BohnChen/PickOrangeDummy/docs/architecture_diagrams.md

# PickOrangeDummy · 架构图册

> 配套文档：[`architecture_v2.md`](architecture_v2.md)
> 生成：2026-10-30　｜　图源为 Mermaid，GitHub 直接渲染；`.mmd` 源文件在 [`diagrams/`](diagrams/)
>
> 阅读顺序建议：图 1（全景）→ 图 2（进程）→ 图 3（通信）→ 图 4（TF）→
> 图 5/6（任务）→ 图 7（停车）→ 图 8（安全）→ 图 9（语音）→ 图 10（几何）→ 图 11（里程碑）

---

## 图 1 · 系统分层全景

一句话：**指令向下、状态向上；只允许上层依赖下层。**

```mermaid
graph TB
    L4["L4　交互 / 监督<br/>voice_cmd · safety_supervisor · 人工确认"]
    L3["L3　任务编排<br/>mission：10 Hz tick · 转移表 · 状态守卫"]
    L2["L2　能力层（全部 Action）<br/>arm_move · cutter · chassis_creep · speak"]
    L1["L1　抽象层（设备与硬件抽象）<br/>ros2_control · chassis_node · astra_guard · target_detector"]
    L0["L0　实时层（MCU 固件，永不进 ROS）<br/>STM32H5 三路 PWM + 300 ms 租约 · STM32F405 六轴 + 硬限位"]

    L4 ==>|"指令请求"| L3
    L3 ==>|"下发 Action"| L2
    L2 ==>|"驱动"| L1
    L1 ==>|"串口 / RPC"| L0

    classDef l4 fill:#e8f0fe,stroke:#4a6fa5,stroke-width:2px
    classDef l3 fill:#e6f4ea,stroke:#4a8f5f,stroke-width:2px
    classDef l2 fill:#fef7e0,stroke:#b08a3e,stroke-width:2px
    classDef l1 fill:#f3e8fd,stroke:#7a5aa8,stroke-width:2px
    classDef l0 fill:#fce8e6,stroke:#a5524a,stroke-width:2px
    class L4 l4
    class L3 l3
    class L2 l2
    class L1 l1
    class L0 l0
```

**要点**

- 实线是**指令向下**：每一层只调用下一层的接口，不知道下下层存在。
- **状态向上走但不构成依赖**：`targets` / `hazards` / `robot_state` 从 L1 流到 L3，
  `safety_supervisor` 对 L3 有全局否决权（图 3、图 8）。
- L3 只是"决定下一步做什么"，它**不认识串口、相机、MoveIt**。
- 每次跨层都是 Action（有 goal / feedback / result / cancel / 超时），不是"发一条 topic 然后猜"。

> 各层内部构件、进程、话题、TF 关系分别见图 2、图 3、图 4。

---

## 图 2 · 运行时进程与 CPU 拓扑

一句话：**会动的各占一个进程；控制钉 A78C，视觉语音钉 A55。**

```mermaid
graph LR
    subgraph A78["CPU 0–3 · Cortex-A78C · 控制与通信"]
        RC["ros2_control_node<br/>20–50 Hz"]
        CH["chassis_node<br/>20 Hz 心跳线程"]
        SS["safety_supervisor<br/>50 Hz"]
        MI["mission<br/>10 Hz"]
    end

    subgraph A55["CPU 4–7 · Cortex-A55 · 重负载"]
        TD["target_detector<br/>15–30 Hz"]
        AG["astra_guard<br/>30 Hz"]
        VO["voice_io<br/>常开 KWS"]
    end

    subgraph MCU["MCU 侧"]
        H5["STM32H5<br/>三路 PWM + 300 ms 租约"]
        REF["STM32F405<br/>关节伺服"]
    end

    RTR["arduino-router<br/>独占 /dev/ttySTM0"]

    CH -- "msgpack-RPC" --> RTR
    RTR -- "串行" --> H5
    RC -- "USB-CDC 115200" --> REF
    MI -- "Action" --> RC
    MI -- "Action" --> CH
    TD -- "targets" --> MI
    AG -- "hazards" --> MI
    VO -- "指令" --> MI
    SS -. "取消 + 制动" .-> CH
```

**要点**

- `chassis_node` 的心跳线程**独立于 ROS 回调**，executor 卡住也能继续喂狗或主动刹车。
- `arduino-router` 是系统服务，不是我们写的节点；它独占底盘串口（见 §6.5）。
- 任一进程崩溃，其下游看门狗在 500 ms 内接管。

---

## 图 3 · 通信拓扑（话题 / 动作 / 服务）

一句话：**每个执行器只有一个写者。**

```mermaid
graph LR
    subgraph 感知
        AG["astra_guard"]
        TD["target_detector"]
    end

    subgraph 决策
        MI["mission"]
        SS["safety_supervisor"]
        VO["voice_io"]
    end

    subgraph 执行
        CH["chassis_node"]
        RC["ros2_control_node"]
        CT["cutter（硬件插件内）"]
    end

    AG -- "/perception/hazards" --> MI
    TD -- "/perception/targets" --> MI

    MI -- "/cmd_vel" --> CH
    MI -- "Action /arm/move_to_pose" --> RC
    MI -- "Action /cutter/cut" --> CT
    MI -- "Action /voice/speak" --> VO
    VO -- "Service /mission/approve_cut" --> MI
    VO -- "Service /safety/estop" --> SS

    SS -- "取消全部 goal + brake" --> CH
    SS -- "取消全部 goal + !STOP" --> RC
    MI -- "/robot_state" --> VO
    MI -- "/robot_state" --> SS
```

**要点**

- `chassis_node` 是 `/cmd_vel` 的**唯一**订阅者与底盘串口的**唯一**写者。
- `ros2_control` 是六轴的唯一写者；`/cutter/cut` 在硬件插件内部实现，**不再另开串口**。

---

## 图 4 · TF 树

一句话：**`base_link` 保持=机械臂基座（现有 MoveIt 配置零改动）。**

```mermaid
graph TD
    ODOM["odom<br/>占位：单位静态变换"]
    BF["base_footprint<br/>后轴中心地面投影"]
    CL["chassis_link<br/>车体"]
    BL["base_link<br/>机械臂基座法兰 · J1 轴线"]
    A1["astra_link<br/>立杆顶 · 离地约 310 mm"]
    A1D["astra_depth_optical_frame"]
    D1["d435i_link<br/>Astra 下方约 15 mm"]
    D1C["camera_color_<br/>optical_frame<br/>yaw ≈ +100°"]
    T["tool0 / tcp<br/>末端执行器"]

    ODOM --> BF
    BF --> CL
    BF --> BL
    BF --> A1
    BF --> D1
    A1 --> A1D
    D1 --> D1C
    BL --> T
```

**要点**

- `odom → base_footprint` 现在是假的（无编码器），但**预留了位置**：将来加编码器或 VIO，下游一行不改。
- 所有静态参数放 `pickorange_bringup/config/transforms.yaml`，**不写死在 launch 里**。
- 旧的手眼外参（`cam_x=-0.1959 …`）**整体作废**，必须重标。

---

## 图 5 · 采摘任务状态机

一句话：**10 Hz tick 驱动，状态 × 事件 → 下一状态，跳步由守卫拒绝。**

```mermaid
stateDiagram-v2
    direction LR
    [*] --> BOOT
    BOOT --> IDLE : 臂在 REST ∧ 已 enable
    IDLE --> CRUISE : mission/start
    CRUISE --> SLOW : 目标接近窗口
    CRUISE --> FAULT : hazards 建议 STOP
    SLOW --> STOP : 已停稳 500 ms
    STOP --> PICK : 臂在 REST
    PICK --> PICK : 队列非空
    PICK --> RESUME : 队列空
    RESUME --> CRUISE : 臂确认在 REST
    PICK --> FAULT : 超时 / 不可达 / 失败超限
    FAULT --> IDLE : safety/reset + enable
    ESTOP --> IDLE : reset + enable

    note right of ESTOP
        任意状态均可进入
        /safety/estop 或语音「停止」
    end note
```

**PICK 内部子状态（线性，同样显式）**

```mermaid
stateDiagram-v2
    [*] --> PRE_APPROACH
    PRE_APPROACH --> INSERT : 到达 Pre-Grasp
    INSERT --> HOLD : 套筒到位
    HOLD --> CUT : approve_cut / 语音「剪切」
    HOLD --> RETREAT : 30 s 超时
    CUT --> RETREAT : 刀片已张开且确认
    CUT --> CUT : 未切断 ∧ 重试 < 2
    RETREAT --> [*]
```

**要点**

- `HOLD` 是唯一等人工的稳定态，且**必须可超时**（30 s 无确认自动退刀）。
- `RETREAT` 的前提是 `final_angle == home`（刀片已张开），否则会扯断枝条。

---

## 图 6 · 一次连续采摘的时序

一句话：**一次停车采完队列里的所有目标，中途可被语音打断。**

```mermaid
sequenceDiagram
    autonumber
    participant O as 操作员 / 语音
    participant MI as mission
    participant CH as chassis_node
    participant AR as arm (MoveIt)
    participant CT as cutter
    participant VO as voice_io

    MI->>CH: /cmd_vel 巡航
    Note over MI: target_detector 报目标<br/>x ≈ +0.33 m（相对臂底座）
    MI->>CH: brake（发现即停）
    loop creep 逼近
        MI->>CH: Action /chassis/creep +30 mm
        CH-->>MI: traveled_m
        Note over MI: 重测 x（相对臂底座）
    end

    loop 队列中的每个目标
        MI->>AR: Action /arm/move_to_pose (Pre-Grasp)
        AR-->>MI: success
        MI->>AR: Action /arm/move_to_pose (INSERT)
        AR-->>MI: success
        MI->>VO: speak「套住完成，等待剪切指令」
        O->>MI: Service /mission/approve_cut
        MI->>CT: Action /cutter/cut(span=-60, dwell=0.5)
        CT-->>MI: feedback current_angle
        CT-->>MI: result success, final_angle=home
        MI->>AR: Action /arm/move_to_pose (RETREAT)
        AR-->>MI: success
    end

    MI->>AR: 回 REST
    MI->>CH: 解除刹车，继续巡航
```

**要点**

- 停车分两段：**发现即停**（宁可停早）+ **creep 闭环逼近**（每步 3 cm，每步重测）。
- 剪切是原子操作：合刀 → 保压 → **张刀** → 确认到位。
- 队列非空时**不回 REST**，直接从退刀位去下一个 Pre-Grasp。

---

## 图 7 · 停车逼近控制流

一句话：**停早了可以蠕进，开过了要倒车——所以策略偏向早停。**

```mermaid
graph LR
    A["DETECT<br/>D435i 首次捕获目标"] --> B["STOP<br/>0 油门 + 中位"]
    B --> C{"x 在窗口内？<br/>[-0.08, +0.08]"}
    C -- "是" --> D["稳定 500 ms<br/>→ PICK"]
    C -- "否" --> E["CREEP +30 mm<br/>油门 ≥ 最小有效值"]
    E --> F["等 300 ms · 重测"]
    F --> C
    C -- "跳变 > 100 mm" --> B
    C -- "超过 8 次仍不可达" --> G["跳过该目标<br/>黑名单 30 s"]
```

**要点**

- 每步 3 cm，**误差不会累积超过一步**，天然免疫"没有里程计"。
- 每步都用视觉重新测量 ⇒ `throttle→v` 标定不准也无所谓。
- **油门有最小值**：实测 15% 车不动、30% 才起步。所以 creep 只能"走一小段再停"，
  不能用极低油门"慢慢挪"——那会变成发着指令不走，最后超时。
- "跳过"是一等公民：卡在一个摘不到的果子上是这类系统最常见的死锁。

---

## 图 8 · 安全与心跳链

一句话：**四重冗余，任何一层崩了车都会停。**

```mermaid
graph TD
    subgraph 软件
        VO["voice_io"]
        MI["mission"]
        CT["cutter"]
        SS["safety_supervisor"]
    end
    subgraph 硬件
        CH["chassis_node"]
        H5["STM32H5<br/>租约 300 ms → 硬停"]
        LATCH["固件锁存 estop<br/>必须 arm() 才解除"]
        REF["STM32F405<br/>!STOP 保持力矩"]
        MOT["底盘电机 / 六轴电机"]
    end

    VO -- "心跳" --> SS
    MI -- "心跳" --> SS
    CT -- "心跳" --> SS
    SS -- "心跳 + 否决" --> CH
    CH -- "20 Hz drive（续租约）" --> H5
    H5 -- "3 路 PWM" --> MOT
    SS -. "estop()" .-> LATCH
    LATCH -. "拒绝一切运动指令" .-> H5
    REF -- "限位 / 失能" --> MOT
    SS -. "取消 goal" .-> REF

    SW["物理急停 / SW1<br/>（唯一对硬件故障有效）"] -. "断底盘动力" .-> MOT
    SW2["⚠ 断整车电 = 臂失力下坠"] -.-> MOT
```

**要点**

- `/safety/estop` 的语义是 **"底盘锁存停车 + 机械臂 `!STOP` 保持力矩"**，**绝不失能、绝不切电**。
- **锁存在固件里**：即使控制程序崩溃前正在 20 Hz 猛发 `drive()`，每条指令也会返回 `false`。
- **软件链只覆盖软件故障。** 档位信号浮空/越界可能让车继续前进，这只能靠物理急停。
- 物理断电仍须先把机械臂收回 REST。

---

## 图 9 · 语音指令通路

一句话：**语音只能触发"能力层已有 + 安全层放行"的动作，且移动必须是有限步进。**

```mermaid
graph LR
    MIC["USB 声卡<br/>麦克风"] --> KWS["sherpa-onnx KWS<br/>常开 · <100 ms"]
    KWS --> GATE{"指令闸门<br/>当前状态允许？"}
    GATE -- "拒绝" --> FB1["语音反馈<br/>「当前不可执行」"]
    GATE -- "剪切" --> AP["/mission/approve_cut"]
    GATE -- "进刀 / 退刀" --> ARM["/arm 笛卡尔 ±25 mm"]
    GATE -- "前进 / 后退" --> CREEP["/chassis/creep ±0.2 m<br/>有限步进 + 超时"]
    GATE -- "停止" --> ES["/safety/estop"]
    GATE -- "暂停 / 继续" --> MS["/mission/pause / resume"]

    TTS["预生成 WAV<br/>15 句固定反馈"] --> SPK["USB 声卡<br/>扬声器"]
    SPK -. "半双工：播放时停 ASR" .-> KWS
```

**要点**

- **绝不允许**"开始前进直到我说停"这种开放指令。
- 回环自激用**半双工**解决：播放期间停 ASR（丢帧而非缓存）。
- 固定反馈语全部预生成 WAV，零延迟零 CPU；TTS 模型只服务临时文本。

---

## 图 10 · 相机安装几何（俯视）

一句话：**相机在臂前方、又朝后侧方，两个偏置恰好抵消——目标最像"侧方"时正好落在臂的可达区。**

> 这张是几何图，用 ASCII 表达比 Mermaid 清楚。数值为当前推算，待 S0 实测确认。

```text
                       车头 ↑ +X
                                
        ┌───────────────────────────────────────────────┐
        │        [Astra]  ▲ 正前方（避障，只测距离）       │
        │           │                                   │
        │           │ 70 mm（立杆中心 → 臂底座中心）        │
        │           ↓                                   │
        │      ┌─────────┐                              │
        │      │ 机械臂   │  ← base_link（J1 轴心）       │
        │      │ 基座     │                              │
        │      └─────────┘                              │
        │           ·                                   │
        │           · 可采窗口                           │
        │           · x ∈ [-0.10, +0.10] m              │
        │           · y ∈ [ 0.25,  0.42] m              │
        │           ·                                   │
        │      ╲                                        │
        │       ╲ 87° 视场                              │
        │        ╲                                      │
        │         ╲        [D435i]  光轴 ≈ 100°（左偏后） │
        │          ╲         ╱                          │
        └───────────╲──────╱───────────────────────────┘
                     ╲    ╱
                      目标

  换算（已核算，详见 architecture_v2.md §3.5）：
      相机相对臂底座：(+0.070, −0.040) m
      光轴方向：(cos100°, sin100°) = (−0.174, +0.985)

      x = 0.070 − 0.174·d
      y = −0.040 + 0.985·d

      d = 0.40 m → (x, y) = (0.000, +0.354)  ✅ 窗口中心
      d = 0.60 m → (x, y) = (−0.034, +0.552)  ❌ 超臂展

  结论：目标在相对臂底座 x ≈ +0.33 m 时才首次进入视场
        （车头前方约 13 cm），到窗口只剩 33 cm 行程
        ⇒ 巡航阶段是「侧扫」不是「前视」⇒ 不能远距离预判
```

**要点**

- 这也是为什么停车必须"发现即停"，而不是"提前减速"。
- 可采窗口 = **D435i 视锥 ∩ 机械臂可达包络**，是 S1 最需要实测标定的几何量。

---

## 图 11 · 落地里程碑

一句话：**每一步都能单独验收，且都有一组明确的阻塞问题。**

```mermaid
gantt
    title PickOrangeDummy 落地计划（S0–S4）
    dateFormat  YYYY-MM-DD
    axisFormat  %m/%d

    section S0 地基
    接口包 + TF 树        :s0a, 2026-11-01, 5d
    chassis_node 接入     :s0b, after s0a, 4d
    顶层 launch + 绑核    :s0c, after s0b, 3d

    section S1 感知
    Astra 驱动 + 避障     :s1a, after s0c, 5d
    ONNX 导出 + 接入      :s1b, after s0c, 4d
    可采性 + 停车窗口标定 :s1c, after s1b, 4d

    section S2 采摘
    cutter Action 打通    :s2a, after s1c, 4d
    单目标闭环            :s2b, after s2a, 5d

    section S3 编排
    状态机 + 队列         :s3a, after s2b, 5d
    语音 KWS + TTS        :s3b, after s3a, 4d
    楼道连续采摘验收      :s3c, after s3b, 3d

    section S4 演进（可选）
    行为树 / NPU / 力感知 :s4a, after s3c, 20d
```

**验收标准**

| 阶段 | 一句话验收 |
|---|---|
| S0 | 一条命令起来，RViz 看到车+臂+两相机，`/cmd_vel` 能让车走 |
| S1 | 画面出现橘子 → RViz 出 3D 球 + 可采标记；Astra 报出正确前方距离 |
| S2 | 手动触发完成 套→等确认→切→张刀→退刀，全程无超时强杀 |
| S3 | 楼道挂 3 个橘子，一键启动连续采 3 个，语音可暂停/停止 |

> 日期是**按无阻塞问题的乐观估计**；实际以 §22 的 22 项待确认问题的答复速度为准。

---

## 图 12–13 · 现状版（2026-11-10，手写 SVG）

> 这两张**不是 Mermaid 生成的**，是手写 SVG（可直接用编辑器 / Inkscape 改字），
> 因为要同时表达"供电 + 硬件 + 软件现状"，Mermaid 排不出来。

### 图 12 · 整机架构总览

一句话：**三列（感知输入 / 计算与软件栈 / 电源与电气），五层只向下依赖，红框标出当前断点。**

- 预览：[PNG](diagrams/12-system-overview.png)　｜　源：[SVG](diagrams/12-system-overview.svg)
- 配套：`ARCHITECTURE_REVIEW_2026-11-10.md` §1

### 图 13 · 供电失效链与整改

一句话：**上面是现状，中间是四条失效链，下面是整改方案。**

- 预览：[PNG](diagrams/13-power-failure.png)　｜　源：[SVG](diagrams/13-power-failure.svg)
- 配套：`POWER_v2_SPEC.md`

---

## 图源与重新生成

每个图的 Mermaid 源在 [`diagrams/*.mmd`](diagrams/)，同名 `.svg` / `.png` 是渲染产物。
（例外：图 12/13 是手写 SVG，没有 `.mmd`，直接改 `.svg` 再导出 PNG 即可。）
本文档里的代码块与 `.mmd` 内容一致——**改图改 `.mmd`，再重新渲染**。

渲染用 gstack 的离线 mermaid 渲染器（不需要联网）：

```bash
cd ~/01_MyProject/PickOrangeDummy
STAGED=/tmp/gstack-render/$(basename ~/.config/opencode/skills/gstack/lib/diagram-render/dist/diagram-render.html)

# 单张
f=docs/diagrams/04-tf.mmd; n=$(basename $f .mmd)
SRC=$(base64 < $f | tr -d '\n')
GSTACK_CHROMIUM_NO_SANDBOX=1 bun run ~/.config/opencode/skills/gstack/bin/gstack-render.ts \
  "/tmp/gstack-render/gstack-diagram-render-$(shasum -a 256 ~/.config/opencode/skills/gstack/lib/diagram-render/dist/diagram-render.html | cut -c1-16).html" \
  --wait-selector '#done' \
  --eval "window.__renderMermaid('d', decodeURIComponent(escape(atob('$SRC')))).then(s => (window.__svg = s))" \
  --out docs/diagrams/$n.svg \
  --eval "window.__rasterize(window.__svg, 1950)" --out docs/diagrams/$n.png
```

**Mermaid 排版注意**（踩过的坑）：

- 子图之间**有连线时**，`direction LR` 会被忽略，节点会竖着堆成一列。跨子图的图要用
  张量级（subgraph 到 subgraph）的边，或者干脆不分层用单列。
- 如果不想装渲染器，GitHub 会直接渲染本文档里的 ` ```mermaid ` 代码块，效果一致。
