BohnChen/PickOrangeDummy/docs/POWER_v2_SPEC.md

# 供电 v2 规格（草案，2026-11-10）

> 状态：**草案，待你确认选型后执行**。本文不修改任何现有接线与代码，只定义"换成什么样"。
> 目标：让**任何一条失效链单独发生都烧不了板**，而不是去追查唯一凶手。
> 相关：[架构复盘](ARCHITECTURE_REVIEW_2026-11-10.md) · [图 2 失效链](diagrams/13-power-failure.svg) · [v1.2 接线图](power_wiring.svg)

---

## 0. 结论先行

1. **计算板不再吃 21 V**。改成 **Buck 21→12 V / 5 A** 独立供电。官方推荐 12 V/5 A，
   12 V 距 24 V 上限有 12 V 余量，且实测 12 V 下最重负载峰值只有 33 W。
2. **机械臂保持 21 V 直供**，但拆成**独立支路**（自己的保险 + 自己的船型开关）。
   REF 规格 12–24 V、自带 SMBJ28CA 与反接保护，不需要再加 Buck。
3. **连接器全部换锁扣（XT30/XT60），5521 只做"一次性插好"**。
   从今天起，**通电拔插 DC = 违规操作**，写进 SOP 和事故文档。

> 重要更正：上一版复盘里我写"板端无 TVS / 无软启动"，**这句是错的**。
> 查了 Arduino 官方电源规格后确认：VENTUNO Q 的两个 DC 输入都有 **SMBJ24CA 双向 TVS**、
> 反接/反流功率开关、输入电流监测（INA232）和 buck 软启动。板子不是"裸奔"。
> 真正的缺口是**热插拔路径**和**21 V 只剩 3 V 的 TVS 余量**，见 §1。

---

## 1. 板子到底怕什么（官方规格）

来源：[VENTUNO Q Power Specifications](https://docs.arduino.cc/tutorials/ventuno-q/power-specifications/)、
[User Manual ABX00181](https://www.farnell.com/datasheets/4794610.pdf)、
[Setting up the VENTUNO Q](https://docs.arduino.cc/tutorials/ventuno-q/first-setup/)。

| 输入源 | 电压 | 最大电流 | 备注 |
|---|---|---|---|
| USB-C PD | 9–20 V | 3 A | 必须 PD 协商 >5 V，普通 5 V USB 不供电 |
| DC 5521（barrel jack） | 7–24 V | **5 A** | 你现在用的是这条 |
| 螺丝端子 | 7–24 V | **10 A** | 更稳的输入路径，优先考虑 |

**板载已经有的保护**（这是修正后的认知）：

```
5521 / 螺丝端子 → 肖特基合并 → SMBJ24CA 双向 TVS → 电源 OR 开关
（KTS1900 + SQS414，带反接与反流保护）→ INA232 电流监测 → MPQ4371 buck（带软启动）
```

所以：**过压、反接、反流、启动浪涌，板子自己都管**。那为什么还会烧？

| 官方没管、也没法管的 | 后果 |
|---|---|
| **带载插拔 DC 源** | 官方原文：*"Avoid connecting or disconnecting DC sources while the board is under heavy load. Rapid source switching during the power-OR transition can cause brief undervoltage events that may reset the SoM."* —— 轻则复位，重则瞬态击穿 |
| **回流走信号地** | DC 插头拔出的瞬间，如果底盘 PWM 地 / USB 地还连着，电流会从信号引脚回流。**这条路径在输入 TVS 的保护范围之外** |
| **21 V 贴着 TVS 站压** | SMBJ24CA 站压 24 V，21 V 工作只剩 3 V 余量；插拔振铃峰值更容易越过钳位点 |
| **5521 只有 5 A** | 两负载同轨时，浪涌全部从同一个插头过 |

**结论**：板子的保护是"输入级的最后一道防线"，不是"热插拔保护"。
v2 要做的不是给它加 TVS（它已经有了），而是**把热插拔这个动作从系统里删掉**。

---

## 2. 功率预算（按官方实测 + 你的历史值）

| 负载 | 电压 | 平均 | 峰值 | 依据 |
|---|---|---|---|---|
| VENTUNO Q 整板 | 12 V | 14 W | **33 W** | 官方 12 V 实测（Smart Mirror 场景，含 USB 相机 + 音频 + HDMI） |
| D435i + Astra + 声卡 | 板载 5 V/USB | 4 W | 8 W | 两路相机 + 音频，含在板子的 17 W USB 预算内 |
| 机械臂 REF | 21 V | ~25 W | ~72 W | 历史 12 V/6 A 电源长期验证，按同功率折算 |
| **合计** | — | **~45 W** | **~110 W** | 21 V 母线峰值约 **5.3 A** |

- 电池：15 Ah × 21 V ≈ 315 Wh，按 80% 可用 ≈ **250 Wh**；45 W 平均 → **约 5 h**。
- 总保险 10 A 足够（峰值 5.3 A，留 1.9 倍）。
- 12 V 支路选 **5 A 模块**（33 W → 2.75 A，1.8 倍余量）。

---

## 3. v2 电源树

```
牧田 5S 15 Ah（21.0 V 满 / 15.0 V 截止 / BMS ≈13 V 硬切）
 └ XT60 锁扣（★ 系统里唯一的拔插点）
   └ F1 10 A 总保险
     └ SW1 20 A 总开关（只切正极）
       └ D+ 星形母线（16 AWG）
          │
          ├─ F2 5 A ── SW2 10 A ──→ 机械臂 REF VIN（21 V 直供）
          │                          REF 自带 SMBJ28CA + 反接保护
          │                          独立开关：可以只断臂，不必整车断电
          │
          ├─ F3 3 A ── Buck 21→12 V / 5 A ──→ VENTUNO Q
          │              ├ 470 µF/25 V + 100 nF（靠近输入）
          │              ├ TVS SMBJ15A（12 V 侧，最后一道）
          │              └ 螺丝端子（10 A）或一次性插好的 5521
          │
          └─ 100 kΩ / 10 kΩ 分压 ──→ STM32H5 ADC（15.5 V 预警）

D− 星形：臂负极、Buck 负极各走一根，**只在电池负极一点汇合**，不串联、不借用信号地
```

三条规矩：

1. **臂和板子不同轨**：臂的电流只在 F2/SW2 这一支上跑，不再从板的插头过。
2. **板子只吃稳压后的 12 V**：Buck 输入 15–21 V 时输出稳定 12 V；电池跌到 13 V 时
   Buck 退出稳压（输出跟随输入），此时板子看到 12–13 V，仍在 7–24 V 内，但 SoM 可能不稳 →
   所以 **15.5 V 预警是硬要求，不是可选项**。
3. **所有拔插都在 XT60/XT30 上做，且必须断电**。

---

## 4. BOM（约 ¥110–140）

| # | 物料 | 规格 | 数量 | 参考价 | 备注 |
|---|---|---|---|---|---|
| 1 | 同步降压模块 | 输入 9–36 V，输出 12 V/5 A，带 OCP/OVP/软启动 | 1 | ¥25–40 | 别用 LM2596（3 A） |
| 2 | 插片保险座 + 插片 | 中号，10 A / 5 A / 3 A | 1 套 | ¥10 | 三个值各 2 片 |
| 3 | 船型开关 | 20 A（总）、10 A（臂） | 2 | ¥10 | 只切正极 |
| 4 | XT30 公母 | 锁扣，持续 15 A | 4 对 | ¥20 | 板端、Buck 端各一对 |
| 5 | 电解电容 | 470 µF/25 V + 100 nF | 2 组 | ¥5 | 靠近板输入 |
| 6 | TVS | SMBJ15A（12 V 侧）、SMBJ24A（21 V 侧备用） | 各 2 | ¥6 | 板载已有 SMBJ24CA |
| 7 | 分压电阻 | 100 kΩ / 10 kΩ 1% + 0.1 µF | 1 组 | ¥2 | 接 H5 ADC |
| 8 | 硅胶线 | 16 AWG 红/黑 | 2 m | ¥10 | 主电流路径 |
| 9 | 冷压端子 + 热缩管 | — | 1 套 | ¥10 | 螺丝端子用 |
| 10 | 直流电压表头（可选） | 0–100 V 双显 | 1 | ¥15 | 替代/补充 AL1 |

> 机械臂支路**不需要** Buck；REF 自带 SMBJ28CA 与反接保护，21 V 在其 12–24 V 规格内。

---

## 5. 布线要点

- **线径**：21 V 主干 16 AWG（峰值 5.3 A，压降 <0.2 V）；12 V 支路 18 AWG 足够。
- **星形接地**：电池负极 → 一个端子排 → 臂、Buck 各一根。**不要**把臂的负极接到 Buck 的负极再回电池。
- **远离**：12 V 信号线与电机线分开走，交叉时成 90°。
- **固定**：5521 若保留，插好后用扎带 + 热熔胶做应力释放，标注"禁止拔插"。
- **散热**：Buck 满载会烫，别封在盒子里；留 10 mm 以上空间。

---

## 6. SOP（贴到车上）

### 上电

1. 检查所有 XT30/XT60 已锁紧，5521/螺丝端子无松动。
2. 合 **SW1** → 板子启动（风扇转、绿灯亮，约 60–90 s）。
3. `ssh` 能登录、`ros2 topic list` 正常。
4. 合 **SW2**（臂）→ 发 `!START` → `!HOME` → 使能。
5. 确认刀片全开、J6 零点已测，再开始动作。

### 断电

1. `./scripts/safe_park_and_exit.sh`（回 REST、确认到位）。
2. `!DISABLE`（失能）。
3. 断 **SW2**（臂）。
4. `sudo shutdown -h now`，等风扇停。
5. 断 **SW1**。

### 三条禁令

- ❌ **禁止通电拔插任何 DC 接口**（这是这次烧板的直接动作）。
- ❌ **禁止在 PICK 伸出姿态下断电**（臂会自由落体）。
- ❌ **禁止用 5521 当日常拔插点**（改在 XT60/XT30 上做，且必须断电）。

---

## 7. 验收测试（换新板之前必须全部通过）

| # | 测什么 | 怎么测 | 通过标准 |
|---|---|---|---|
| 1 | 12 V 空载精度 | 万用表 | 12.0 ± 0.2 V |
| 2 | 12 V 带载 | 假负载（灯泡/电阻）3 A，10 min | 电压跌落 <0.3 V，模块温升 <40 K |
| 3 | 纹波 | 示波器，20 MHz 带宽限制，10× 探头 | <100 mVpp |
| 4 | 臂启停扰动 | 示波器同时看 12 V 轨与 21 V 母线 | 12 V 波动 <0.3 V；21 V 尖峰 <35 V |
| 5 | 上电浪涌 | 电流探头或看保险 | 不烧保险；无打火 |
| 6 | 断电重上电 | 断 SW1 → 等 10 s → 上电，重复 10 次 | 每次正常启动，无异常复位 |
| 7 | 接地 | 万用表测臂负极—板负极—电池负极 | 三点之间 <0.1 Ω |

> 第 4 项是关键：**换新板之前先测旧板烧掉时的那个尖峰到底多大**，才知道 12 V 方案够不够。

---

## 8. 软件侧配套（不用改架构，加两行）

- **板子自身功耗可读**：官方给出 INA232 的 `hwmon` 路径，
  `in1_input`（mV）、`power1_input`（µW）。建议启动时找一次，作为 `/diagnostics` 的电源项。
- **电池电压**：分压进 STM32H5 ADC，15.5 V 触发"主动停车 + 语音告警"，
  抢在 BMS 13 V 硬切断之前。这条在 `architecture_v2.md` §3.8 早就写了，一直没落地。
- **不要**把 12 V 当成"电池电压"：Buck 输出恒 12 V，软件看到的板输入电压反映不了电量。

---

## 9. 与 v1.2 的差异

| 项 | v1.2（现状） | v2 |
|---|---|---|
| 计算板供电 | 21 V 直供 5521 | Buck 21→12 V/5 A，螺丝端子或永久 5521 |
| 机械臂供电 | 与板同轨 | 独立 F2 + SW2，21 V 直供 |
| 总保险 | F1 10 A | 保留 |
| 分支保险 | 无 | F2 5 A、F3 3 A |
| 连接器 | 两个 5521 | XT60/XT30 锁扣；5521 只做一次性插好 |
| 电压监测 | AL1 蜂鸣 | 分压进 H5 ADC + 软件告警 |
| 热插拔 | 允许（就是这次烧板的原因） | **明令禁止**，写进 SOP |

---

## 10. 待你确认

1. 板子上**螺丝端子**是否已焊接/可用？可用就优先用它，比 5521 稳得多。
2. 是否接受**机械臂保持 21 V**（而不是也降到 12 V）？好处是省一个 10 A Buck、保留提剪切速度的余量。
3. Buck 模块你想买成品模块还是画板？（成品模块 5 分钟能上，画板要 2 周）
4. 手头有没有示波器/电流探头？没有的话第 4 项验收要借或换方案。
