BohnChen/PickOrangeDummy/docs/M2_spec_j6_blade_home.md

# DummyArm M2 · J6 旋切轴刀片零位与剪切行程规格（v1.0）

> 状态：**已批准**（2026-10-24）｜主人：陈泌丞（BohnChen）
> 关联：`docs/M0_spec.md`（关节真值）、`docs/HANDOFF_交接文档.md` §2/§3/§4、
> `docs/architecture.md` §7（J6 双角色）、`docs/safety_and_incidents.md` §3（硬性约束）
> 本规格是 J6 零位语义与剪切行程的唯一依据；与旧文档冲突处，以本文为准。

---

## 1. 背景与动机

刀片已装到 J6 上，J6 从「可自由多圈旋转的腕轴」变成「不可随意转动的工艺轴」。

- 物理现状（2026-10-24 实测）：刀片处于**最大打开**姿态，作为剪切起始位。
- 目标语义：**此刻位置 = J6 的 0°**；`0° = 剪切起始（刀片全开）`，`-60° = 剪切末尾（刀片合拢）`；
  剪切完成后回到 `0°`。
- 现存隐患：驱动层 `dummyarm_hardware.cpp:303-306` 把 J6 恒锁到 `cutter_target_pos_`，
  该变量**无任何赋值点，恒为 `0.0 rad`**；而当前固件 J6 实测 `-215.87°`。
  于是 **任何一次 MoveIt 轨迹 / `!HOME` / `!RESET` / `safe_park_and_exit.sh`
  都会让 J6 空转 215.87°** —— 装刀后必须立即消除的隐患。

零位是该隐患的正解：零位后固件 0° == 刀片起始位，驱动层锁定、`!HOME`、`!RESET`
与人工操作语义全部自洽，刀片静止。

## 2. 目标与非目标

### 2.1 目标（本次交付）
1. J6 **永久零位**（写电机 EEPROM，掉电不丢）：任何上电使能后 `#GETJPOS` 的 J6 ≈ 0。
2. 剪切行程**只在剪切层**限制为 `[-60°, 0°]`；URDF / IK / MoveIt 侧保持 `±720°` 多圈能力。
3. 剪切工具闭环可控：`合刀(-60°)` → 到位校验 → `回位(0°)`，不再用固定 `sleep`。
4. 提供轻量 Jog 窗口：J1–J5 可拖动实时跟随，**J6 锁定不可拖**，仅「合刀 / 回位」两个按钮。
5. 文档与 git 完整记录，代码 / 文档 / 提交三者一致。

### 2.2 非目标
- 不改固件源码、不改机械结构、不重新做全轴标定。
- **不缩小** `URDF Joint6` 限位（笛卡尔 IK 需要多圈解空间）。
- 不做 ROS 侧剪切服务/接口（列为遗留技术债，见 §10）。
- 不做移动底盘、视觉、任务层改动。

## 3. 现状事实（代码/实测证据）

| # | 事实 | 证据 |
|---|---|---|
| F1 | J6 固件/软件限位为 **±720°（多圈）** | `M0_spec.md` §2；`dummyarm_link.JOINT_LIMITS[6]` |
| F2 | 轨迹运动期间 J6 被驱动层**硬隔离**，恒发 `cutter_target_pos_` | `dummyarm_hardware.cpp:303-306` |
| F3 | `cutter_target_pos_` 默认 `0.0` rad，全仓库无任何赋值点 | `dummyarm_hardware.hpp:139` + grep |
| F4 | `!HOME (0,0,90,0,0,0)`、`!RESET (0,-75,180,0,0,0)` 的 J6 分量均为 **0** | `dummy_robot.cpp: Homing()/Resting()` |
| F5 | 控制环 200 Hz（`Timer timerCtrlLoop(&htim7, 200)`） | `UserApp/main.cpp:9` |
| F6 | 电机位置目标是**绝对位置**：`goalPosition = _pos + encoderHomeOffset` | `dummy-42motor-fw/Ctrl/Motor/motor.cpp:430` |
| F7 | `#OFFSET_J <n>` → CAN 0x15 → `ApplyPosAsHomeOffset()` + **EEPROM 落盘** | `motor.cpp:615`、`interface_can.cpp:139`、`main.cpp CONFIG_COMMIT` |
| F8 | `#OFFSET_J` 仅存在于较新固件（fw20260119/20260222）；原版 Dummy-Robot 固件无此命令 | 三份 `ascii_protocol.cpp` 对比 |
| F9 | `MoveJ` 在 `maxAngle == 0` 时 `time = 0`，`dynamicJointSpeeds = delta/time = 0/0 = NaN`，无保护 | `dummy_robot.cpp:87-95` |
| F10 | 控制器 J6 目标容差被放宽至 `6.28 rad`（掩盖「J6 被锁」的补丁） | `ros2_controllers.yaml` |
| F11 | 刀片已装；当前 J6 实测 `-215.87°`，为刀片最大打开位 | 2026-10-24 实测 |
| F12 | 本机对 `#OFFSET_J 99` 回通用 `ok`（而非 `error HOMEOFFSET...`），对未知命令 `#FOOBAR 1` 无回执 → 命令分支可能被通用兜底吞掉，**支持性只能由实测零位结果判定** | 2026-10-24 实测 |
| F13 | **J6 多圈位置不跨上电保存**：电机固件上电首次闭环用 `rectifiedAngle` 重建 `realLapPosition`，`encoderHomeOffset` 只存单圈偏移。J6 减速比 50:1 → 上电后读数只能在 ±3.6° 内，与物理位置无关。实测：断电前 `-20.00°` → 上电后 `+2.99°` | `dummy-42motor-fw/Ctrl/Motor/motor.cpp` `isFirstCalled` 分支；2026-10-24 实测 |
| F14 | **顶限位/堵转会让 J6 驱动器复位**，多圈再次丢失：实测顶到 +27.40° 后读数跳回 +1.23°，期间连续 5 次读不到角度 | 2026-10-24 实测 |

## 4. 设计

### 4.1 J6 永久零位

**支持性探测（无副作用）**
```
发送  #OFFSET_J 99
期望  "error HOMEOFFSET MOTOR [99] is wrong"     → 命令存在
超时无回复                                        → 命令不存在，立即中止，不改任何状态
```
> 依据：`ascii_protocol.cpp` 中 `node` 仅在 `1..7` 时才真正下发 CAN，越界只回 error，不写 EEPROM。
> 本机实测（F12）回的是通用 `ok`，因此探测**只能排除"完全无回执"**的情况；
> 是否真正生效由零位后的读数判定（§4.1 第 4 步）。

**零位时序**
```
0) 前置：机械臂静止、刀片无人接触、ROS 侧全部停止（串口独占）
1) !START                                    → 期望 "Started ok"
2) #GETJPOS                                  → 记录 (j1..j5, j6_old)
3) 一次 write 内连发（避免控制环插入陈旧目标）：
       #OFFSET_J 6
       >j1,j2,j3,j4,j5,<ε>,1
   ε = 0.05°，方向 = 合刀方向（由 §4.2 确认结果决定符号）
   目的 A：零位后 REF 的 targetJoints 立刻对齐新坐标，杜绝「补转 215°」
   目的 B：目标与实测不相等，规避 F9 的 0/0 = NaN
   目的 C：ε 取合刀侧，避免顶到「最大打开」方向的机械限位
4) #GETJPOS（连续 3 次）                     → 期望 J6 ∈ [-0.5, +0.5]，且稳定
5) 失败处置：
   - 位移 ≤5°：判定命令未生效（固件静默忽略），仅报告，不改其他状态；
   - 位移 >5°：立即 !STOP 并人工介入。
```
**为什么必须同包连发**：控制环 200 Hz（F5），若两命令分两次 write，中间可能插入一次
「陈旧 targetJoints = j6_old」的下发；电机按绝对目标（F6）执行会补转 `|j6_old|`。

**成功判据**：J6 读数稳定在 0±0.5°；J1–J5 变化 ≤0.1°。
实现容差放宽到 1.5°：ε 目标与 `#OFFSET_J` 在 CAN 上可能竞争，ε 偶尔会作用在
新坐标系的反侧；只要读数落回 0 附近即视为零位成功。

**持久化确认（必须做）**：断电 → 重新上电 → `!START` → `#GETJPOS`。
- 若 J6 仍 ≈ 0（本次实测约 -0.3°~0.0°）→ EEPROM 已保存；
- 若 J6 回到 ≈ 当前值 − 原读数（本次约 -1.4°）→ 偏移未保存，需改用软件偏移兜底。

> **2026-10-24 实测结论（重要）**：本机固件 `#OFFSET_J` **不生效**。
> 第二次在 J6=49.74° 尝试归零时，设备只是朝 `-0.2°` 目标走了 6.70° 就被保护中止，
> 读数并未归零 —— 证明该命令被静默忽略（通用 `ok` 即兜底）。
> 早期 A2/A3 判定的"通过"是误判：读数变化其实只是"被驱到目标值"，
> 而 `!START` 之后的读数又恰好等于固件默认 `REST_POSE`（驱动使能需要 1~3 s 才刷新反馈）。
> **正式方案改为 §4.5 软件零点。**

### 4.2 剪切行程与方向确认

- 方向确认（一次性）：从零点执行 `-3°`，人眼确认刀片是**合拢**方向。
  - 若 `-3°` 合拢 → 约定成立：`-60°` = 合刀到底，`0°` = 全开。
  - 若相反 → 全项目符号取反（`+60°` 为合刀），并在本节记录确认日期与结论。
  - **2026-10-24 实测确认**：从 0° 下发 `-3.00°`，J6 实际走到 `-3.00°`（未被全开限位挡住），
    说明负方向即合刀方向；随后回位到 `0.00°`。约定成立：`-60°` = 合刀到底。
- 剪切动作（闭环）：
```
合刀  >j1..j5, home-60, speed  → 轮询 #GETJPOS 至 |Δ|≤0.2° 或超时 15 s
回位  >j1..j5, home,    speed  → 轮询到位
```
- 行程约束只在剪切层生效：`CUT_RANGE = (home-60, home)`；
  `dummyarm_link.JOINT_LIMITS[6]` **保持 ±720** 不变。
- 剪切期间**禁止**任何 ROS 轨迹：驱动层会把 J6 覆盖回 `cutter_target_pos_`（F2）。
  工具启动前检查无 active 轨迹 / 无 controller 正在执行，否则拒绝。

### 4.3 Jog 窗口（轻量版）

- 技术形态：单文件 `scripts/jog_gui.py`，tkinter，直连 REF 串口（不依赖 ROS 在线）。
- 布局：
  - J1–J5：滑条（范围取自 `JOINT_LIMITS`），拖动实时跟随；50 Hz 读、20 Hz 下发、限速 25 °/s。
  - J6：滑条**禁用**；显示「相对角 = 实测 − home」，配 `合刀(-60°)` / `回位(0°)` 按钮。
  - 顶部：`使能` `失能` `回 HOME (0,0,90,0,0,0)` `急停（空格）`。
  - 状态栏：串口、循环频率、J6 相对角、最近一次回执。
- 必守规则：
  1. **静止检测**：某周期目标与实测差 < 0.02° 则不发（同时规避 F9 的 NaN）。
  2. 下发前按 `JOINT_LIMITS` 夹紧；J6 目标强制夹在 `CUT_RANGE`。
  3. 串口被 ROS 占用 → 明确报错退出，不做静默重试。
  4. 关窗：保持当前姿态悬停（保持使能），不自动失能、不自动回位。
  5. `!STOP` 仅由急停按钮/空格触发，绝不隐式发送。
  6. 窗口启动**不自动使能**（遵守 `architecture.md` §8「上电不自动使能、不自动运动」），
     必须在界面点「使能」；使能瞬间把目标对齐实测，不产生突跳。
  7. 读数必须严格匹配 `ok x x x x x x` 七字段行，超时重试；**禁止用陈旧读数初始化目标**
     （v2 修复：首轮真机测试中出现过读数假死 + 使能瞬间用旧值下发，导致 J5 被带偏）。
  8. **堵转保护**：J6 目标与实测差 > 0.5° 且 1.5 s 内位移 < 0.15° → 判定卡滞，
     立即停止下发并把目标回持当前值，提示断电检查（2026-10-24 因螺丝过紧实测触发）。

### 4.5 会话零点（正式方案，替代固件 EEPROM 与顶限位整定）

**核心事实（F13/F14）**：J6 多圈位置不跨上电保存，且**不能靠顶限位重新建立参考**
（堵转电流会让驱动器复位，位置再丢一次）。

**因此规定：**
1. **上电前必须把刀片摆到全开（剪切起始）位**；这是唯一可靠的物理参考。
2. 上电使能后，等待读数稳定（1~3 s），把此时的 J6 读数作为**本次会话的 home**。
3. 剪切区间 = `[home - cut_span, home]`，仅在本会话内有效。
4. **绝不主动顶限位**（不得用堵转方式找零点）。
5. 若中途读数出现 >5° 跳变（驱动器复位），立即停止并重新上电、重新摆位。

- 配置文件：`config/j6_blade.json`（记录最近一次的 home 与行程，供 `cut.py` 启动参考）
  ```json
  { "j6_home_deg": -0.02, "cut_span_deg": 60.0, "measured_at": "2026-10-24" }
  ```
  `j6_home_deg` = 刀片**全开（剪切起始）**时的 `#GETJPOS` J6 读数。
- 剪切区间 = `[j6_home_deg - cut_span_deg, j6_home_deg]`，`cut.py` / `jog_gui.py` 均从此文件读取。
- 重新测量的时机（**必须**）：每次上电、重新装配刀片、松/紧联轴器、更换刀片、发生打滑之后。
  流程：刀片摆到全开 → 上电 → `python3 scripts/zero_j6.py --measure` → 核对打印出的区间。
  （`scripts/j6_homing.py` 的顶限位整定已停用，仅留作诊断，见 F14。）
- 与固件 `!HOME` / `!RESET` 的关系：这两条命令的 J6 分量恒为 `0`。
  当 `j6_home_deg` 与 0 相差很大时，它们会让 J6 转动该差值；因此
  **优先使用 GUI 的「回 HOME / 回 REST」**（会显式带上 J6 目标），固件 `!HOME`/`!RESET` 仅在
  `|j6_home_deg| < 2°` 时可直接使用。
- 优点：不依赖固件、可随时重测、可回滚（改文件即可）；缺点：需要人工保证装配后重测。

### 4.4 安全联锁

| 场景 | 行为 |
|---|---|
| 零位失败 / 读数未归零 | 位移 ≤5° 仅报告（判定命令未生效）；位移 >5° 立即 `!STOP` |
| 剪切超时未到位 | 停发指令 + 报警，保持当前位置 |
| J6 相对角越出 `[-60, 0]` | 拒绝下发，报错 |
| 任一关节超固件区间 | 拒绝下发，打印实测与允许区间（沿用「夹紧 + 提示」策略） |
| 串口连续无回复 > 1 s | 停止下发并提示链路异常 |

## 5. 变更清单

| 文件 | 改动 | 影响 IK？ |
|---|---|---|
| `docs/M2_spec_j6_blade_home.md` | 本规格（新增） | — |
| `scripts/zero_j6.py` | 测量并写软件零点配置；EEPROM 方案标记废弃 | 否 |
| `config/j6_blade.json` | **新增**：`j6_home_deg` / `cut_span_deg` 软件零点配置 | 否 |
| `scripts/cut.py` | 360° 定时 → `-60°/+60°` 闭环；加占用检查 | 否 |
| `scripts/jog_gui.py` | 新增：J1–J5 拖动 + J6 两按钮 | 否 |
| `scripts/j6_spin.py` | 装刀后退役：加硬开关或删除 | 否 |
| `src/dummyarm_hardware/...` | 新增 `j6_cut_min_deg/max_deg`，clamp `cutter_target_pos_` | 否（不动 URDF） |
| `dummyarm_link/link.py` | 新增 `CUT_RANGE`；`JOINT_LIMITS[6]` 保持 ±720 | 否 |
| `src/dummyarm_cad_description/urdf/*.xacro` | **不改**（±720 保留） | — |
| `docs/M0_spec.md` | J6 行补「零位语义：0°=全开，-60°=合刀」 | — |
| `docs/HANDOFF_交接文档.md` | §2 映射表 J6 注记、§3 命令速查、§4 新避坑条目 | — |
| `docs/architecture.md` | §11 追加 D7：J6 零位与剪切层限位 | — |

## 6. 风险与对策

| 级别 | 风险 | 对策 |
|---|---|---|
| P0 | 零位后 REF 用陈旧 targetJoints 下发，补转 | §4.1 同包连发 + speed=1 + 立即校验 |
| P0 | `MoveJ` 零位移 → `0/0 = NaN` 速度限幅 | 所有下发做「静止检测」；零位用 ε=0.05° |
| P0 | 装刀后 J6 空转 215.87°（F2/F3/F4） | 零位为最高优先级；零位前禁止任何 ROS 运动与 HOME/RESET |
| P0 | 剪切与 ROS 轨迹并发，J6 被覆盖 | 工具启动前检查；文档明确互斥 |
| P1 | 固件不支持 `#OFFSET_J` | §4.1 安全探测；兜底：软件偏移 + 禁用固件 HOME |
| P1 | `!CALIBRATION` 重置全轴零位 | 文档明确：重标定后必须重做 J6 零位 |
| P1 | 剪切方向符号判断错误 | §4.2 先做 -3° 目测确认 |
| P0 | J6 机械阻力过大（螺丝过紧/刀刃干涉）导致堵转、电机嗡嗡响、停在半途 | 新增堵转保护（1.5 s 无位移即停发）；现场规范：装刀后先手动确认刀片可自由开合再做电动剪切 |
| P2 | EEPROM 写入期间掉电 | 静止、供电稳定时执行；失败可重做 |
| P2 | 旧 bag/标定数据 J6 偏移 -215.87° | 文档记录偏移量，回放时按需补偿 |

## 7. 验收标准

- [x] A1 `#OFFSET_J 99` 探测有回执（本机为通用 `ok`，见 F12；有效性由 A2 判定）
- [~] A2 ~~零位后 J6 ∈ [-0.5,0.5]~~ **作废：EEPROM 方案在本机无效（§4.1 结论），改为 A2'**
- [~] A3 ~~断电重启后 J6 仍 ≈0~~ **作废：早期判定被默认 REST_POSE 误导，改为 A3'**
- [x] A2' 软件零点已建立：`config/j6_blade.json` 写入 `j6_home_deg = -0.02°`，剪切区间 `[-60.02, -0.02]`
- [ ] A3' 重新测量流程可复现：刀片全开 → `--measure` → 两次读数一致（≤0.1°）
- [x] A4 `-3°` 方向确认：负向为合刀（2026-10-24 实测走到 -3.00°，未被全开限位阻挡）
- [ ] A5 `合刀` 到位 `-60°±0.2°`，`回位` 回到 `0°±0.2°`，各 ≤15 s
- [ ] A6 `!HOME` 后 J6 保持 0（刀片不转），J1–J5 到达 (0,0,90,0,0)
- [ ] A7 Jog 窗口：J1–J5 ±5° 拖动跟随、限速生效、松手收敛；J6 拖不动
- [x] A8 串口被 ROS 占用时 GUI 明确报错退出；`cut.py` 同样拒绝执行（实测 exit=2，提示先停 ROS 栈）
- [ ] A9 文档三方一致：本规格、HANDOFF、M0 的 J6 语义表述相同

## 8. 回滚方案

1. 把刀片摆回旧参考位（或任意已知参考位），执行一次 `#OFFSET_J 6` 重新定义零点；
2. 若固件不支持该命令：退回**软件偏移**（`cutter_target_pos_ = 实测 home`，
   同时禁用固件 `!HOME`，改由 ROS 侧回 HOME）；
3. 所有改动在 git 分支 `feat/j6-blade-home`，回滚 = `git revert`。

## 9. Git 与文档同步纪律

- 分支：`feat/j6-blade-home`
- 提交序列（每步可独立回滚）：
  1. `docs(spec): 新增 M2 J6 刀片零位与剪切行程规格`
  2. `feat(j6): 新增零位工具并改剪切为 -60°/+60° 闭环`
  3. `feat(jog): 新增 J1-J5 拖动窗口，J6 锁定仅保留合刀/回位`
  4. `docs: 回写 HANDOFF/M0/architecture 的 J6 零位语义与避坑条目`
- **纪律**：任何改变固化行为（限位、零位、协议、验收值）的提交，必须在**同一次提交**内
  同步更新对应文档；验收记录（角度、耗时、异常）追加到 HANDOFF。
- 收尾：验收全通过后合并 `master`，可选 tag `v0.4.0-j6-blade-home`。

## 10. 遗留技术债

1. 驱动层只有「锁 J6 = 常量」，没有正式剪切接口 → 后续改为 ROS 服务/参数设置 `cutter_target_pos_`。
2. `cut.py` 直连串口，与 ros2_control 共用同一 tty → 后续并入 ros2_control 通道。
3. 控制器 `Joint6 goal = 6.28 rad` 是掩盖锁轴的补丁 → 零位稳定后可收紧至 0.10 rad。
4. `instant_tap.py` 的 J6 搜索边界仍为 ±12.56 rad → 收敛到 0 附近，避免 IK 给出绕圈解。

## 11. 变更记录

| 日期 | 版本 | 变更 |
|---|---|---|
| 2026-10-24 | v1.0 | 初版：确认刀片零位 = 当前最大打开位；剪切层限位 `[-60,0]`；URDF 保持 ±720 |
| 2026-10-24 | v1.1 | 零位已执行：J6 -1.22° → -0.20°；-3° 方向确认负向为合刀；A1/A2/A4 通过，A3 待断电复测 |
| 2026-10-24 | v1.2 | 断电重启复测通过（J6 -0.07° → 使能后 0.00°），A3 通过；零位已持久化到电机 EEPROM |
| 2026-10-24 | v1.3 | Jog v2：修复读数假死与使能瞬间目标错位；新增「回 REST」与「目标=实测」；待真机复测 A5–A7 |
| 2026-10-24 | v1.4 | 新增 J6 堵转保护（1.5 s 无位移即停发）；串口 drain 有界化（修复设备异常灌数据导致工作线程卡死）；首次合刀实测因螺丝过紧在 -48.61° 堵转 |
| 2026-10-24 | v1.6 | **重大更正**：J6 多圈位置不跨上电（F13），顶限位会让驱动器复位（F14）。改为"上电前刀片摆全开 + 启动读数作会话 home"，禁止顶限位整定；`cut.py --home` 默认关闭 |
| 2026-10-24 | v1.5 | **改正**：`#OFFSET_J` 在本机无效，A2/A3 早期判定作废；改软件零点 `config/j6_blade.json`（home=-0.02°）；补 §4.5 与 A2'/A3'；警示 `!HOME/!RESET` 与 J6 零位的关系 |
