BohnChen/PickOrangeDummy/docs/M0_spec.md

# DummyArm M0 · 规格冻结文档（成稿 v1.0, 2026-09-09）

> 目标：把本会话所有「实测/图纸/固件」真值收敛成正式规格，作为 URDF/ros2_control/
> 文档/面试展示的统一依据。凡与旧资料冲突处，以本文为准。

## 1. 机械臂本体

- 构型：Dummy-Robot V2 国产化复刻（auk/晓文链，CNC 铝件「视频款/改版」结构件）
- 自由度：6（全旋转）
- 主控：STM32F405 REF 板（USB-CDC `/dev/ttyACM1` @115200，ASCII 协议）
- 末端：空谐波减速器壳（无夹爪）；J6 将驱动自研「套果-旋切」末端执行器
- 用户实测：J1 底座开孔高 92.6mm（= 图纸 55 基座 + 37.5 J1件）

## 2. 关节真值表（物理限位 = 系统执行限位）

| 关节 | 减速比 | 模型轴(本链) | 限位(° 绝对/模型) | 备注 |
|---|---|---|---|---|
| J1 | 30 | +Z | ±170 | 无硬停, 线束约束 |
| J2 | 30 | −Y | −73 … +90 | 下限=标定安全 |
| J3 | 30 | −Y | +35 … +180 | **<35 = 历史崩坏区(红线)** |
| J4 | 24 | +X | ±180 | |
| J5 | 30 | −Y | **±95** | **105° 碰结构(实测), 120 不可用** |
| J6 | 50 | +X | ±720 | 多圈(旋切动力) |

> 注（2026-09-10）：表中限位为**物理/固件角**（真机安全底线）。真值链/模型角为
> `q_model = SIGNS·(q_fw + TH_HOME)`（TH=[0,−90,0,0,0,0]），对应模型限位：
> J2 [0°,163°]、J3 [−180°,−35°]，其余相同；模型 REST = (0,163,−180,0,0,0)。

## 3. 图纸真值（几何，mm）

- L_BASE=92.5(实测92.6)、D_BASE=35、L_ARM=146(J2–J3 轴距)、D_EW=52(J3–J4 轴距)、
  L_FA=117(肘→腕沿 J4 轴)、J5B 大孔 Φ31.05、J6 轴 Φ8.95/减速器 Φ26.10
- 来源：改版工程图逐张标注 + STEP 轴孔互证 + auk DH/固件 DOFKinematic 交叉核对
- **2026-09-10 修正**：此前真值链把 D_ELBOW(52)/L_FA(115) 角色放反——Joint3 多出 0.05 面内偏距
  （致 J2–J3=154.3 而非 146）、Joint4 为 (-0.052,0,0.115)（致 J3–J4 轴距 115 而非 52）。
  已按 DH 修正为 `Joint3=(0.146,0,0)`、`Joint4=(0.117,0,0.052)`（见 generate_true_urdf.py）
- 与固件 DH(0.109/…)差异：固件 L_BASE 用原版值(近似), 物理=92.5 → 模型/固件世界差 ~16mm 属预期

## 4. 坐标/角度约定

- 世界：桌面=z0, X=臂前, Z=上, Y=侧（右手）
- 模型链(FW→模型)：`q_model = SIGNS·(q_fw + TH_HOME)`, SIGNS=[+,-,-,+,+,+], TH=[0,-90,0,0,0,0]
  （2026-09-10 修正：真值链几何按 DH 修正后 J3 零位约定平移 90°，TH[2]: 90→0；
  物理 REST (0,-73,180) ↔ 模型 (0,163,-180)，物理 J2[-73,90]/J3[35,180] ↔ 模型 [0,163]/[-180,-35]）
- p_fw ≈ p_model + (60.85, 0, 171.14) mm（两世界关系, 诊断用）
- 命名：关节 Joint1..6, 链 link_1..6/tool0, 机器人 dummyarm

## 5. 控制链（已实测）

- 桥接(管理): dummyarm_bridge/dummyarm_system — 服务 start/disable/stop/home/reset
- ros2_control: dummyarm_hardware (C++ SystemInterface) — /joint_states 实测
  [0, 163, −180, 0, 0, 0] 与预期一致（2026-09-10 约定修正后）
- 启动不使能、!STOP 急停、非测试停 REST(物理 0,-73,180 / 模型 0,163,-180)/失能

## 6. 固件版本族谱

- 真机=auk0217 系（reademe.txt: 发货前 ref 刷 auk0217）; 厂商新 fw(2026-02-22)=J1-5 改50/J6 30+夹爪, 与本机无关
- DH 图 0.1265/0.134 系=其他结构件版本, 不适用本机

## 7. 待办（不阻塞）

- 视觉装配：**已完成**（2026-09-10）。补丁版导出器直接产出可用包 → 项目内 `dummyarm_cad_description`
  （直接采用 Fusion 导出：坐标/限位/滑块+RViz 全验证；关节值=CAD 约定、设计姿态=0）。
  导出/修复流程与坑见 `docs/fusion_export_workflow.md`。
  CAD↔模型映射（并入时用，已验证）：`q_model = [+1,-1,-1,+1,+1,+1]·q_cad + (0,164.95°,-179.95°,0,0,0)`。
  剩余：并入 `dummyarm_description`（改名 Joint1..6/link_1..6/tool0 + 换 ros2_control）
- J1/J2 上极限、J6 多圈的实际物理核定（低速扫角专项）
- tool0/tcp 定义待末端执行器 CAD
