BohnChen/PickOrangeDummy/docs/PROJECT_REVIEW_2026-11-01.md

# PickOrangeDummy · 项目进展核对（2026-11-01 夜）

> 本文只做**盘点与核对**，不做修改。所有数字都是仓库里的代码/实测值。
> 用途：作为接下来"互问互答"的底稿。

---

## 0. 一句话现状

| 子系统 | 状态 |
|---|---|
| 底盘（Ventuno Q + 3 路 PWM） | ✅ 固件 v3 已烧录，ROS 节点真机只读验证通过 |
| 双相机 | ✅ Astra（前向避障）+ D435i（左侧 100° 采摘）都出图 |
| 手眼标定 | ✅ ArUco + PnP + 6 点 SVD，留出验证 7.6mm |
| 机械臂单点定位 | ✅ IK → 实机 0.0mm（相机端到端 1~1.5cm） |
| 末端执行器几何 | ✅ STL 实测（罩口 125mm / 外廓 172mm / 出料口 −Y） |
| 安全限位 | ✅ 扫掠碰撞 + J6 三道闸 |
| **采摘编排（L3）** | ❌ 未开始 |
| **能力层 ROS Action** | ❌ 只有 .action 定义，没有 server |
| **语音** | ❌ 未开始 |
| **柑橘检测（YOLO）** | ❌ 权重不在板上，当前脚本用 HSV |

**结论：硬件与"单次动作"已经能跑；"整机闭环"还差上层。**

---

## 1. 硬件基线（全部实测过）

| 设备 | 连接 | 关键事实 |
|---|---|---|
| 底盘 MCU | `/dev/ttyACM0` (Arduino) | 3 路 PWM（D3/D5/D6），300ms 租约，锁存急停 |
| REF 机械臂 | `/dev/ttyACM1` USB CDC | 断电后必须 `!START`；运动中不响应查询 |
| Astra Pro Plus | 板载 USB2 | 深度/彩色正常，**近距 <0.6m 无返回** |
| D435i | **直插板子 USB3（5Gbps）** | 彩色+对齐深度 ~15Hz，IMU 经 IIO 可读 |
| 语音 USB 声卡 | 扩展坞（当前拔掉） | 只支持 44.1kHz |
| HC-SR04 + 9G 舵机 | D10/D11/D9，3.3V | 静止 1.5s 断脉冲，不再抖动 |

> 扩展坞带不动全部外设（RealSense 一开流整树重枚举）→ **RealSense 必须直插板子**。

**底盘关键实测**：`stop()` = 1500 中位 = 滑行（`brake()` 已删除）；斜率 1%/帧；
15% 油门不动、30% 才起步；D6 是**窗口**不是阈值（`GEAR_FWD=1000`/`GEAR_REV=1500`）；
转向 `steer = -K·angular_z`（底盘 steer>0=右，ROS z>0=左）。**无轮速编码器** ⇒ 不做 Nav2。

---

## 2. 软件分层现状

架构文档定义的 5 层（`docs/architecture_v2.md` §5）：

| 层 | 内容 | 已实现 | 验证 |
|---|---|---|---|
| **L0** MCU | 底盘固件 / 机械臂固件 | `firmware/chassis_v3_sonar`（474 行，已烧录） | ✅ 真机 |
| **L1** 抽象 | 设备唯一写者 | `pickorange_chassis`（rpc.py + chassis_node.py，337 行） | ✅ 只读模式真机 |
| | | `dummyarm_hardware`（ros2_control 插件） | ⚠️ 读超时已修（12ms + clearRx），**未复测** |
| **L2** 能力 | 单动作 | **只有脚本**：`arm_kin/arm_pick/arm_safety/calib_eye_to_hand` | ✅ 脚本级 |
| | | ROS Action server（MoveToPose/CutStem/Creep） | ❌ 无 |
| **L3** 编排 | 状态机 + tick | ❌ 无 | — |
| **L4** 交互 | 语音/监督 | `web_dual_cam.py` 预览 | 部分 |

### 2.1 已定义的接口（`pickorange_interfaces`，编译通过）

```
msg/  Target, TargetArray, ChassisState, HazardReport, RobotState
action/ MoveToPose, CutStem, Creep
srv/  CheckReachable
```

接口定了，但**没有任何 Action Server 实现它们**。

### 2.2 包清单

```
src/pickorange_interfaces   ✅ 编译通过
src/pickorange_bringup      ✅ TF 树（transforms.yaml + tf.launch.py），整车验证
src/pickorange_chassis      ✅ 底盘唯一写者，真机只读验证
src/dummyarm_hardware       ⚠️ ros2_control 插件，串口 wedge 已修但未复测
src/dummyarm_bridge         △ 早期桥接（历史遗留）
src/dummyarm_perception     △ 早期检测/FSM（历史遗留，未接入）
src/dummyarm_*description   △ MoveIt 相关（当前不用）
```

---

## 3. 机械臂：事实与纠正

### 3.1 关节分工（本次纠正，重要）

| 关节 | 作用 | 备注 |
|---|---|---|
| J1 | 基座偏航 | 固件 ±170° |
| J2 | 肩 | 固件 −73°~+90° |
| J3 | 肘 | **红线 <35°，历史上断过臂** |
| **J4** | **外壳滚转 → 出料口朝向** | 固件 ±180° |
| **J5** | **俯仰 → 罩口朝向** | 固件 ±95° |
| **J6** | **内层转子 → 刀片开合** | **唯一的切果轴** |

坐标系：

```
shell（外壳，带出料口） = 走到 Rz(J5) 为止
tool0（转子，带刀片）   = 再经过 T_J5_J6 · Rz(J6)
```

⇒ **出料口朝向必须用 shell 系算**。现有代码用的是 `tool0`，只因为 J6≈0
（−0.57°）两系重合才碰巧正确。**待办：新增 `fk_shell()`。**

### 3.2 运动学与精度

| 项 | 值 | 来源 |
|---|---|---|
| 位置+瞄准 IK | `solve_pose_ik`（约束工具 Z 轴） | `arm_kin.py` |
| 完整 6DOF IK | `solve_full_ik`（含滚转） | `arm_kin.py` |
| IK → 实机到位 | **0.0 mm** | 实测 |
| 相机标定留出验证 | **7.6 mm** | `calib_eye_to_hand.py` |
| 端到端综合 | **1~1.5 cm** | 实测 |

### 3.3 末端执行器几何（STL 实测，`02_opResource/models/`）

| 件 | X | Y | Z |
|---|---|---|---|
| 法兰 | ±17.5 | ±30.5 | −8 → 0 |
| 外壳 | ±86.0 | −128 → 88 | −36 → 117 |
| 内层转子 | ±72.1 | ±73.0 | −10.4 → 123 |
| 上刀片 | −9.3 → 103.5 | ±102 | 123 → 128 |
| 下刀片 | −112.5 → 9.3 | ±107 | 118 → 123 |

- **tool0 → 罩口平面 = 125mm**；→ 刀片外沿 = 136mm
- 罩口内径 ≈ Ø120；最大外廓 ≈ 172mm
- **出料口法向 = −Y_shell**（外壳 Y 多出 −128 那一片是出料槽侧壁）

### 3.4 安全（两次事故换来的）

**事故 A（2026-11-01）**：位置 IK 把 J2 收缩 + J5 从 −74° 翻到 +0.18°，
153mm 末端扫向车架，人工断电止损。

**事故 B（2026-11-01，同日）**：用 J6 做 180° 滚转，刀片被转到底
= 意外剪切，最后顶到机械限位。

**对策**（全部已实现并提交）：

| 机制 | 位置 | 作用 |
|---|---|---|
| 末端解析体积 + 车体包围盒 | `arm_safety.py` | 车体盒 `base_link` x[−0.19,0.61] y[−0.11,0.19] z[−0.202,−0.062] |
| 24 步 slerp 扫掠检查 | `check_sweep` | "侵入不得比起点更深"（允许逃开） |
| 保持姿态的位姿 IK | `arm_goto_xyz` | 不再用纯位置 IK |
| **J6 三道闸** | 规划层 / 校验层 / 串口层 | 串口层超过 0.3° 直接抛异常，指令发不出去 |
| 剪切唯一豁免 | `do_cut()` | `|ΔJ6| ≤ 90°`，`try/finally` 立即上锁 |

---

## 4. 已验证的端到端结果

| 时间 | 内容 | 结果 |
|---|---|---|
| 昨日 | 检测 → base_link → IK → 实机 | 误差 **3.4mm**，末端悬在物体上方 5cm |
| 昨日 | 首次套果（3 步进刀） | 罩口距果心 **2mm**、轴向 **0.0°**（但按 153mm 假设，你目测还差 10cm） |
| 今晚 | 按 STL 125mm 重算并实走 | 罩口与果心**重合 7.6mm**；再进 2cm 后**吞入 18.8mm** |
| 今晚 | J6 归位 | −0.57°（全开），其余五轴未动 |

> 125mm 这个数现在有**物理印证**：罩口落到果心高度时，两者距离正好 7.6mm
> （≈ 相机标定误差），说明 STL 推算的 125mm 是对的，不是目测的 55mm。

---

## 5. 当前"预备位"为什么看起来不如之前

三个姿态摆在一起（都是实算，不是估计）：

| | 固件角 | J3 余量 | J5 余量 | 出料口 | 罩口距果心 |
|---|---|---|---|---|---|
| **新：dry-run 计划** | `[-7.6, −1.9, **168.8**, −7.8, **−75.1**, −0.6]` | **11.2°** | **20.2°** | 3°（正下） | 75mm |
| **旧：之前套住那次** | `[−3.8, 21.8, 113.5, −179.9, 25.8, −0.6]` | 66.5° | 120.8° | **162°（朝天）** | 21mm |
| **当前：安全区待命** | `[−2.3, −10.9, 135.4, 5.4, −15.0, −0.6]` | 44.6° | 80.0° | 18° | 63mm |

**这就是"看起来不如之前"的原因，而且有明确的物理原因：**

1. 新方案要求**水平进刀**（轴线 (0,−1,0)），罩口要到达果实高度 `z=0.046`
   —— 这只比臂底座高 4.6cm。为了让一个**水平向前**的 125mm 长末端
   够到这么低的地方，手臂必须**折得极紧**：J3 顶到 168.8°（离 180° 只剩 11°），
   J5 压到 −75.1°（离 −95° 只剩 20°）。
2. 旧方案之所以"舒展"，恰恰是因为**出料口朝天 162°**——那是错的姿态，
   但姿态本身让 J3=113.5、J5=25.8，余量充足。
3. 也就是说：**"出料口朝下"和"低位水平进刀"这两个要求叠加，把手臂挤到了极限。**

### 5.1 换姿态后的余量（强制出料口朝下，完整 6DOF 求解）

| 方案 | TCP | 轴线俯角 | 固件角 | J3 余量 | J5 余量 | 出料口 | 罩口距果 |
|---|---|---|---|---|---|---|---|
| A 低位水平 | (−0.028,−0.133,0.046) | 0° | `[−7.4,−2.1,**168.8**,−7.6,**−74.8**,−0.6]` | 11.2° | 20.2° | 3° | 75mm |
| A2 低位水平稍外 | (−0.028,−0.160,0.050) | 4° | `[−5.9,6.0,157.0,−6.2,−69.8,−0.6]` | 23.0° | 25.2° | 3° | 48mm |
| **B 抬高一点** | (−0.030,−0.170,0.100) | 30° | `[−6.5,−4.2,131.9,−21.8,−18.4,−0.6]` | **48.1°** | **76.6°** | **26°** | 47mm |
| C 再高 | (−0.030,−0.180,0.120) | 36° | `[−6.1,0.0,115.3,66.2,6.7,−0.6]` | 64.7° | 88.3° | **71° ✗** | 45mm |
| D 更高 | (−0.030,−0.200,0.150) | 47° | `[−5.1,13.6,82.1,8.1,34.7,−0.6]` | **97.9°** | 60.3° | 39° | 44mm |

**B 是明显的甜点**：余量翻倍，出料口仍朝下 26°，只是进刀方向从水平变成**俯角 30°**。

---

## 6. 文档清单与新鲜度

| 文档 | 内容 | 最后更新 | 状态 |
|---|---|---|---|
| `docs/architecture_v2.md` | 整机架构 v2.7（23 章） | 10-31 | 与代码基本一致 |
| `docs/architecture_diagrams.md` | 11 张图 + `.mmd/.svg/.png` | 10-31 | ✅ |
| `docs/safety_and_incidents.md` | 事故史 + 硬性安全约束 | **11-01** | ✅ 已补末端几何 + 两次事故 |
| `docs/HANDOFF_S0_S1.md` | S0 完成 / S1 卡点 | 10-31 | S1 已越过（标定完成），**需更新** |
| `docs/HANDOFF_交接文档.md` | 机械臂真值表/映射/避坑 | 10-24 | 关节映射部分**需按 J4/J5 分工更新** |
| `docs/chassis_control_verified.md` | 底盘实测记录 | 10-31 | ✅ |
| `docs/M2_spec_j6_blade_home.md` | J6 零点规范 | 10-24 | ⚠️ J6 零点仍未重测 |
| `docs/柑橘实例分割模型训练与验证记录.md` | 训练记录 | 10-24 | 权重不在板上 |

**缺失的文档**：没有一份"当前状态 / 待办 / 下次怎么继续"的单一入口
（本文想先顶这个位置）。

---

## 7. 待确认问题（互问互答清单）

### 进刀姿态

**Q1** 进刀方向必须是**严格水平**，还是允许 **20~40° 俯角**？
- 严格水平 → 方案 A，J3 余量只剩 11°
- 允许 30° 俯角 → 方案 B，余量 48°/77°，但罩口是从斜上方套下去

**Q2** "侧下方沿 −Y 进刀"里的"下方"，是指**从斜下方往上**，还是**指向斜下方**？

### 出料口

**Q3** 出料口偏离正下方多少度以内还能接住管子？现在代码用 **50°**。
**Q4** 出料口是**刚性接管**还是**软管**？（决定姿态约束的松紧）

### 果实与剪切

**Q5** 实际柑橘直径大概多少？（现在按半径 22mm 算）
**Q6** `CUT_SPAN_DEG = 60°` 对不对？J6 从 −0.57° 闭合 60° → −60.6° 是否在机械行程内？
**Q7** J6 零点要不要重测？（`scripts/zero_j6.py --measure`，装回刀片后一直没测）

### 路线

**Q8** 继续"脚本直连串口"（现在这样），还是恢复到 `ros2_control + MoveIt`？
- 脚本：灵活、能加任意限位，但每个动作都要手写
- MoveIt：有碰撞检测/规划，但要先把 URDF 和硬件接口调通，且串口 wedge 风险仍在

**Q9** 语音和 L3 编排的优先级，排在"稳定套果"之前还是之后？

---

## 8. 建议的下一步顺序（待讨论，不预先执行）

1. **`fk_shell()`**：出料口朝向改用外壳系算（现在是碰巧对）
2. **定进刀姿态**（Q1/Q2 决定用 A 还是 B）
3. **重测 J6 零点**（Q7），确认剪切行程安全
4. `--stage` 实走一次，你目视确认罩口朝向与姿态
5. 进刀到"罩口包住果实"停住
6. 单独 `--cut`
7. 再做 L3 编排 / 语音

**明确不做**：在没有你确认之前，不动姿态方案、不动 J6、不实走。

---

## 9. 仰角套果的可行域地图（2026-11-01 实测计算）

进刀方式定为**仰角 25°、从斜下方往上套**（果梗在上、果实在下）。

```
行 = 果心高度 z，列 = 果心到臂底座的水平距离 r（正左侧 −Y 方向）
★ 余量充足(>25°)   ✓ 可用(>12°)   · 勉强(<12°)   × 无解

        r=0.20   r=0.24   r=0.28   r=0.31   r=0.34   r=0.37
  z=0.06     ×        ×        ×        ×        ×        ×
  z=0.10     ×        ×        ×        ×        ×        ·
  z=0.14     ·        ·        ·        ·        ✓        ✓
  z=0.18     ✓        ★        ★        ★        ★        ✓
  z=0.22     ★        ★        ★        ★        ★        ✓
  z=0.26     ★        ★        ★        ★        ★        ✓
  z=0.30     ★        ★        ★        ★        ×        ×
```

**结论：果心必须落在 `z ∈ [0.18, 0.26]`、`r ∈ [0.24, 0.34]` 的甜区。**

- `z` 是 base_link 高度；臂底座离地 0.202m ⇒ **果心离地 0.38~0.46m**
- `r` 是果心到臂底座的**水平**距离，方向为正左（−Y）
- 当前果实 `z=0.046, r=0.333` 落在 × 区 —— **仰角套果在数学上无解**，
  所以决定：挪车到有解的位置再采，不硬采

### 为什么低处无解

锥罩长 125mm 且要"朝上瞄"，TCP 就被压到果心下方 125mm×sin(25°)=53mm。
果心 `z=0.046` ⇒ TCP `z=-0.007`，比臂底座还低，末端外廓（半径 86mm）
会切进车架上平面（`z=-0.062`），J5 也被迫顶到 −95° 下限。

### 为什么高处也无解（z>0.28）

臂展 0.34m 是硬限制；果心抬高后，"往下 53mm 的 TCP + 125mm 的锥罩"
需要更大的水平伸展，超出行程。
