BohnChen/PickOrangeDummy/docs/DummyArm_for_VENTUNO/1_规划文档/DummyArm-硬件参数采集表.md

# DummyArm 硬件参数采集表

填写原则：不知道的项目写“待测”，不要凭感觉估计。尺寸单位统一为 mm，角度为度，速度为度/秒；后续进入 ROS 2 配置时再转换为米和弧度。

## A. 机械臂概况

| 项目 | 填写内容 |
|---|---|
| 机械臂型号/来源 | |
| 自由度数量 | |
| 额定负载 | |
| 最大工作半径 | |
| 总重量 | |
| 安装方式 | 桌面固定 / 小车固定 / 其他 |
| CAD/装配图是否存在 | |
| 当前是否能手动或原厂软件运动 | |
| 当前控制板与固件来源 | |

## B. 逐关节参数

每个关节复制填写一份。

| 项目 | Joint 1 | Joint 2 | Joint 3 | Joint 4 | Joint 5 | Joint 6 |
|---|---|---|---|---|---|---|
| 关节类型（旋转/移动） | | | | | | |
| 电机型号 | | | | | | |
| 驱动器型号 | | | | | | |
| 控制模式（位置/速度/电流） | | | | | | |
| 额定电压/电流 | | | | | | |
| 减速器与减速比 | | | | | | |
| 编码器型号 | | | | | | |
| 编码器分辨率 | | | | | | |
| 编码器位置（电机侧/输出侧） | | | | | | |
| 机械最小角 | | | | | | |
| 机械最大角 | | | | | | |
| 建议软件最小角 | | | | | | |
| 建议软件最大角 | | | | | | |
| 最大速度 | | | | | | |
| 回零方式 | | | | | | |
| 限位开关类型与数量 | | | | | | |
| 正方向说明 | | | | | | |
| 故障/堵转检测方式 | | | | | | |

## C. 连杆几何

| 项目 | 填写内容 |
|---|---|
| 基座中心到 Joint 1 轴线 | |
| Joint 1 到 Joint 2 轴线 | |
| Joint 2 到 Joint 3 轴线 | |
| Joint 3 到 Joint 4 轴线 | |
| Joint 4 到 Joint 5 轴线 | |
| Joint 5 到 Joint 6 轴线 | |
| 最后关节到 `tool0` | |
| `tool0` 到夹爪 TCP | |
| 各关节轴方向草图/照片 | |
| STL/STEP 文件位置 | |

至少拍摄正面、侧面、俯视、末端、各关节铭牌和控制板接线照片；照片旁放直尺或已知尺寸参照物。

## D. 夹爪或采摘工具

| 项目 | 填写内容 |
|---|---|
| 工具类型 | 平行夹爪 / 吸盘 / 剪切 / 旋拧 / 其他 |
| 驱动方式 | |
| 最大开口 | |
| 最小开口 | |
| 最大夹持力 | |
| 是否有位置反馈 | |
| 是否有电流/力反馈 | |
| 工具重量 | |
| 工具重心 | |
| 通信或控制方式 | |
| 预期柑橘采摘动作 | |

## E. 主控与通信

| 项目 | 填写内容 |
|---|---|
| QCS8550 操作系统及版本 | |
| CPU 架构与内核版本 | |
| ROS 2 是否已安装 | |
| 可用 USB 2/USB 3 接口 | |
| 可用 UART/CAN/以太网接口 | |
| D435i 是否能稳定输出 RGB-D | |
| QNN/SNPE SDK 版本 | |
| GD32 具体型号 | |
| GD32 与电机驱动器的链路 | |
| QCS8550 与 GD32 的候选链路 | |
| 现有通信协议或代码位置 | |
| 状态反馈实测最高稳定频率 | |

## F. 安全检查

| 项目 | 有/无/待补 | 说明 |
|---|---|---|
| 物理急停 | | |
| 执行器总使能 | | |
| 各轴机械限位 | | |
| 软件关节限位 | | |
| 通信超时自动停机 | | |
| 过流/堵转保护 | | |
| 上电不自动运动 | | |
| 低速调试模式 | | |
| 可可靠固定机械臂底座 | | |
| 可隔离人员的测试区域 | | |

## G. 首轮数据样例

为了评估 14,000 张柑橘图像，提供以下信息即可开始：

| 项目 | 填写内容 |
|---|---|
| 数据目录结构 | |
| 图像格式与典型分辨率 | |
| 标注格式 | COCO / YOLO / LabelMe / 无标注 / 其他 |
| 标注类别 | |
| 是否有实例分割掩码 | |
| 是否有果梗/枝条标注 | |
| 是否来自视频连续帧 | |
| 是否包含深度或相机内参 | |
| 采集场景数量 | |
| 可提供的脱敏样例数量 | |

## H. 下一步交付触发条件

- 完成 A、B、C、D：可以制作真实尺寸 URDF/Xacro 和 MoveIt 2 配置。
- 完成 B、E、F：可以冻结主机—MCU 协议并实现 `ros2_control` 硬件插件。
- 完成 G：可以完成数据审计、划分方案与检测/分割训练基线设计。
- 确认夹爪和目标任务：可以定义抓取姿态、TCP 和第一套 pick-and-place 验收场景。
