BohnChen/PickOrangeDummy/docs/DummyArm_for_VENTUNO/1_规划文档/柑橘采摘机器人技术方案.md

# **柑橘采摘机器人技术方案**

[https://gemini.google.com/app/06f6ff1b969b74f7](https://gemini.google.com/app/06f6ff1b969b74f7)

*User prompt: 我在设计一个矮小的柑橘采摘机器人，采用低矮的履带式或者轮式的小车结构，为了补全密集柑橘林无法进入大型作业机械的工作场景，重新设计了侧边开孔排料，双层锥型结构的旋转带动剪切的末端执行器，上方载有一个6自由度高重复精度的dummy机械臂，视觉系统采用realSense 435i。 我目前已经采集了14000张高质量图片数据集，我打算采用型号为广翼智联FV04的开发板作为整个系统的大脑，用香蕉派或者树莓派作为整个系统的小脑。整个系统协作的主要任务是可以通过深度相机的识别，让机械臂自行完成柑橘的采摘工作，然后通过独特设计的末端执行机构，完成柑橘果实的收纳。请你给我一份详细的技术实现方案，让我可以实现所有的功能。*

Response: 这是一个非常具有挑战性但也极其精彩的系统集成项目。针对你目前的硬件选型（FV04 \+ RealSense D435i \+ Dummy机械臂 \+ 履带底盘）以及“嵌入式初学者”的现状，我将为你提供一份能够落地的**分层技术实现方案**。

根据你的要求，本回答保持客观冷静，直接指出潜在的技术风险。

### **1\. 总体系统架构设计 (System Architecture)**

你的系统采用了经典的**分层控制架构**，这是正确的方向。将高算力负载（视觉）与实时控制负载（运动）分离，有利于系统的稳定。

> * **感知层 (Brain \- FV04):** 负责“看”和“思考”。处理RealSense数据，运行深度学习模型，计算柑橘的三维坐标。  
> * **决策与控制层 (Cerebellum \- 香蕉派/树莓派):** 负责“动”。运行ROS2，处理机械臂逆运动学 (IK)，规划路径，控制底盘和末端执行器。  
> * **执行层 (Actuator):** Dummy机械臂控制器（通常是STM32）、底盘电机驱动、末端剪切电机。

### **2\. 核心模块详细实施方案**

#### **A. 视觉感知系统 (FV04 \+ RealSense)**

**现状分析：** 你拥有广翼智联FV04（基于高通QCS8550，算力极强，约48 TOPS）和14000张图片。 **挑战：** QCS8550通常预装Android或专用Linux Yocto，对于初学者，**环境配置是最大噩梦**。

> * **模型训练 (MacBook M4 Max):**  
  1. **算法选择:** 放弃陈旧的Faster R-CNN。对于柑橘这种密集小目标，推荐使用 **YOLOv8** 或 **YOLOv11** (Seg版本)，因为你需要分割出果实掩码以计算精确中心，或者至少使用YOLOv8-OBB (Oriented Bounding Box) 来确定果实生长角度，引导剪切方向。  
  2. **训练:** 利用M4 Max的GPU加速（PyTorch MPS后端）进行训练。  
  3. **模型转换:** FV04的高通芯片需要使用 **SNPE (Snapdragon Neural Processing Engine)** 或 **QNN SDK** 才能发挥算力。你需要将PyTorch模型导出为ONNX，再转换为DLC或QNN格式。如果这对初学者太难，可以暂时使用**TFLite** (Android支持好)，虽然牺牲一些速度，但部署更简单。  
> * **部署逻辑:**  
  1. 在FV04上运行一个App（或服务），调用RealSense SDK (Android版) 获取RGB-D流。  
  2. RGB图送入YOLO模型，得到2D边框 (u, v)。  
  3. 结合深度图 D 和相机内参，将 (u, v, d) 转换为相机坐标系下的3D坐标 (Xc, Yc, Zc)。  
  4. **关键一步:** 对坐标进行滤波（卡尔曼滤波或简单的滑动平均），因为树叶遮挡会导致坐标跳动。  
  5. 通过 **Socket (TCP/UDP)** 将目标坐标 \[x, y, z, approach\_angle\] 发送给香蕉派。

#### **B. 运动控制系统 (香蕉派/树莓派 \+ Dummy Arm)**

**现状分析：** Dummy机械臂（稚晖君开源方案）是6自由度，结构复杂。 **挑战：** 6自由度机械臂的逆运动学（IK）解算对于初学者非常晦涩。

> * **软件环境:** 推荐在香蕉派/树莓派上安装 **Ubuntu 22.04 Server** \+ **ROS2 Humble**。  
> * **机械臂控制:**  
  1. **MoveIt2:** 这是ROS2中的运动规划框架。你需要为Dummy机械臂配置 URDF 模型（描述手臂长度、关节限制）。  
  2. **IK Solver:** 使用 KDL 或 TRAC-IK 插件。当收到FV04发来的坐标时，MoveIt2会自动计算6个电机需要转动的角度，并规划出一条避开自身的路径。  
  3. **通信驱动:** 编写一个简单的ROS2 Node，通过串口 (USB-to-TTL) 或 CAN总线将规划好的关节角度发送给Dummy机械臂底层的控制器（通常是STM32）。

#### **C. 末端执行器与作业逻辑 (End-Effector)**

**现状分析：** 侧边开孔、双层锥型旋转剪切。 **控制逻辑:**

> 1. **接近:** 机械臂末端到达果实坐标上方 Z \+ offset 处。  
> 2. **包络:** 机械臂沿Z轴下降，双层锥型结构引导果实进入侧边开孔。  
> 3. **剪切:** 触发旋转电机，带动剪切机构（类似旋转铡刀）闭合。  
> 4. **收纳:** 由于是旋转结构，剪切后的果实应顺势落入导料管或利用重力滑入车体收纳箱。

### **3\. 初学者技术路线图与风险提示 (Critical Review)**

目前你的方案在硬件上很“豪华”，但在软件集成上存在**断层**。以下是针对初学者的修正路线：

#### **阶段一：打通通信 (1周)**

> * **不要**一上来就写复杂的视觉算法。  
> * 写一个简单的Python脚本，让FV04通过网线/Wi-Fi发一个字符串 "Hello" 给香蕉派。  
> * 让香蕉派收到指令后，驱动机械臂动一下。  
> * **目的:** 验证跨硬件通信，这是最容易卡壳的地方。

#### **阶段二：手眼标定 (Hand-Eye Calibration) (关键难点)**

> * 相机看到的坐标 (Xc, Yc, Zc) **不是** 机械臂基座的坐标 (Xb, Yb, Zb)。  
> * 你需要做一个“手眼标定”。由于你是Eye-in-Hand (相机在手上) 还是 Eye-to-Hand (相机在车上)？根据你的描述“上方载有...机械臂，视觉系统采用RealSense”，推测相机可能是固定在车体上（Eye-to-Hand）。  
> * **风险:** 如果标定不准，机械臂永远抓不到橘子。初学者可以使用ROS的 easy\_handeye 包，或者手动测量（如果安装精度够高）。

#### **阶段三：有限状态机 (FSM) 开发**

不要把所有逻辑写在一个 while True 循环里。使用 SMACH 或简单的状态变量：

> * IDLE: 等待视觉信号  
> * NAVIGATING: 底盘移动（简单闭环）  
> * DETECTED: 视觉锁定目标  
> * PLANNING: 机械臂规划路径  
> * EXECUTING: 执行采摘  
> * RETRACTING: 收回并复位

### **4\. 针对你目前阶段的建议 (Actionable Advice)**

> 1. **关于FV04 (Brain):** QCS8550的开发门槛极高。如果你发现Android开发环境难以调用底层的硬件接口，或者模型转换过于痛苦，**建议降级**。对于初学者，直接在香蕉派/树莓派5上跑YOLO（使用NCNN加速）或者加一个Hailo/Rockchip NPU计算棒，开发效率会高10倍。**算力过剩但开发不出来，等于零。**  
> 2. **关于Dummy机械臂:** 稚晖君的Dummy臂使用的是步进电机+闭环驱动。如果你是自己通过3D打印制作，**刚性**是一个大问题。加上你的末端执行器（电机+机械结构）可能很重，Dummy臂的末端负载（Payload）通常只有500g左右。**请务必称重你的末端执行器**，如果超过500g，机械臂会失步或抖动，导致无法剪切。  
> 3. **数据集:** 14000张很多，但请确保包含**不同光照**（阴天、晴天）和**遮挡**情况的数据。

### **总结**

你的硬件选型属于“强强联合”，但对于嵌入式初学者，**软件集成难度是S级**。建议先“跑通”一个最简闭环：**用电脑代替FV04，手动输入坐标让机械臂动起来**，然后再逐步替换各个模块。

下一阶段，你可能需要参考稚晖君原本的开源项目来理解Dummy臂的控制协议。

[I made a DUMMY ROBOTIC ARM from scratch！](https://www.youtube.com/watch?v=F29vrvUwqS4)

**视频相关性说明：** 这是你计划使用的“Dummy机械臂”的原作者稚晖君的详细开发视频，其中包含机械结构、闭环控制电路以及运动学算法的核心实现细节，对于你理解和二次开发该机械臂至关重要。

http://googleusercontent.com/youtube\_content/0

---

*User prompt: 你给的方案很诚恳，但是我现在其实需要完成的任务是一份内容翔实的发明专利交底书，你知道的，交底书是一份技术实现方案，我想请你根据我对这个项目的设想，帮我写出一份技术实现构思方面内容翔实的交底书。*

Response: 这份交底书将作为专利代理人撰写正式专利申请文件的基础。考虑到你不仅涉及**机械结构创新**（末端执行器），还涉及**系统集成创新**（双脑架构+视觉控制），建议将本交底书的重点放在“一种结构独特的末端执行器”**以及**“基于双计算单元的机器人控制系统”两个核心点上。

以下是为您撰写的发明专利技术交底书模版及详细内容：

# **发明专利技术交底书**

**发明名称：** 一种面向矮化密植果园的柑橘采摘机器人及其控制方法 **发明人：** \[你的名字\]

## **1\. 技术领域**

本发明属于农业机器人技术领域，具体涉及一种适用于矮化密植环境、具备视觉识别与自动收纳功能的柑橘采摘机器人及相关控制方法。

## **2\. 背景技术（现有技术的痛点）**

*在此部分，我们需要客观描述为什么要发明这个机器，重点打击现有技术的弱点：*

> 1. **作业环境限制：** 现有的柑橘采摘机械大多体积庞大，难以进入行距狭窄、枝叶繁茂的矮化密植柑橘林进行作业。  
> 2. **采摘损伤与效率：** 传统机械臂末端执行器多为简单的夹持-剪切结构，容易在剪切后导致果实跌落损伤，或需要额外的机械动作将果实放入收集箱，效率低下。  
> 3. **识别与控制割裂：** 传统的农业机器人往往单一控制器负载过重，难以同时兼顾高算力的深度学习视觉识别与高实时性的运动控制。

## **3\. 发明内容（核心技术方案）**

### **3.1 系统总体架构**

本发明提出一种矮小构型的采摘机器人，主要由**低矮移动底盘**（履带/轮式）、**6自由度机械臂**、**双层锥型旋转剪切末端执行器**、**双核心控制系统**及**深度视觉系统**组成。

### **3.2 核心创新点一：双层锥型旋转剪切末端执行器（机械核心）**

*这是你最有可能获得授权的结构创新点，描述必须极其详细。*

> * **结构组成：** 包括外层导向罩（静止）、内层旋转刀具（运动）、果柄导入口（侧边开孔）及下部收纳通道。  
> * **双层锥型设计：**  
  * **外层锥体：** 采用平滑的圆锥台结构，侧边开有“V”形或“U”形导料槽。作用是在机械臂前探时，拨开遮挡树叶，引导柑橘果柄滑入导料槽底部。  
  * **内层旋转剪切机构：** 位于外层锥体内部，由电机驱动旋转。当果柄卡入导料槽根部时，内层刀片旋转通过导料槽位置，完成剪切。  
> * **收纳逻辑：** 整个末端执行器内部中空或后部连接软管。利用重力或辅助气流，果实被剪断后，直接落入执行器内部通道，滑向车体收纳箱，无需机械臂进行“回缩-放置”的额外动作。

### **3.3 核心创新点二：基于“大小脑”架构的控制系统（电控核心）**

> * **感知大脑（Brain）：** 采用广翼智联FV04（高通QCS8550平台）。  
  * **功能：** 运行Android/Linux系统，部署YOLO系列深度学习模型（基于已采集的14000张数据集训练）。负责处理RealSense D435i的RGB-D数据流，进行果实识别、分割及三维坐标解算。  
> * **运动小脑（Cerebellum）：** 采用香蕉派/树莓派。  
  * **功能：** 运行ROS2操作系统。接收“大脑”发送的目标坐标，负责机械臂的逆运动学解算（Inverse Kinematics）、轨迹规划（防止碰撞树枝）以及底盘和末端电机的底层驱动控制。

## **4\. 具体实施方式（详细技术实现）**

*这一部分是专利代理人最看重的，需要把“怎么做”写得像说明书一样清楚。*

### **4.1 硬件连接实施例**

> 1. **视觉传感器：** RealSense D435i通过USB 3.0接口连接至FV04开发板，安装于底盘前端或机械臂基座上方（Eye-to-Hand模式），以获取稳定的全局视野。  
> 2. **通讯链路：** FV04与香蕉派之间通过千兆以太网（Ethernet）或高速UART串口进行通讯，采用TCP/IP或自定义协议传输JSON格式的坐标数据 (x, y, z, pitch, roll, yaw)。  
> 3. **执行机构：** 香蕉派通过CAN总线或USB转串口连接6自由度Dummy机械臂的底层控制器（如STM32），并控制末端剪切电机和底盘电机驱动器。

### **4.2 采摘作业流程（方法保护点）**

本发明所述的控制方法，包含以下步骤：

> * **步骤 S1（环境感知）：** 机器人行进至作业位置，RealSense D435i采集图像。  
> * **步骤 S2（视觉解算）：** FV04利用基于CNN的检测模型（如YOLOv8）识别柑橘ROI区域，结合深度图获取果心坐标。通过坐标变换矩阵，将相机坐标系下的点 *Pc* 转换为机械臂基座坐标系下的点 *Pb*。  
> * **步骤 S3（策略规划）：** 香蕉派接收 *Pb*，根据末端执行器的特殊结构，计算最佳**进给角度**。  
  * *技术细节：* 由于末端是侧边开孔，机械臂不应正对果实中心刺入，而应计算果柄生长方向，规划路径使末端执行器的导料槽开口对准果柄。  
> * **步骤 S4（运动执行）：**  
  1. 机械臂运动至目标上方预备点。  
  2. 沿Z轴下降并配合末端姿态调整，完成“包络”动作，使果柄进入导料槽。  
  3. 启动末端旋转电机，切断果柄。  
> * **步骤 S5（收纳与复位）：** 果实沿内部通道滑落，机械臂复位或直接移动至下一个目标点，无需由于抓取而产生的回程动作。

## **5\. 有益效果（必须吹捧自己的设计）**

> 1. **空间适应性强：** 履带式/轮式低矮底盘配合紧凑的机械臂，完美解决了大型机械无法进入密集果园的问题。  
> 2. **采摘效率高：** “剪切即收纳”的一体化末端设计，省去了传统机械臂“夹住-剪断-移动-放下”的繁琐步骤，单次采摘周期大幅缩短。  
> 3. **果实保护性好：** 锥型导向结构避免了机械爪直接接触果肉造成的挤压伤；旋转剪切相比剪刀式剪切更平稳。  
> 4. **算力分配优化：** 将高负载的视觉计算与高实时的运动控制物理分离，保证了FV04发挥最大AI算力的同时，不影响机械臂运动控制的实时性与安全性。

### **给你的撰写建议（基于客观视角的补充）：**

> 1. **关于附图：** 专利交底书**必须**配图。你需要提供：  
   * **图1：** 机器人整体结构示意图（手绘或CAD截图）。  
   * **图2：** 末端执行器的爆炸图或剖视图（这是核心，要标出哪里是刀片，哪里是导料槽）。  
   * **图3：** 系统控制框图（画出FV04、香蕉派、相机、电机之间的数据流向）。  
> 2. **模糊化具体型号：** 在正式提交的专利文中，尽量不要写“FV04”、“RealSense”、“香蕉派”这种具体商业型号，而应描述为“AI边缘计算模块”、“RGB-D深度相机”、“运动控制单元”。这样可以防止竞争对手换个型号就绕过你的专利。但在**交底书**阶段，写清楚型号有助于代理人理解。  
> 3. **强调“侧边开孔”的算法配合：** 你的末端结构决定了你的算法必须不仅仅是找圆心，还必须找“进刀方向”。这一点在**步骤S3**中我特意帮你强调了，这是软硬件结合的创新点，非常加分。

你可以直接将上述内容复制到Word文档中，配合你的CAD截图，就完成了一份质量非常高的技术交底书。

---

*User prompt: 关于我提到的架构，你可以重新看一下这个 dummy 工程，地址为https://github.com/peng-zhihui/Dummy-Robot。项目中已经提供好了通过 linux 的控制方式，只需要给机械臂具体坐标就可以做到抓取目标。是不是就是说，我只需要一个广翼智联 FV04 作为大脑，机械臂自己的 ref 板作为执行部分的解析资源，完成计算后，通过 can 总线通讯让电机驱动板作为具体执行机构，指挥电机完成抓取运动。同时 FV04 作为计算单元，处理视觉系统信息，然后指挥小车完成运动。*

Response: 你的理解非常到位，甚至比之前的“大小脑”方案更具**集成度**和**技术先进性**。

你现在的思路是将原本运行在PC（或树莓派）上的上位机控制算法，直接移植到算力强大的 **FV04（高通QCS8550）** 上，从而省去中间的“小脑”。

**结论是：完全可行。** 这在工业界被称为“算控一体化”架构，也是目前高端机器人的主流趋势。

为了帮助你把这部分内容准确地写进专利交底书，我们需要厘清具体的**数据流向**和**控制逻辑**。

### **1\. 新的系统架构逻辑（单核心架构）**

在这种架构下，FV04 不仅是“眼睛”，也是“运动中枢”。

> * **FV04 (上位机/Host):** 承担所有高层计算。  
  * **视觉任务:** 运行 YOLO，处理 RealSense 数据，计算果实坐标 (*x*,*y*,*z*)。  
  * **运动学解算 (IK):** 运行 Dummy Robot 的 Linux SDK（原项目中的 dummy\_sdk）。它根据目标坐标 (*x*,*y*,*z*)，利用逆运动学算法计算出 6 个电机分别需要转动的角度 (*θ*1,*θ*2,...,*θ*6)。  
  * **底盘控制:** 同时计算小车的移动逻辑。  
> * **REF 板 (下位机/MCU):** 承担实时通讯与指令分发。  
  * 它不再需要“思考”怎么走，它只需要“听话”。它通过 USB/串口 接收 FV04 发来的 6 个关节角度指令，然后通过 **CAN 总线** 极速分发给 6 个步进/伺服驱动器。  
> * **执行器 (电机):** 接收 CAN 信号，完成闭环控制。

### **2\. 技术实现的关键细节（写进交底书的内容）**

在撰写交底书的“具体实施方式”一节中，你可以这样描述这套流程，这显得非常专业：

#### **实施例：基于单SoC的高集成度控制系统**

本系统摒弃了传统的“上位机+运动控制器”的分离式架构，采用高通QCS8550（FV04）作为唯一的主控单元（SoC）。

> 1. **视觉-运动映射（坐标变换）：**  
   * FV04 获取 RealSense 的深度数据，识别柑橘中心坐标 *Pcam*。  
   * 通过手眼标定矩阵 *Tcam*\_*to*\_*base*，将坐标转换为机械臂基座坐标 *Pbase*。  
   * **关键点：** 考虑到你的末端是**侧边开孔**，FV04 还需要计算一个**接近向量 (Approach Vector)**，确保末端姿态是“侧着”切入，而不是“顶”上去。  
> 2. **逆运动学解算（IK Solver）：**  
   * 在 FV04 的 Linux 环境中运行机械臂控制算法（对应 Dummy 的 SDK）。  
   * 输入：目标位姿 *Ptarget*（包含位置和旋转角度）。  
   * 输出：6 个关节的目标弧度值。  
   * *注：这一步是在 FV04 上完成的，而不是在 REF 板上。FV04 算力强，算得快。*  
> 3. **通讯协议与指令下发：**  
   * FV04 通过 **USB转TTL (Serial)** 或 **USB转CAN** 与 REF 主控板连接。  
   * FV04 以 50Hz-100Hz 的频率发送包含 6 个关节角度的数据包。  
   * REF 板解析数据包，将其转换为 CAN 总线协议（如 CAN 2.0B），分别发送给 ID 1-6 的关节电机。  
> 4. **底盘协同：**  
   * 当视觉系统发现目标距离过远（超出机械臂工作空间）时，FV04 暂停发送机械臂指令，转而通过 GPIO 或串口向底盘电机驱动器发送移动指令，直到目标进入可采摘范围。

### **3\. 专利交底书的“修改建议”**

既然方案变了，你的交底书中关于“控制系统”的描述也需要升级。这反而是一个更好的**发明点**。

**原描述：** 双脑架构（FV04 \+ 树莓派）。 **新描述（推荐）：** **一种基于边缘计算SoC的感算控一体化柑橘采摘机器人。**

**在“有益效果”中可以增加：**

“本发明采用高性能 SoC（System on Chip）直接进行视觉识别与运动学解算的**全栈处理**，去除了独立的运动控制微机（如树莓派）。相比传统分布式架构，该设计减少了异构硬件间的通讯延迟（Latency），降低了系统功耗与硬件成本，显著提高了机器人在非结构化果园环境中对动态目标的响应速度。”

### **4\. 潜在风险提示（作为开发者的良心建议）**

虽然这个方案在**原理**和**专利**上很完美，但在**落地**时请注意以下一点：

> * **Dummy SDK 的移植：** 稚晖君的 Dummy Robot 上位机代码通常是在 Ubuntu (x86/64) 上开发的。你的 FV04 是 ARM 架构 (aarch64)，且系统可能是 Android 或深度定制的 Linux。  
  * **工作量：** 你可能需要重新编译 Dummy 的 SDK 库。如果它依赖了一些特定版本的 ROS 或图形库，可能会在 FV04 上遇到依赖报错。  
  * **解决：** 只要你能把 Dummy 的 IK 算法部分（纯数学计算部分）剥离出来，封装成一个简单的 C++ 或 Python 脚本在 FV04 上跑，只输出角度数据给串口，就能避开复杂的环境配置问题。

**总结：** 你的新思路非常清晰且正确。在交底书中，请大胆采用这种“FV04 单核心统筹视觉与运动”的描述，这会让你的专利技术含量看起来更高。

---

*User prompt: 使用 usbc 转 usbc 数据线，直接将 dummy 机械臂连接到 fv04，通过 fv04 的 linux 控制系统，直接发送从视觉系统剥离出的坐标，让机械臂完成抓取，这样应该可以实现的吧？*

Response: 这是一个非常**高效且干净**的硬件连接方案，完全可行。

从技术原理上讲，FV04（Host/主机）通过 USB-C 接口与 Dummy 机械臂的 REF 板（Device/从机）连接，Linux 系统会将 REF 板识别为一个**虚拟串口设备（如 /dev/ttyACM0 或 /dev/ttyUSB0）**。

但是，为了确保你的交底书逻辑严密，以及实际落地时不炸机，有一个**致命的物理细节**必须在方案中剥离开：**“通讯”与“供电”必须分离**。

以下是针对这一方案的详细分析和交底书撰写建议：

### **1\. 核心可行性分析（Yes, but...）**

> * **通讯可行性（Pass）：**  
  * FV04 的 USB-C 口支持 Host 模式。  
  * REF 板（STM32）的 USB 口配置为 CDC 类（虚拟串口）。  
  * 两者通过 USB-C 数据线连接，FV04 可以像操作普通串口一样，以极高的速率（USB 2.0 High Speed 或 Full Speed）向 REF 板发送指令。这比传统的杜邦线连接 UART 更加稳定抗干扰。  
> * **供电可行性（Fail \- 必须注意）：**  
  * **误区：** 你**不能**指望通过这一根 USB-C 线给机械臂供电。  
  * **原因：** FV04 的 USB 口对外输出电流通常只有 500mA \- 1.5A（5V）。而 Dummy 机械臂的 6 个电机在工作时，瞬间电流可能达到 **10A \- 20A**（24V）。  
  * **后果：** 如果只插 USB 线，电机一动，FV04 会立刻因为过流保护而断电重启，或者直接烧毁主板供电芯片。

### **2\. 修正后的硬件拓扑图（写进交底书）**

在交底书中描述这种连接方式时，要强调“数据/控制链路”**与**“动力链路”的独立性。

**系统连接示意：**

> 1. **控制链路（弱电）：** FV04 (USB-C) \<==== **USB 数据线 (仅传输指令)** \====\> REF 主控板 (USB-C)  
> 2. **动力链路（强电）：** 动力电池 (24V) \<==== **XT60 大电流线** \> REF 主控板 (电源输入口) \< CAN 总线 \====\> 6个关节电机

### **3\. 交底书撰写模版（针对 USB 直连方案）**

我为你更新了“具体实施方式”中的相关描述，这段话可以直接用：

**实施例更新：基于 USB 高速总线的直连控制架构**

本实施例采用高通 QCS8550 边缘计算平台（以下简称主控单元）作为系统的唯一上位机。

> 1. **物理连接接口：** 主控单元通过 **USB Type-C 高速数据接口**与机械臂底层的嵌入式实时控制器（REF板）直接相连。相比传统的 UART 引脚跳线连接，USB 差分信号传输具备更强的抗电磁干扰能力，适应果园复杂的电磁环境。  
> 2. **通讯协议实现：**  
   * 主控单元运行基于 Linux 的操作系统，将机械臂控制器识别为通用串行总线设备（Device File）。  
   * 系统内部采用**指令包（Packet）机制**进行通讯。主控单元将视觉解算后的目标位姿 (*x*,*y*,*z*,roll,pitch,yaw) 封装为十六进制指令帧。  
   * 指令帧包含：帧头、功能码（如 0x01 代表位置控制）、数据载荷（各关节弧度值或空间坐标）、CRC 校验位及帧尾。  
> 3. **算力与执行分配：**  
   * **主控单元（FV04）：** 负责“重计算”。运行逆运动学算法库，将空间坐标实时解算为 6 个关节的电机角度流。  
   * **实时控制器（REF板）：** 负责“轻计算、重执行”。作为 USB 从机接收角度流，通过板载 CAN 收发器将指令分发至各关节伺服驱动器，实现高频闭环控制。

### **4\. 实际代码实现逻辑（给你的开发指导）**

既然你已经有 Dummy 的源码，针对 FV04 的 USB 直连，你的代码逻辑应该是这样的：

**在 FV04 上运行的 Python/C++ 程序：**

`# 伪代码示例`  
`import serial`  
`import time`  
`from dummy_kinematics import InverseKinematics # 假设你剥离出了IK算法`

`# 1. 打开 USB 串口 (Linux下通常是 ttyACM0)`  
`ser = serial.Serial('/dev/ttyACM0', 115200, timeout=1)`

`def main_loop():`  
    `while True:`  
        `# A. 视觉部分：获取果实坐标`  
        `target_xyz = vision_system.get_citrus_position()`   
          
        `# B. 算法部分：在 FV04 上解算 6 个电机的角度`  
        `# 注意：这里计算的是怎么让"侧边开口"对准果柄`  
        `joint_angles = InverseKinematics.solve(target_xyz, approach_vector=[...])`  
          
        `# C. 通讯部分：打包并通过 USB 发送`  
        `# Dummy 的协议通常需要特定的包头包尾`  
        `packet = build_dummy_packet(joint_angles)`   
        `ser.write(packet)`  
          
        `# D. 等待反馈 (可选)`  
        `# response = ser.read(...)`

### **总结**

你的“USB-C 直连”**想法非常棒，它大大简化了系统集成难度，在交底书中也是一个体现**“集成化设计”的亮点。

**唯一切记：** 给机械臂单独接一个 24V 的电池包！不要试图从 FV04 取电。只要记住这一点，这个方案就是完美的。

---

*User prompt: 当然，只是，通过对电路的解析和他人的经验，我这里采用的是 12V8A 的电源给 dummy 供电*

Response: 这是一个非常务实且安全的选择。既然你已经通过电路解析确定了 **12V 8A (96W)** 的供电方案，且这是基于他人验证过的经验，那么在**原型机验证阶段**这是完全可行的。

为了确保你的**发明专利交底书**内容严谨，且实际系统运行稳定，我们需要以客观的角度审视这个参数，并将其转化为技术文档中的描述。

### **1\. 客观技术评估（针对 12V 8A 方案）**

根据你之前的要求（保持客观、指出不足），我对这个电源配置做以下评估：

> * **优点（Pros）：**  
  * **兼容性好：** 12V 是非常标准的电压，几乎所有的步进电机驱动芯片（如 A4988, DRV8825, TMC系列）和 FOC 驱动都能稳定工作。  
  * **安全性高：** 相比 24V 或 48V，12V 对初学者更友好，电路板短路烧毁的风险（能量释放）略低。  
> * **潜在不足与风险（Cons）：**  
  * **高速力矩衰减：** 步进电机的特性是电压越高，高速下的力矩保持得越好。如果使用 12V，当机械臂进行**快速**移动（例如为了提高采摘效率）时，电机可能会因为反电动势（Back EMF）导致力矩急剧下降，造成**丢步**。  
  * **功率余量紧张：** 你的末端执行器增加了重量（电机+剪切结构）。6个关节电机 \+ 1个末端电机，如果同时满负载启动，瞬间电流可能会接近或超过 8A。  
> * **改进建议（Action Item）：**  
  * 务必在 REF 板的电源输入端并联一个**大容量电解电容（例如 35V 2200μF 或更高）**。这是一个“蓄水池”，可以在电机瞬间启动需要大电流时提供缓冲，防止电压瞬间拉低导致 FV04 或通讯中断。

### **2\. 专利交底书内容的更新（加入电源管理）**

在交底书中，我们不需要写死“12V 8A”这个具体参数（因为专利要保护范围宽泛），但我们需要强调“逻辑电源与动力电源隔离”这一架构特点。

请将以下内容添加到交底书的“4. 具体实施方式”章节中，替换或新增关于电源部分的描述：

#### **4.3 电源管理子系统实施例**

为了解决移动作业机器人在高负载工况下的电磁干扰与电压波动问题，本系统采用了**双路隔离供电架构**：

> 1. **逻辑计算供电链路：**  
   * 主控单元（FV04）及视觉传感器（RealSense）由独立的稳压电源或机载电池管理系统（BMS）的逻辑输出口供电，确保在电机堵转或大电流启动时，计算单元不会因电压跌落而重启。  
> 2. **动力驱动供电链路：**  
   * 机械臂关节电机及末端执行器电机由独立的**动力电源模块**供电（本实施例采用 12V 直流电源）。  
   * **关键设计特征：** 动力电源直接接入嵌入式实时控制器（REF板）的功率接口。在电路设计上，REF板内部实现了控制信号（3.3V逻辑电平）与功率驱动部分（12V动力电平）的**光耦隔离**或**电气隔离**，并通过大容量电容滤波，防止电机产生的反向感应电动势（Back EMF）通过共地回路干扰主控单元的 USB 通讯信号。

### **3\. 最终的硬件连接拓扑图（文字版）**

为了让你在搭建时更清晰，同时也方便你画专利附图，这是最终确定的连接逻辑：

**连接说明：**

> 1. **数据线（细线）：**  
   * FV04 (USB-C) \<---\> REF板 (USB-C)  
   * *作用：* 仅传输 XYZ 坐标和关节指令，不传电。  
> 2. **动力线（粗线）：**  
   * 12V 8A 电源/电池 \---\> REF板 (XT30/XT60 接口)  
   * *作用：* 为 6 个关节驱动器供电。  
   * *注意：* 中间最好加一个急停开关。  
> 3. **末端执行器线束：**  
   * REF板 (扩展接口) \---\> 末端旋转电机  
   * REF板 (扩展接口) \---\> 末端传感器(如有)  
   * *注意：* 你的末端是旋转剪切，这意味着线缆会随着旋转而缠绕。你需要考虑**导电滑环**（Slip Ring）或者限制旋转角度（软件限位），防止把线拧断。

### **下一步建议**

既然电源方案已定，你现在的首要任务是**验证“12V电压下带负载的能力”**。

> 1. 把机械臂组装好，装上你的末端执行器（可以用同等重量的哑铃片代替先测试）。  
> 2. 用 12V 供电。  
> 3. 让机械臂把手伸到最远端（力臂最长，负载最大）。  
> 4. 观察电机是否会发出异响（丢步）或发热过快。

如果没有问题，这个方案就可以写入交底书并正式实施了。

---
