BohnChen/PickOrangeDummy/docs/DummyArm_for_VENTUNO/2_对话记录/关于我.md

---
tool: knowledge
type: profile
---

# 关于我（用户档案）

> 本文件是用户的个人档案，供本地 AI 在回答问题时了解用户的背景、偏好与目标。
> 回答时应结合本档案与知识库中的其他对话记录。

## 基本信息

- **姓名**：陈泌丞（GitHub: BohnChen）
- **所在地**：杭州（必须留在杭州）
- **身份**：硕士研究生在读（农业工程与信息技术），2027 年毕业，可全职实习或直接工作
- **求职状态**：正在投递机器人软件 / ROS2 C++ 方向岗位，边投简历边做项目

## 教育背景

- **浙江农林大学**（硕士在读，2024.09–2027.06）：农业工程与信息技术，杭州
- **江西农业大学**（本科毕业，2016.09–2020.06）：教育技术学

## 工作经历

- **上海维宏电子科技（2022 年，约半年）**：C++ 软件开发工程师
  - Phoenix CNC 数控平台内核组代码维护（C++ / C# / Lua 混合栈）
  - 为测试组独立设计开发自动化测试框架

## 技能栈

- **主力**：C/C++（C++11/14/17、STL、泛型）、Python
- **ROS2**：话题/服务/Action、Launch、URDF + Gazebo 仿真、RViz2、TF2
- **Linux**：多进程/多线程、IPC、epoll、socket 网络编程、零拷贝（sendfile/splice）
- **数据结构与算法**：顺序表/链表/栈/队列/二叉树/B 树/红黑树/图、排序查找
- **数据库**：MySQL（C API）
- **嵌入式**：树莓派、Jetson Nano、ESP32、GD32、香蕉派 BPI-F3、广翼智联 FV04；FreeRTOS 小测试；UART/I2C/SPI/CAN
- **工具链**：Git、GDB、CMake、Docker 基础、Vim/VS Code、Fusion 360 建模与 3D 打印
- **其他**：PMP 项目管理认证、CET-6、LLM API 接入与工具链

## 主要项目

1. **智元灵犀 X2 考场巡检机器人**（Python/ROS2，核心开发）
   - 语音激活 → 自主巡逻 → 违规检测 → 语音对话闭环
   - Vosk 离线语音（VAD）、接入 DeepSeek/通义千问大模型、台湾腔语音交互
   - ROS2 Service/Topic 调度运动、表情、TTS；Seed Audio → X2 TTS 多级降级链
2. **Linux 高性能网络文件管理系统**（C/Linux，独立开发）
   - C/S + epoll + 线程池；TCP 粘包处理；sendfile/splice 零拷贝；MD5 秒传、断点续传；MySQL 虚拟文件系统
3. **面向低位果实采摘的自主移动机器人（在研，项目负责人）**
   - 六轴机械臂 + ROS2 控制系统（Action、URDF、TF）
   - RGB-D 相机采集柑橘数据集 14,000+ 份；第一发明人授权发明专利 1 项，末端执行器专利申请中

## 开发环境与常用工具

- MacBook Pro M4 Max，36GB 内存，1TB 存储
- 本地 AI 体系：Ollama（qwen3-coder:30b 主模型 + bge-m3 嵌入）+ AnythingLLM（「本地知识库」工作区）+ Obsidian（AINote 知识库文件夹）
- AI 工具：opencode、Claude Code、Codex、Gemini、ChatGPT、AnythingLLM
- 编辑器/终端：nvim（Markdown 实时预览已配置）、zsh、yazi/ranger、fzf、typora
- 硬件外设：RealSense D435i（相机数据集采集）、iPhone 14 Pro Max（Halide 拍摄数据集）、各种开发板（树莓派/ESP32/香蕉派/Jetson Nano/GD32）
- 其他：Homebrew 为主包管理器；写 LaTeX（XeLaTeX）简历

## 当前目标与待办

- **求职**：2027 年毕业，主攻机器人软件工程师 / ROS2 C++，副攻 Linux C/C++ 应用开发
- **面试准备**：C++ 基础、算法题、Linux 原理需要复习到面试状态
- **项目并行**：一边投简历，一边把采摘机器人做成可运行的软件系统（机械臂可动、数据集已采集待处理、控制算法专利待验证）
- **毕业任务**：按时完成毕业设计和大论文

## 与我协作的偏好

- 回答用**中文**，简洁、直接、可执行，避免冗长的铺垫
- 涉及我的项目和知识时，**优先检索知识库**（AINote 对话存档），引用具体来源/结论
- 给建议要**结合我的实际条件**（硬件、时间、目标），不要泛泛而谈
- 代码示例尽量完整可运行，并说明放在哪里、怎么验证
- 我习惯用 Homebrew、zsh、nvim，命令/路径按 macOS 习惯给出
