BohnChen/PickOrangeDummy/docs/DummyArm_for_VENTUNO/2_对话记录/codex/2026-06-04_你可以帮我写我的第一个机器人项目吗.md

---
tool: codex
session_id: rollout-2026-06-04T10-52-03-019e908b-8659-7c60-a7a6-dfbaa0d94adb
date: 2026-06-04 10:52
updated: 2026-06-04 11:20
source: .codex/sessions/2026/06/04/rollout-2026-06-04T10-52-03-019e908b-8659-7c60-a7a6-dfbaa0d94adb.jsonl
---

# 你可以帮我写我的第一个机器人项目吗

> 工具: codex · 会话: rollout-2026-06-04T10-52-03-019e908b-8659-7c60-a7a6-dfbaa0d94adb

## 2026-06-04 10:52 用户

你可以帮我写我的第一个机器人项目吗

## 2026-06-04 10:52 用户

<turn_aborted>
The user interrupted the previous turn on purpose. Any running unified exec processes may still be running in the background. If any tools/commands were aborted, they may have partially executed.
</turn_aborted>

## 2026-06-04 10:52 用户

哈哈

## 2026-06-04 10:52 助手

哈哈，可以啊。我们可以从一个很小但完整的“第一个机器人项目”开始：一个命令行聊天机器人，能记住你的名字、回答简单问题、退出时说再见。后面再升级成微信/Discord/网页机器人都行。

你想做哪一种？

1. Python 命令行机器人：最适合第一次做，简单、马上能跑  
2. 网页聊天机器人：有界面，看起来更像产品  
3. 接 OpenAI API 的 AI 聊天机器人：更智能，但需要 API key  
4. Discord/Telegram/微信机器人：能在平台里运行，但配置稍多

如果你不确定，我建议先做 `Python 命令行机器人`。我可以直接帮你在这个文件夹里生成项目文件、写代码、运行测试，然后告诉你怎么启动。

## 2026-06-04 10:53 用户

刚才的设置跟手机 app 联动的页面我怎么找不到了

## 2026-06-04 10:54 助手

哈哈，可能是刚才那个页面被中断后没保留在当前窗口里了。你说的“设置跟手机 app 联动的页面”，我先按两种可能帮你找：

**如果你说的是 Codex/桌面端这个项目页面：**  
左侧线程列表里找刚才那个对话/项目；如果找不到，可以看当前工作目录：`/Users/bohn/Documents/Codex/2026-06-04/new-chat`。我们现在就在这个新聊天里。

**如果你说的是 ChatGPT 手机 App 联动/连接设置：**  
通常在 ChatGPT 里点头像或菜单 → `Settings` / `设置` → 找 `Apps`、`Connected apps`、`Devices`、`Connectors` 或类似入口。不同版本名称可能会变。

你说的页面是“手机 App 扫码登录/配对”的页面，还是“连接某个服务/插件”的设置页？我可以按你具体那个页面一步步带你找。

## 2026-06-04 10:57 用户

你可以帮我写我的第一个机器人项目吗

## 2026-06-04 10:57 助手

可以，我先给你做一个适合入门的版本：一个 Python 命令行聊天机器人，结构简单但像个真正的小项目，有代码、README 和启动方式。先看一下当前文件夹里有没有已有内容，避免碰到你已经放进去的东西。

## 2026-06-04 10:57 助手

这个目录目前很干净，只有 `work` 和 `outputs`。我会把成品项目放到 `outputs/first-bot`，这样你之后能直接打开、运行和继续改。

## 2026-06-04 10:57 助手

接下来我会写三个文件：机器人主程序、一个简单的测试文件、还有中文 README。这个版本不需要联网、不需要 API key，先把“项目能跑起来”这一步稳稳拿下。

## 2026-06-04 10:58 助手

代码已经写好了。我注意到测试文件最好用 Python 自带的 `unittest` 格式，这样你不用额外安装 pytest；我先把测试改成标准格式，然后跑一遍确认。

## 2026-06-04 10:58 助手

现在开始验证：先跑自动测试，再用几句模拟输入跑一遍机器人本体，确认它不仅“代码对”，也真的能聊天。

## 2026-06-04 10:58 助手

可以，已经帮你写好了第一个机器人项目：一个 Python 命令行聊天机器人“小星”。

项目在这里：[first-bot](/Users/bohn/Documents/Codex/2026-06-04/new-chat/outputs/first-bot)

主要文件：
- [bot.py](/Users/bohn/Documents/Codex/2026-06-04/new-chat/outputs/first-bot/bot.py)：机器人主程序
- [test_bot.py](/Users/bohn/Documents/Codex/2026-06-04/new-chat/outputs/first-bot/test_bot.py)：自动测试
- [README.md](/Users/bohn/Documents/Codex/2026-06-04/new-chat/outputs/first-bot/README.md)：运行说明

运行方式：

```bash
cd /Users/bohn/Documents/Codex/2026-06-04/new-chat/outputs/first-bot
python3 bot.py
```

我也已经验证过了：3 个自动测试全部通过，机器人能正常打招呼、记住名字、报时间和退出。下一步可以把它升级成“网页版聊天机器人”或者“接入 AI API 的机器人”。

## 2026-06-04 11:02 用户

我可以怎样测试你的性能？

## 2026-06-04 11:02 助手

当然可以。你可以从这几类来测试我，最好给我一个明确目标和一些约束，比如“30 分钟内完成”“只能用 Python”“要能运行测试”。

**1. 编程能力**  
让我写一个小项目、修 bug、重构代码、补测试、解释复杂代码。  
例子：  
```text
帮我把这个机器人改成网页版，并加一个聊天记录功能。
```

**2. 工程完整度**  
看我会不会读项目结构、保持风格、写完后验证。  
例子：  
```text
给这个项目加功能，但不要破坏现有测试。完成后运行测试并告诉我结果。
```

**3. 调试能力**  
故意放一个报错，让我定位原因。  
例子：  
```text
这个 Python 脚本运行时报错，帮我找 bug 并修好。
```

**4. 产品/设计能力**  
让我做一个真正可用的小工具，而不是只写示例代码。  
例子：  
```text
做一个网页待办事项 app，要能新增、完成、删除、筛选任务。
```

**5. 学习辅助能力**  
让我边写边教你。  
例子：  
```text
用最适合新手的方式解释 bot.py 每一段代码，并给我 3 个练习。
```

一个很好的测试题是：  
```text
把我的第一个机器人升级成网页聊天机器人：有输入框、消息气泡、清空按钮，并保存聊天记录到浏览器本地。写完后帮我运行起来。
```

这个测试能同时看出我写代码、设计界面、组织项目、验证结果的能力。

## 2026-06-04 11:03 用户

告诉我，你都能帮我做什么

## 2026-06-04 11:03 助手

我能帮你做很多事，尤其是把想法变成能运行、能交付的东西。

**写代码和做项目**  
我可以帮你从零写网站、App 原型、机器人、自动化脚本、小游戏、数据分析工具，也可以接着你现有的项目改功能、修 bug、补测试、整理结构。

**学习编程**  
我可以像陪练一样带你学 Python、JavaScript、AI、网页开发、算法、Git。你可以把我当成“会写代码的教练”：我能解释代码、出练习、检查你的答案、一步一步带你改。

**AI 和机器人**  
我可以帮你做聊天机器人、客服机器人、知识库问答、自动回复工具、Discord/Telegram/网页机器人，也能教你怎么接 OpenAI API。

**自动化工作**  
我可以写脚本帮你批量整理文件、处理表格、生成报告、改文件名、爬取公开数据、定时提醒、监控网页变化。

**文档和写作**  
我可以帮你写 README、项目说明、简历、邮件、中文/英文润色、产品文案、学习笔记、教程和演示稿。

**调试和审查**  
你可以把报错、代码、项目目录丢给我。我能帮你定位问题、解释为什么错、直接修改文件，并运行测试验证。

**设计和前端**  
我可以做网页界面、仪表盘、工具页面、小游戏界面，也能检查布局、颜色、交互是否舒服。

**图片和视觉**  
如果你需要图标、插画、封面、头像、素材草图，我也可以帮你生成或改图。

你可以直接用这种方式叫我：  
“帮我做一个……”“把这个改成……”“解释这个代码……”“帮我排查这个报错……”  
我比较擅长的是不只给建议，而是直接动手把东西做出来。

## 2026-06-04 11:04 用户

你知道英伟达开源的机器鸭项目吗？ 做这样一个机器鸭，需要哪些技术栈？

## 2026-06-04 11:04 助手

我先核一下你说的“英伟达开源的机器鸭”具体是哪一个项目；这类硬件/机器人项目名称和仓库经常变，确认来源后再给你拆技术栈会更靠谱。

## 2026-06-04 11:05 助手

我大概知道你说的方向，但名称可能有点混：我查到更接近的是 **Duckietown / Duckiebot**，它不是“英伟达自己开源的机器鸭”，而是源自 MIT、由 Duckietown Foundation 维护的开源机器人教育平台；NVIDIA 推过基于 Jetson Nano 的 Duckietown 课程。NVIDIA 博客也写到 Duckietown 是用于机器人和 AI 教育/研究的开源平台。另一个相近项目是 **nanosaur**，是基于 NVIDIA Jetson、ROS2/Isaac ROS 的开源小机器人。

如果你想做“类似机器鸭/桌面自主机器人”的项目，需要的技术栈大概分 7 层：

**1. 硬件**
- 主控：NVIDIA Jetson Nano / Orin Nano，或低成本用 Raspberry Pi
- 运动：直流电机/舵机、电机驱动板、编码器
- 传感器：摄像头、IMU、超声波/ToF、可选深度相机
- 结构：3D 打印外壳、底盘、电池、电源管理

**2. 机器人系统**
- Linux / Ubuntu
- ROS 2：机器人消息通信、节点管理、传感器数据流
- Docker：部署机器人软件环境
- Python / C++：Python 写行为逻辑快，C++ 做高性能控制

**3. 感知**
- OpenCV：图像处理、颜色识别、二维码/标志识别
- 深度学习视觉：目标检测、语义分割、姿态估计
- NVIDIA TensorRT / CUDA：在 Jetson 上加速推理

**4. 运动控制**
- PID 控制：让机器人走直线、转向、跟随路线
- 电机控制：PWM、速度反馈、编码器读取
- 状态机：待机、巡航、避障、跟随、回家等行为模式

**5. 定位与导航**
- 入门版：循线、避障、视觉标记导航
- 进阶版：SLAM、视觉里程计、路径规划
- NVIDIA Isaac ROS 里有加速的视觉 SLAM、3D 重建、导航相关组件；官方说明 Isaac ROS 基于开源 ROS 2。

**6. 仿真与训练**
- Gazebo / Webots：普通机器人仿真
- NVIDIA Isaac Sim / Isaac Lab：更偏 AI 机器人、强化学习、合成数据
- 如果做 AI 行为学习，可以用 imitation learning、reinforcement learning、LeRobot 这类开源机器人学习工具链。NVIDIA 和 Hugging Face 也在推动 LeRobot + Isaac Lab + Jetson 的流程。

**7. AI 交互**
- 语音识别：Whisper 或本地 ASR
- 语音合成：TTS
- 大模型：OpenAI API 或本地小模型
- 多模态：摄像头看世界，大模型做解释和任务规划

我建议你的第一个版本不要一上来做完整“机器鸭”。比较稳的路线是：

1. **纯软件仿真鸭**：Python + OpenCV/简单状态机  
2. **桌面小车版**：Jetson/Raspberry Pi + 摄像头 + 两个电机  
3. **ROS 2 版**：拆成相机节点、控制节点、决策节点  
4. **AI 版**：加入语音、目标识别、自动导航  
5. **外形鸭子化**：3D 打印外壳、OLED 眼睛、声音反馈

最低可行技术栈我会选：`Python + Raspberry Pi/Jetson + 摄像头 + 电机驱动 + OpenCV + ROS 2`。  
如果目标是更接近 NVIDIA 路线，就用：`Jetson Orin Nano + Ubuntu + ROS 2 + Isaac ROS + Docker + OpenCV + TensorRT`。

参考来源：NVIDIA 关于 [Duckietown + Jetson Nano](https://blogs.nvidia.cn/blog/jetson-nano-2gb-duckietown/)、NVIDIA [Isaac Robotics 平台](https://developer.nvidia.com/isaac/)、NVIDIA 与 Hugging Face 关于 [LeRobot/Isaac Lab](https://blogs.nvidia.com/blog/hugging-face-lerobot-open-source-robotics/)、以及 [nanosaur 开源 Jetson 机器人](https://hackaday.io/project/184824-nanosaur)。

## 2026-06-04 11:13 用户

SGD 30 是多少钱

## 2026-06-04 11:13 助手

`SGD 30` 是 **30 新加坡元**。

按最近汇率粗算：

- 约 **23.4 美元**，按 `1 SGD ≈ 0.78 USD`
- 约 **158.5 人民币**，按 `1 SGD ≈ 5.28 CNY`

所以可以简单记：**30 新币大概是 23 美元 / 160 人民币左右**。实际支付会因银行、平台手续费有一点差别。

## 2026-06-04 11:19 用户

帮我生成一张柑橘采摘机器人的预览效果图

## 2026-06-04 11:19 助手

我会用 imagegen 技能来生成一张偏“产品概念预览图”的柑橘采摘机器人效果图，重点表现果园环境、机械臂、视觉传感器和采摘动作。

## 2026-06-04 11:20 助手

生成好了。这张是偏真实产品预览风格的柑橘采摘机器人效果图：果园场景、双机械臂、视觉传感器、收集框和采摘动作都有体现。

使用的是内置 `image_gen` 工具生成。
