BohnChen/PickOrangeDummy/docs/DummyArm_for_VENTUNO/2_对话记录/codex/2026-06-11_你可以看到HuxXu_graspnet_deploy_项目下的文件吗.md

---
tool: codex
session_id: rollout-2026-06-11T16-59-57-019eb5e8-dc4b-75c0-bb4c-14ccd60175ec
date: 2026-06-11 17:00
updated: 2026-06-11 17:08
source: .codex/sessions/2026/06/11/rollout-2026-06-11T16-59-57-019eb5e8-dc4b-75c0-bb4c-14ccd60175ec.jsonl
---

# 你可以看到HuxXu_graspnet_deploy 项目下的文件吗？

> 工具: codex · 会话: rollout-2026-06-11T16-59-57-019eb5e8-dc4b-75c0-bb4c-14ccd60175ec

## 2026-06-11 17:00 用户

你可以看到HuxXu_graspnet_deploy 项目下的文件吗？

## 2026-06-11 17:00 助手

我先确认一下当前工作目录和项目顶层文件，顺手看一下是不是你说的这个仓库。

## 2026-06-11 17:00 助手

可以看到。当前工作目录是：

`/Users/bohn/Documents/HuaXu_graspnet_deploy`

里面顶层主要有一个 `graspnet_deploy/` 目录和 `.git/`。我也能看到项目文件，比如：

- `graspnet_deploy/README.md`
- `graspnet_deploy/deploy.sh`
- `graspnet_deploy/run_all.sh`
- `graspnet_deploy/graspnet_ros/scripts/graspnet_detector.py`
- `graspnet_deploy/graspnet_ros/launch/grasp_pipeline.launch`

你刚才写的是 `HuxXu_graspnet_deploy`，实际路径里看起来是 `HuaXu_graspnet_deploy`。

## 2026-06-11 17:01 用户

是的没错。
这是在仿真环境中使用graspnet抓取的代码，但是机械臂总是识别不到位，抓不到地方，请你帮我查看是哪里的问题

## 2026-06-11 17:01 助手

我来顺着“感知输出 → 坐标系转换 → 规划执行”的链路查一遍，重点看相机点云、GraspNet 输出的坐标系、以及执行器拿到的位姿有没有错位。先读关键脚本和 launch 配置。

## 2026-06-11 17:01 助手

已经看到一个可疑点：检测器发布的抓取位姿是在点云消息的 frame 里，但执行器固定按 `depth_link` 去变换，而且对 GraspNet 的旋转轴解释也可能不一致。我继续把剩余执行流程和 TF/URDF 配置对上。

## 2026-06-11 17:01 助手

这里还有第二个明显风险：launch 里给执行器传了 `camera_frame` 等参数，但脚本完全没读取这些参数，仍然硬编码 `world` 和 `depth_link`。如果仿真里的真实相机 frame 不是这个名字，抓取点会直接变到错误位置。继续查相机是怎么挂载/发布的。

## 2026-06-11 17:01 助手

相机配置里还有一个结构性问题：`table.world` 直接放了两个静态 Gazebo 相机模型，frame 名是 `rgb_link` 和 `depth_link`；但这些 frame 不一定会出现在 ROS TF 树里。执行器却依赖 `lookup_transform('world', 'depth_link')`，这会导致要么 TF 查不到，要么用了错误/过期的外参。

## 2026-06-11 17:01 助手

顺手也看到了脚本层面的坑：有些启动脚本只发布了 `world -> rgb_link`，没发布 `world -> depth_link`，而执行器查的是 `depth_link`。我再做一轮语法/静态检查，确认有没有会让流程提前失效的问题。

## 2026-06-11 17:02 助手

静态检查确认两个启动脚本本身有语法错误；这会让 `run_all.sh` / `test_full.sh` 在等待 MoveIt 那一步直接挂掉。Python 脚本能过语法检查。接下来我查 GraspNet 的旋转矩阵约定，判断执行器现在取哪一列作为 approach 是否反了。

## 2026-06-11 17:02 助手

我会做一个小修复集，不只是报告：先把确定会错的 frame/TF 和启动脚本问题补上，再增加一些运行时日志，让你在 RViz/终端能直接看到“GraspNet 的点到底变到世界坐标哪里了”。不过在改之前我还要确认 GraspNet rotation 矩阵的列含义。

## 2026-06-11 17:02 助手

GraspNet 这边确认了：rotation matrix 第 0 列就是 approach 方向，第 1 列是夹爪闭合方向。执行器取列本身没错，但现在“如果朝上就只改 z 分量”的处理是错的，应该整根向量取反并重新归一化，否则手爪会被引到一个不存在的斜向方向。

## 2026-06-11 17:03 助手

我准备改这些确定项：执行器读取 launch 参数而不是硬编码 frame，修正 approach 向量翻转/归一化，按候选抓取点的世界坐标过滤桌面外/桌面上的结果，并让夹爪关闭宽度用 GraspNet 预测宽度；另外补齐 `depth_link` 静态 TF 和脚本语法错误。这样改动会直接对“识别到了但抓偏/抓空/抓桌子”这类症状起作用。

## 2026-06-11 17:04 助手

先动执行器。这个文件是最关键的，因为它把网络输出变成机械臂目标位姿；现在错位和抓空大概率都在这里被放大。

## 2026-06-11 17:04 助手

执行器已经改完第一版：现在会用实际/配置的相机 frame 变换抓取点，跳过桌面外或桌面高度以下的候选，并且不会再把 approach 向量“只翻 z 不翻整体”。我继续补检测器发布 frame 和启动配置。

## 2026-06-11 17:04 助手

检测器现在会把抓取结果的 frame 一起塞进 `Float32MultiArray.layout`，执行器优先读这个 frame；同时 RViz marker 也改成点云 frame，避免“看起来在一个 frame，执行在另一个 frame”。

## 2026-06-11 17:04 助手

`grasp_pipeline.launch` 也补了 `world -> rgb_link/depth_link` 静态 TF，并把原来错误的 `camera_frame=panda_link8` 改成 `depth_link`。现在继续修复你可能会直接运行的顶层脚本。

## 2026-06-11 17:04 助手

顶层 `run_all.sh` 修好了：之前在等待 MoveIt 的 `for` 循环处有反斜杠，`bash -n` 会直接报语法错误；同时补上了 `depth_link` 的 TF。

## 2026-06-11 17:05 助手

`test_full.sh` 也同样修好。还有一个噪声问题：世界文件里已经有桌子，`scene_setup.py` 又尝试 spawn 同名桌子，我会让它检测已存在模型，避免场景初始化时重复报错。

## 2026-06-11 17:05 助手

场景初始化也收拾了一下：现在重复运行不会再因为同名 `table`/`object_i` 卡在旧模型上。接下来跑语法检查和 diff，确认没有手滑。

## 2026-06-11 17:05 助手

语法检查通过了：三个 Python 脚本和三个 shell 脚本现在都能过解析。我再看一遍 diff 和关键行，确认改动集中在预期位置。

## 2026-06-11 17:05 助手

这个仓库里 `graspnet_deploy/` 整体还是未跟踪状态，所以普通 `git diff` 看不到细粒度差异。我直接抽查修改后的关键文件内容。

## 2026-06-11 17:05 助手

抽查看起来正常。还有一点值得提醒：普通 `git diff` 现在为空不是没改，而是因为整个 `graspnet_deploy/` 目录还没被 git 跟踪；我会在最终说明里把改过的文件列清楚。现在再看两个入口脚本的 TF 段。

## 2026-06-11 17:05 助手

语法检查留下了 Python 的 `__pycache__` 产物；这些是我刚才检查时生成的，不属于项目源码。我把它们清掉，保持工作区干净一点。

## 2026-06-11 17:06 助手

`apply_patch` 不能删除二进制 `.pyc`，因为它会先按文本读取。我要用一次受控的删除命令，只删刚才检查生成的 `__pycache__`。

## 2026-06-11 17:06 助手

缓存目录已删。最后我再确认没有 `.pyc` 残留，并检查一下 XML 是否至少是结构完整的。

## 2026-06-11 17:06 助手

没有缓存残留，launch/world XML 能正常解析。工作区状态仍显示 `graspnet_deploy/` 整体未跟踪，这是仓库状态本身，不是这次改动造成的。

## 2026-06-11 17:07 助手

我又重新对了一下相机坐标：检测器按 `x/z, y/z` 投影，说明点云被当成 ROS optical 坐标处理。如果 `depth_link` 的静态 TF 用 Gazebo 模型姿态 `0 1.57 0`，中心点会被变到世界 x 方向，而不是桌面 z 方向，这正是“抓不到位”的典型错位。我要把静态 TF 改成 optical frame 对应的四元数，避免欧拉角顺序也造成歧义。

## 2026-06-11 17:07 助手

我会把三处入口都改成同一组 TF：`depth_link/rgb_link` 表示 optical frame，四元数让 optical `+Z` 指向世界 `-Z`（向下看桌面）。这个比之前的 `0 1.57 0` 更符合检测器的点云投影假设。

## 2026-06-11 17:07 助手

launch 入口已改成 optical frame 四元数。继续同步 shell 脚本，避免你从不同入口启动时得到不同坐标系。

## 2026-06-11 17:07 助手

顶层 `run_all.sh` 已同步。现在同步 `test_full.sh`。

## 2026-06-11 17:07 助手

测试脚本也同步了。项目里还有一个 `graspnet_ros/scripts/run_all.sh`，我把它的注释和 TF 一起改掉，免得两个 run_all 行为不一致。

## 2026-06-11 17:08 助手

四个入口都统一了。现在我跑一次 shell/XML 检查，再用一个小计算验证这个四元数确实把相机中心深度点变到桌面高度附近。

## 2026-06-11 17:08 助手

入口脚本和 launch XML 都通过解析。再做坐标数值验证。

## 2026-06-11 17:08 助手

数值验证是对的：相机中心点深度 `0.42m` 会落到世界坐标 `z=0.38`，正好是桌面高度；深度 `0.34m` 会落到 `z=0.46`，对应桌面上物体顶部附近。这个和仿真场景尺寸吻合。

## 2026-06-11 17:08 助手

看完并修了一轮，主要问题确实在坐标系和执行位姿转换上。

最大的问题是：GraspNet 检测器按 optical 点云坐标在处理数据，但执行端/启动脚本用的相机 TF 不一致，甚至有的入口只发布了 `rgb_link`，没有 `depth_link`。这样抓取点会被变换到错误的世界位置。另一个明显问题是执行器只把 approach 向量的 `z` 分量取反，而不是整根向量取反，会把抓取方向扭歪。

我已经改了这些文件：

- [grasp_executor.py](/Users/bohn/Documents/HuaXu_graspnet_deploy/graspnet_deploy/graspnet_ros/scripts/grasp_executor.py): 读取 `base_frame/camera_frame` 参数，使用检测器发布的 frame；修正 approach 向量；增加 workspace 过滤；用 GraspNet 预测宽度控制夹爪。
- [graspnet_detector.py](/Users/bohn/Documents/HuaXu_graspnet_deploy/graspnet_deploy/graspnet_ros/scripts/graspnet_detector.py): 把点云 frame 写入抓取消息，并让 RViz marker 用同一个 frame。
- [grasp_pipeline.launch](/Users/bohn/Documents/HuaXu_graspnet_deploy/graspnet_deploy/graspnet_ros/launch/grasp_pipeline.launch): 补齐 `world -> rgb_link/depth_link` optical TF，并把错误的 `camera_frame=panda_link8` 改成 `depth_link`。
- [run_all.sh](/Users/bohn/Documents/HuaXu_graspnet_deploy/graspnet_deploy/run_all.sh) 和 [test_full.sh](/Users/bohn/Documents/HuaXu_graspnet_deploy/graspnet_deploy/test_full.sh): 修复 `\$(seq ...)` 语法错误，并补齐 `depth_link` TF。
- [scene_setup.py](/Users/bohn/Documents/HuaXu_graspnet_deploy/graspnet_deploy/graspnet_ros/scripts/scene_setup.py): 避免重复 spawn 同名桌子/物体。

验证过：
- Python 脚本语法检查通过
- Shell 脚本 `bash -n` 通过
- launch/world XML 解析通过
- 相机 TF 数值验证通过：中心深度 `0.42m` 会落到世界 `z=0.38`，正好是桌面高度

我没有在这里启动完整 ROS/Gazebo/GPU 仿真。你下一步可以跑：

```bash
cd /Users/bohn/Documents/HuaXu_graspnet_deploy/graspnet_deploy
./run_all.sh
```

运行时重点看 executor 日志里的：

```text
OBJECT #1 | world(x, y, z)
Hand target: ...
```

正常抓桌面物体时，`world` 大概应该在 `x=0.65~0.75, y=-0.2~0.05, z=0.40~0.47` 附近。若还明显偏，下一步就该调 `tool_offset` 或 Panda 末端 link 的坐标约定。
