BohnChen/PickOrangeDummy/docs/DummyArm_for_VENTUNO/2_对话记录/opencode/2026-07-31_Explore_dummy_robot_SDK_explore_subagent.md

---
tool: opencode
session_id: ses_0478509b0ffeUB4GfYFwoN0p35
model: deepseek-v4-pro
date: 2026-07-31 22:01
updated: 2026-07-31 22:05
---

# Explore dummy robot SDK (@explore subagent)

> 工具: opencode · 模型: deepseek-v4-pro · 会话: ses_0478509b0ffeUB4GfYFwoN0p35

## 2026-07-31 22:01 用户

Very thoroughly explore the dummy robot SDK and resources at these locations:

1. `/Users/bohn/Documents/Codex/2026-07-31/w/work/repositories/dummy/` - Main SDK repo cloned from gitee
2. `/Users/bohn/Documents/Codex/2026-07-29/dummyarm-ros2-grasp` - Previous ROS2 grasp project
3. `/Users/bohn/Documents/DummyRes/1.Dummy_V2_ren/` - Resources (firmware, docs, models)
4. `/Users/bohn/04_Project/02_My_Dummy/` - User's own project dir

I need to understand:
1. **How the mechanical arm communicates** - What protocol? Serial/UART? TCP? What's the command format? How do you send joint positions/angles?
2. **The SDK structure** - What APIs are available? Python? C++? Is there an existing ROS2 wrapper?
3. **Any existing ROS2 work** - What's in the ros2 directory? Are there existing nodes?
4. **Firmware** - What MCU? ESP32? What firmware?
5. **Important docs** - Read the user manual PDF if accessible
6. **What we can reuse vs what needs to be built from scratch**

Please read all key files and return a comprehensive analysis covering:
- Communication protocol details (exact command format)
- Available SDK APIs
- Existing ROS2 packages
- What we need to build for the project
- Key file paths we should reference
