BohnChen/PickOrangeDummy/docs/柑橘数据集处理与清洗记录.md

# 柑橘采摘数据集处理与清洗记录

> **项目名称**：PickOrangeDummy 低位柑橘采摘机器人  
> **数据根目录**：`/Users/bohn/04_Project/05_Orange/MyOrangeDataset/`  
> **创建时间**：2026-09-16  
> **维护说明**：详细记录针对原始拍摄数据集的每一次清洗、格式转换、去重、抽帧与整理操作，包含处理前状况、处理逻辑、执行动作及处理后状态对比。

---

## 目录
- [一、 数据集初始概况](#一-数据集初始概况)
- [二、 数据处理记录列表](#二-数据处理记录列表)
  - [操作 01：清除文件名含小括号的转存重复副本 (2026-09-16)](#操作-01清除文件名含小括号的转存重复副本-2026-09-16)

---

## 一、 数据集初始概况

数据集由两种采集源组成：
1. **RealSense D435i 深度相机数据集 (`citrus_dataset/`)**
   - 包含 15 个正常 session 和 1 个废弃测试 session (`Wrongsession_20251206_080217`)；
   - 每个样本包含：
     - `color/<timestamp>.png`（1280×720 RGB 图像）；
     - `depth_raw/<timestamp>.png`（16-bit 原始深度图，单位 mm，与 color 严格对齐）；
     - `depth_viz/<timestamp>.jpg`（伪彩色可视化图）；
     - `camera_intrinsics_1280x720.json`（对齐后的相机内参）。
2. **iPhone 数据集 (`iphone数据集/`)**
   - 包含 `上午/`、`中午/`、`备用的记录图片/`；
   - 包含高分辨率 HEIC、DNG (RAW)、JPG 及少量工作记录视频 MOV。

---

## 二、 数据处理记录列表

### 操作 01：清除文件名含小括号的转存重复副本 (2026-09-16)

#### 1. 处理前状况
在从存储介质多次复制或转存时，部分文件被系统自动重命名生成了形如 `xxx(1).png`、`xxx(2).png`、`xxx(3).png` 或 `xxx(1).jpg` 的冗余副本文件。
- **排查统计**：
  - 共扫描到 **82 个**符合 `\(\d+\)` 命名特征的文件；
  - 其中 `.png` 文件 **73 个**（分布在 `session_20251206_081423`、`session_20251206_091057`、`session_20251206_155039`、`session_20251206_161135` 的 `color` 和 `depth_raw` 文件夹）；
  - `.jpg` 文件 **9 个**（分布在 `session_20251206_132043` 和 `session_20251206_134957` 的 `depth_viz` 文件夹）；
  - 经比对抽样检验，副本文件与同目录下无括号原文件（如 `1764980161884.png`）的字节大小完全一致，确认均为冗余副本。

#### 2. 处理脚本与安全逻辑
- **执行脚本**：`scripts/remove_duplicate_parentheses.py`
- **安全拦截逻辑**：
  1. 正则匹配：严格匹配以 `(<数字>)` 结尾的文件名模式；
  2. 原文件存在性核验：在执行删除 `filename(N).ext` 前，必须核验同级目录下是否存在 `filename.ext`（原始文件）；
  3. 文件大小比对：比对副本与正本大小，双重确保删除安全；若不存在正本，则立即跳过并告警，坚决避免误伤任何有效数据；
  4. 审计日志：逐个打印被清理文件的完整路径和释放空间。

#### 3. 处理后状况
- **执行时间**：2026-09-16
- **执行结果**：
  - 扫描发现：82 个符合 `\(\d+\)` 特征的副本；
  - 匹配原件：82 个副本均成功匹配到同名原始文件且大小一致；
  - 成功删除：**82 个**；
  - 跳过/异常：**0 个**；
  - 释放磁盘空间：**91.51 MB**；
- **状态验证**：再次全局检索带括号文件，返回值归零（0 个），数据集已彻底清除此类冗余副本。

---

### 操作 02：数据集标准化提取、等步长抽样与索引映射 (2026-09-16)

#### 1. 处理前状况
- **原始数据源保持只读保护**：
  - D435i 数据集包含 15 个有效 session，共计 12,400+ 组连续采样图片，相邻帧间视觉冗余度极高；
  - iPhone 数据集包含上午、中午、下午三个时间段，存在大量成对的 HEIC 与 DNG (Apple ProRAW) 格式，且混杂视频 MOV 与元数据 AAE 文件；其中上午与中午存在部分只有 DNG 而缺失 HEIC 的样本。
- **痛点**：标注工具（如 X-AnyLabeling）无法直接混合处理复杂多级目录、难以原生预览 ProRAW DNG 文件，且直接对万张连续冗余帧标注耗时耗力。

#### 2. 处理脚本与转换逻辑
- **执行脚本**：`scripts/extract_and_preprocess_dataset.py`
- **输出独立目录**：`/Users/bohn/04_Project/05_Orange/MyOrangeDataset/processed_for_annotation/`
- **核心算法与处理逻辑**：
  1. **零破坏只读抽取**：原始目录完全未改动，抽取后的样本统一归集在新建的 `processed_for_annotation/images/` 扁平图片池中；
  2. **D435i 等步长抽样 (Step=5)**：
     - 自动剔除 `Wrongsession_*`；
     - 每 5 帧提取 1 帧，在保留全光照、全姿态多样性的同时，去除 80% 的高频静态冗余帧；
     - 命名规范：`d435i_s<session编号>_<timestamp>.png`；
     - **3D 深度与内参关联**：在 `metadata/sample_manifest.json` 中逐帧记录原始 16-bit `depth_raw` 文件绝对路径及归档内参 JSON，保证后续 2D 实例分割 Mask 能够无缝反投影为真实 3D 空间坐标；
  3. **iPhone 特写多格式保真转换**：
     - 过滤所有 MOV 视频及 AAE 文件；
     - 针对每一组独立画面（stem），优先提取 `HEIC` 转为 JPEG，缺失 HEIC 时自动由 `DNG` 兜底解码转换，确保每个画面只生成单张高保真 `.jpg`，绝无重复；
     - 调用 macOS 原生 Apple Silicon 硬件加速工具 `sips`（质量 90% 高保真转码）；
  4. **纯背景负样本入库（黄金比例）**：
     - 纳入上午、中午、下午的纯树枝树叶图片（共 251 张），命名为 `iphone_<时段>_negative_<stem>.jpg`；
     - 占总数据集的 6.0%，符合 YOLO 官方推荐的 5%~10% 背景负样本比例，用于专门抑制“反光叶片/树枝断面误切”；
  5. **元数据与配置生成**：
     - 生成样本索引清单 `metadata/sample_manifest.json`；
     - 归档 15 个 session 相机内参至 `metadata/d435i_intrinsics/`；
     - 自动写入 YOLOv8/v11 实例分割配置模板 `dataset.yaml`。

#### 3. 处理后状况
- **执行时间**：2026-09-16
- **产出统计**：
  - **总标注候选图片**：**4,164 张**（纯净扁平图片池）
  - **D435i RGB (带深度映射)**：**2,634 张**（来自 15 个 session 覆盖全光照与多视角）
  - **iPhone 果梗/果皮连接特写**：**1,279 张**（高分辨率细节，为旋切刀具进刀法向标注提供关键特征）
  - **iPhone 树枝树叶纯负样本**：**251 张**（占比约 6.0%）
  - **转换失败/丢帧**：**0 张**（100% 成功）
- **磁盘占用与位置**：
  - 输出目录占用空间：**8.4 GB**（宿主磁盘剩余容量仍有 90+ GB，安全宽裕）
  - 图片目录路径：`/Users/bohn/04_Project/05_Orange/MyOrangeDataset/processed_for_annotation/images`
  - 索引文件路径：`/Users/bohn/04_Project/05_Orange/MyOrangeDataset/processed_for_annotation/metadata/sample_manifest.json`
