BohnChen/PickOrangeDummy/docs/DummyArm_for_VENTUNO/0_先读我_项目总纲.md

# Dummy 机械臂项目 · 交接总纲（VENTUNO Q 上运行的 opencode 请先读我）

> 生成时间：2026-09-03
> 生成位置：在 Mac 上整理生成，供拷贝到 VENTUNO Q 板使用
> 用途：让 VENTUNO Q 上新开的 opencode 实例在最短时间内掌握「主人是谁、在做什么项目、要做到什么程度、下一步是什么」。
> 工作约定：回复使用中文，简洁、直接、可执行；需要细节时按第 2 节的索引去读对应文件，涉及主人的知识时引用来源。

---

## 1. 主人是谁

- 姓名：陈泌丞（GitHub：BohnChen）
- 所在地：杭州（必须留在杭州，求职也限杭州）
- 身份：硕士研究生在读（浙江农林大学 · 农业工程与信息技术），2027 年毕业，可全职实习或直接工作
- 求职方向：机器人软件工程师 / ROS2 C++ / Linux C++ 应用开发，当前处于「边投简历边做项目」并行状态
- 已有技术底子：C/C++（含多年真实商业 C++ 工作经历）、Linux 网络/多线程、ROS2（话题/服务/Action/URDF/Gazebo/RViz2）、嵌入式（ESP32/GD32/树莓派/香蕉派 等）、Python、PMP
- 完整个人档案：见 `2_对话记录/关于我.md`（建议让它成为你的长期记忆锚点）

## 2. 这个项目是什么（一句话版）

把一台复刻的 **Dummy 超紧凑六轴机械臂**（基于 peng-zhihui 开源的 Dummy-Robot）建设成**可复用的 ROS2 + RGB-D 视觉抓取 / 操作 / 学习实验平台**；远期服务于主人毕业课题——「面向低位果实采摘的自主移动机器人」（六轴机械臂 + RGB-D 相机 + 移动底盘）。

项目同时有两条并行主线：

1. **技术主线（第一版验收）**：桌面目标「检测 → 求位姿 → 规划 → 抓取 → 放到指定位置」的完整经典闭环（详见 `1_规划文档/DummyArm-ROS2-Grasp-项目蓝图.md`）。
2. **求职展示线**：把该机械臂做成可展示、可测试、可解释的工程「ROS2 机械臂任务执行与安全监控系统」，作为投递机器人/ROS2 岗位的项目证据（详见 `1_规划文档/求职投递与项目并行计划.md`）。

## 3. 核心技术基线（蓝图要点摘要）

- 机械臂：6 关节全为旋转关节（Pieper 判据构型）；电机 + 减速器 + 绝对值编码器；ref-controller（GD32）负责底层控制。
- 分层职责（硬实时下沉到 MCU，不放进 Linux）：
  - MCU（GD32）：电机闭环、编码器、限位、急停、看门狗、故障码
  - `ros2_control`：机械臂以 `SystemInterface` 暴露，统一硬件抽象
  - MoveIt 2：IK、碰撞、规划、轨迹执行
  - 感知：RGB-D 同步、检测/分割、目标 3D 位姿（第一版相机为 eye-to-hand 外部固定支架）
  - 任务层：pick/place 状态机或行为树、超时/重试/恢复
  - 学习层（后期）：模仿学习 / RL，只输出受限的 TCP 增量或技能参数，不得绕过安全层直控电机
- 接口约定：优先复用标准话题/接口；自定义高层接口仅 `PlanGrasp.action`、`PickPlace.action` 两个；统一 REP-103（米、弧度、右手系），TF 树 `world → base_link → … → tool0 → tcp`，`base_link → camera_link`。
- 工作空间结构（规划包名）：`dummyarm_ros2_grasp/src/` 下含 description / hardware / bringup / moveit_config / interfaces / perception / grasp_planner / task / calibration / sim / data / learning / w4d_integration。
- 仿真栈：主线 Gazebo Fortress + `ros_gz`/`gz_ros2_control`；早期用 MoveIt 2 FakeSystem 验证 URDF/规划组；学习后期才上 Isaac Lab / MuJoCo；URDF/Xacro 是单一模型源，不要同时维护多套资产。
- 四层仿真成熟度：运动学（FakeSystem）→ 动力学（Gazebo）→ 感知 → 学习。
- 第一版 ROS 图：单机运行全部真机节点，GD32 为非 ROS 实时从控，开发机经局域网看 RViz/日志。

> 以上是 2026-07-29 规划的基线。请结合现场实物与文件 `1_规划文档/DummyArm-ROS2-Grasp-项目蓝图.md`（407 行，最完整）一起判断取舍。

## 4. 硬件环境（蓝图建议 vs 现场现状，以现场核实为准）

| 角色 | 蓝图原建议 | 说明 |
|---|---|---|
| ROS2 主执行主机 | QCS8550 FV04 | 跑 Humble + MoveIt2 + 任务层 + 视觉推理；CPU 推理兜底，后期考虑 QNN/SNPE |
| 实时关节控制器 | GD32 / ref-controller | 闭环/限位/急停/看门狗；与主机 USB-CDC/UART/CAN 通信 |
| RGB-D 相机 | RealSense D435i | 第一版 eye-to-hand 外支架固定；彩色深度对齐后再反投影 |
| 开发机 | Mac（M4 Max） | 代码/文档/数据检查/标注；Ubuntu 22.04 VM 做 ROS2 构建与轻仿真 |
| 移动底座 | W4D 小车 | 第二阶段接入，移动到位→锁止→抓取串行 |
| **新出现** | **VENTUNO Q 板** | 已装 Linux（可 SSH/tmux）与 opencode；能否承担 ROS2 Humble / 部分节点 / 远程终端，需现场核实系统与架构 |

## 5. 当前已知状态（截至 2026-09-03）

- **已有/在手**：
  - Dummy 机械臂 V2 全套资料（硬件/固件/3D 模型/BOM/使用指南）在 Mac 上，多份拷贝（见 `3_资源地图.md`）
  - 柑橘 RGB-D 数据集已采集 14,000+ 份（D435i + iPhone Halide）
  - 第一发明人授权发明专利 1 项（机械臂控制方法），末端执行器专利申请中
  - ROS2 学习与面试资料体系已建立；GitHub 博客有 ROS2 学习记录
  - 求职投递与项目并行计划已定稿并在执行
- **缺口/待办**：
  - `1_规划文档/DummyArm-硬件参数采集表.md` 基本未填——这是进入 ROS2 配置（URDF/限位/减速比）的前提
  - `dummyarm_ros2_grasp` 工作空间尚未在任一机器上建成（蓝图仍只是规划）
  - graspnet_deploy 相关目录/脚本存在但未验证可运行
  - VENTUNO Q 上是否已有 ROS2 / 相机 / 串口权限 / 机械臂固件对接，未知
- 到 VENTUNO 后第一步建议：先让 opencode 与主人核对现场（系统、架构、已装软件、外设、代码是否已拷过去），再决定从哪里开工。

## 6. 你（在 VENTUNO 上）要做的任务

> ⚠️ 占位说明：本段需要主人在 VENTUNO 上正式开工前，把「这次到底要做什么」补充进来。下面是主人可选的起始 prompt 模板：

- 模板 A（先补参数）：读 `1_规划文档/DummyArm-硬件参数采集表.md`，对照现场机械臂和资料，帮我逐项填写并确认下一步 ROS2 配置要哪些值。
- 模板 B（先搭工程）：基于 `DummyArm-ROS2-Grasp-项目蓝图.md`，在当前环境帮我从 URDF/Xacro + FakeSystem 起步，搭 `dummyarm_ros2_grasp` 工作空间骨架并跑通运动学仿真。
- 模板 C（远程/边端角色）：这台 VENTUNO Q 板打算承担什么角色（终端/日志/边端节点/仿真机）？先帮我把它的环境摸清楚并写一份部署建议。
- 模板 D（交接确认）：把本包文件都看一遍，然后向我提问直到你确认完全理解项目，再输出一份你理解的项目一句话摘要 + 你认为的第一步。

## 7. 资料索引（本包内文件何时读）

| 文件 | 何时读 |
|---|---|
| `0_先读我_项目总纲.md`（本文件） | 第一次对话，必读 |
| `1_规划文档/DummyArm-ROS2-Grasp-项目蓝图.md` | 做技术规划/架构/验收时，核心依据 |
| `1_规划文档/DummyArm-硬件参数采集表.md` | 进入 ROS2 配置前，需现场填写 |
| `1_规划文档/求职投递与项目并行计划.md` | 涉及求职节奏/项目里程碑取舍时 |
| `1_规划文档/项目计划书*柑橘采摘*.txt` | 毕业课题立项级背景 |
| `1_规划文档/柑橘采摘机器人技术方案.md` | 场景与整机方案背景 |
| `1_规划文档/发明专利控制方法_*.md` | 涉及抓取/控制方法、专利表述时 |
| `2_对话记录/*` | 需要回看当时讨论过程/结论来源时 |
| `3_资源地图.md` | 需要代码/资料在 Mac 上的位置与拷贝命令 |
| `4_来源清单.md` | 追溯本包每个文件的原始出处 |

**注意**：本包只含规划文档与对话记录，**不含任何代码**。若要在 VENTUNO 上直接写代码/仿真，请按 `3_资源地图.md` 把相关代码目录另行拷贝过去。
