BohnChen/PickOrangeDummy/docs/DummyArm_for_VENTUNO/3_资源地图.md

# 资源地图：代码与资料在 Mac 上的位置（未随本包拷贝）

> 本包（DummyArm_for_VENTUNO）**只含规划文档与对话记录**，不含代码。
> 需要在 VENTUNO Q 上直接开发/仿真时，请从 Mac 按下面的路径另行拷贝。
> 拷贝建议在 Mac 上执行（`user`/`IP` 按 VENTUNO Q 实际填写）。

---

## A. Dummy 机械臂本体（必拷，体积较大）

| 路径 | 说明 | 建议 |
|---|---|---|
| `/Users/bohn/04_Project/02_My_Dummy/dummy` | 主人的实际工作副本：`firmware/` `hardware/` `ros2/` `simple-cli/` `esp32-iot/` `3d-model/` `harmonic_reducer/` `bom/` 等 | **优先拷贝**（含 ROS2/固件，是开发主力） |
| `/Users/bohn/04_Project/02_My_Dummy/Dummy-Robot`、`Dummy-Robot-main` | Dummy-Robot 官方 V2 仓库克隆（含 .git 与 submodule 配置） | 需要 git 历史/官方结构时拷贝 |
| `/Users/bohn/Dummy-Robot` | 2026-09-02 在 home 新建的 fresh clone | 可选（与上同源） |
| `/Users/bohn/04_Project/02_My_Dummy/任同学版本资料`、`小宅资料` | 任同学/小宅整理的 Dummy V2 资料（Hardware/Firmware/Model 整理版） | 参考 |
| `/Users/bohn/04_Project/02_My_Dummy/importantparamsfiles` | 重要参数文件 | 参考 |
| `/Users/bohn/Documents/DummyRes/1.Dummy_V2_ren` | 另一份 V2 资料：硬件源文件、`6.Docs`、`dummy使用指南v1.3.pdf`、LICENSE | 查文档/PDF 时拷 |

## B. 课题与论文（采摘机器人）

| 路径 | 说明 |
|---|---|
| `/Users/bohn/Documents/Huaxu` | 论文、`论文图表实验公式整理.md`、两份项目计划书 .txt |
| `/Users/bohn/04_Project/07_嵌入式学习/HuaXu/graspnet_deploy` | graspnet 抓取部署/仿真目录（`start_graspnet_sim.sh`、`run_all.sh`、`graspnet_ros` 等） |

## C. ROS2 学习与旧源码

| 路径 | 说明 |
|---|---|
| `/Users/bohn/04_Project/04_ROS` | ROS 学习源码：`catkin_ws`、MoveIt config 包、`仿真控制和算法的源码` 等（多为 ROS1/早期） |
| `/Users/bohn/ros2_ws` | ROS2 工作区雏形（目前基本为空） |
| `/Users/bohn/04_Project/06_MyWeb/BohnChen.github.io/content/posts/StudyRecord/ROS2` | GitHub 博客里的 ROS2 学习/面试笔记（含 Dummy 机械臂项目问答） |

## D. 知识库与历史（在 Mac 本地）

| 路径 | 说明 |
|---|---|
| `/Users/bohn/Documents/ObsidianFolder/AINote` | 本地知识库：`conversations/`（全量对话归档）、`keysPattern/`（各 AI 产出文档）、`resume/` |
| `/Users/bohn/Documents/ObsidianFolder/AINote/conversations/关于我.md` | 主人个人/项目档案（已拷入本包 `2_对话记录/`） |
| `/Users/bohn/.local/share/opencode/opencode.db` | opencode 全量历史会话（64 个，仅存 Mac 本地，本包未含） |

## E. 拷贝示例命令（在 Mac 上执行）

```bash
# 机械臂工作副本（最常用）
scp -r /Users/bohn/04_Project/02_My_Dummy/dummy user@VENTUNO_IP:~/DummyArm/

# 交接文档包
scp -r /Users/bohn/Documents/DummyArm_for_VENTUNO user@VENTUNO_IP:~/

# 若网络好、要更稳，用 rsync
rsync -avz /Users/bohn/04_Project/02_My_Dummy/dummy user@VENTUNO_IP:~/DummyArm/
```

拷贝时请按需取舍；`02_My_Dummy` 整个目录较大（约 180MB+），不必整目录搬。
