BohnChen/PickOrangeDummy/docs/DummyArm_for_VENTUNO/2_对话记录/codex/2026-07-17_我需要将我的项目按照特定要求进行阐述_在阐述前_我会告诉你这是一个什么项目_以及.md

---
tool: codex
session_id: rollout-2026-07-17T15-00-01-019f6ee0-0022-7591-93b7-8e0b922e2e9e
date: 2026-07-17 15:00
updated: 2026-07-17 16:16
source: .codex/sessions/2026/07/17/rollout-2026-07-17T15-00-01-019f6ee0-0022-7591-93b7-8e0b922e2e9e.jsonl
---

# 我需要将我的项目按照特定要求进行阐述，在阐述前，我会告诉你这是一个什么项目，以及

> 工具: codex · 会话: rollout-2026-07-17T15-00-01-019f6ee0-0022-7591-93b7-8e0b922e2e9e

## 2026-07-17 15:00 用户

我需要将我的项目按照特定要求进行阐述，在阐述前，我会告诉你这是一个什么项目，以及已经取得了什么进展，最后我会给你阐述的要求。

那么首先，这是一个自动化低位柑橘采摘机器人。
本项目并不针对所有的采摘场景，而是使用机械臂对果实高度小于 1米的柑橘果实进行采摘，以帮助果农减少弯腰采摘的动作，提高柑橘的整体采摘效率。
本项目的目标是做出一款可以在柑橘果园的采摘场景中自主运动并自主完成低空柑橘采摘的机器人，可以减少人工采摘的弯腰采摘动作，提高柑橘的整体采摘效率，项目的性能目标是该机器人对低空的成熟柑橘可以达到 80%的采摘成功率，满足为采摘工人分忧的目标。在商业化领域，该机器人第一可以作为单体售卖或者租赁给大型柑橘合作社或者大型果园，第二可以采集采摘优质数据售卖或者继续进行采摘机器人的优化和强化学习训练。 
目前，我已经获得了一项与其有关的采摘控制方法发明专利，已经调试好了高精度小巧机械臂dummy-robot，自行设计好的末端执行器已经在着手申请实用新型专利，也已经使用inter d435i相机去台州三门县采集了 14000 余张带有深度信息的RGB-D数据集。

我自己写的一些技术路线供你参考，请你实事求是，不必迎合我：
技术路线阐述 
其执行的总体流程应该是“自主寻路->靠近目标->检测成熟果实->抓取->收集->移动至下一目标”，这些过程包含以下四个部分 
1. 感知与环境建模
通过intel D435i深度相机，结合主流的目标识别算法，比如 Yolo， Faster R-CNN 完成目标识别，通过 MobileNet，ResNet 完成对果实的成熟度检测，并结合深度图进行空间定位，拿到空间坐标，下发给机械臂。 2.	自主导航和移动系统
通过 A*或者 RRT 算法进行动态的路径规划，并能够实时调整路径，以应对果园环境中的人，树，杂草等障碍
3.	采摘决策系统
综合感知系统的信息，判断哪些为可采摘目标，并完成采摘顺序规划，接着依次将采摘指令下发给机械臂采摘系统
4.	机械臂采摘控制系统
拿到决策系统指令的 Dummy 机械臂根据目标的位置和周围的环境状况，自动进行路径的规划和位姿的估计，结合末端执行器进行采摘，将果子放入收集处完成采摘。

关于硬件选型：项目打算采用广翼智联 FV04 （犀牛派 X1）作为大脑，总控机械臂执行单元、视觉识别单元以及小车的移动单元；但是作为技术架构专家，你可以帮我提一下意见，我手头已经有了一块广翼智联 X1，应该可以再申请一块“Arduino VENTUNO Q: 搭载高通跃龙™ IQ-8275处理器”，你可以决定硬件的用处。选择dummy作为执行机械臂，是因为它的成本较低，精度较高且体型小巧，适用于我们“采集低位果实”、穿梭于密集果园的场景需求。

项目描述的要求如下：
*1.项目可行性阐述：介绍参赛项目的项目目标、核心亮点、功能性能，表明项目先进性或与目前已有方案差异性等内容；*
*2.项目完整阐述：介绍机器人设计理念与介绍参赛项目用于什么场景、满足什么需求、形成什么产品、实现什么功能、提供什么服务、面向什么市场，以及商业化想法及所需支持等；*
*3.技术路线阐述：项目将运用哪些关键技术（如具身智能算法、机器人控制、感知融合、端侧AI部署等），说明项目实施进度规划等，进行原理阐述，若有前期预研成果可进行展示；*
*4.硬件选型说明：说明项目所采用的硬件平台（如高通芯片平台、开发板型号等），预用传感器、舵机等硬件型号，以及如何充分发挥硬件性能优势；*

## 2026-07-17 15:00 助手

我会先核实两块开发板的公开规格，再把内容整理成可直接用于申报书的四部分；同时会明确区分“已完成成果”和“计划指标”，避免把预研写成既成能力。为了核对硬件信息，我将使用浏览器检索其官方资料。

## 2026-07-17 15:01 助手

硬件核对发现一个需要纠正的点：公开资料把“广翼智联 FV04”和“犀牛派 X1”列为两款不同设备，并非同一型号。我再核实两者平台后，会在正文中给出不冒进的选型建议。

## 2026-07-17 15:07 助手

下面给出一版可直接用于项目申报书或答辩材料的正式阐述。内容区分了“已完成成果”“规划功能”和“目标指标”，并对原技术路线作了必要修正。

# 项目名称建议

**面向低位柑橘采摘的自主移动机器人**

副标题可采用：**聚焦1米以下成熟果实的人机协同采摘解决方案**

---

# 一、项目可行性阐述

## 1. 项目目标

本项目面向柑橘果园中重复频繁、劳动负担较重的低位采摘环节，研发一款能够在果园中自主移动、自主识别成熟柑橘并完成机械臂采摘和果实收集的移动机器人。

项目不追求覆盖整棵果树，而是将作业范围明确限定为**果实高度低于1米、处于机械臂可达空间且具备合理采摘条件的成熟柑橘**。机器人承担需要果农频繁弯腰完成的低位采摘任务，高位、严重遮挡及复杂枝叶区域仍由人工处理，从而形成“机器人负责低位重复劳动、人工负责复杂目标”的人机协同模式。

项目性能目标为：在真实果园条件下，对机器人判定为可采摘的低位成熟柑橘，实现不低于**80%的采摘成功率**。

建议将“采摘成功”统一定义为：机器人完成目标识别、定位、接近、果实分离，并将果实完整送入收集装置。测试时还应同时记录可采目标覆盖率、果实损伤率、单果采摘时间和连续作业时间，避免仅以成功率评价系统。

## 2. 核心亮点

第一，项目采用“聚焦低位、解决痛点”的产品定位。与试图覆盖整株果树的大型采摘机器人相比，本项目不盲目追求大臂展和全场景适应能力，而是针对果农弯腰频繁、低位作业疲劳度高的问题进行专项设计，有利于降低机械结构复杂度、整机尺寸和产品成本。

第二，项目已形成真实果园数据基础。团队已使用Intel RealSense D435i在浙江台州三门县采集超过14000张带深度信息的RGB-D柑橘图像，可用于成熟度识别、果实检测、遮挡分析和三维定位算法开发。相比仅使用公开二维图像数据，真实果园RGB-D数据更贴近最终应用环境。

第三，项目具备“感知—决策—执行—反馈”的具身智能闭环。机器人不是简单地识别果实或遥控机械臂，而是根据视觉和空间信息自主判断可采摘目标、规划移动与机械臂动作，并根据采摘结果调整后续任务。

第四，项目具有一定知识产权和硬件预研基础。目前已取得一项与采摘控制方法相关的发明专利；高精度、小型化Dummy Robot机械臂已完成调试；自主设计的末端执行器正在申请实用新型专利。上述成果降低了项目从概念验证进入系统集成阶段的风险。

第五，项目可以形成持续迭代的数据闭环。机器人在作业过程中可记录果实图像、深度、遮挡情况、机械臂轨迹和采摘结果，在取得果园授权并完成数据脱敏的前提下，用于模型迭代、失败案例分析以及后续模仿学习或强化学习研究。

## 3. 可行性依据

项目具备较好的可行性基础：

- 应用范围经过主动收缩，只处理1米以下且机械臂可达的目标，减少了机械臂行程、底盘稳定性和全树冠覆盖方面的难度。
- 已完成机械臂调试、末端执行器设计和真实果园数据采集，具备从单模块向整机系统集成的条件。
- YOLO类检测与分割模型、RGB-D定位、ROS 2导航、MoveIt 2机械臂规划等技术已经具备较成熟的工程基础。
- QCS8550和IQ-8275等端侧平台具备视觉模型推理、机器人规划和多传感器接入能力，能够支持机器人离线运行。

项目的主要技术风险包括强光下深度相机性能下降、枝叶遮挡、果实摆动、机械臂碰撞、复杂地面通行和末端采摘损伤。项目将通过深度置信度筛选、多帧融合、近距离二次定位、机械臂视觉伺服、碰撞检测和分阶段果园测试等方式逐步解决。

---

# 二、项目完整阐述

## 1. 设计理念

项目遵循四项设计理念：

- **聚焦低位：**只承担1米以下成熟柑橘采摘，避免过度追求全树覆盖。
- **人机协同：**机器人减少弯腰动作，不以完全取代人工为目标。
- **闭环作业：**每次采摘均包含感知、决策、执行和结果确认。
- **低成本小型化：**采用小型机械臂和窄体移动底盘，适应果树间距有限、枝叶密集的果园环境。

## 2. 应用场景和需求

项目主要应用于具有一定通行条件的柑橘果园，尤其是种植规模较大、低位果实较多、人工采摘成本较高的合作社和规模化果园。

机器人沿果树行间自主移动，在检测到低位成熟果实时停车或低速调整位置，选择可采目标，依次完成定位、采摘和收集。机器人不处理严重遮挡、超出机械臂工作空间或可能造成碰撞的果实，而是将其标记后留给人工处理。

## 3. 产品形态

项目最终形成一套由以下部分组成的低位柑橘采摘机器人：

- 窄体自主移动底盘；
- 小型高精度Dummy Robot机械臂；
- 自主设计的柑橘采摘末端执行器；
- RGB-D果实感知系统；
- 激光雷达、IMU、编码器等导航传感器；
- 端侧AI计算与实时控制平台；
- 果实收集装置；
- 任务管理、数据记录及远程运维软件。

## 4. 主要功能

机器人计划实现以下功能：

1. 果园行间自主导航和动态避障；
2. 低位柑橘检测、成熟度识别和三维定位；
3. 机械臂可达性、遮挡程度和碰撞风险判断；
4. 多目标采摘顺序规划；
5. 机械臂自主运动规划和近距离视觉修正；
6. 末端执行器完成果实分离和收集；
7. 采摘结果确认、失败重试和异常目标跳过；
8. 采摘数量、作业位置、图像和失败原因记录；
9. 急停、人员避让、通信异常保护和安全停车。

## 5. 市场与商业化路径

项目首要客户为大型柑橘合作社、规模化果园、农业社会化服务组织和农业科研示范基地。

商业化可分为三个阶段：

- **样机验证阶段：**与合作果园开展联合测试，按作业季进行示范应用。
- **产品导入阶段：**提供整机销售、季节性租赁和按作业量收费的采摘服务。
- **数据服务阶段：**在获得合法授权的前提下，提供果实成熟度分析、产量估计、作业报告和模型优化服务。

相比单纯售卖原始数据，更建议将数据商业模式表述为“提供经过授权的农业数据分析和模型服务”。原始果园数据涉及所有权、商业隐私和人员影像，直接售卖存在较高合规风险。

## 6. 所需支持

项目后续需要获得以下支持：

- 不同品种、树形和光照条件下的长期果园测试场地；
- 高通端侧AI工具链、模型量化和NPU部署支持；
- 机械臂、底盘与末端执行器的可靠性测试条件；
- 结构防尘、防水、散热和振动设计支持；
- 小批量制造、供应链和成本控制支持；
- 合作社试点、农业专家评价和商业渠道资源。

---

# 三、技术路线阐述

机器人总体作业流程为：

**任务下发 → 果园自主导航 → 低位果实搜索 → 成熟度识别与三维定位 → 可采摘性判断 → 底盘位置调整 → 机械臂规划 → 近距离视觉修正 → 采摘与收集 → 结果确认 → 前往下一目标**

## 1. 感知与环境建模

机器人使用Intel RealSense D435i获取RGB图像、深度图和惯性信息。

算法上不建议简单罗列“YOLO、Faster R-CNN、MobileNet、ResNet”。工程实现中可优先采用一个轻量化检测或实例分割模型，同时输出果实位置、成熟度类别和果实轮廓。实例分割比单纯矩形框更有利于处理果实重叠、枝叶遮挡和采摘点选择。

系统将检测结果与深度图对齐，对果实区域进行深度异常值剔除和多帧滤波，获得果实三维中心或适宜采摘点。通过相机标定、机械臂手眼标定和坐标变换，将相机坐标转换为机械臂基坐标，供后续运动规划使用。

D435i依赖主动红外深度技术，在强烈阳光下可能出现深度空洞或噪声。因此应设置深度置信度判断，并通过靠近后二次观测、多帧融合和RGB几何估计提高可靠性。条件允许时，可增加双目相机或其他室外深度传感器作为后续升级方案。

## 2. 自主导航与移动

底盘导航建议采用ROS 2和Nav2架构。激光雷达、轮式编码器、IMU和视觉信息经过融合后完成定位与地图构建。

全局路径规划可以使用A*或Hybrid A*，局部避障使用DWB、TEB或MPPI等局部规划方法，根据人员、树干、枝叶和临时障碍实时调整速度和行驶方向。

RRT更适合机械臂在高维关节空间中的避障规划，不建议将“A*或RRT动态导航”作为统一表述。移动底盘应采用“全局规划+局部避障”，机械臂则采用MoveIt 2结合OMPL、RRT-Connect等算法完成关节空间规划。

## 3. 采摘决策系统

采摘决策模块综合以下信息判断目标是否可采：

- 成熟度置信度；
- 果实高度和三维位置；
- 机械臂可达性；
- 枝叶遮挡程度；
- 末端执行器操作空间；
- 预计碰撞风险；
- 底盘是否需要进一步调整。

系统根据机械臂移动距离、目标可达性和遮挡风险对多个果实进行评分，优先采摘成功概率较高、运动代价较低的目标。

系统控制逻辑可采用行为树或分层状态机实现。现阶段不必强行使用大模型或强化学习；首先建立可解释、可复现的模块化闭环更加可靠。积累足够的成功与失败数据后，再使用模仿学习或强化学习优化目标排序、底盘停靠位置和机械臂轨迹。

## 4. 机械臂采摘控制

Dummy Robot机械臂接收目标位姿后，首先完成可达性检测和碰撞检查，再规划预抓取位姿和接近路径。

在机械臂接近果实时，系统使用视觉伺服进行二次位置修正，以减小相机深度误差、果实摆动和机械结构误差带来的影响。末端执行器按照既定的夹持、分离或切断方式完成采摘，并将果实送入收集装置。

采摘完成后，系统通过末端传感器、视觉变化或果实收集检测确认是否成功；失败时可进行有限次数的重新定位和重试，超过阈值后自动跳过并记录原因。

## 5. 端侧AI部署

模型训练在工作站或服务器完成，机器人端主要负责推理。训练后的模型经过剪枝、量化和硬件适配，转换为ONNX或高通平台支持的模型格式，在NPU上运行；CPU负责ROS 2节点、任务调度和路径规划，GPU可用于图像预处理和几何计算。

这种分工能够降低推理延迟和网络依赖，使机器人在果园无线网络不稳定时仍可独立工作。

## 6. 实施进度规划

- **前期预研——已完成：**采摘控制方法发明专利、Dummy Robot机械臂调试、末端执行器设计、14000余张RGB-D数据采集。
- **第1—2个月：**数据清洗与标注，建立成熟度识别、实例分割和三维定位基线，完成端侧推理部署。
- **第3—4个月：**完成手眼标定、机械臂规划、视觉伺服、末端执行器和收集装置联调。
- **第5—6个月：**完成移动底盘、定位建图、行间导航、动态避障和安全控制。
- **第7—8个月：**完成行为树、目标排序、底盘与机械臂协同，形成整机闭环样机。
- **第9—10个月：**开展真实果园测试，对强光、遮挡、坡地和果实摆动等问题进行专项优化，验证80%采摘成功率目标。
- **第11—12个月：**完成可靠性、连续作业、维护成本和小批量制造评估，推动合作果园试用。

---

# 四、硬件选型说明

## 1. 端侧计算平台

需要先纠正一个型号问题：**广翼智联FV04和犀牛派X1不是同一设备。**

广翼智联FV04采用高通跃龙QCS8550，公开资料标注48 TOPS综合算力、16GB LPDDR4X和128GB UFS；犀牛派X1由阿加犀开发，同样采用QCS8550，但属于另一款开发板。申报材料中应根据实际持有设备写作“广翼智联FV04”，不要写成“FV04（犀牛派X1）”。

### 当前可落地方案

现阶段使用已有的**广翼智联FV04**作为整机上位控制器，承担：

- RGB-D数据处理；
- 柑橘检测、成熟度识别和三维定位；
- ROS 2任务管理；
- 底盘全局与局部路径规划；
- MoveIt 2机械臂运动规划；
- 数据记录和远程调试。

### 获得VENTUNO Q后的推荐方案

如成功申请Arduino VENTUNO Q，建议将其作为最终样机的核心控制平台：

- IQ-8275侧的CPU、GPU和NPU负责视觉模型推理、感知融合、地图、规划和决策；
- 板载STM32H5负责急停、看门狗、底盘速度闭环、CAN-FD通信、末端执行器时序和实时安全控制；
- FV04转为算法开发、数据处理、对照测试或备用平台，不建议在最终机器人上同时部署两块高算力主控，以免增加功耗、散热、通信延迟和故障点。

根据Arduino官方资料，VENTUNO Q提供最高40 dense TOPS NPU算力、16GB LPDDR5、64GB eMMC、USB相机支持、三路MIPI-CSI、CAN-FD以及ROS 2兼容能力，其“高性能计算单元+实时微控制器”架构较适合本项目的感知与执行闭环。但截至目前官方仍标注为“即将上市”，因此项目进度不能完全依赖其到货，FV04应继续作为可独立完成开发的基线平台。

## 2. 机械臂与末端执行器

采用已经完成调试的Dummy Robot小型机械臂。其成本、体积和精度与低位、窄空间采摘场景较为匹配。

正式申报前需要补充机械臂的准确型号、自由度、臂展、额定负载和重复定位精度，并验证额定负载能够覆盖“末端执行器重量+最大果实重量+动态安全余量”。

末端执行器采用团队自主设计方案，并根据具体结构配置限位、压力、光电、真空或电流反馈，用于判断接触状态和采摘结果。

## 3. 推荐传感器和执行硬件

- 果实感知：Intel RealSense D435i RGB-D相机；
- 导航感知：室外型2D激光雷达；预算充足时可升级为3D激光雷达；
- 运动状态：底盘轮式编码器、独立IMU；
- 安全感知：机械急停按钮、防撞条及近距离避障传感器；
- 移动底盘：窄体差速底盘、带编码器电机、支持CAN或RS-485的电机驱动器；
- 电源系统：动力、机械臂和计算单元分路供电，配置DC-DC转换、保险和电流监测；
- 通信系统：CAN/CAN-FD承担实时控制，USB连接RGB-D相机，以太网用于高速数据和调试。

## 4. 硬件性能发挥方式

视觉模型通过量化后部署到NPU，充分利用高通平台的端侧AI能力；图像预处理和多媒体任务由GPU、ISP协同完成；CPU运行ROS 2、行为树和规划算法；实时微控制器承担电机、急停和安全时序。

通过这种异构计算分工，可以避免将全部任务集中在CPU上，在保证识别速度的同时提高机械控制的确定性和整机安全性。

---

最后有四点建议务必修改：

1. 不要将FV04称为“犀牛派X1”，二者是不同产品。
2. 不要堆砌YOLO、Faster R-CNN、MobileNet、ResNet，应给出明确的算法选择逻辑。
3. 不要把RRT直接写成底盘动态导航算法，RRT更适合机械臂关节空间规划。
4. 80%成功率必须写清测试对象和成功定义，同时报告覆盖率，否则容易被评委质疑指标存在筛选空间。

硬件规格参考：[Arduino VENTUNO Q官方页面](https://www.arduino.cc/product-ventuno-q)、[高通开发硬件清单](https://qualcomm.csdn.net/hardware)。

## 2026-07-17 15:50 用户

犀牛派 X1 和Arduino VENTUNO Q，哪一款更适合这个项目呢？

## 2026-07-17 15:53 助手

结论：**从最终整机架构看，Arduino VENTUNO Q更适合；从当前快速落地和开发风险看，犀牛派X1更稳妥。**

| 对比项 | 犀牛派 X1 | Arduino VENTUNO Q |
|---|---|---|
| AI平台 | QCS8550，约48 TOPS INT8 | IQ-8275，最高40 dense TOPS |
| 实时控制 | 需要额外配置STM32等控制器 | 板载STM32H5，支持确定性实时控制 |
| 机器人接口 | 接口丰富，具体依版本确认 | CAN-FD、PWM、GPIO、USB相机、MIPI-CSI |
| 软件生态 | AidLux，现阶段较成熟 | Ubuntu/Debian、ROS 2、Arduino生态 |
| 供应风险 | 已有成熟产品，可立即开发 | 官方目前仍标注“即将上市” |
| 项目适配 | 更偏高算力端侧AI开发板 | 专门面向“AI感知+机器人动作控制” |

## 为什么VENTUNO Q更匹配

这个机器人不仅需要运行柑橘检测模型，还需要同时处理：

- D435i RGB-D数据和三维定位；
- 底盘导航与动态避障；
- 机械臂轨迹规划；
- 末端执行器时序；
- 急停、看门狗和通信异常保护。

VENTUNO Q的优势不是单纯算力，而是采用“双脑架构”：

- **IQ-8275**运行视觉模型、ROS 2、Nav2、MoveIt 2和采摘决策；
- **STM32H5**运行底盘速度闭环、急停、CAN-FD通信、末端执行器控制和安全状态机。

这正好对应机器人“高层智能计算”和“底层实时控制”的两类任务。X1虽然AI算力更高，但若要形成可靠整机，仍建议额外增加一块STM32控制板。

## 算力不是决定因素

不要简单认为“48 TOPS一定优于40 TOPS”。两种平台的TOPS统计口径、模型精度和工具链可能不同，不能直接横向比较。

对本项目而言，一个轻量化柑橘检测/分割模型加深度定位，40 TOPS已经足够。真正影响机器人表现的是：

- 模型能否顺利量化并部署到NPU；
- D435i驱动和ROS 2兼容性；
- 推理延迟是否稳定；
- 机械臂、底盘和传感器接口是否可靠；
- 实时控制和异常保护是否完善。

因此，VENTUNO Q板载实时微控制器带来的系统完整性，比两者数值上的算力差异更有价值。

## 最实际的选择方案

我的建议是：**当前样机继续使用犀牛派X1，申请到VENTUNO Q后用于最终整机。**

当前阶段采用：

```text
犀牛派X1
├── 柑橘检测与成熟度识别
├── RGB-D三维定位
├── ROS 2 / Nav2
├── MoveIt 2机械臂规划
└── 采摘行为树

外部STM32
├── 底盘速度控制
├── 末端执行器控制
├── 急停与看门狗
└── 传感器实时采集
```

最终版本采用：

```text
VENTUNO Q
├── IQ-8275：感知、导航、规划、决策
└── STM32H5：底盘、末端执行器、安全控制
```

这样既不耽误当前开发，也能在后期减少控制板数量、通信链路和系统故障点。

## 最终推荐

- **若现在必须选择一块并按期完成比赛样机：选择犀牛派X1。**
- **若可以获得稳定供货、完整SDK和技术支持：最终产品选择VENTUNO Q。**
- **不建议在最终机器人上同时安装两块高算力主控。**这会增加功耗、散热、软件同步和故障排查难度。

VENTUNO Q官方资料：[Arduino VENTUNO Q](https://www.arduino.cc/product-ventuno-q)。

## 2026-07-17 16:00 用户

现在请你查看我所有的内容，帮我梳理成一份我直接用在项目计划书上的内容，可以不用分太多段落，比如项目可行性阐述中，只需要有“项目可行性阐述”这个标题，然后项目目标、核心亮点、项目差异性这些内容，都放在“项目可行性阐述”中的单独段落就可以了。其他段落也是一样。
我的内容如下，请你修改完成后，给我一份文字文件：
项目名称：面向低位柑橘采摘的自主移动机器人
所选赛道：智能机器人 

项目详情：
1、项目目标
本项目面向柑橘果园中重复频繁、劳动负担较重的低位采摘环节，研发一款能够在果园中自主移动、自主识别成熟柑橘并完成机械臂采摘和果实收集的移动机器人。
项目不追求覆盖整棵果树，而是将作业范围明确限定为果实高度低于1米、处于机械臂可达空间且具备合理采摘条件的成熟柑橘。机器人承担需要果农频繁弯腰完成的低位采摘任务，高位、严重遮挡及复杂枝叶区域仍由人工处理，从而形成“机器人负责低位重复劳动、人工负责复杂目标”的人机协同模式。
项目性能目标为：在真实果园条件下，对机器人判定为可采摘的低位成熟柑橘，实现不低于80%的采摘成功率。
建议将“采摘成功”统一定义为：机器人完成目标识别、定位、接近、果实分离，并将果实完整送入收集装置。测试时还应同时记录可采目标覆盖率、果实损伤率、单果采摘时间和连续作业时间，避免仅以成功率评价系统。

2、核心亮点
第一，项目采用“聚焦低位果实采摘”的产品定位。与试图覆盖整株果树的大型采摘机器人相比，本项目不盲目追求大臂展和全场景适应能力，而是针对果农弯腰频繁、低位作业疲劳度高的问题进行专项设计，有利于降低机械结构复杂度、整机尺寸和产品成本。这也是本项目与其他项目的差异所在。
第二，项目已形成真实果园数据基础。团队已使用Intel RealSense D435i在浙江台州三门县采集超过14000张带深度信息的RGB-D柑橘图像，可用于成熟度识别、果实检测、遮挡分析和三维定位算法开发。相比仅使用公开二维图像数据，真实果园RGB-D数据更贴近最终应用环境。
第三，项目具备“感知—决策—执行—反馈”的具身智能闭环。机器人不是简单地识别果实或遥控机械臂，而是根据视觉和空间信息自主判断可采摘目标、规划移动与机械臂动作，并根据采摘结果调整后续任务。
第四，项目具有一定知识产权和硬件预研基础。目前已取得一项与采摘控制方法相关的发明专利；高精度、小型化Dummy Robot机械臂已完成调试；自主设计的末端执行器正在申请实用新型专利。上述成果降低了项目从概念验证进入系统集成阶段的风险。
第五，项目可以形成持续迭代的数据闭环。机器人在作业过程中可记录果实图像、深度、遮挡情况、机械臂轨迹和采摘结果，在取得果园授权并完成数据脱敏的前提下，用于模型迭代、失败案例分析以及后续模仿学习或强化学习研究。

二、项目完整阐述
1.设计理念
项目遵循四项设计理念：
聚焦低位：只承担1米以下成熟柑橘采摘，避免过度追求全树覆盖。
人机协同：机器人减少弯腰动作，不以完全取代人工为目标。
闭环作业：每次采摘均包含感知、决策、执行和结果确认。
低成本小型化：采用小型机械臂和窄体移动底盘，适应果树间距有限、枝叶密集的果园环境。
2.应用场景和需求
项目主要应用于具有一定通行条件的柑橘果园，尤其是种植规模较大、低位果实较多、人工采摘成本较高的合作社和规模化果园。
机器人沿果树行间自主移动，在检测到低位成熟果实时停车或低速调整位置，选择可采目标，依次完成定位、采摘和收集。机器人不处理严重遮挡、超出机械臂工作空间或可能造成碰撞的果实，而是将其标记后留给人工处理。
3.产品形态

项目最终形成一套由以下部分组成的低位柑橘采摘机器人：
窄体自主移动底盘；
小型高精度Dummy Robot机械臂；
自主设计的柑橘采摘末端执行器；
RGB-D果实感知系统；
激光雷达、IMU、编码器（超声波）等导航传感器；
端侧AI计算与实时控制平台（赛事方提供的电路板）；
果实收集装置；

4.主要功能
机器人计划实现以下功能：
果园行间自主导航和动态避障；
低位柑橘检测、成熟度识别和三维定位；
机械臂可达性、遮挡程度和碰撞风险判断；
多目标采摘顺序规划；
机械臂自主运动规划和近距离视觉修正；
末端执行器完成果实分离和收集；
采摘结果确认、失败重试和异常目标跳过；
采摘数量、作业位置、图像和失败原因记录；
急停、人员避让、通信异常保护和安全停车。

5.商业化想法
关于农业设备的商业化，我认为目前可以通过实地收集高质量数据来做商业化；是否进行整机售卖或者季节性租赁，要看地区的人力成本高低，在种植区域，人力成本低于机器费用很多。

6.所需支持
后续需要获得如下一些支持：
高通端侧AI工具链、模型量化和NPU部署支持；
小批量制造、供应链和成本控制支持；
识别模型训练资源支持；

技术路线阐述
机器人总体作业流程为：
任务下发 → 果园自主导航 → 低位果实搜索 → 成熟度识别与三维定位 → 可采摘性判断 → 底盘位置调整 → 机械臂规划 → 近距离视觉修正 → 采摘与收集 → 结果确认 → 前往下一目标
1. 感知与环境建模
机器人使用Intel RealSense D435i获取RGB图像、深度图和惯性信息。
采用一个轻量化检测模型，同时输出果实位置、成熟度类别和果实轮廓。实例分割比单纯矩形框更有利于处理果实重叠、枝叶遮挡和采摘点选择。
系统将检测结果与深度图对齐，对果实区域进行深度异常值剔除和多帧滤波，获得果实三维中心或适宜采摘点。通过相机标定、机械臂手眼标定和坐标变换，将相机坐标转换为机械臂基坐标，供后续运动规划使用。
D435i依赖主动红外深度技术，在强烈阳光下可能出现深度空洞或噪声。因此应设置深度置信度判断，并通过靠近后二次观测、多帧融合和RGB几何估计提高可靠性。条件允许时，可增加双目相机或其他室外深度传感器作为后续升级方案。
2. 自主导航与移动
底盘导航建议采用ROS 2和Nav2架构。激光雷达、轮式编码器、IMU和视觉信息经过融合后完成定位与地图构建。
全局路径规划可以使用A或Hybrid A，局部避障使用DWB、TEB或MPPI等局部规划方法，根据人员、树干、枝叶和临时障碍实时调整速度和行驶方向。
移动底盘应采用“全局规划+局部避障”，机械臂则采用MoveIt 2结合OMPL、RRT-Connect等算法完成关节空间规划。
3. 采摘决策系统
采摘决策模块综合以下信息判断目标是否可采：
成熟度置信度；
果实高度和三维位置；
机械臂可达性；
枝叶遮挡程度；
末端执行器操作空间；
预计碰撞风险；
底盘是否需要进一步调整。
系统根据机械臂移动距离、目标可达性和遮挡风险对多个果实进行评分，优先采摘成功概率较高、运动代价较低的目标。
系统控制逻辑可采用行为树或分层状态机实现。现阶段不必强行使用大模型或强化学习；首先建立可解释、可复现的模块化闭环更加可靠。积累足够的成功与失败数据后，再使用模仿学习或强化学习优化目标排序、底盘停靠位置和机械臂轨迹。
4. 机械臂采摘控制
Dummy Robot机械臂接收目标位姿后，首先完成可达性检测和碰撞检查，再规划预抓取位姿和接近路径。
在机械臂接近果实时，系统使用视觉伺服进行二次位置修正，以减小相机深度误差、果实摆动和机械结构误差带来的影响。末端执行器按照既定的夹持、分离或切断方式完成采摘，并将果实送入收集装置。
采摘完成后，系统通过末端传感器、视觉变化或果实收集检测确认是否成功；失败时可进行有限次数的重新定位和重试，超过阈值后自动跳过并记录原因。
5. 端侧AI部署
模型训练在工作站或服务器完成，机器人端主要负责推理。训练后的模型经过剪枝、量化和硬件适配，转换为ONNX或高通平台支持的模型格式，在NPU上运行；CPU负责ROS 2节点、任务调度和路径规划，GPU可用于图像预处理和几何计算。
这种分工能够降低推理延迟和网络依赖，使机器人在果园无线网络不稳定时仍可独立工作。

硬件选型：
机械臂采用dummy机械臂：采用已经完成调试的Dummy Robot小型机械臂。其成本、体积和精度与低位、窄空间采摘场景较为匹配。
末端执行器：末端执行器采用我自主设计的木质果梗果实采摘末端执行器，并根据后续的实验反馈做调整。
深度相机：采用intel d435i深度相机。这款相机应用较为广泛，生态良好。
导航感知部分：也许使用超声波传感器进行运动；视情况而定是否使用激光雷达
计算单元：我选用Arduino VENTUNO Q作为计算单元，因为此项目需要在运行柑橘检测模型的同时，处理D435i RGB-D数据和三维定位、底盘导航与动态避障、机械臂轨迹规划、末端执行器时序、急停、看门狗和通信异常保护。VENTUNO Q的“双脑架构”对本项目来说更具优势。我们可以使用IQ-8275运行视觉模型、ROS 2、Nav2、MoveIt 2和采摘决策；同时用STM32H5运行底盘速度闭环、急停、CAN-FD通信、末端执行器控制和安全状态机。

## 2026-07-17 16:07 助手

我会把现有材料压缩成四个主体章节，统一申报书语气，并修正导航传感器、算法表述和商业化逻辑。完成后会在项目目录生成一份可直接使用的 `.txt` 文件。

## 2026-07-17 16:07 助手

目录中没有额外编写规范，现有文件也与本次计划书无冲突。接下来我会生成正式正文，并把“超声波可单独导航”等不够可靠的表述改为可落地方案。

## 2026-07-17 16:09 助手

正文已经完成并写入文件。我现在只做格式与关键术语复核，确认四个章节、文件编码和算法符号都正确。

## 2026-07-17 16:10 助手

已整理并生成可直接用于项目计划书的 UTF-8 文字文件：

[项目计划书_面向低位柑橘采摘的自主移动机器人.txt](/Users/bohn/Documents/Huaxu/项目计划书_面向低位柑橘采摘的自主移动机器人.txt:1)

正文按四个要求组织，仅保留四个主体标题，并完成了：

- 统一正式申报书语言和技术术语。
- 补充项目差异性、实施进度及风险应对。
- 完善商业化路径与数据合规表述。
- 明确激光雷达主导航、超声波辅助防撞。
- 完善VENTUNO Q双脑分工及备用硬件方案。

## 2026-07-17 16:15 用户

内容还能精简吗

## 2026-07-17 16:15 助手

可以，上一版更接近“完整论证稿”，确实存在部分观点重复。我会保留原文件，同时生成一份篇幅更短、四项要求仍完整覆盖的“项目计划书精简版”。

## 2026-07-17 16:16 助手

可以，已生成精简版，正文由约6272字压缩至3317字，同时保留四项申报要求、实施进度和硬件方案。

[打开项目计划书精简版](/Users/bohn/Documents/Huaxu/项目计划书_精简版_面向低位柑橘采摘的自主移动机器人.txt:1)

原完整版本也已保留，方便后续扩写或制作答辩材料。
