BohnChen/PickOrangeDummy/docs/DummyArm_for_VENTUNO/2_对话记录/codex/2026-07-29_codex_delegation_source_thread_id_0.md

---
tool: codex
session_id: rollout-2026-07-29T17-01-11-019fad1b-3c78-7481-9fc5-2cdd763f93e0
date: 2026-07-29 17:01
updated: 2026-07-29 17:06
source: .codex/sessions/2026/07/29/rollout-2026-07-29T17-01-11-019fad1b-3c78-7481-9fc5-2cdd763f93e0.jsonl
---

# <codex_delegation>   <source_thread_id>0

> 工具: codex · 会话: rollout-2026-07-29T17-01-11-019fad1b-3c78-7481-9fc5-2cdd763f93e0

## 2026-07-29 17:01 用户

<codex_delegation>
  <source_thread_id>019f5169-7ac2-72e3-a205-05558a23e337</source_thread_id>
  <input>我们要继续规划并落地 DummyArm-ROS2-Grasp 项目。背景：用户有 C++ 能力、ROS2 Humble 基础、Ubuntu 22.04 虚拟机、Mac、QCS8550 FV04 开发板、dummy 机械臂、RealSense D435i、W4D 智能小车、GD32/ESP32/BPi-F3、3D 打印机，以及约 14000 张柑橘图像数据。目标：把 dummy 机械臂做成 ROS2 操作、视觉抓取、模仿学习和强化学习训练平台。请从项目架构、硬件分工、开发里程碑、ROS2 包结构、仿真训练路线、真机部署路线开始详聊。</input>
</codex_delegation>

## 2026-07-29 17:01 助手

我先梳理现有仓库和约束，再给出可落地的总体架构、阶段路线与首批实现建议。

## 2026-07-29 17:01 助手

当前目录是空仓库。我会先把“能跑通的最小抓取闭环”定为主线，再逐层加入仿真、数据与学习模块，避免一开始把平台做散。

## 2026-07-29 17:02 助手

架构主线已经收敛：`MCU 硬实时控制 → ros2_control → MoveIt 2 → RGB-D 感知 → 抓取任务层`。接下来我把接口、验收条件和学习路线写成一份可直接执行的项目蓝图。

## 2026-07-29 17:05 助手

蓝图已覆盖仿真、真机、数据和学习的完整依赖顺序。为了下一步能直接生成 URDF 与控制接口，我再补一份机械臂参数采集表，把目前唯一的硬件信息缺口变成可填写清单。

## 2026-07-29 17:06 助手

已完成第一版可执行规划，并整理为两份文档：

- [项目总体蓝图](/Users/bohn/Documents/Codex/2026-07-29/dummyarm-ros2-grasp/outputs/DummyArm-ROS2-Grasp-项目蓝图.md:1)：涵盖总体架构、硬件分工、ROS 2 包结构、接口、仿真训练、真机部署、柑橘数据路线及 M0–M9 里程碑。
- [硬件参数采集表](/Users/bohn/Documents/Codex/2026-07-29/dummyarm-ros2-grasp/outputs/DummyArm-硬件参数采集表.md:1)：用于收集自由度、电机、减速器、编码器、尺寸、夹爪、通信与安全信息。

核心路线确定为：

`GD32 硬实时控制 → ros2_control → MoveIt 2 → D435i RGB-D 感知 → 抓取规划 → 任务状态机`

第一目标是固定底座、eye-to-hand 相机和规则物体的桌面 pick-and-place；稳定后依次加入柑橘分割、模仿学习、残差强化学习及 W4D 移动底盘。

下一步请优先提供机械臂照片、自由度、驱动/编码器型号、夹爪形式和当前控制方式。拿到这些信息后，就可以生成真实 URDF、MoveIt 2 配置及首个可编译的 ROS 2 工作空间。
