BohnChen/PickOrangeDummy/docs/DummyArm_for_VENTUNO/2_对话记录/codex/2026-07-29_mac_M4_MAX_可以跑机器人的仿真吗_比如Mojoco_或者Issac.md

---
tool: codex
session_id: rollout-2026-07-29T14-57-45-019facaa-3b65-7e02-aba3-299c2db1be3b
date: 2026-07-29 14:58
updated: 2026-07-29 15:51
source: .codex/sessions/2026/07/29/rollout-2026-07-29T14-57-45-019facaa-3b65-7e02-aba3-299c2db1be3b.jsonl
---

# mac M4 MAX，可以跑机器人的仿真吗？ 比如Mojoco 或者Issac 

> 工具: codex · 会话: rollout-2026-07-29T14-57-45-019facaa-3b65-7e02-aba3-299c2db1be3b

## 2026-07-29 14:58 用户

mac M4 MAX，可以跑机器人的仿真吗？ 比如Mojoco 或者Issac sim Issac lab 之类的仿真

## 2026-07-29 14:58 助手

我先核对一下 MuJoCo 和 Isaac Sim/Lab 的最新官方兼容性，避免给你过时结论。

## 2026-07-29 15:00 助手

结论已经很明确：M4 Max 很适合 MuJoCo；我再确认一下 Isaac 的远程/云端可行路径。

## 2026-07-29 15:04 助手

可以，但取决于仿真平台：

| 平台 | M4 Max 上运行 | 说明 |
|---|---|---|
| **MuJoCo** | ✅ 原生支持 | 官方提供 macOS Universal 版本，Apple Silicon 性能很好 |
| **PyBullet / Webots** | ✅ 可以 | 适合教学、控制算法和一般机器人仿真 |
| **Isaac Sim** | ❌ 不能原生运行 | 需要 Windows/Linux、x86_64 和 NVIDIA RTX 显卡 |
| **Isaac Lab** | ❌ 不能原生运行 | 依赖 Isaac Sim、CUDA 和 NVIDIA GPU |
| **Gazebo** | ⚠️ 可以折腾 | macOS 支持与插件兼容性不如 Ubuntu |

### M4 Max + MuJoCo

很合适，特别适用于：

- 机械臂、四足机器人、运动控制
- 强化学习环境开发
- Gymnasium、Robosuite 等框架
- 多进程并行 CPU 仿真
- 本地模型推理和算法开发

需要注意：MuJoCo 的物理计算主要依靠 **CPU**，并不会因为 M4 Max GPU 核心很多而获得类似 CUDA 的大规模并行加速。PyTorch 可以使用 `MPS`，但兼容性和训练吞吐通常仍不如 NVIDIA CUDA。MJX/JAX 在 Apple GPU 上也不是最成熟的组合。

### Isaac Sim / Isaac Lab

截至目前，官方要求仍是：

- Ubuntu 22.04/24.04 或 Windows 11
- x86_64
- NVIDIA RTX GPU
- CUDA / RTX 光线追踪能力

所以 Docker、Parallels 或 Rosetta 都不能让 M4 Max 获得所需的 NVIDIA CUDA/RTX 功能。官方最新最低 GPU 配置甚至列到了 RTX 4080。

实际可采用：

```text
Mac M4 Max：写代码、MuJoCo 仿真、数据分析
        ↓ SSH / Git
Linux + NVIDIA RTX：运行 Isaac Sim / Isaac Lab
```

远端可以是自己的 Linux 工作站，或者云端 RTX/A10/A100/L40S 实例。

### 购买建议

如果你已经有 M4 Max：放心用 MuJoCo，不必换电脑；需要 Isaac 时配远程 NVIDIA 机器。

如果你还没买、主要目标是 Isaac Lab 大规模强化学习：优先选择 **Ubuntu + NVIDIA RTX 4090/5090 + 64GB 内存**，会比 Mac 合适得多。

官方资料：[MuJoCo](https://github.com/google-deepmind/mujoco) · [Isaac Sim 系统要求](https://docs.isaacsim.omniverse.nvidia.com/latest/installation/requirements.html) · [Isaac Lab 安装说明](https://isaac-sim.github.io/IsaacLab/main/source/setup/installation/index.html)

## 2026-07-29 15:11 用户

# Files mentioned by the user:

## codex-clipboard-8f3b68be-5738-45d0-8ab4-02895db0e427.png: /var/folders/fk/__45dt7d1dqg2y100bw47b840000gn/T/codex-clipboard-8f3b68be-5738-45d0-8ab4-02895db0e427.png

## My request for Codex:
应该下载哪个版本的哪个包呢？
<image name=[Image #1] path="/var/folders/fk/__45dt7d1dqg2y100bw47b840000gn/T/codex-clipboard-8f3b68be-5738-45d0-8ab4-02895db0e427.png">
</image>

## 2026-07-29 15:11 用户

# Files mentioned by the user:

## codex-clipboard-8f3b68be-5738-45d0-8ab4-02895db0e427.png: /var/folders/fk/__45dt7d1dqg2y100bw47b840000gn/T/codex-clipboard-8f3b68be-5738-45d0-8ab4-02895db0e427.png

## My request for Codex:
应该下载哪个版本的哪个包呢？

## 2026-07-29 15:12 助手

你的 **Mac M4 Max** 应下载：

**`mujoco-3.11.0-macos-universal2.dmg`**

`universal2` 同时包含 Apple Silicon（M1–M4）和 Intel Mac 版本。

不要下载：

- `linux-aarch64`：虽然也是 ARM，但它是 Linux 版本
- `.sha256`：只是校验文件
- `Source code`：除非你准备自行编译

如果主要使用 Python，其实不用下载 DMG，直接安装更方便：

```bash
python3 -m venv mujoco-env
source mujoco-env/bin/activate
python -m pip install --upgrade pip
python -m pip install mujoco
```

验证安装：

```bash
python -c "import mujoco; print(mujoco.__version__)"
```

建议：想直接打开图形界面和示例就下载 `.dmg`；准备写 Python 强化学习或机器人程序，就使用 `pip install mujoco`。

## 2026-07-29 15:44 用户

我下载好了，应该怎么用呢

## 2026-07-29 15:44 助手

我先看看下载文件和镜像里的实际内容，再按你这版给出准确步骤。

## 2026-07-29 15:51 助手

你下载的镜像已经成功打开了，里面主要有两个程序：

- **`MuJoCo.app`**：运行和查看机器人仿真，建议先用它
- **`MuJoCoStudio.app`**：用于更复杂的场景编辑和调试

### 第一次运行

1. 打开 Finder 中的 **MuJoCo** 磁盘。
2. 把 `MuJoCo.app` 和 `MuJoCoStudio.app` 拖进“应用程序”。
3. 双击打开 `MuJoCo.app`。
4. 如果 macOS 拦截，右键应用选择“打开”，再确认一次。
5. 将镜像中 `model` 文件夹里的任意 `.xml` 文件拖入窗口，例如：

```text
model/humanoid/humanoid.xml
```

6. 按空格键开始或暂停仿真；鼠标拖动可旋转视角，滚轮缩放。

建议把镜像里的 `model` 文件夹也复制到“文稿”中，否则推出安装镜像后，这些示例模型就无法访问。

### 如果准备写 Python

DMG 只是图形程序，Python 接口还要单独安装：

```bash
python3 -m venv ~/mujoco-env
source ~/mujoco-env/bin/activate
python -m pip install --upgrade pip
python -m pip install mujoco
```

验证：

```bash
python -c "import mujoco; print(mujoco.__version__)"
```

其中 `mujoco.framework` 是给 C/C++ 等原生开发使用的，普通使用和 Python 开发暂时不用管。
