BohnChen/PickOrangeDummy/docs/DummyArm_for_VENTUNO/2_对话记录/opencode/2026-07-31_Explore_AgiRobot_X2_code_explore_subagent.md

---
tool: opencode
session_id: ses_04798eb7cffeMA4nsD3iMYDGIi
model: deepseek-v4-pro
date: 2026-07-31 21:39
updated: 2026-07-31 21:42
---

# Explore AgiRobot X2 code (@explore subagent)

> 工具: opencode · 模型: deepseek-v4-pro · 会话: ses_04798eb7cffeMA4nsD3iMYDGIi

## 2026-07-31 21:39 用户

Explore the AgiRobot-X2-Development project. Check if the repo exists at /Users/bohn/02_Personal/06_JobMaterial/project/ or any other location. If not found, look for it in common clone locations like ~/Downloads, ~/Documents, ~/Desktop, or ~/02_Personal/. 

Also check if there's a clone at /Users/bohn/BohnChen/AgiRobot-X2-Development.git or similar paths.

The GitHub URL is https://github.com/BohnChen/AgiRobot-X2-Development.git

I need to understand:
1. What files are in this repo?
2. Which are vendor SDK files vs user-written code?
3. What ROS2 nodes/services/topics are used?
4. What's the actual contribution vs SDK wrapper?

Search broadly for this project. Use glob patterns like "**/AgiRobot*" or "**/X2*" at paths like /Users/bohn/ and /Users/bohn/Documents/
