BohnChen/PickOrangeDummy/docs/DummyArm_for_VENTUNO/2_对话记录/opencode/2026-08-25_ROS2_四层架构面试准备.md

---
tool: opencode
session_id: ses_fc89f373fffetlxp7uQkt7saRr
model: deepseek-v4-flash
date: 2026-08-25 13:24
updated: 2026-08-25 13:54
---

# ROS2 四层架构面试准备

> 工具: opencode · 模型: deepseek-v4-flash · 会话: ses_fc89f373fffetlxp7uQkt7saRr

## 2026-08-25 13:24 用户

我要针对 ROS2 做一点面试准备，关于一些面试问题，我想让你帮我做细致的解答。
面试文件在/Users/bohn/02_Personal/06_JobMaterial/ROS2面试题集.md
接下来，我们一个问题一个问题来，
rclcpp / rcl / rmw / DDS 四层分别是什么？我想试着写一下代码，体会一下这些东西是什么

## 2026-08-25 13:24 助手

先看一下你机器上的 ROS2 环境，方便我给你的示例代码能直接编译跑起来。

## 2026-08-25 13:26 助手

这题很适合用“写代码逐层下沉”的方式来体会。我先把示例代码搭好（rclcpp → rcl → rmw → 裸 DDS 各一份），你之后在 Linux 的 ROS2 环境里跑；DDS 那层我看看能否在你这台 Mac 上直接验证。

先创建目录和代码文件。

## 2026-08-25 13:26 助手

现在试试能否在你这台 Mac 上直接跑通裸 DDS 演示（验证 DDS 层确实不依赖 ROS）。

## 2026-08-25 13:26 助手

系统 Python 受 PEP 668 保护，我用虚拟环境装。

## 2026-08-25 13:28 用户

我可以去arduino VENTUNO Q板子进行尝试，所以不用测试本机环境。
讲项目写好后，我来 scp 到板子上

## 2026-08-25 13:29 助手

了解，那我们以 VENTUNO Q 板子为运行目标。当前项目已经写好的部分：

**已完成（6 个文件）**
- `src/01_rclcpp_talker.cpp` — rclcpp 层（你平时写的 API）
- `src/02_rcl_talker.c` — 纯 C 的 rcl API 版 talker（手动初始化/清理）
- `src/03_rmw_probe.cpp` — 从 rclcpp 直接调用 rmw 函数，打印底层中间件是谁
- `dds_demo/01_cyclonedds_pub.py` / `02_cyclonedds_sub.py` — 完全无 ROS 的裸 DDS 收发
- `CMakeLists.txt` / `package.xml` — ament 包，用于 `colcon build`

**还缺的核心部分：`README.md`** — 含四层总览、在板子上的构建/运行步骤、每个 demo 的“感受点”、以及面试回答 Q2 的总结。

在我补齐 README 之前，有两个问题需要确认，好让板子上的步骤一次跑通：

## 2026-08-25 13:54 用户

tmux是不是没有必要在板子上安装？ 毕竟都是 ssh 过去的？

## 2026-08-25 13:54 助手

不是。恰恰相反，**SSH 过去才更需要 tmux**，原因：

1. **SSH 断开 = 前台进程被杀**：如果你在板子上 `ros2 run talker` 跑到一半，ssh 掉线或本地网络抖一下，节点直接挂（HUP 信号）。tmux 里的会话能脱离 SSH 存活。
2. **你要同时开好几个终端**：talker + listener + `topic echo` + `tcpdump` 得并行。用 tmux 一条 ssh 就能分屏搞定，不用开一堆 SSH 窗口。

不过不是硬性必须——短时间演示的话，直接开多个 iTerm/终端标签页各 ssh 一次也行。另外 ROS2 本身支持跨机（你的 Q37），你也可以 **板子上跑节点、本地 Mac 上 `ros2 topic echo`**，两个终端就够，甚至可以不装 tmux。

我的建议：README 里写成“可选，但强烈推荐”，给一条 `sudo apt install tmux` 的安装命令和两条分屏用法（`Ctrl-b %` 竖分、`Ctrl-b "` 横分），其余照常。你倾向哪种？

- A. README 加 tmux 推荐用法（多开几个终端面板，演示更稳）
- B. 不加，就用多个 SSH 窗口
- C. 板子跑节点 + 本机 echo，走跨机方案

你确认这个后，我就把 README 的构建/运行步骤按这个方向写好。另外之前问的板子 ROS2 版本（Humble / Jazzy / 不确定）也一并告诉我，我好定 `source` 路径和 RMW 实现名。
