BohnChen/PickOrangeDummy/docs/DummyArm_for_VENTUNO/2_对话记录/opencode/2026-08-25_ROS2面试题_rclcpp_rcl_rmw_DDS四层介绍.md

---
tool: opencode
session_id: ses_fc857abe5ffeCIhj2PmeIVfI8l
model: deepseek-v4-flash
date: 2026-08-25 14:42
updated: 2026-08-25 16:58
---

# ROS2面试题：rclcpp/rcl/rmw/DDS四层介绍

> 工具: opencode · 模型: deepseek-v4-flash · 会话: ses_fc857abe5ffeCIhj2PmeIVfI8l

## 2026-08-25 14:42 用户

我现在需要对～/ROS2Test文件夹中的面试题目做一些准备，你应该已经看到了那个项目，那是让opencode帮我写的了解Q2. rclcpp / rcl / rmw / DDS 四层分别是什么?

你先帮我介绍一下。

## 2026-08-25 14:42 助手

`~/ROS2Test` 不存在，但我找到了一个很相关的目录 `/Users/bohn/02_Personal/06_JobMaterial/ROS2_layers_demo`，看起来正是这个面试题相关项目。我确认一下。

## 2026-08-25 14:43 助手

找到了，这个项目正是演示四层架构的。让我读一下这些文件。

## 2026-08-25 14:43 助手

这题正好对应你那个 `ROS2_layers_demo` 项目（在 `~/02_Personal/06_JobMaterial/` 下，不是 `~/ROS2Test`）。项目里 4 个文件就是逐层降级的同一件事。下面按面试口吻给你介绍。

## 一句话总览

ROS2 是分层设计的：**rclcpp 是最上层的 C++ 封装，rcl 是 C 接口层，rmw 是中间件抽象层，DDS 是最底层的通信中间件。** 调用链就是 `rclcpp → rcl → rmw → DDS`，每个消息发布都会沿这条链沉到底。

## 第 1 层：rclcpp（C++ 客户端库）— `src/01_rclcpp_talker.cpp`

- 面向对象封装：`Node`、`Publisher`、`Subscriber`、`Timer`、回调、Executor 都在这里。
- 你平时写 ROS2 代码几乎全在这一层。`create_publisher`、`spin`、`RCLCPP_INFO` 都是它提供的。
- 用 RAII 管资源，`init/spin/shutdown` 自动完成，底层细节对用户完全隐藏。
- 另一套对等实现是 **rclpy**（Python），和 rclcpp 平级。

## 第 2 层：rcl（C 客户端库）— `src/02_rcl_talker.c`

- 用**纯 C** 写的同一套功能：`rcl_node_init`、`rcl_publisher_init`、`rcl_publish`、`rcl_shutdown` 等。
- 没有类、没有模板，只有结构体 + 一堆 `rcl_*` 函数，所有资源要手动初始化/清理（看 `02_rcl_talker.c` 里 5 步手动 `fini`）。
- **rclcpp 就是把这层包了一层 C++ 皮**。所以 rcl 一次实现，C++ 和 Python 两种客户端都能共享它。
- 消息类型靠 rosidl 生成的类型支持宏（`ROSIDL_GET_MSG_TYPE_SUPPORT`），这层已经不做序列化，只做类型分发。

## 第 3 层：rmw（ROS MiddleWare 抽象层）— `src/03_rmw_probe.cpp`

- 这是一层**纯接口/抽象**，定义 `rmw_*` 函数签名，不实现任何通信。
- 它的作用是**屏蔽不同 DDS 实现的差异**：同一份 ROS2 代码，通过环境变量 `RMW_IMPLEMENTATION` 切换底层中间件（如 `rmw_cyclonedds_cpp` / `rmw_fastrtps_cpp`），代码一行不改。
- `03_rmw_probe.cpp` 里 `rmw_get_implementation_identifier()` 能直接打印出当前用的是哪家 DDS——这就是它的存在证据。
- 面试加分点：rclcpp 其实不是直接调 rmw，中间还隔着 `rclcpp::__rmw_*` 和 `rcl` 的间接调用，但概念上就是"rcl 通过 rmw 接口去操作 DDS"。

## 第 4 层：DDS（Data Distribution Service）— `dds_demo/01_cyclonedds_pub.py`

- DDS 是**独立完整的工业级通信中间件**，本身就有发现、QoS、组播、可靠性等能力，不依赖 ROS。
- ROS2 只是"坐在" DDS 上面，规定了消息类型定义（rosidl）和工具链。`DomainParticipant`、`DataWriter`/`DataReader`、`Topic` 都是 DDS 概念。
- `01_cyclonedds_pub.py` 用裸 CycloneDDS 就能两个进程互相通信，全程没有 ROS——证明 DDS 可独立工作。
- 面试加分点：ROS2 默认 `RMW_IMPLEMENTATION=rmw_cyclonedds_cpp`（Humble 起默认 Cyclone），节点发现、QoS 都是 DDS 在管。

## 面试一句话版

> "四层从下往上：DDS 是底层通信中间件，负责真正传输数据；rmw 是抽象层，把不同 DDS 统一成同一套接口，所以 ROS2 能换中间件；rcl 是 C 接口层，把 DDS 能力封装成 ROS 语义；rclcpp/rclpy 是最上层的语言绑定，给用户友好的面向对象 API。"

需要我帮你把这题整理成带提问点的正式笔记（放回那个面试文件夹里），还是继续下一题？

## 2026-08-25 14:50 用户

QoS是什么？这层rcl的 c 接口层，将 DDS 能力封装成 ROS 语义怎么理解？ rclcpp是语言绑定怎么理解？ 让cpp或者python可以用这些库吗？

## 2026-08-25 14:51 助手

三个问题都是面试高频追问点，逐个讲透。

## 1. QoS 是什么

**QoS = Quality of Service，一组"传输服务质量"策略**，规定发布者和订阅者之间怎么收、怎么存、怎么保证可靠性。它来自 DDS 原生，ROS2 只是把它透传。

你代码里那个 `10` 就是 QoS：`create_publisher<...>("chatter", 10)` 里第二个参数是 History 深度（队列长度）。

核心策略（面试记住 3-4 个即可）：

| 策略 | 选项 | 含义 |
|---|---|---|
| History | `KEEP_LAST(10)` / `KEEP_ALL` | 只缓存最近 10 条 / 全部缓存 |
| Reliability | `RELIABLE` / `BEST_EFFORT` | 丢包重传（保证送达）/ 尽力而为，丢了不补 |
| Durability | `TRANSIENT_LOCAL` / `VOLATILE` | 晚来的订阅者能否收到"最后一条旧数据" |
| Deadline / Lifespan | 时间值 | 数据超时未收到/过期即作废 |

**面试必答的洞察**：收发两端 QoS **必须兼容**才能建立连接。比如订阅者要 RELIABLE，发布者是 BEST_EFFORT，就连不上（`rmw_publish` 会报错/告警）。所以传感器数据常用 `BEST_EFFORT + KEEP_LAST(1)`（图像、点云，晚一点没关系，用最新帧），控制/任务指令用 `RELIABLE`（必须送达）。

## 2. "rcl 把 DDS 能力封装成 ROS 语义"怎么理解

核心矛盾是：**DDS 不知道什么是"节点、话题、服务、参数"**。DDS 世界里只有 4 样东西：`DomainParticipant`（领域参与者）、`Topic`、`DataWriter`（发布端点）、`DataReader`（订阅端点）。它是通用数据总线。

rcl 这层做的是**翻译 + 补约定**：

- **端点 → 端点**：`DataWriter/DataReader` 被映射成 `rcl_publisher/rcl_subscription`，一个 ROS 话题在 DDS 里其实是一对（写+读）端点。
- **类型检查**：rcl 用 rosidl 生成的 `ROSIDL_GET_MSG_TYPE_SUPPORT` 把 C 结构体绑定上"ROS 消息类型"，pub 和 sub 的类型必须一致才能对接——DDS 本身不管这件事。
- **ROS 专属语义是 rcl 拼出来的**：
  - **Service**：底层就是两对 topic（request topic + reply topic）+ 一套请求/响应消息约定，DDS 没有"服务"概念；
  - **Action**：用 3 组 topic（goal、cancel、result/feedback）拼成；
  - **参数**、**节点图（node graph）**、**命名空间/remap** 同理，全是 ROS 概念，由 rcl 解释 DDS 的发现数据组装出来。

一句话：**DDS 只负责把字节高效送到；"这些字节是什么话题、谁是节点、怎么组服务"是 rcl 加上的 ROS 语义**。

## 3. "rclcpp 是语言绑定"怎么理解？是让 C++/Python 能用这些库吗？

对，但不完全——这是面试的区分点：

- **rclpy 是"纯绑定"**：把 rcl 的 C 函数用 Cython 几乎 1:1 包一层，`rcl_init` → `rclpy.init()`，没有加新东西。
- **rclcpp 是"厚封装"**，不只是翻译 C 调用。它在 rcl 之上额外实现了 C 层没有的东西：
  - **Executor 线程模型**：C 层只有 `rcl_wait` 这种"等事件"原语，没有"循环分发回调"的机制。`spin()` 和 Executor（单线程/多线程）是 **rclcpp 自己写的**；
  - **RAII 生命周期**：构造自动建、析构自动 `fini`（对比 `02_rcl_talker.c` 里 5 步手动清理）；
  - **模板类型系统 + 智能指针**：`rclcpp::Publisher<std_msgs::msg::String>::SharedPtr` 这套是 C 层没有的；
  - **Timer 封装**：`create_wall_timer` 在 rcl 里只是定时器句柄，配回调、挂进 executor 是 C++ 层干的。

所以准确说法是：**rcl 用 C 实现一次，rclcpp/rclpy 让你分别用 C++ 和 Python 调用它；其中 rclpy 是轻量绑定，rclcpp 是在绑定之上又做了一层更厚、更强的面向对象封装**。这也是为什么 rclcpp 单独对应一份代码量很大的仓库。

要不要我把这三段（QoS / rcl 封装语义 / 语言绑定）连同上一题的"四层介绍"整理成一份问答笔记存进你的面试文件夹？

## 2026-08-25 15:08 用户

好的，现在我对于这些问题有了了解了，你帮我把他们存进一个新的文件，将问题作为文件名字，存进/Users/bohn/04_Project/06_MyWeb/BohnChen.github.io/content/posts/StudyRecord/ROS2中，我希望能有一些代码的举例讲解。

关于“- ROS 专属语义是 rcl 拼出来的：
- Service：底层就是两对 topic（request topic + reply topic）+ 一套请求/响应消息约定，DDS 没有"服务"概念；
- Action：用 3 组 topic（goal、cancel、result/feedback）拼成；
- 参数、节点图（node graph）、命名空间/remap 同理，全是 ROS 概念，由 rcl 解释 DDS 的发现数据组装出来。 ”关于这句，我觉得有助于我判断何时用topic何时用service和action,加上 node 的概念，你一起帮我区分一下 ROS2 中的这些基础概念把。这些基础概念可以写在文件前面。

关于你讲的“核心矛盾是：*DDS 不知道什么是"节点、话题、服务、参数"*。DDS 世界里只有 4 样东西：DomainParticipant（领域参与者）、Topic、DataWriter（发布端点）、DataReader（订阅端点）。它是通用数据总线。”你说 DDS 不知道什么是话题，却说 DDS 的世界有的四样东西中有Topic，这有怎么理解？

## 2026-08-25 15:08 助手

我先看一下目标目录的结构和已有文件的写作规范（这看起来是个 Hugo 博客站）。

## 2026-08-25 15:08 助手

我已经了解了博客的规范（Hugo 站，YAML front matter，中文 markdown，`cpp_day08.md` 这种命名）。先回答你那个关键的概念疑问，再给文件计划。

## 先回答：DDS 有 Topic，怎么说它"不知道话题"？

这是**同名异物**——两个层的 "Topic" 意思不同，是个很好的面试区分点。

- **DDS 的 Topic** 是个**底层原语**：只是 `(名字, 类型, QoS)` 的三元组，唯一作用是把 `DataWriter` 和 `DataReader` **匹配到一起**。它就像一根水管，自己不知道水是热水还是咖啡。
- **ROS 的 topic** 是**节点间通信的语义概念**：发布/订阅模式、命名空间、remap、节点图里"这个 publisher 属于哪个 node"。

所以准确说法是：**DDS 不认识"ROS 话题"这个高层概念**。DDS 的 Topic 只是无语义的通道标签——`01_cyclonedds_pub.py` 里 `Topic(dp, "HW_Topic", Hello)` 就只是个名字+类型，没有任何"节点、命名空间、话题/服务区分"的含义；而 ROS 里 `create_publisher("chatter", 10)` 在 DDS 下会建出一个带 namespace 的 DDS Topic，但 **"这是节点 X 的 publisher、承载什么 ROS 消息"这套语义是 rcl 层记下来的**。

一句话：DDS 的 Topic = 水管（名字+类型+QoS），ROS 的 topic = 你对这根水管的语义约定（属于谁、传什么、怎么暴露给 graph）。

## 文件创建计划

**目标路径**：`/Users/bohn/04_Project/06_MyWeb/BohnChen.github.io/content/posts/StudyRecord/ROS2/Q2-rclcpp-rcl-rmw-DDS四层分别是什么.md`

（`/` 不能用在文件名里，所以用 `-` 代替）

**front matter**（对齐现有规范）：
```yaml
title: "Q2. rclcpp / rcl / rmw / DDS 四层分别是什么?"
date: <今天时间>
draft: false
categories: ["ROS2"]
tags: ["ROS2", "面试", "技术学习"]
```

**正文结构**（按你的要求，基础概念在前，含代码举例）：

1. **ROS2 基础概念对比表（前置）**——Node / Topic / Service / Action / Parameter，重点讲清楚**何时用哪个**：
   - Topic：单向、持续、一对多广播、无回应 → 传感器流、状态上报（图像、odom、clock）
   - Service：短请求-应答、一次性、有同步响应 → 查询/触发（call service、取参数、设置）
   - Action：长任务、可取消、有中间反馈 + 最终结果 → 导航、机械臂运动
   - 配一个"选型决策"小口诀/对照表
2. **四层总览 + 调用链**（rclcpp → rcl → rmw → DDS）
3. **每层详述 + 代码**：直接引用你 demo 项目 4 个文件的关键代码片段（rclcpp_talker / rcl_talker / rmw_probe / 裸 DDS py），每段配"这层在干嘛"的注释讲解
4. **QoS 详解**（策略表 + 面试组合拳）
5. **"rcl 把 DDS 封装成 ROS 语义"**（端点映射表 + service 底层是 2 对 topic、action 是 3 组 topic 的结构图）
6. **"rclcpp 是语言绑定"**（rclpy 轻绑定 vs rclcpp 厚封装对比，说明 Executor/RAII/模板是 C++ 层自己实现的）
7. **DDS Topic vs ROS topic 同名异物**（上面的回答写进去）

几个确认点：

## 2026-08-25 15:10 助手

计划已确定：

**文件**：`/Users/bohn/04_Project/06_MyWeb/BohnChen.github.io/content/posts/StudyRecord/ROS2/rclcpp-rcl-rmw-DDS这四层分别是什么.md`

**front matter**：title = "rclcpp / rcl / rmw / DDS 这四层分别是什么"，categories: ["ROS2"]，tags: ["ROS2", "面试", "技术学习"]

**正文**（按顺序，均含讲解）：
1. **ROS2 基础概念前置对比**：Node / Topic / Service / Action / Parameter + 选型决策表（单向流→Topic、短请求应答→Service、长任务可取消→Action）
2. **四层总览与调用链**：rclcpp → rcl → rmw → DDS
3. **逐层详解 + 关键代码片段**：从 demo 项目摘 `01_rclcpp_talker.cpp`、`02_rcl_talker.c`、`03_rmw_probe.cpp`、`dds_demo` 里代表性片段
4. **QoS 详解**：策略表 + 面试常用组合（传感器 BEST_EFFORT / 控制 RELIABLE）
5. **rcl 封装 ROS 语义**：端点映射表 + service（2 组 topic）/ action（3 组 topic）结构图
6. **rclcpp 语言绑定**：rclpy 轻绑定 vs rclcpp 厚封装（Executor/RAII/模板）
7. **DDS Topic vs ROS topic 同名异物**澄清

计划就绪，确认后我就开始写。

## 2026-08-25 15:11 用户

执行

## 2026-08-25 15:11 助手

已创建 `/Users/bohn/04_Project/06_MyWeb/BohnChen.github.io/content/posts/StudyRecord/ROS2/rclcpp-rcl-rmw-DDS这四层分别是什么.md`。

内容结构：
1. **§0 基础概念选型表**：Node / Topic / Service / Action / Parameter + 选型口诀（单向流→Topic、短应答→Service、长任务可取消→Action）
2. **§1 四层总览 + 调用链图**
3. **§2-5 逐层详解 + 关键代码片段**：内嵌了 demo 项目 4 个文件的核心代码
4. **§6 QoS**：策略表 + 面试组合拳 + 代码
5. **§7 rcl 封装 ROS 语义**：端点映射表 + service/action 拼装说明
6. **§8 语言绑定**：rclpy 轻绑定 vs rclcpp 厚封装
7. **§9 DDS Topic vs ROS topic 同名异物**澄清

需要我继续下一个面试题，或运行 `hugo` 预览这篇文章吗？

## 2026-08-25 15:25 用户

Q3. ros2 run、ros2 node list、ros2 topic list、ros2 doctor 分别干什么？launch呢？ launch干了什么事情？

## 2026-08-25 15:26 助手

这题是关于 ROS2 命令行工具和 launch 的，面试常问。逐个讲。

## 四个 CLI 命令

| 命令 | 干什么 | 底层机制 |
|---|---|---|
| `ros2 run <pkg> <exe>` | 运行某个包里编译好的可执行程序（也就是启动一个节点） | 等价于找到包路径然后执行那个二进制，会触发 DDS 发现 |
| `ros2 node list` | 列出当前 ROS 图中**所有已发现的节点** | 靠 DDS 发现协议 + rcl graph API，能感知到其他机器、其他 namespace 的节点 |
| `ros2 topic list` | 列出当前图里所有话题 | 同样靠发现信息，`-t` 可同时显示消息类型 |
| `ros2 doctor` | 系统健康诊断 | 检查环境变量、ROS 版本匹配、循环问题（source 重复）、DDS 配置、网络等，输出 WARN/ERROR |

面试区别点：
- `ros2 run` 是**主动执行**，后三个是**只读查询/诊断**，都依赖 DDS 发现——所以"没 source、不在同一 domain、发现失败"时 `node list` 会空。
- `ros2 doctor` 是 ROS1 没有的（对应 ROS1 的一堆脚本），是个统一的诊断入口。
- `ros2 node list` vs `ros2 topic list`：一个是"人"（节点），一个是"通道"（话题），`node info <name>` 能查出某个节点的 pub/sub/service，体现 graph 概念。

## launch 是什么、干了什么

**launch 是"编排层"**：用文件一次性描述"要启动哪些节点、用什么参数、放哪个 namespace、挂在哪个组、按什么条件启动"，然后交给 launch 系统去执行并**管理这些进程的生命周期**。

`ros2 launch <pkg> <file>` 会做什么：
1. **解析 launch 文件**（XML / Python / YAML 三种格式，Python 能力最强），构建一棵 `LaunchDescription` 描述树；
2. **为每个 Node action 实际拉起进程**（fork + exec，默认每个 node 一个进程）；
3. **管理生命周期**：启动顺序、退出码处理、失败自动重启、整体 shutdown；
4. **传递参数与替换**：`$(var ...)`、`$(find ...)`、`$(env ...)` 这类 substitution，实现"一个 launch 到处复用"；
5. **支持 include**：launch 里能嵌套别的 launch，做分层组合。

**面试核心对比（rosrun vs launch）**：

```
ros2 run    → 一次只跑 1 个可执行，命令行一个个敲
ros2 launch → 一次编排 N 个节点 + 参数 + 命名空间 + 进程管理
```

**面试加分的坑点（ROS1 vs ROS2 差异）**：
- ROS1 的 `roslaunch` 能在**一个进程里跑多个 node**（nodelet 模型）。
- ROS2 的 launch **默认每个 node 一个独立进程**；想复用进程（轻量、共享内存）必须用 **composable node**（等价物是 ROS1 的 nodelet），通过 `ros2 component` 或 launch 的 `ComposableNodeContainer` 做。

一个 launch 示例（Python 格式）：

```python
from launch import LaunchDescription
from launch_ros.actions import Node

def generate_launch_description():
    return LaunchDescription([
        Node(package="turtlesim", executable="turtlesim_node",
             name="sim", namespace="demo"),
        Node(package="turtlesim", executable="turtle_teleop_key",
             output="screen", remappings=[("cmd_vel", "demo/cmd_vel")]),
    ])
```

它做的事用命令行的等价物是：`ros2 run turtlesim turtlesim_node --ros-args -r __ns:=demo -r __name:=sim` 跑一遍，再加 `ros2 run turtlesim turtle_teleop_key`——launch 把这一堆塞进一个文件，还能加条件、重启、日志输出重定向等。

---

要不要我把这一题也存成博客文件（`Q3` 标题，放同一个 ROS2 目录，命名类似 `ros2命令行与launch.md`）？确认后我再进入执行。

## 2026-08-25 16:57 用户

帮我详细介绍一下

## 2026-08-25 16:57 助手

本机没装 ROS2（macOS），所以我按原理给你讲透，足够应付面试。下面详细展开。

# Q3. ros2 run / node list / topic list / doctor / launch 详细解析

## 一、先建立总认知

这五个东西分两类：

- **`ros2 run`** 和 **`ros2 launch`** 是"执行者"——它们真正启动程序。
- **`ros2 node list` / `ros2 topic list` / `ros2 doctor`** 是"观察者/诊断者"——只读不改。

所有查询命令都依赖同一个东西：**DDS 的发现机制**。节点启动后通过 DDS 做 participant discovery，把"我存在、我发/收这些话题"广播到整个 domain。所以：
- 没 source 环境、`ROS_DOMAIN_ID` 不一致、网络隔离、发现被防火墙拦 → `node list` 就是空的，这不是 bug。
- 你可以用 `ros2 run` 在**多台机器**上跑，`node list` 能看到它们——因为发现是跨机器的。

---

## 二、`ros2 run <package> <executable> [--args]`

**作用**：找到某个功能包里编译好的可执行文件并运行它，通常是启动一个节点。

**内部流程**：
1. 查 `ament` 的包索引（`AMENT_PREFIX_PATH`），定位 `<package>` 的安装目录；
2. 在 `lib/<package>/` 下找 `<executable>`；
3. 用子进程执行该二进制，把 `--ros-args` 之后的参数传给 ROS 层解析。

**常用子选项（面试能说出两三个就够）**：
- `--ros-args -r __ns:=/demo` → 把节点放进命名空间（等价于 topic/节点名全部前缀）
- `--ros-args -r __node:=my_name` → 重命名节点
- `--ros-args -p param:=value` → 传入参数（对应 Parameter）
- `--ros-args -r /old/topic:=/new/topic` → remap 话题名

```bash
ros2 run turtlesim turtlesim_node --ros-args -r __ns:=/demo -r __node:=sim
```

**面试点**：一个可执行文件 ≠ 一个节点。可执行文件能 `rclcpp::init` 后手动创建多个 `Node`，所以"run 一个 exe"理论上可以起多个节点（虽然 launch 默认一个进程一个节点）。

---

## 三、`ros2 node list`

**作用**：列出当前 ROS 图（graph）中所有**已发现的**节点。

**底层机制**：订阅 rcl 提供的 **graph 信息**（内部是 `/rosout` 和一个专门的 DDS discovery + `/parameter_events` 等内建 topic）。`node list` 展示的是"我在整个 domain 里感知到的参与者"。

**常用子选项**：
- `ros2 node list -a` → 显示所有（含隐藏内建节点，如 `/parameter_events` 相关）
- `ros2 node info <node>` → 查这个节点到底有哪些 pub/sub、service、action、参数——**这是验证 graph 理解的关键命令**：
  ```bash
  ros2 node info /talker
  # 输出它的 Publishers: /chatter、Subscribers: /parameter_events、Services 等
  ```

**面试点**：`node list` 看到的是"人"（计算单元），`topic list` 看到的是"通道"（数据流）。两者靠 `node info` 关联起来——这正是 §Q2 里说的"节点图（graph）语义由 rcl 组装"的体现。

---

## 四、`ros2 topic list`

**作用**：列出当前图里所有话题名。

**子选项**：
- `-t` → 一并显示话题的消息类型：`/chatter [std_msgs/msg/String]`
- `-v` → 详细：类型 + 发布者节点数 + 订阅者节点数

**常用配套命令（面试可以主动提到，显得用过）**：
- `ros2 topic info <topic>` → 类型、pub/sub 各几个
- `ros2 topic echo <topic>` → 实时打印收到的消息（订阅它）
- `ros2 topic pub <topic> <type> 'data: ...' --once` → 命令行手动发一条（调试利器）
- `ros2 topic hz <topic>` → 统计发布频率（传感器是否正常）
- `ros2 topic bw <topic>` → 统计带宽

```bash
ros2 topic pub /cmd_vel geometry_msgs/msg/Twist \
  "{linear: {x: 0.5}, angular: {z: 0.1}}" --rate 10
```

**面试点**：`topic pub/echo/hz` 本质上就是"我临时起一个 rclcpp 节点去发布/订阅"——再次印证 `create_publisher/subscriber` 那套接口。ROS1 里这些是 `rostopic`，几乎一一对应。

---

## 五、`ros2 doctor`

**作用**：系统健康诊断，输出 WARN / ERROR 提示，检查项包括：

- 环境变量：`ROS_DOMAIN_ID`、`RMW_IMPLEMENTATION`、`AMENT_PREFIX_PATH` 是否正确；
- ROS 版本/中间件一致性（比如混用不同版本的包）；
- **重复 source**（循环 source setup.bash 导致的污染）——ROS1 时代的经典问题；
- DDS 相关：当前 rmw 实现、发现可用性；
- 网络/多机配置问题（部分版本会检查）；
- 还支持 `ros2 doctor --report` 输出完整报告，便于排查和贴给社区。

**面试点**：这是 ROS1 没有的统一入口（ROS1 得靠一堆零散脚本）。提问者常问"系统起来但 topic 不通怎么排查"→ 回答顺序：`ros2 doctor` 先看环境 → `node list` 看发现 → `topic list/info` 看通道 → `topic echo` 看数据。

---

## 六、`ros2 launch` 与 launch 系统（重点）

### 6.1 launch 是什么

**launch = 编排层（orchestration）**：用声明式/程序式文件描述"一次运行会话里要启动什么、怎么启动、什么时候启动"，并管理这些进程。

对比：

| | ros2 run | ros2 launch |
|---|---|---|
| 一次启动 | 1 个可执行 | N 个节点 + 参数 + 命名空间 + 条件 |
| 进程管理 | 无（退就退了） | 生命周期、退出码、自动重启、整体 shutdown |
| 复用 | 无 | include 其他 launch、substitution 参数化 |
| 表述 | 命令行 | XML / Python / YAML 文件 |

### 6.2 launch 干了什么（内部流程）

1. **解析 launch 文件**，构建一棵 `LaunchDescription` 树——树的每个叶子是一个 **Action**（最核心的是 `Node` action）；
2. **执行 Node action**：底层等价于 `ros2 run`，但还会替你处理命名空间、remap、参数、`output="screen"`（stdout 重定向）等；
3. **事件驱动运行**：launch 系统有事件循环（launch 框架基于 `launch` 库的事件机制），监听进程退出、`Ctrl-C`、超时等事件；
4. **生命周期管理**：某节点崩溃 → 按 `on_exit` 规则决定是否重启；全部结束或收到 shutdown → 把子进程全部终止，避免僵尸进程；
5. **参数替换（substitution）**：`$(var ...)`（取值）、`$(find pkg)`（定位包路径）、`$(env VAR)`（环境变量）、`$(python ...)` 等，实现"一份 launch，到处复用"；
6. **分层组合**：launch 里可以 `<include>` 别的 launch 文件，组成大系统的启动脚本。

### 6.3 三种格式对比

| 格式 | 特点 |
|---|---|
| XML | ROS1 风格延续，声明式，写简单启动最快 |
| YAML | 声明式，少用 |
| **Python** | 最灵活，能写循环、条件、嵌套函数；目前事实标准，文档示例最多 |

Python 示例（前面给过）：
```python
from launch import LaunchDescription
from launch_ros.actions import Node

def generate_launch_description():
    return LaunchDescription([
        Node(package="turtlesim", executable="turtlesim_node",
             name="sim", namespace="demo"),
        Node(package="turtlesim", executable="turtle_teleop_key",
             output="screen", remappings=[("cmd_vel", "demo/cmd_vel")]),
    ])
```

注意入口函数名必须是 `generate_launch_description()`。

### 6.4 面试必答的坑：ROS1 vs ROS2 的进程模型

- **ROS1 `roslaunch`**：能在**一个进程里跑多个 node**（通过参数指定机器和进程），且有 nodelet（共享内存、单进程多节点）。
- **ROS2 launch**：**默认每个 node 一个独立进程**——隔离性好、崩一个不影响别的，但进程数多、通信要走 DDS 序列化。
- 想回到"单进程多节点"（低延迟、共享内存）→ 用 **composable node**（ROS1 nodelet 的等价物），配合 `rmw` 的 intra-process 通道，通过 `ComposableNodeContainer` 在 launch 里组装。

这往往是面试官挖的最后一个点：**"ROS2 为什么要默认每节点一进程？答：进程隔离、崩溃隔离、语言混用（C++/Python 节点混跑）；代价是开销大，所以给了 composable node 兜底。"**

---

## 七、一张表收尾（面试速记）

| 命令 | 一句话 | 底层依赖 |
|---|---|---|
| `ros2 run pkg exe` | 启动包里一个可执行（节点） | ament 包索引 + 进程执行 |
| `ros2 node list` | 列已发现的节点（"人"） | DDS 发现 + rcl graph |
| `ros2 topic list` | 列话题（"通道"） | DDS 发现 + rcl graph |
| `ros2 doctor` | 环境/配置健康诊断 | 环境检查 + DDS 探测 |
| `ros2 launch pkg file` | 一次编排 N 节点 + 参数 + 进程管理 | launch 库 + launch_ros |

---

内容已完整。计划：按 Q2 的规范存为博客文件

`/Users/bohn/04_Project/06_MyWeb/BohnChen.github.io/content/posts/StudyRecord/ROS2/ros2命令行与launch是什么.md`

front matter：title="ros2 run / node list / topic list / doctor / launch 分别干什么"，categories ["ROS2"]，tags ["ROS2","面试","技术学习"]，正文即上面结构（含命令表格、代码示例、ROS1/ROS2 进程模型对比）。

确认后我进入执行写入。文件名你也可以改。
