BohnChen/PickOrangeDummy/docs/DummyArm_for_VENTUNO/2_对话记录/opencode/2026-08-26_简历项目技术细节模拟面试.md

---
tool: opencode
session_id: ses_fc3444874ffeaPUZ6rU9oQG1PH
model: deepseek-v4-flash
date: 2026-08-26 14:22
updated: 2026-08-26 14:31
---

# 简历项目技术细节模拟面试

> 工具: opencode · 模型: deepseek-v4-flash · 会话: ses_fc3444874ffeaPUZ6rU9oQG1PH

## 2026-08-26 14:22 用户

针对我的简历/Users/bohn/02_Personal/06_JobMaterial/resume/resume_embed_robot.tex,我们一起来深挖一下，两个项目的技术方案涉及到的技术细节，相当于模拟面试中考官会出的问题。

网盘项目地址在：/Users/bohn/02_Personal/06_JobMaterial/project/net_disk_4.0

灵犀 X2 项目在：https://github.com/BohnChen/AgiRobot-X2-Development.git其中用到的是aimdk的官方二次开发 sdk。

## 2026-08-26 14:23 助手

两个项目的代码我都已经完整读过一遍了（网盘项目全部源码 + X2 的 `exam_invigilator_patrol.py`、`responder.py`、`debug_voice.py`、`x2_voice_chat`、`play_tts.py` 以及关键 `.msg/.srv` 定义）。我先把核心技术点梳理出来，再确认一下你想要的深挖形式。

**我已经掌握的"弹药"（初步提炼）：**

- **网盘项目**：epoll + 线程池架构、`train_t` 定长头解决粘包、双连接设计（命令连接 + 文件传输连接，token 二次登录）、`sendfile()` 服务端 / `splice()` 客户端零拷贝、MD5 引用计数秒传、`lseek` 断点续传、虚拟文件表（parent_id 树）、SHA-512 加盐（`$6$`）、环形队列 30s 超时断开、每操作日志。**同时也发现了不少面试官爱挖的坑**：全局 `username` 变量线程共享、`chdir()` 全局状态、MySQL 每次查询新建连接、SQL 字符串拼接注入风险、`count` 并发更新竞态、内存泄漏（pNew 不 free）、`while(1);` 死循环代码残留、`srand(time(NULL))` 重复调用等。
- **灵犀 X2**：巡检状态机（等待开考语音→行走→检测→转向 90°→对话）、Vosk 离线 ASR + VAD 触发（BEGIN/PROCESSING/END）、开考命令语法、Seed TTS（豆包，台湾腔）→ 系统 PlayTts 多级降级链、音频焦点管理（RequestAudioFocus/AbandonAudioFocus）、LLM（DeepSeek/Qwen）模板双降级、运动输入源注册抢占（priority）、`McLocomotionVelocity` 周期发布、预设动作（RAISE_HAND/POINT_HEAD 等）、SIGINT 优雅退出。

在动手前，我想确认几个关键选择：

## 2026-08-26 14:25 助手

研究完成，两个项目的代码细节我已全部掌握。下面是深挖文档的完整计划。

## 计划：两个项目的面试技术深挖 Q&A 文档

**产出文件**：`/Users/bohn/02_Personal/06_JobMaterial/interview_prep/projects_deep_dive.md`（新建 `interview_prep/` 目录）

**文档结构**（按"项目 → 技术层 → 问题条目"组织）：

### 第一部分：Linux 网络文件管理系统（C）
1. **架构与并发模型** — epoll 主循环 + 预创建线程池 + 任务队列（互斥锁/条件变量）的协作方式；为什么用 epoll 而非 select/poll；线程池线程数参数化
2. **协议设计** — `train_t`（data_len + buf[1000]）定长头帧协议如何解决 TCP 粘包/半包；**双连接模型**（命令连接 + 文件传输连接）的动机；`recvn/sendn` 处理半包
3. **认证与安全** — 注册/登录三步握手流程；`$6$` SHA-512 加盐 `crypt()`；token 二次登录如何防止伪造文件传输连接；SQL 拼接注入风险与改进
4. **文件传输三大特性** — 服务端 `sendfile()` vs 客户端 `splice()`（pipe 中转）零拷贝原理与区别；`lseek` 断点续传（为什么 splice 场景不能 append）；MD5 引用计数秒传（count 字段 + rm 时文件池删除条件）
5. **超时与运维** — 环形队列 30s 超时断开的实现原理；操作日志全量记录
6. **面试官爱挖的坑** — 全局 `username` 跨线程共享、`chdir()` 全局进程状态、MySQL 每次查询建连（无连接池）、`count` 并发竞态、pNew 内存泄漏、`while(1);` 残留、`srand` 重复调用等，每项给出"如何承认 + 如何改进"

### 第二部分：智元灵犀 X2 考场巡检机器人（Python/ROS2）
1. **ROS2 通信架构** — Topic/Service 分工（速度/手部/音频 Topic vs 动作/TTS/焦点 Service）；BEST_EFFORT QoS 选型
2. **语音链路** — Vosk 离线 ASR + VAD 状态机（BEGIN/PROCESSING/END 组装音频缓冲）；开考指令语法识别（`use_command_grammar` + 常见误识别词兜底）；为什么用线程处理 ASR
3. **TTS 多级降级链** — Seed TTS（豆包，台湾腔 voice prompt）→ 系统 `PlayTts` → 跳过；音频焦点请求/释放；PCM 流式发布到 `/aima/hal/audio/playback`
4. **运动控制** — 输入源注册抢占（priority=40）；`McLocomotionVelocity` 周期发布实现移动；SetMcAction（LOCOMOTION_DEFAULT/STAND_DEFAULT）；预设动作（RAISE_HAND/POINT_HEAD）；手势 fallback（HandCommandArray）
5. **巡检状态机** — 等待开考语音 → 逐轮巡逻（前进→检测→转向 90°）→ 违规响应；信号优雅退出（SIGINT/SIGTERM 只置标志）
6. **LLM 对话** — DeepSeek/Qwen 调用 + 历史上下文 + 模板降级（responder.py）；台湾腔 system prompt
7. **坑与追问** — "检测结果"实为人工输入（`read_detected_item`），真实视觉检测的替代方案；`estimated_duration` 等待 vs 真实播放完成回调；service 超时与重试策略

### 第三部分：交叉与自我辩护
- 简历每个 bullet → 底层机制 → 可能考题 对照表
- "请说说这个项目最大的缺陷"类问题的推荐应答口径

**每道题的格式**：`问题 | 考察点 | 参考答案（含 file:line 引用）| 追问链`

开始执行时我会按上述结构直接产出完整文档。确认后我就退出计划模式开始写。

## 2026-08-26 14:26 用户

开始

## 2026-08-26 14:28 助手

代码已全部掌握，开始写深挖文档。

## 2026-08-26 14:31 助手

已生成 `/Users/bohn/02_Personal/06_JobMaterial/interview_prep/projects_deep_dive.md`，37 道题全部带 `问题 | 考察点 | 参考答案(含代码位置) | 追问链`，外加简历对照表和 30 秒自述稿。

**核心亮点（高价值题）**：
- 网盘：双连接模型、train_t 粘包（含"命令通道其实没加帧"的诚实点）、sendfile/splice 零拷贝、秒传引用计数、环形队列时间轮
- 灵犀 X2：VAD 状态机 + Vosk 语法识别、Seed→系统 TTS 降级链、输入源注册抢占、音频焦点
- **面试官最爱攻击的坑已替你备好辩护口径**：全局 `username` 跨线程、`chdir()` 进程级状态、MySQL 无连接池、SQL 注入、内存泄漏、count 竞态、`read_detected_item` 人工输入

建议优先演练标 ⚠️ 的 Q16/Q17/Q18/Q20/Q22/Q26/Q36，这是最高概率被追问的点。需要我针对某几题再展开，或改成一问一答的模拟演练吗？
