BohnChen/PickOrangeDummy/docs/calib/aruco_40mm.pdf

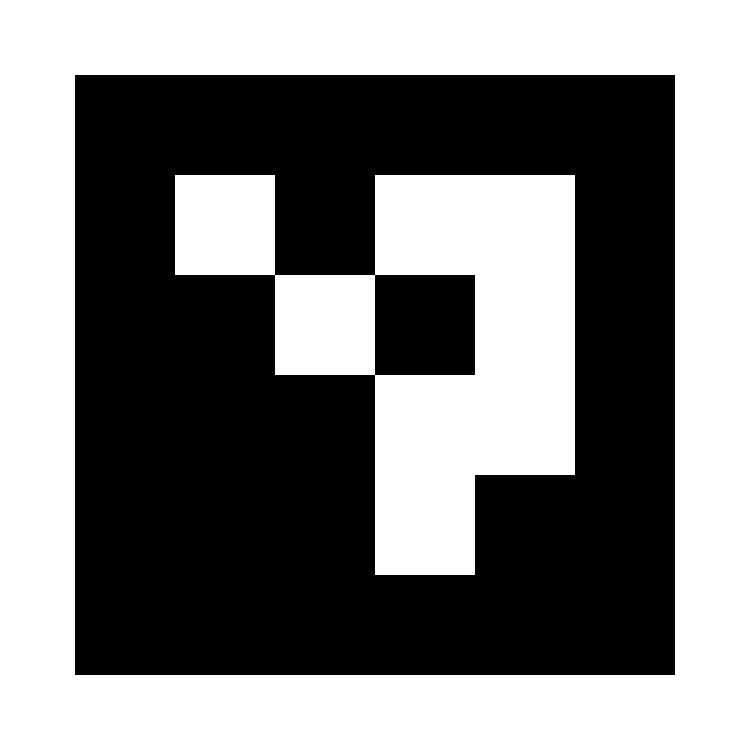
[picture p4: page 1]
