BohnChen/PickOrangeDummy/docs/diagrams/01-layers.png

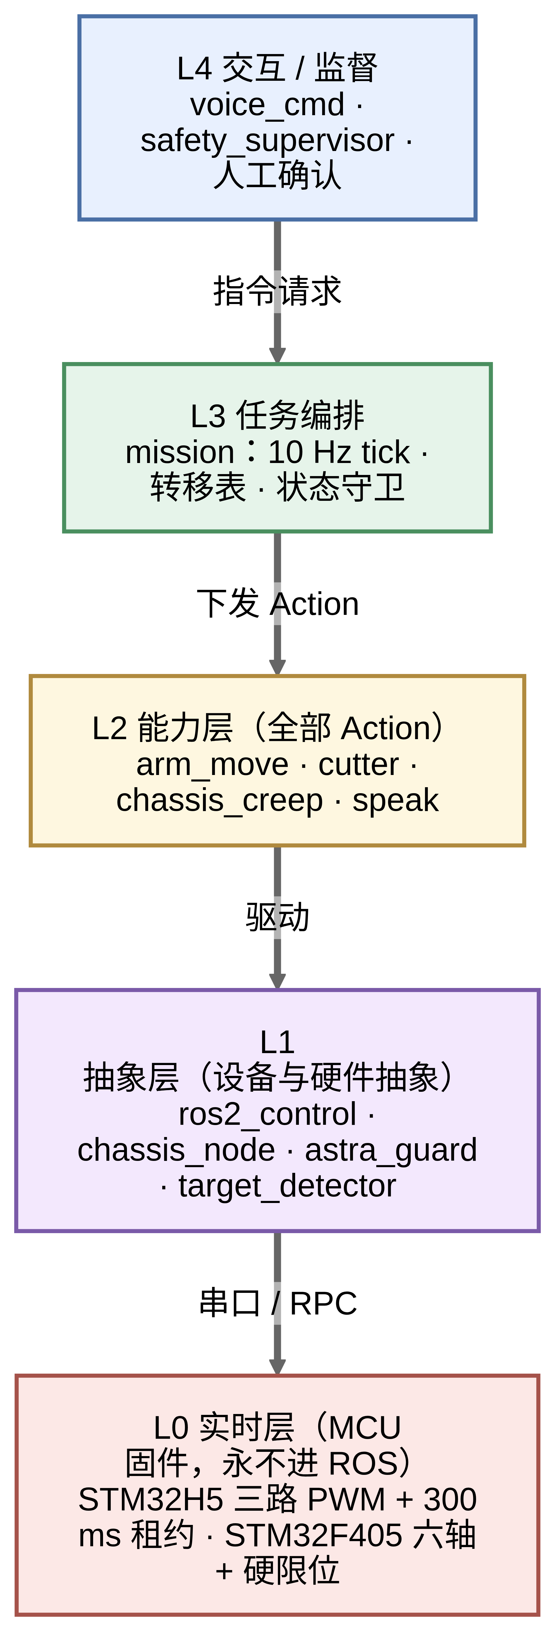
docs/diagrams/01-layers.png
