BohnChen/PickOrangeDummy/docs/diagrams/02-processes.png

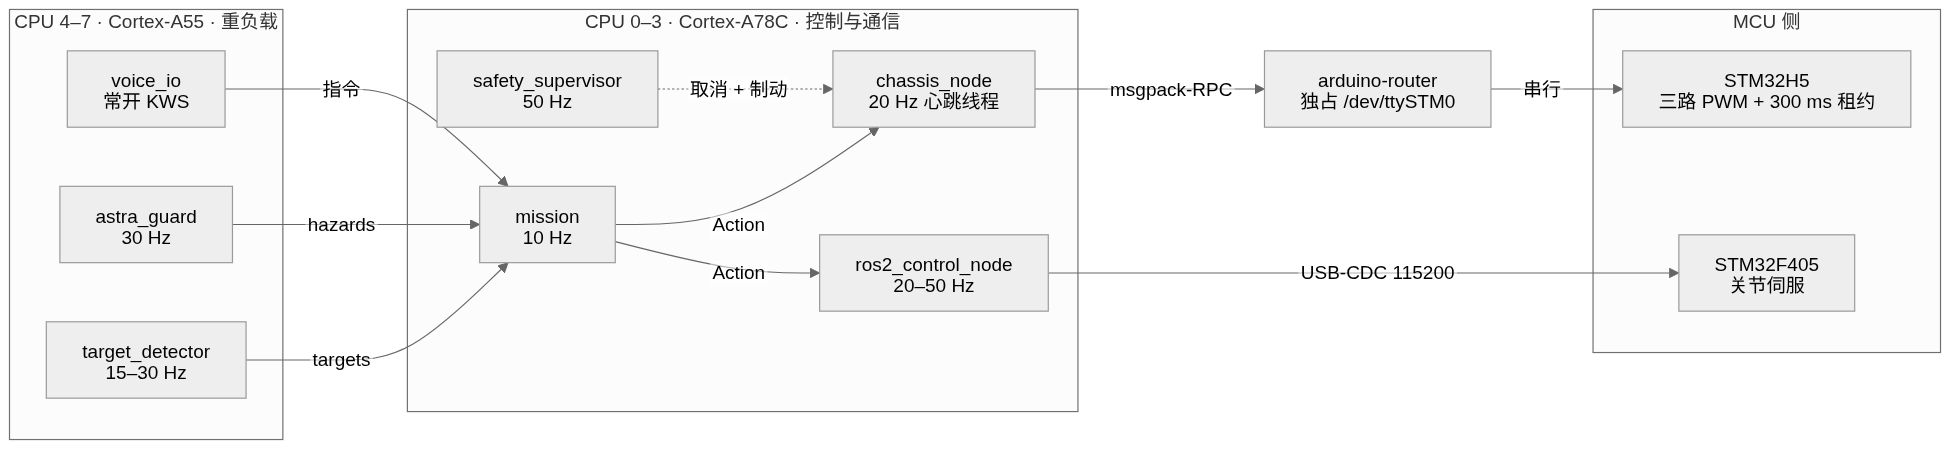
docs/diagrams/02-processes.png
