BohnChen/PickOrangeDummy/docs/diagrams/03-topics.png

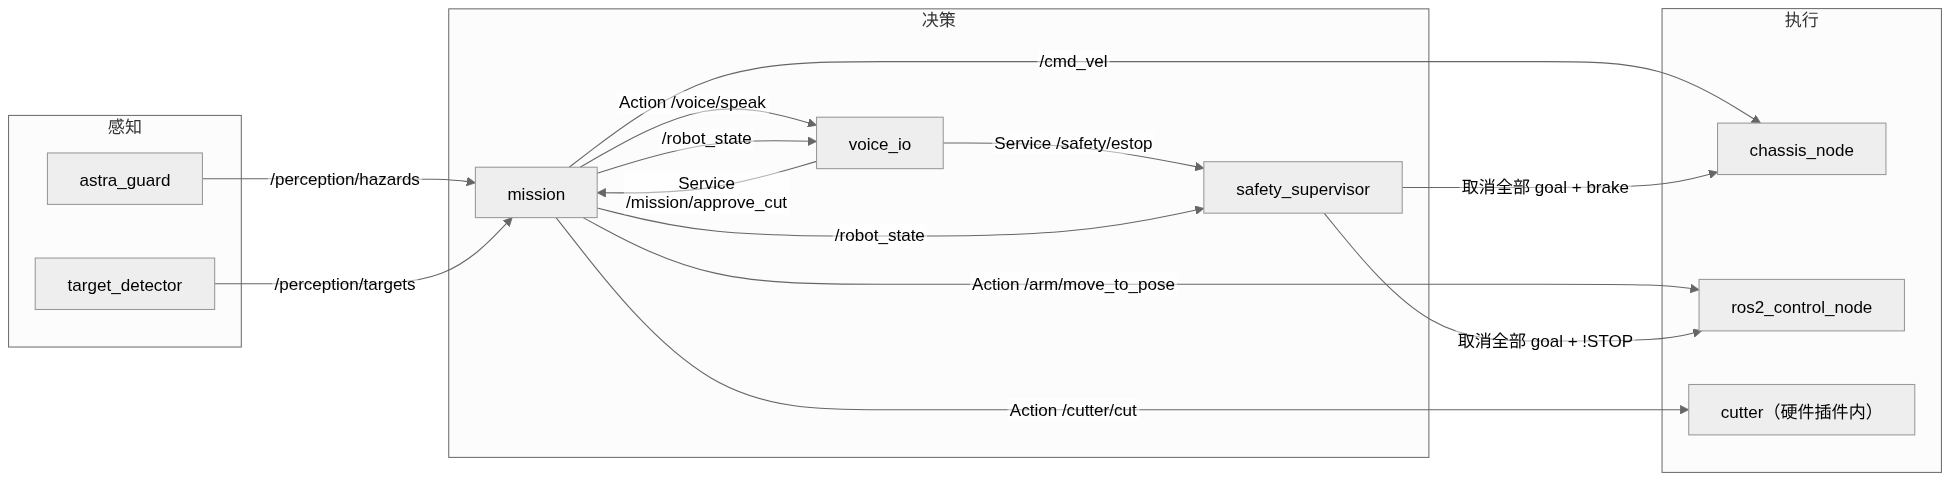
docs/diagrams/03-topics.png
