BohnChen/PickOrangeDummy/docs/diagrams/04-tf.png

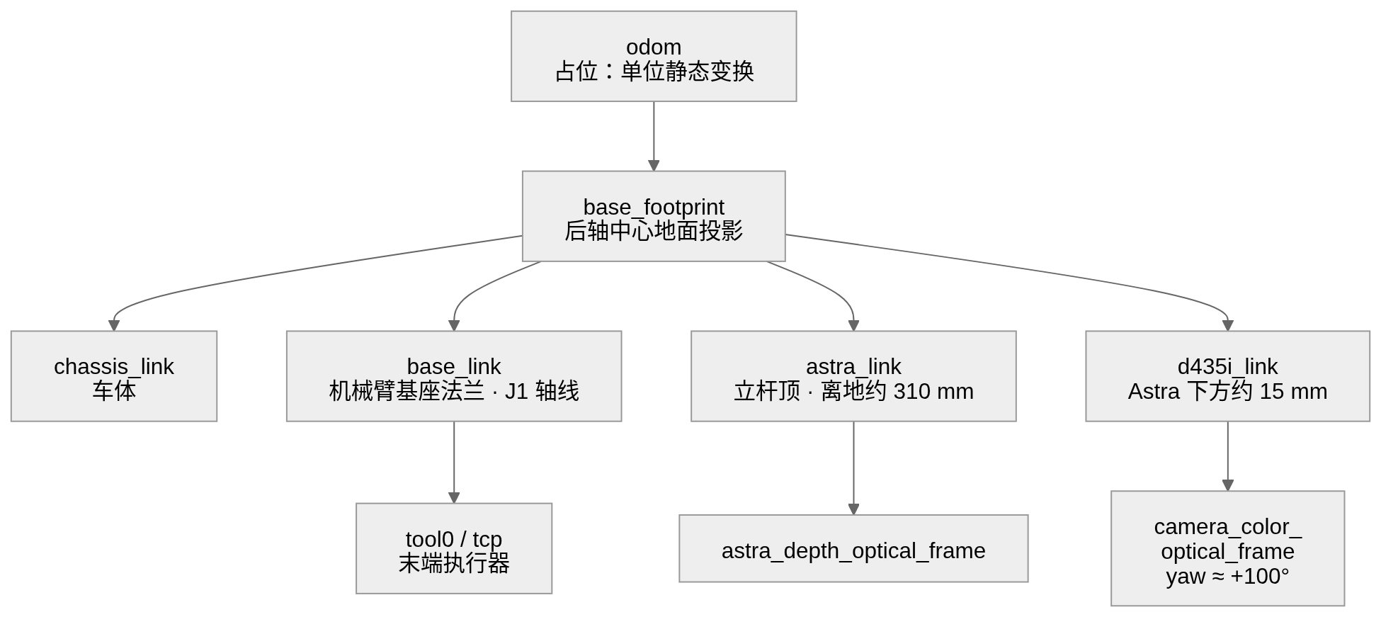
docs/diagrams/04-tf.png
