BohnChen/PickOrangeDummy/docs/diagrams/05-mission-fsm.png

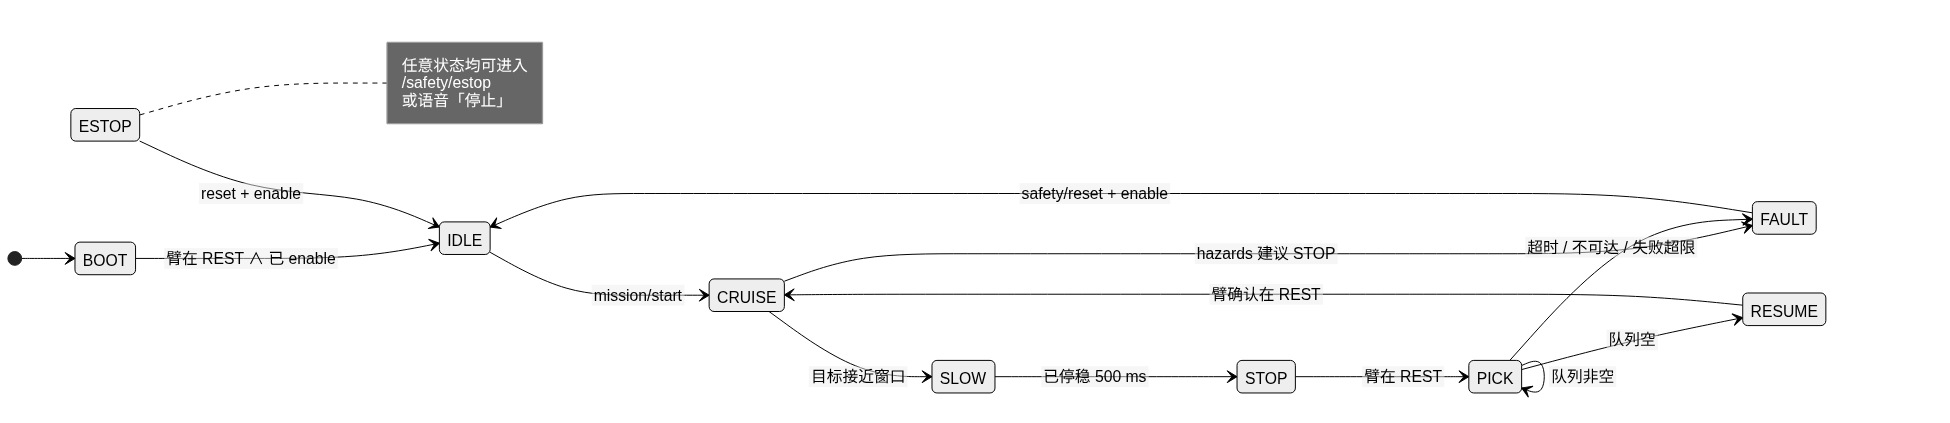
docs/diagrams/05-mission-fsm.png
