BohnChen/PickOrangeDummy/docs/diagrams/05b-pick-subfsm.png

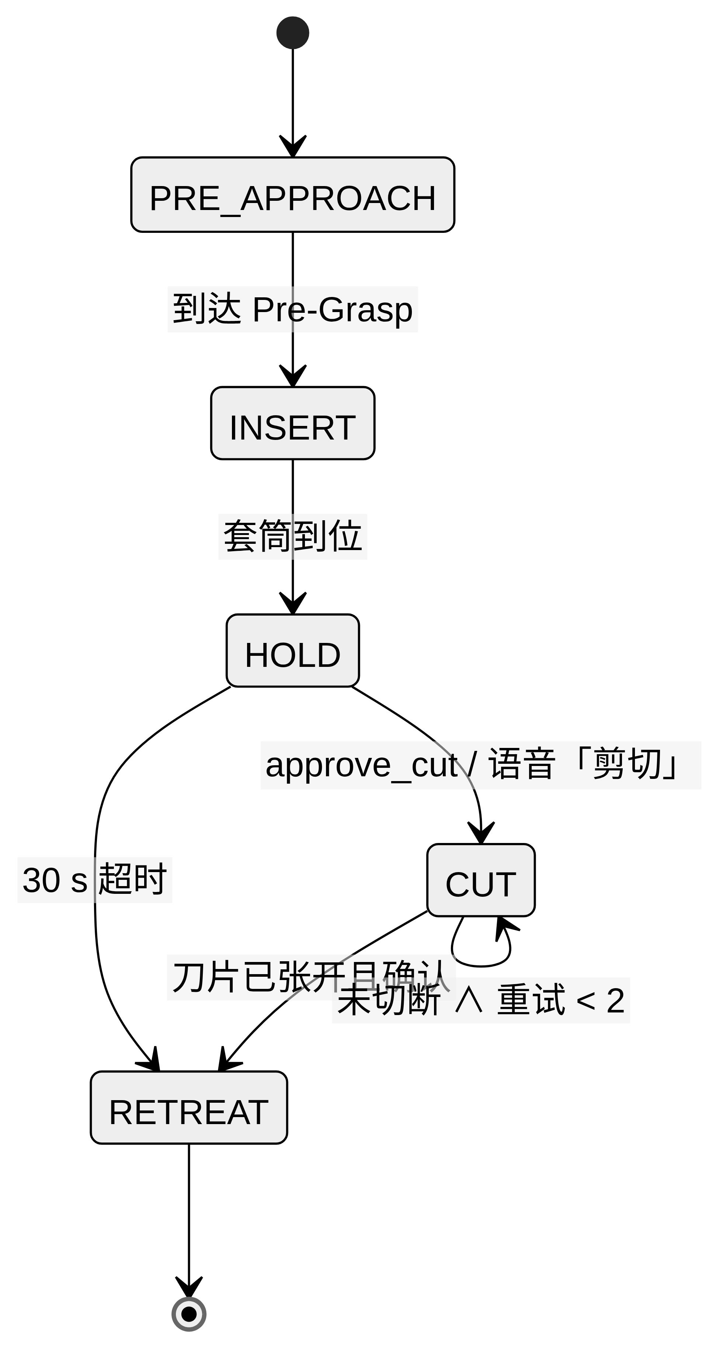
docs/diagrams/05b-pick-subfsm.png
