BohnChen/PickOrangeDummy/docs/diagrams/06-harvest-sequence.png

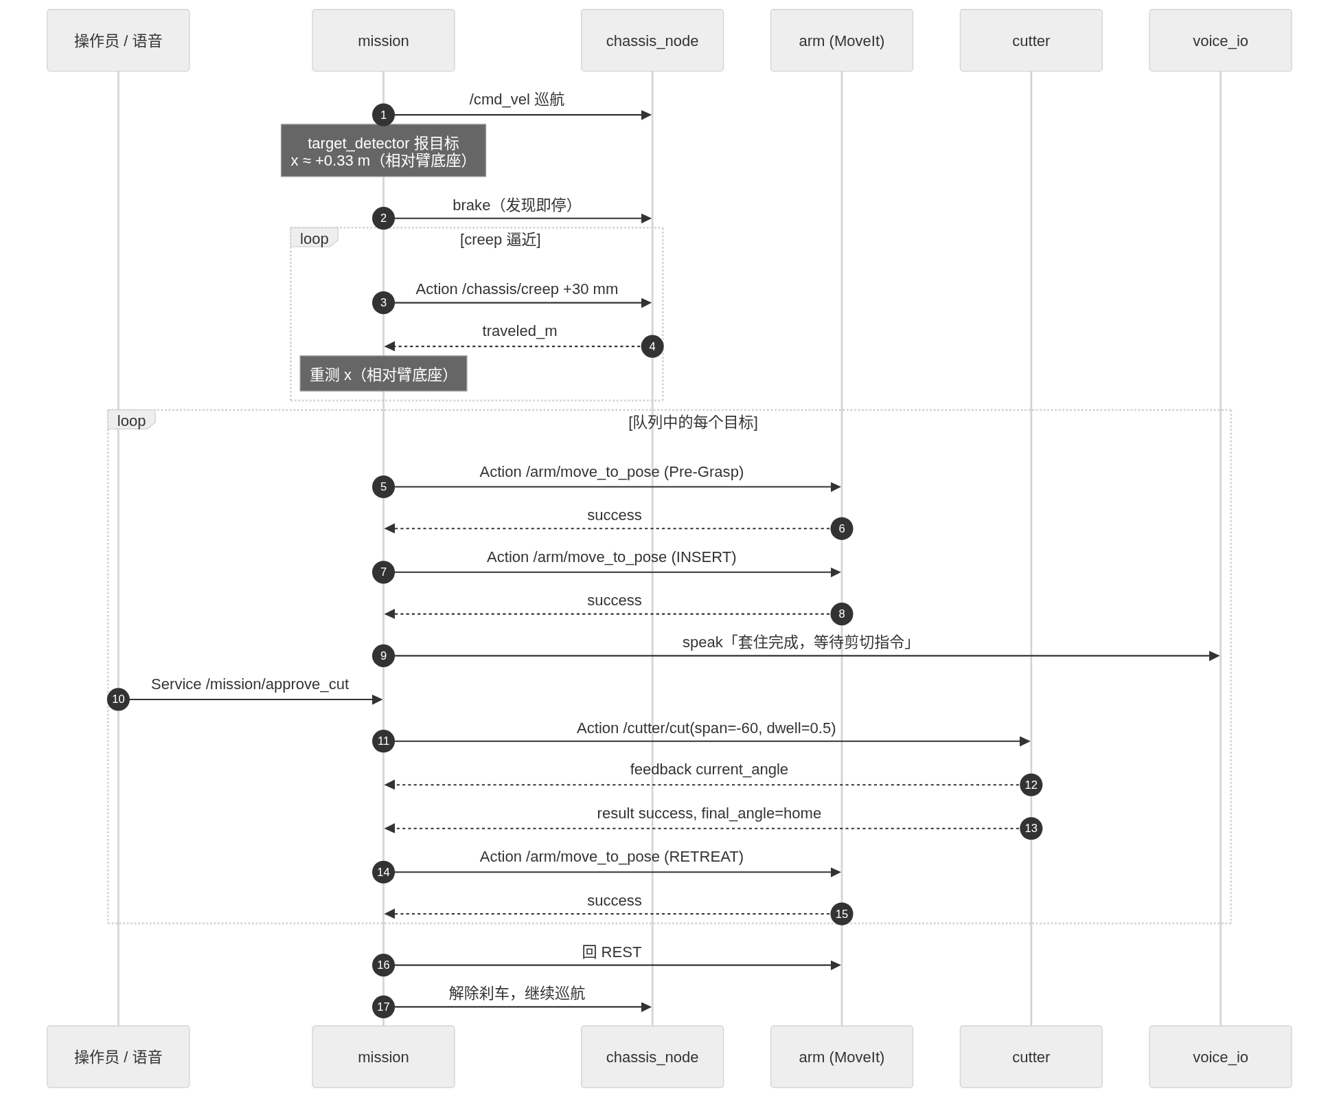
docs/diagrams/06-harvest-sequence.png
