BohnChen/PickOrangeDummy/docs/diagrams/07-parking.png

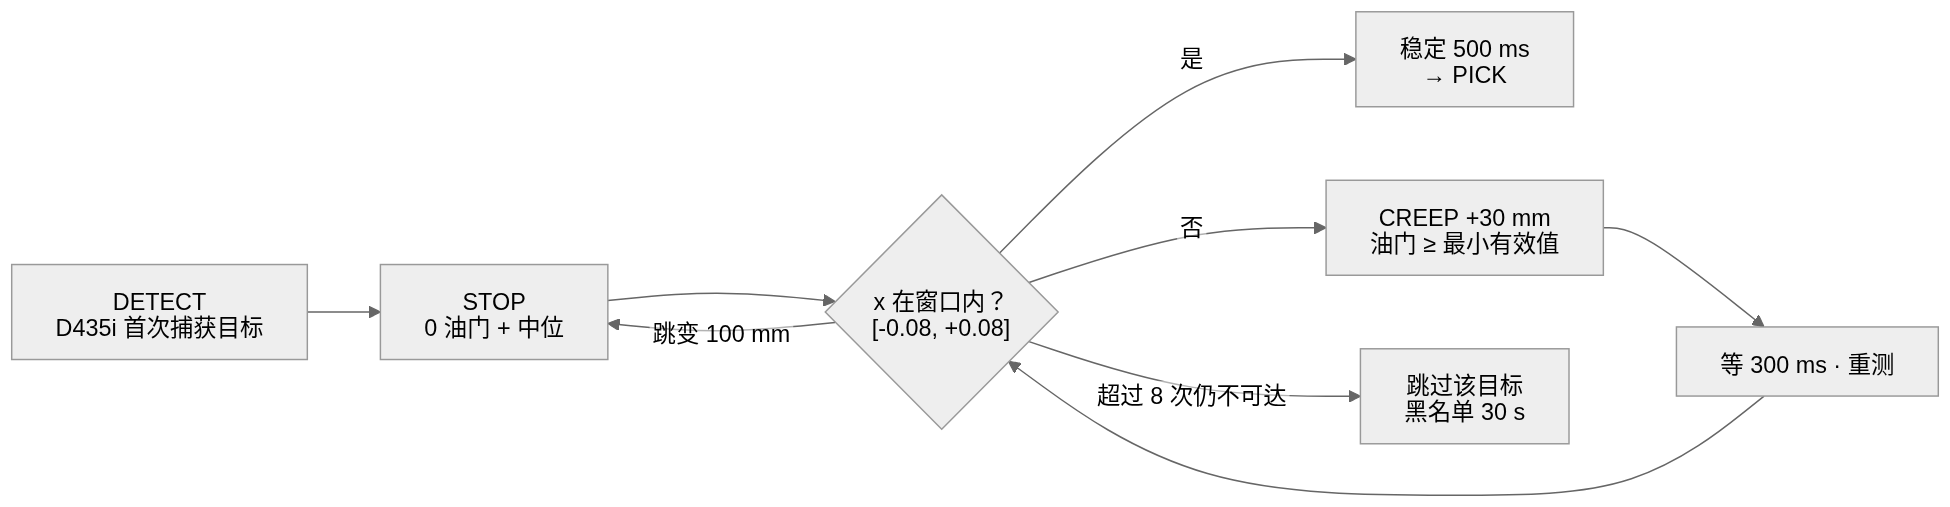
docs/diagrams/07-parking.png
