BohnChen/PickOrangeDummy/docs/diagrams/08-safety.png

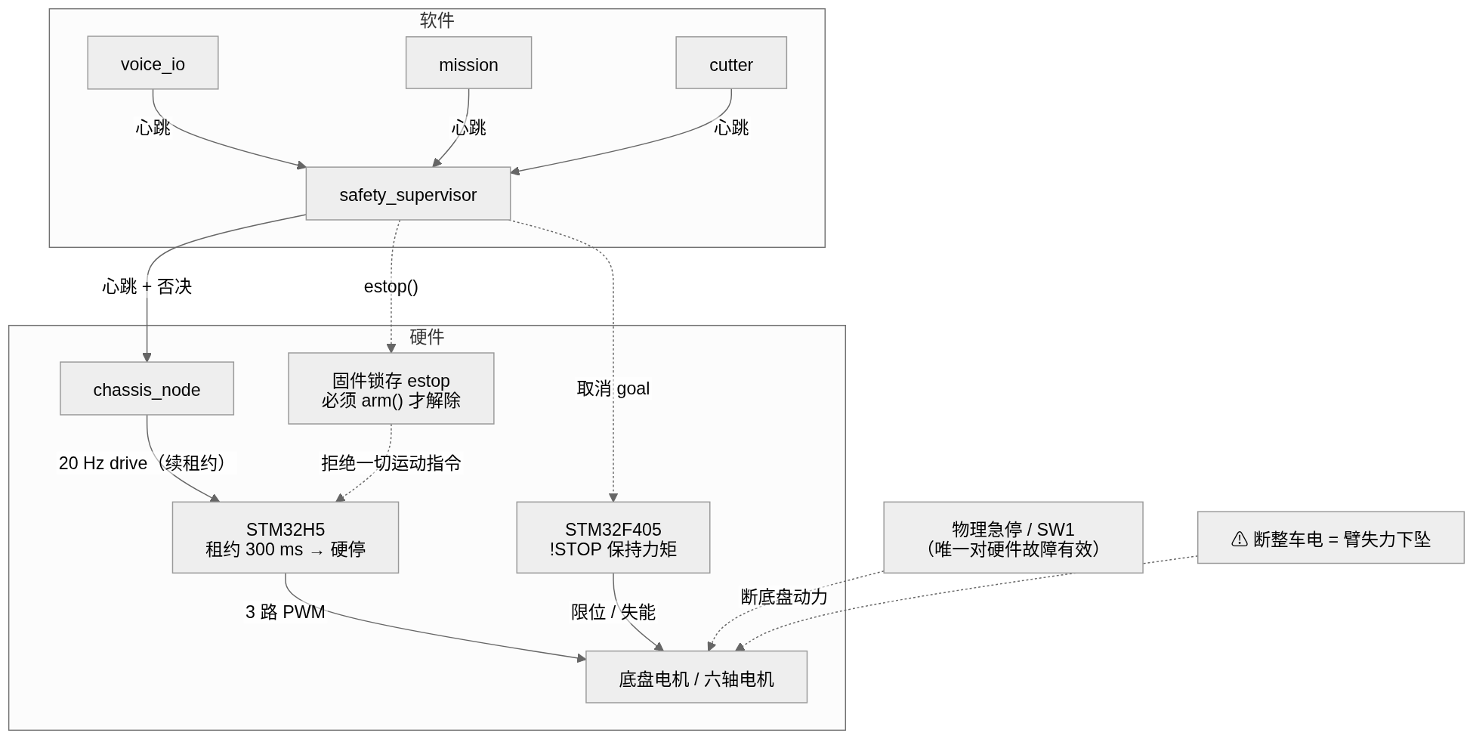
docs/diagrams/08-safety.png
