BohnChen/PickOrangeDummy/docs/diagrams/09-voice.png

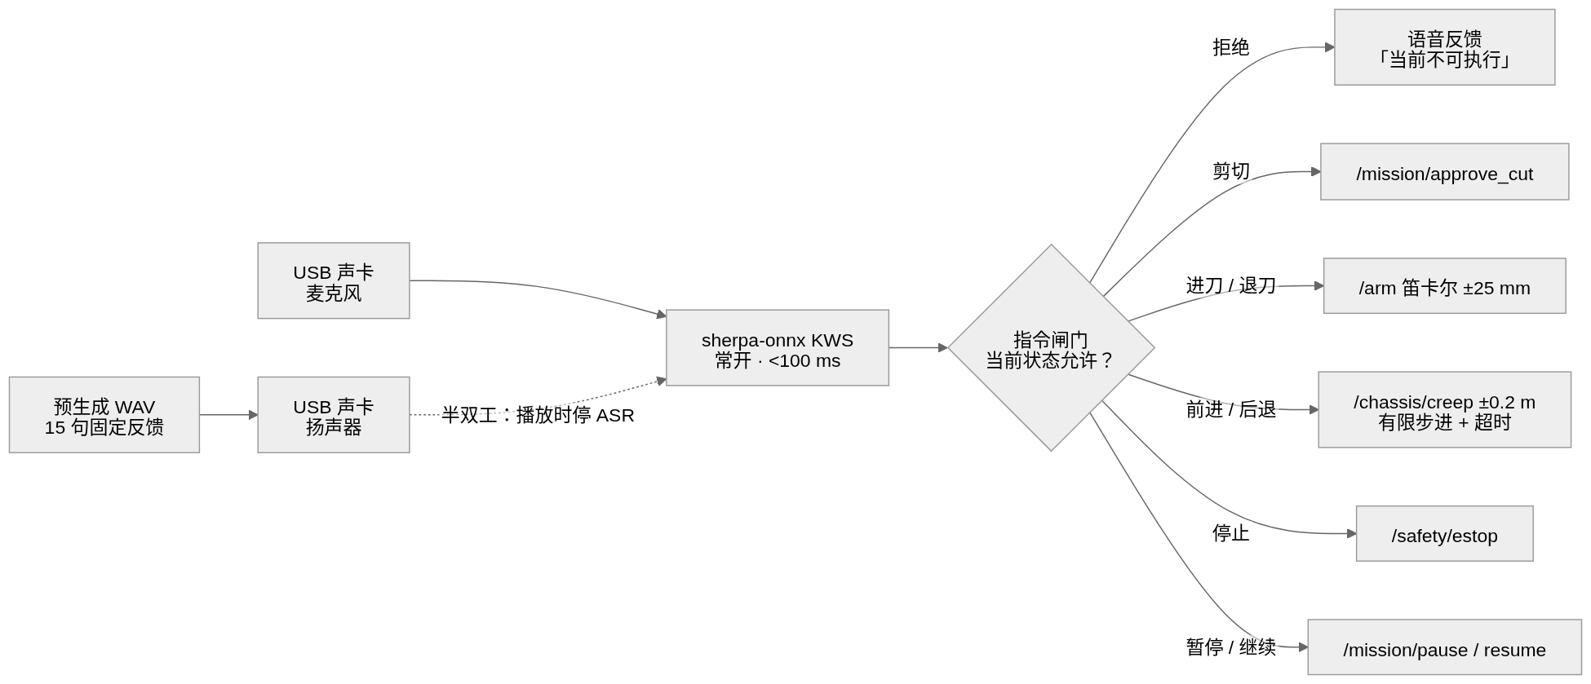
docs/diagrams/09-voice.png
