BohnChen/PickOrangeDummy/docs/diagrams/11-milestones.png

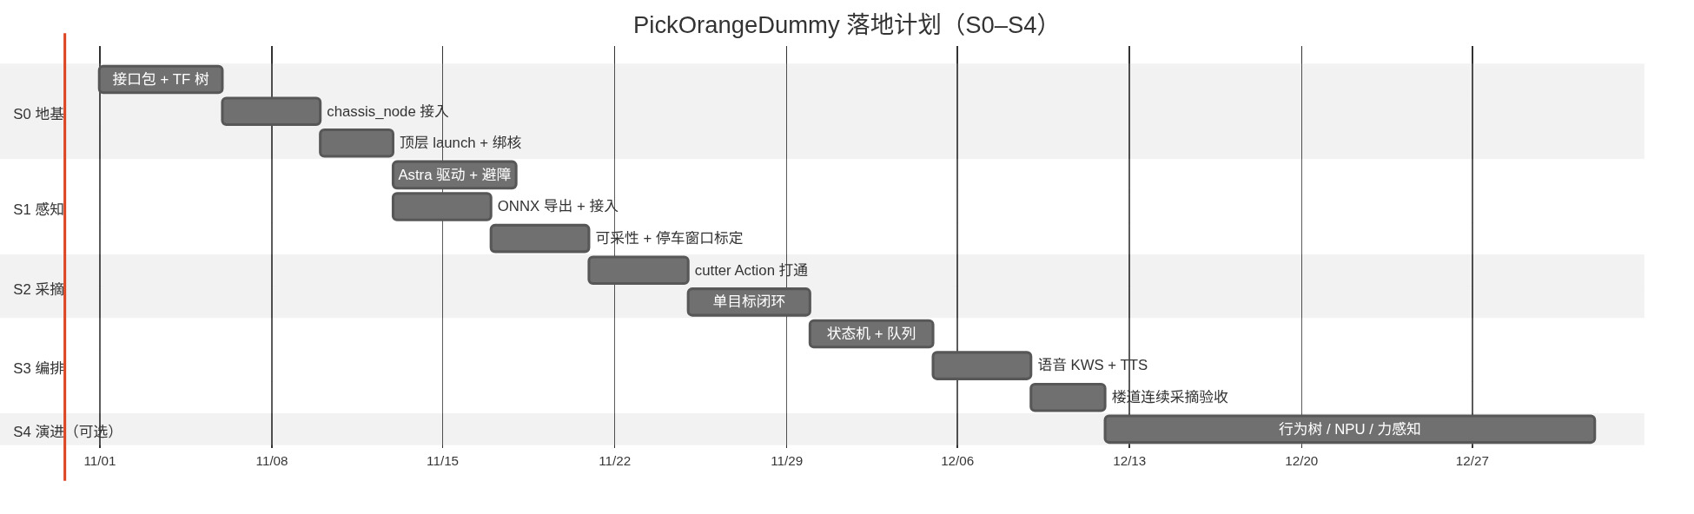
docs/diagrams/11-milestones.png
