BohnChen/PickOrangeDummy/models/profile_out/preview.png

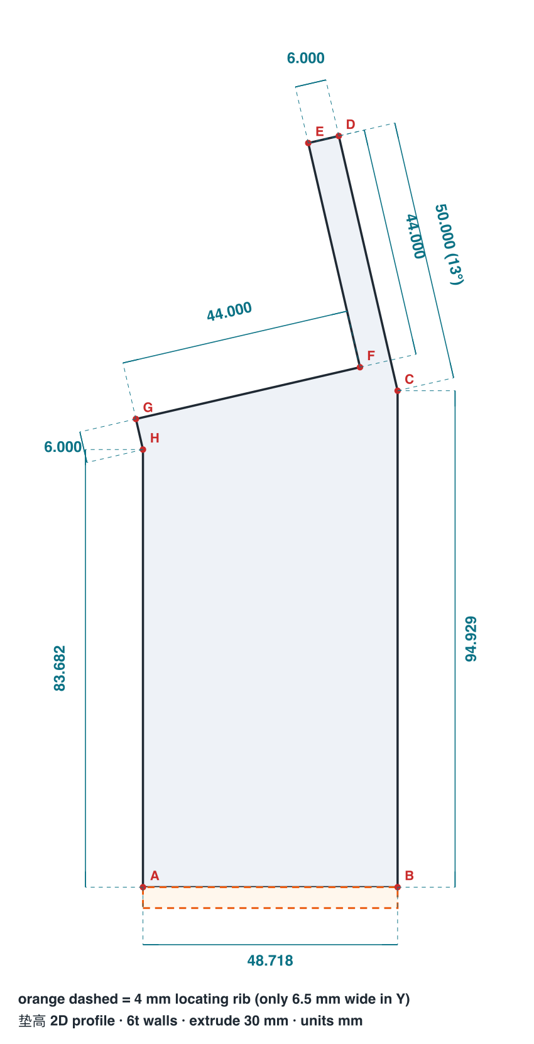
models/profile_out/preview.png
