BohnChen/PickOrangeDummy/presentation_assets/photo_jpg/IMG_5588.jpg

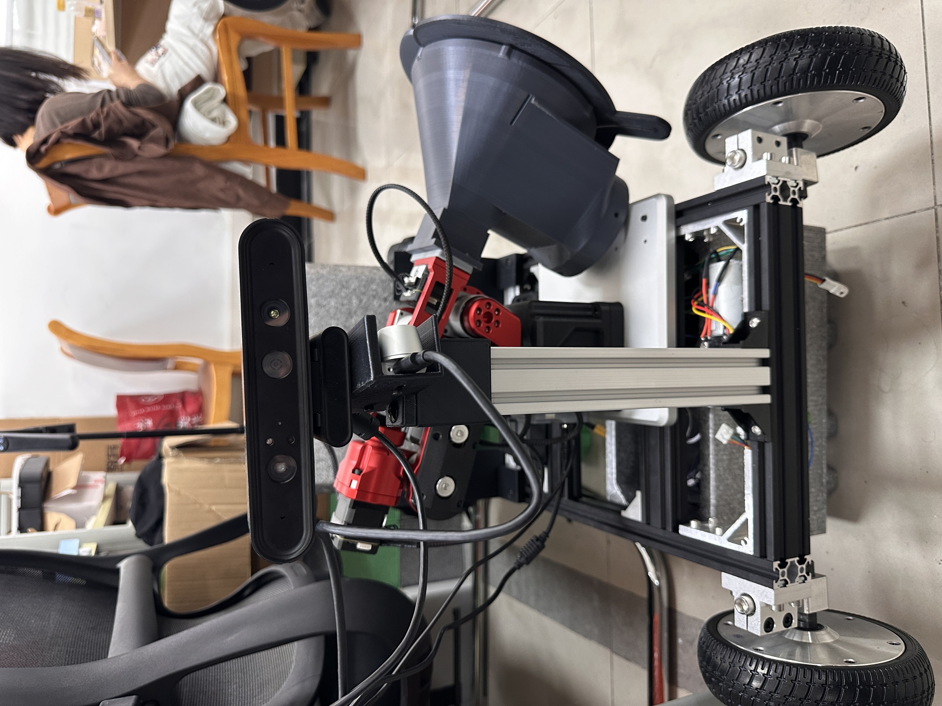
presentation_assets/photo_jpg/IMG_5588.jpg
