BohnChen/PickOrangeDummy/presentation_assets/photo_jpg/IMG_5589.jpg

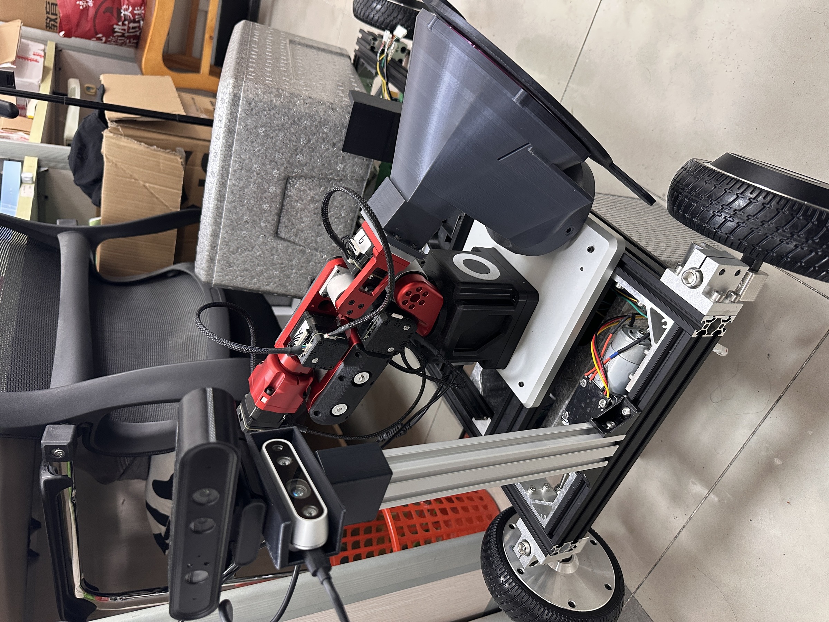
presentation_assets/photo_jpg/IMG_5589.jpg
