BohnChen/PickOrangeDummy/presentation_assets/photo_jpg/IMG_5590.jpg

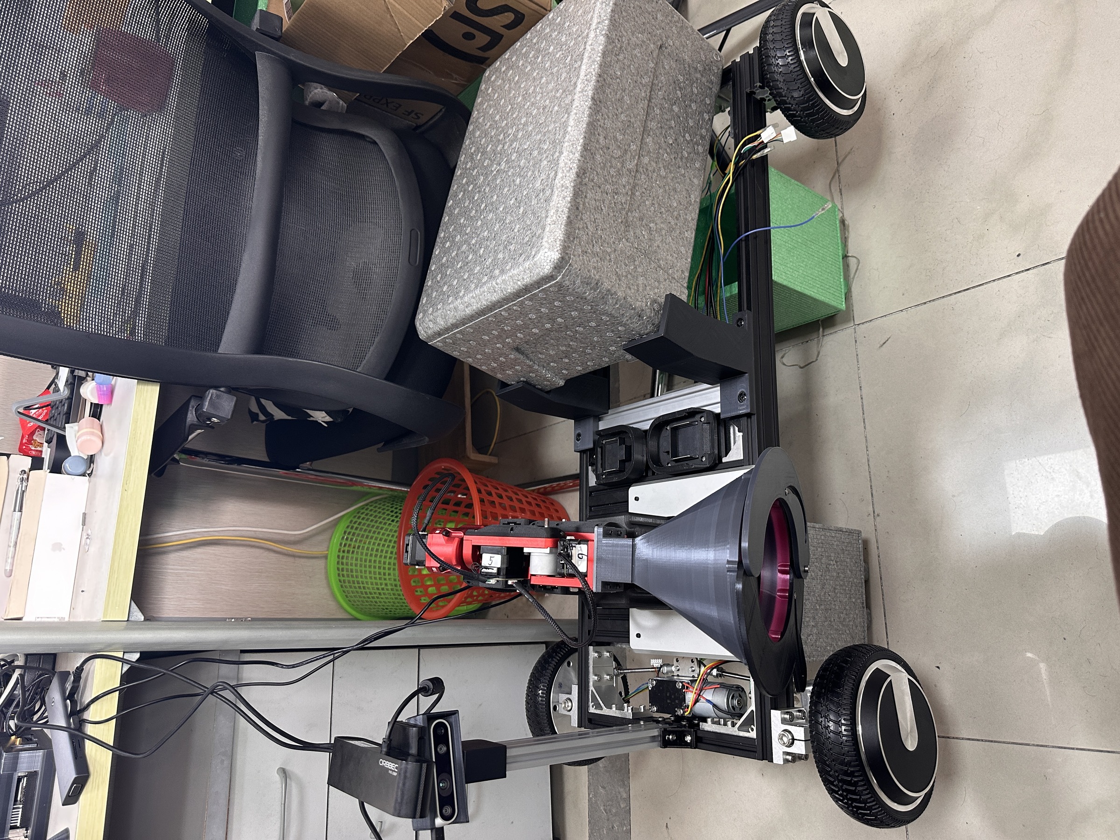
presentation_assets/photo_jpg/IMG_5590.jpg
