BohnChen/PickOrangeDummy/presentation_assets/video_frames/v1_10s.jpg

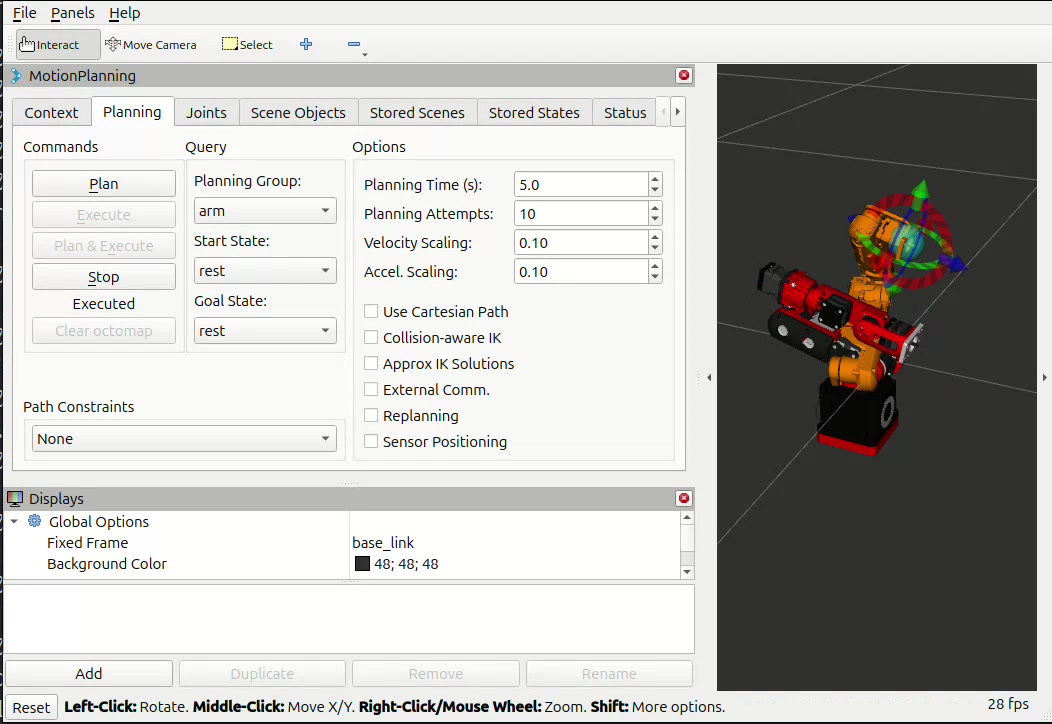
presentation_assets/video_frames/v1_10s.jpg
