BohnChen/PickOrangeDummy/presentation_assets/video_frames/v2_45s.jpg

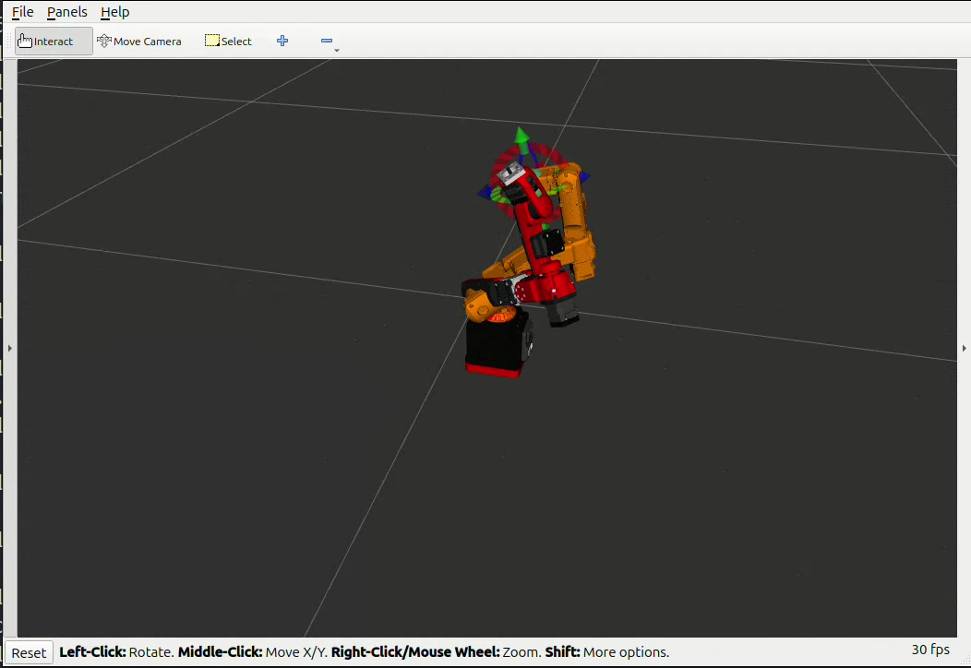
presentation_assets/video_frames/v2_45s.jpg
