BohnChen/PickOrangeDummy/presentation_assets/video_frames/v4_10s.jpg

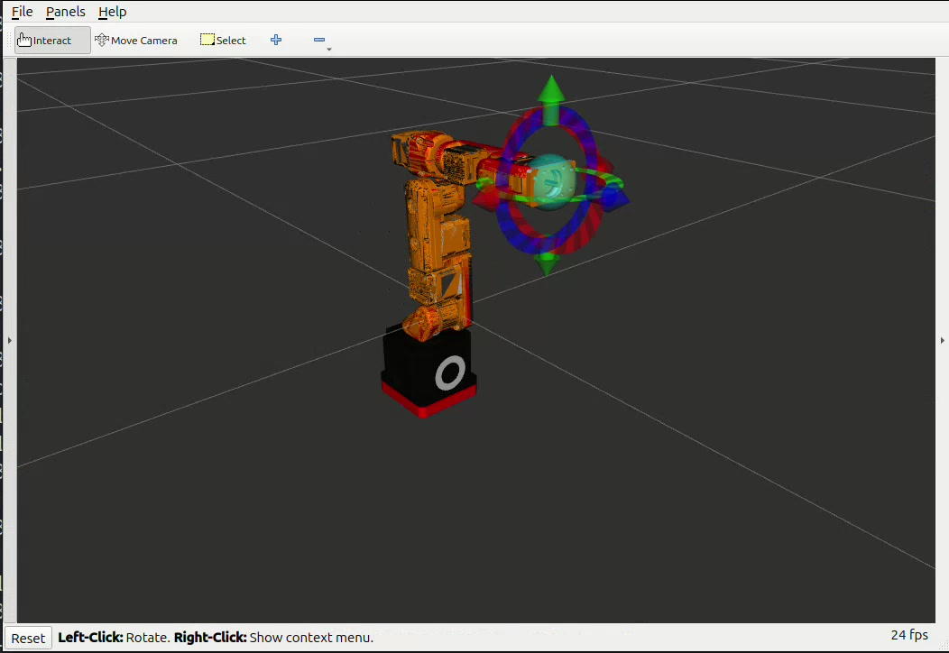
presentation_assets/video_frames/v4_10s.jpg
