BohnChen/PickOrangeDummy/presentation_assets/video_frames/v5_05s.jpg

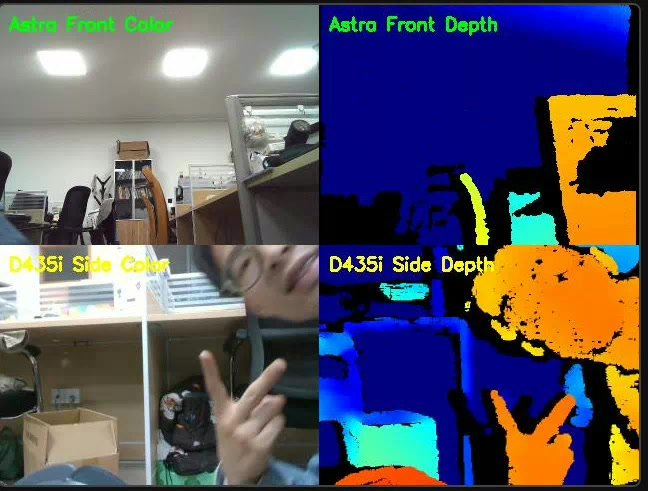
presentation_assets/video_frames/v5_05s.jpg
