BohnChen/PickOrangeDummy/presentation_assets/video_frames/v5_12s.jpg

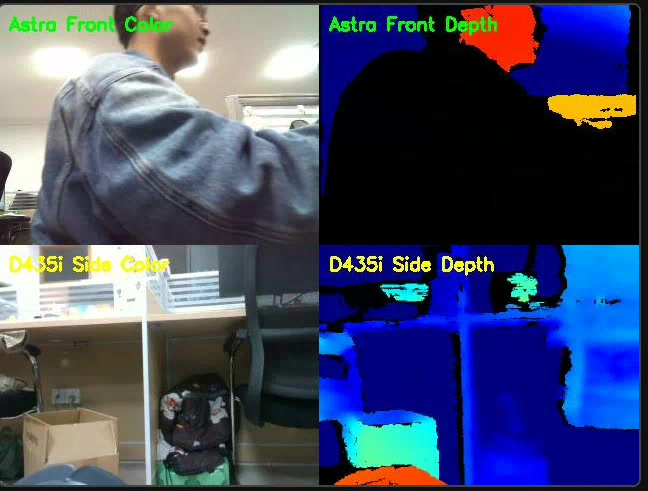
presentation_assets/video_frames/v5_12s.jpg
