BohnChen/PickOrangeDummy/docs/DummyArm_for_VENTUNO/4_来源清单.md

# 来源清单（本包内每个文件的原始出处）

> 用途：追溯每个文件的来源，核对是否拷错/拷漏。原始文件在 Mac 上，未做内容改动，仅拷贝。

## 顶层新增（本包内新生成的说明文档，非拷贝）

| 本包文件 | 说明 |
|---|---|
| `0_先读我_项目总纲.md` | 新生成：给 VENTUNO opencode 的总纲 |
| `3_资源地图.md` | 新生成：代码/资料在 Mac 上的位置与拷贝命令 |
| `4_来源清单.md` | 本文件 |

## 1_规划文档（拷贝自 Mac 上的成品文档）

| 本包文件 | 原始路径 |
|---|---|
| `DummyArm-ROS2-Grasp-项目蓝图.md` | `/Users/bohn/Documents/Codex/2026-07-29/dummyarm-ros2-grasp/outputs/DummyArm-ROS2-Grasp-项目蓝图.md` |
| `DummyArm-硬件参数采集表.md` | `/Users/bohn/Documents/Codex/2026-07-29/dummyarm-ros2-grasp/outputs/DummyArm-硬件参数采集表.md` |
| `求职投递与项目并行计划.md` | `/Users/bohn/Documents/Codex/2026-07-31/w/outputs/求职投递与项目并行计划.md` |
| `项目计划书_精简版_面向低位柑橘采摘的自主移动机器人.txt` | `/Users/bohn/Documents/Huaxu/项目计划书_精简版_面向低位柑橘采摘的自主移动机器人.txt` |
| `项目计划书_面向低位柑橘采摘的自主移动机器人.txt` | `/Users/bohn/Documents/Huaxu/项目计划书_面向低位柑橘采摘的自主移动机器人.txt` |
| `柑橘采摘机器人技术方案.md` | `/Users/bohn/Documents/ObsidianFolder/AINote/keysPattern/gemini/柑橘采摘机器人技术方案.md` |
| `发明专利控制方法_逻辑作用与创新性说明.md` | `/Users/bohn/Documents/Codex/2026-06-19/ppt-ppt-ppt-1000-rgb-2025/outputs/发明专利控制方法_逻辑作用与创新性说明.md` |
| `发明专利控制方法_公式与专业术语详解.md` | `/Users/bohn/Documents/Codex/2026-06-19/ppt-ppt-ppt-1000-rgb-2025/outputs/发明专利控制方法_公式与专业术语详解.md` |

## 2_对话记录/opencode（拷贝自对话归档）

| 本包文件 | 原始路径 |
|---|---|
| `2026-07-31_机器人求职投递与项目并行计划.md` | `/Users/bohn/Documents/ObsidianFolder/AINote/conversations/opencode/2026-07/2026-07-31_机器人求职投递与项目并行计划.md` |
| `2026-07-31_Explore_dummy_robot_SDK_explore_subagent.md` | `…/opencode/2026-07/2026-07-31_Explore_dummy_robot_SDK_explore_subagent.md` |
| `2026-07-31_Explore_AgiRobot_X2_code_explore_subagent.md` | `…/opencode/2026-07/2026-07-31_Explore_AgiRobot_X2_code_explore_subagent.md` |
| `2026-08-25_ROS2面试题_rclcpp_rcl_rmw_DDS四层介绍.md` | `…/opencode/2026-08/2026-08-25_ROS2面试题_rclcpp_rcl_rmw_DDS四层介绍.md` |
| `2026-08-25_ROS2_四层架构面试准备.md` | `…/opencode/2026-08/2026-08-25_ROS2_四层架构面试准备.md` |
| `2026-08-26_简历项目技术细节模拟面试.md` | `…/opencode/2026-08/2026-08-26_简历项目技术细节模拟面试.md` |

> 注：以上原始路径中 `…/conversations/` 均指 `/Users/bohn/Documents/ObsidianFolder/AINote/conversations/`。
> 原始 opencode 全量会话还存于 `/Users/bohn/.local/share/opencode/opencode.db`（本包未含）。

## 2_对话记录/codex（拷贝自对话归档）

| 本包文件 | 原始路径 |
|---|---|
| `2026-06-04_你可以帮我写我的第一个机器人项目吗.md` | `…/codex/2026-06/2026-06-04_你可以帮我写我的第一个机器人项目吗.md` |
| `2026-06-11_你可以看到HuxXu_graspnet_deploy_项目下的文件吗.md` | `…/codex/2026-06/2026-06-11_你可以看到HuxXu_graspnet_deploy_项目下的文件吗.md` |
| `2026-07-17_我需要将我的项目按照特定要求进行阐述…md` | `…/codex/2026-07/2026-07-17_我需要将我的项目按照特定要求进行阐述_在阐述前_我会告诉你这是一个什么项目_以及.md` |
| `2026-07-29_codex_delegation_source_thread_id_0.md` | `…/codex/2026-07/2026-07-29_codex_delegation_source_thread_id_0.md` |
| `2026-07-29_mac_M4_MAX_可以跑机器人的仿真吗…md` | `…/codex/2026-07/2026-07-29_mac_M4_MAX_可以跑机器人的仿真吗_比如Mojoco_或者Issac.md` |

## 2_对话记录/claude-code（拷贝自对话归档）

| 本包文件 | 原始路径 |
|---|---|
| `2026-07-24_优化简历内容.md` | `…/claude-code/2026-07/2026-07-24_优化简历内容.md` |

## 2_对话记录（根目录）

| 本包文件 | 原始路径 |
|---|---|
| `关于我.md` | `/Users/bohn/Documents/ObsidianFolder/AINote/conversations/关于我.md` |

---

### 核对建议

在 VENTUNO 上可用一条命令校验行数与 Mac 原文件一致（示例）：

```bash
wc -l /Users/bohn/Documents/DummyArm_for_VENTUNO/1_规划文档/* /Users/bohn/Documents/DummyArm_for_VENTUNO/2_对话记录/**/*.md
```

拷贝失败/缺文件时，以本清单「原始路径」为准重新拷贝。
