BohnChen/PickOrangeDummy/models/diandao_front_left.stl

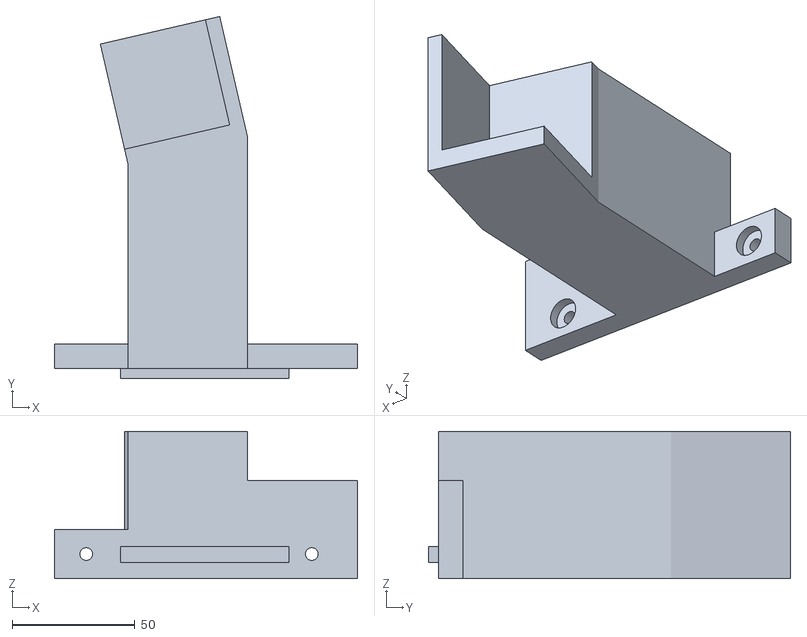
[picture p28: CAD file, 2026-11-01]
models/diandao_front_left.stl
123.7 x 147.6 x 60.0
