BohnChen/PickOrangeDummy/models/profile_out/dian_gao_rib.dxf

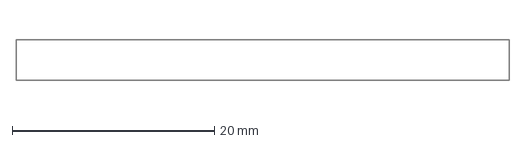
[picture p29: CAD file, 2026-11-01]
models/profile_out/dian_gao_rib.dxf
48.7 x 4.00 mm
