BohnChen/PickOrangeDummy/src/dummyarm_cad_description/meshes/35_20Motor_Assembly/J5_collision.stl

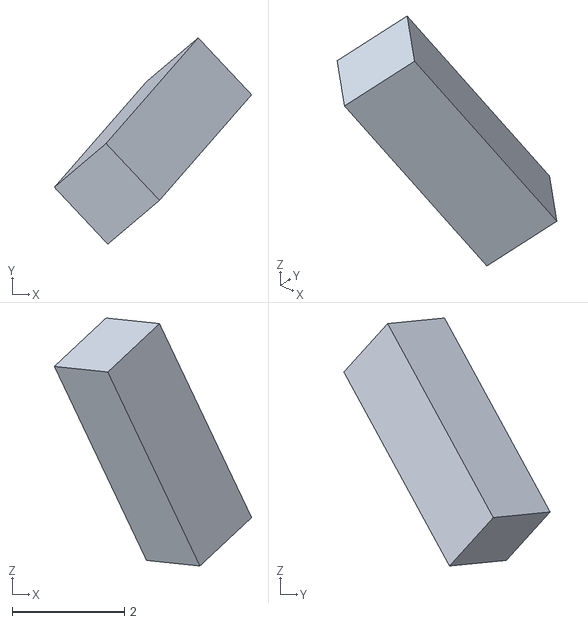
[picture p30: CAD file, 2026-09-09]
src/dummyarm_cad_description/meshes/35_20Motor_Assembly/J5_collision.stl
3.51 x 3.67 x 4.41
