BohnChen/PickOrangeDummy/src/dummyarm_cad_description/meshes/35_20Motor_Assembly_1/J6_collision.stl

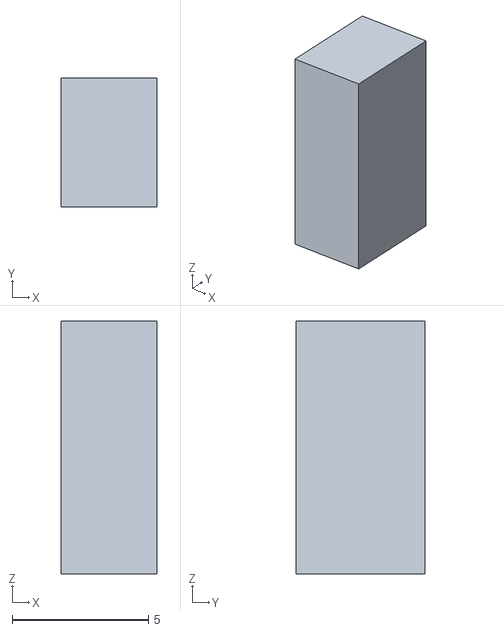
[picture p31: CAD file, 2026-09-09]
src/dummyarm_cad_description/meshes/35_20Motor_Assembly_1/J6_collision.stl
3.52 x 4.76 x 9.30
