BohnChen/PickOrangeDummy/src/dummyarm_cad_description/meshes/base_link/base_link_collision.stl

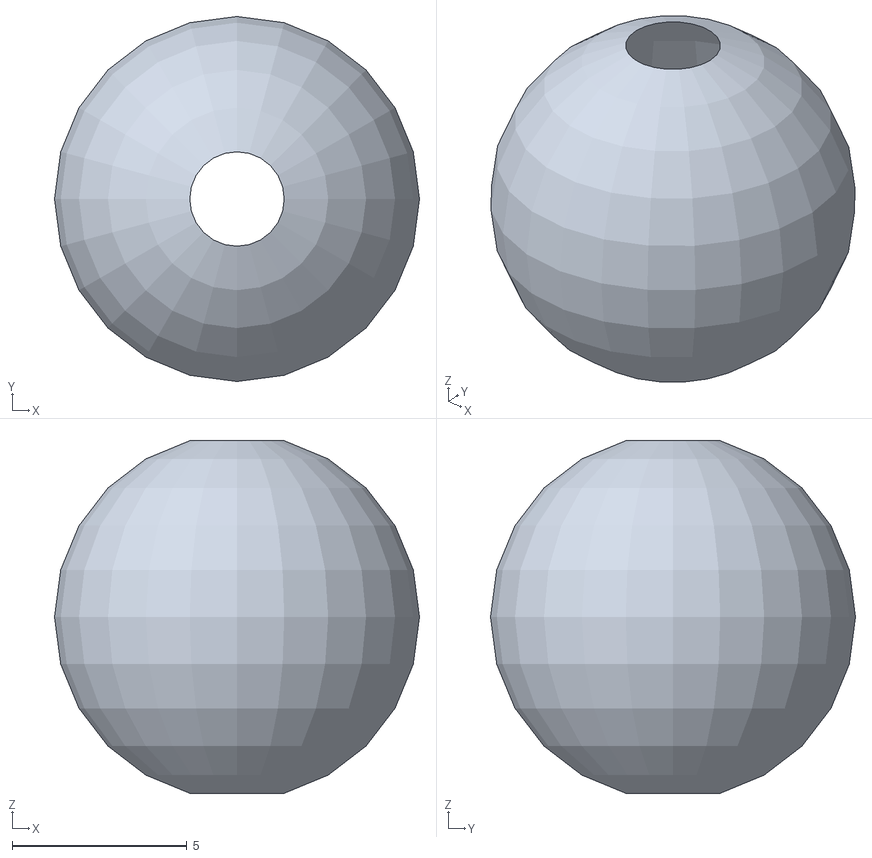
[picture p32: CAD file, 2026-09-09]
src/dummyarm_cad_description/meshes/base_link/base_link_collision.stl
10.5 x 10.5 x 10.5
