BohnChen/PickOrangeDummy/src/dummyarm_cad_description/meshes/J1/J1_collision.stl

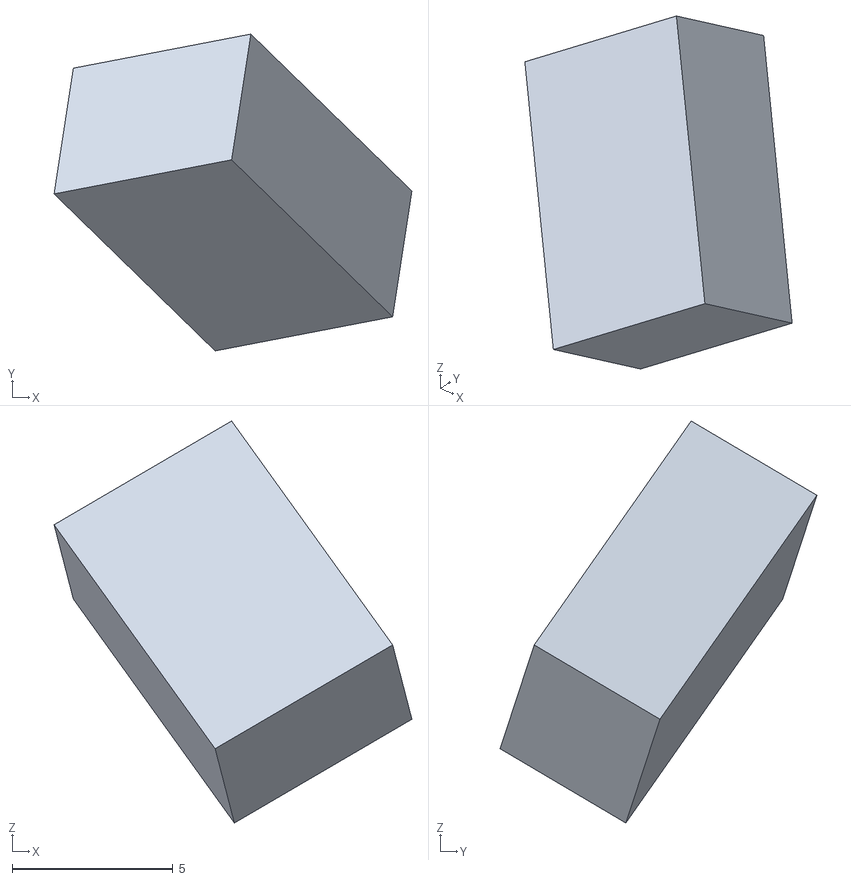
[picture p33: CAD file, 2026-09-10]
src/dummyarm_cad_description/meshes/J1/J1_collision.stl
11.1 x 9.86 x 12.5
