BohnChen/PickOrangeDummy/src/dummyarm_cad_description/meshes/J2J3/J2J3_collision.stl

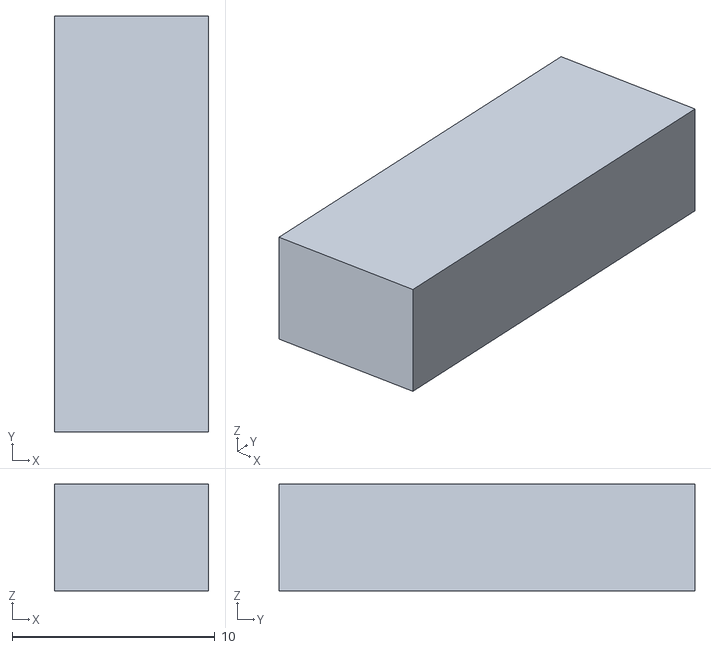
[picture p34: CAD file, 2026-09-09]
src/dummyarm_cad_description/meshes/J2J3/J2J3_collision.stl
7.60 x 20.5 x 5.26
