BohnChen/PickOrangeDummy/src/dummyarm_cad_description/meshes/J4/J4_collision.stl

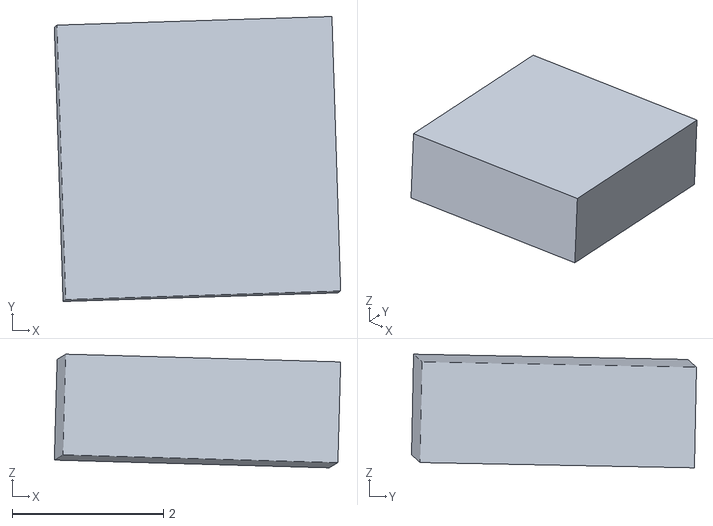
[picture p35: CAD file, 2026-09-09]
src/dummyarm_cad_description/meshes/J4/J4_collision.stl
3.79 x 3.77 x 1.50
