BohnChen/PickOrangeDummy/src/dummyarm_cad_description/meshes/tool0/tool0_collision.stl

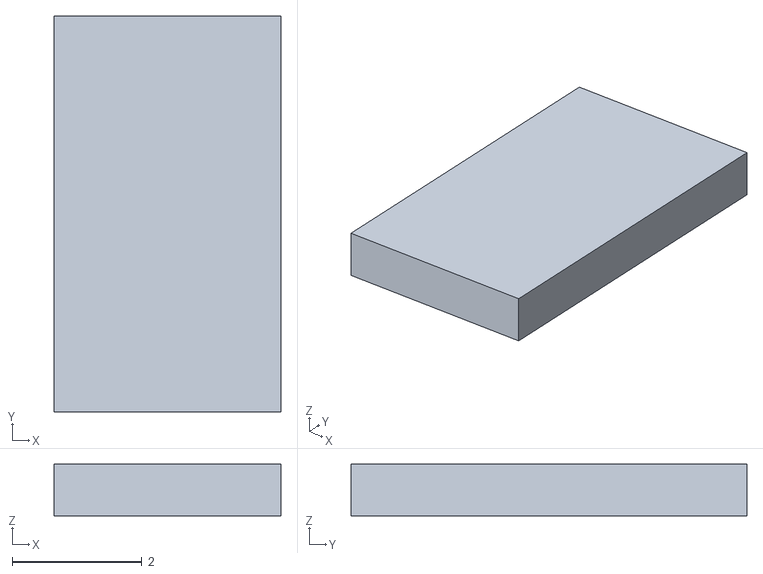
[picture p36: CAD file, 2026-09-10]
src/dummyarm_cad_description/meshes/tool0/tool0_collision.stl
3.50 x 6.10 x 0.8
