BohnChen/PickOrangeDummy/src/dummyarm_description/meshes/arm_J23.stl

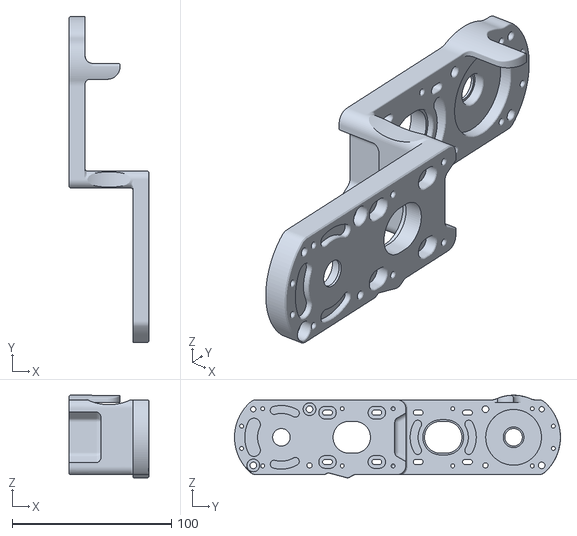
[picture p37: CAD file, 2026-09-08]
src/dummyarm_description/meshes/arm_J23.stl
50.0 x 205.0 x 52.0
