BohnChen/PickOrangeDummy/src/dummyarm_description/meshes/export/link_1_collision.stl

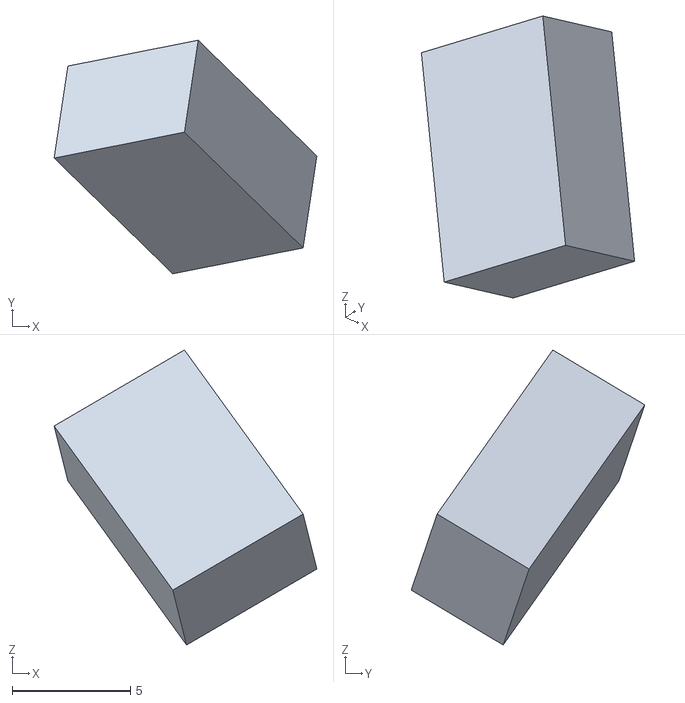
[picture p38: CAD file, 2026-09-09]
src/dummyarm_description/meshes/export/link_1_collision.stl
11.1 x 9.89 x 12.5
