BohnChen/PickOrangeDummy/models/profile_out/dian_gao_profile.dxf

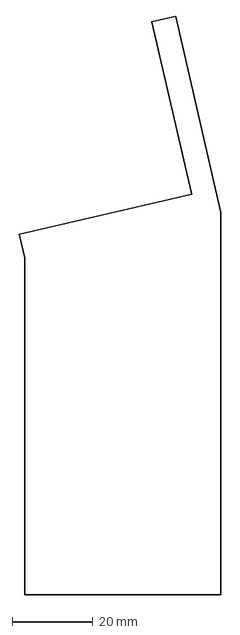
[picture p39: CAD file, 2026-11-01]
models/profile_out/dian_gao_profile.dxf
50.1 x 143.6 mm
