BohnChen/PickOrangeDummy/models/realsenseD435isketch.stl

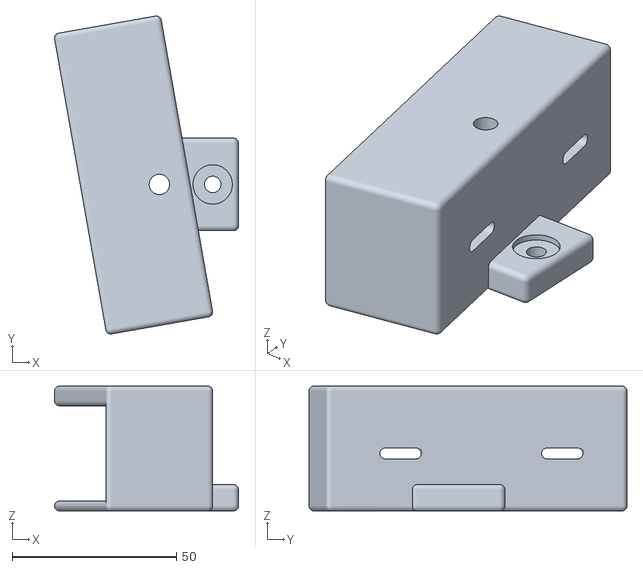
[picture p40: CAD file, 2026-11-01]
models/realsenseD435isketch.stl
56.0 x 96.8 x 38.0
