BohnChen/PickOrangeDummy/models/2040sketch.stl

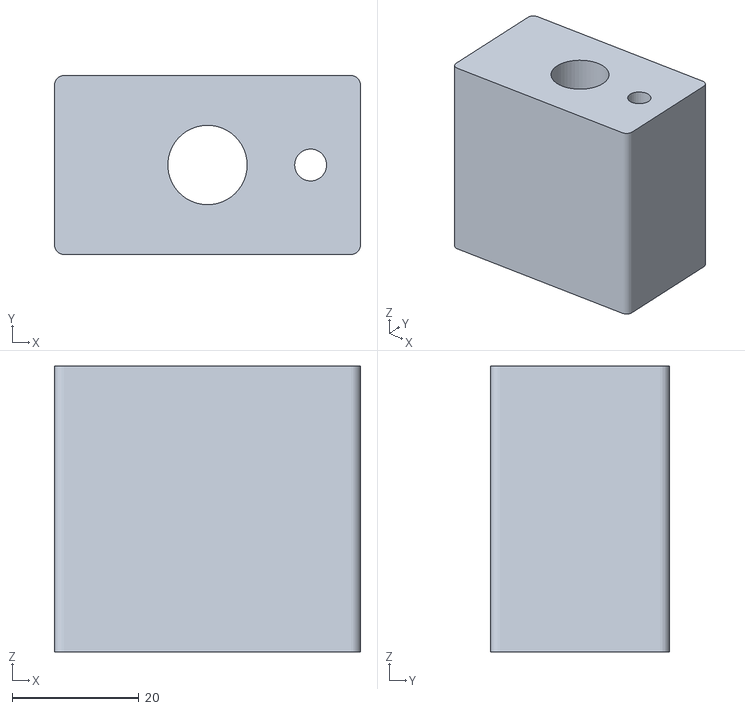
[picture p41: CAD file, 2026-11-01]
models/2040sketch.stl
48.2 x 28.2 x 45.0
