BohnChen/PickOrangeDummy/src/dummyarm_description/meshes/arm_J6.stl

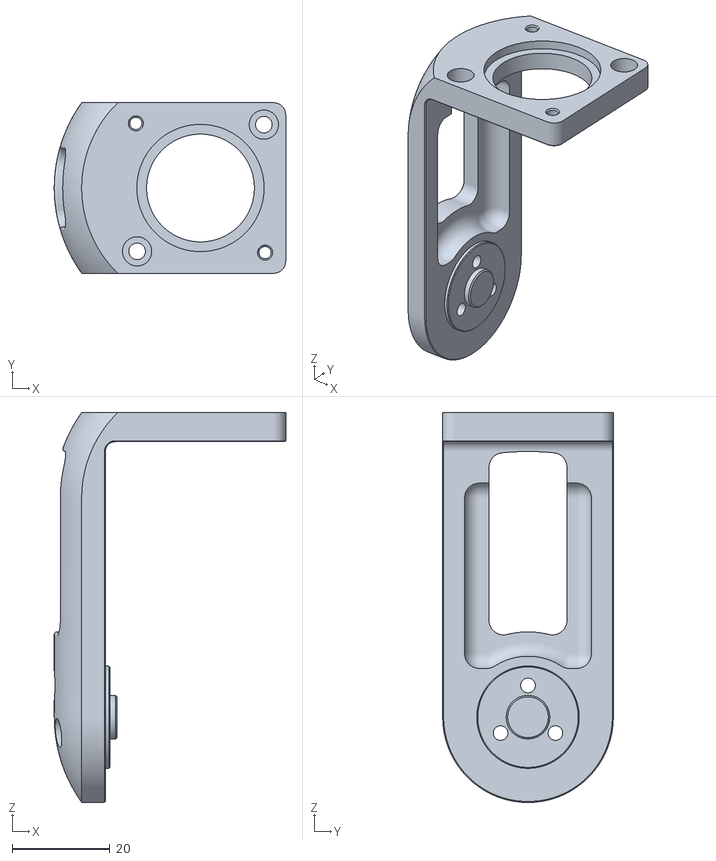
[picture p42: CAD file, 2026-09-08]
src/dummyarm_description/meshes/arm_J6.stl
47.5 x 35.0 x 80.0
