BohnChen/PickOrangeDummy/models/底座_v1.stl

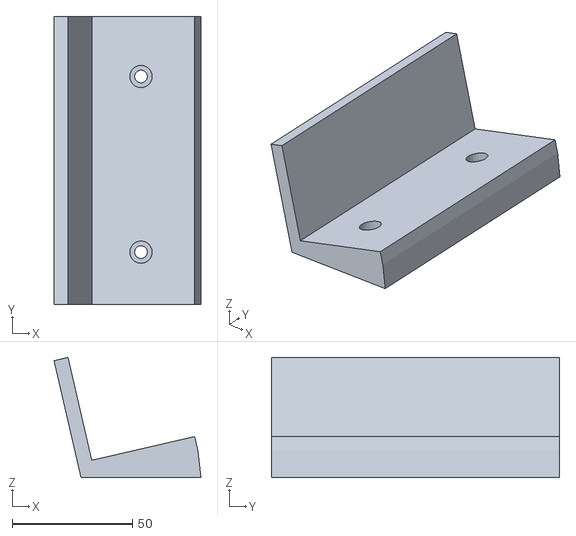
[picture p43: CAD file, 2026-10-27]
models/底座_v1.stl
61.2 x 120.0 x 50.1
