BohnChen/PickOrangeDummy/src/dummyarm_description/meshes/arm_J5B.stl

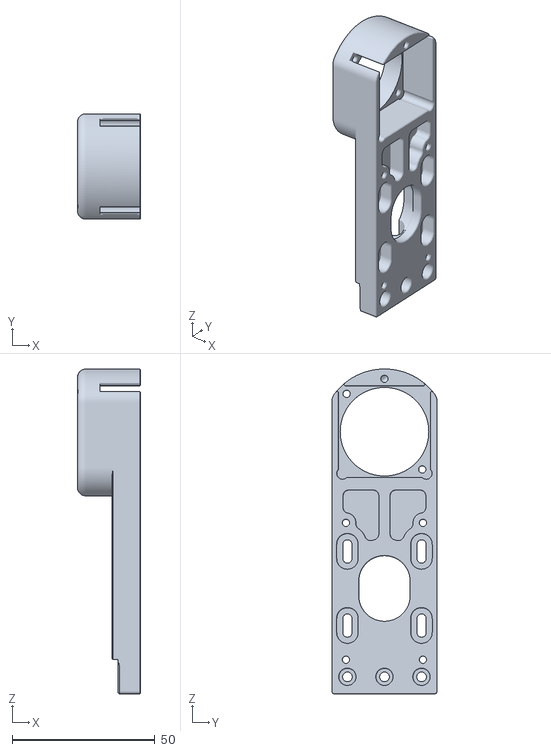
[picture p44: CAD file, 2026-09-08]
src/dummyarm_description/meshes/arm_J5B.stl
22.2 x 37.0 x 114.0
