BohnChen/PickOrangeDummy/models/printable_V1_pickOranges_abaiable_outside.3mf

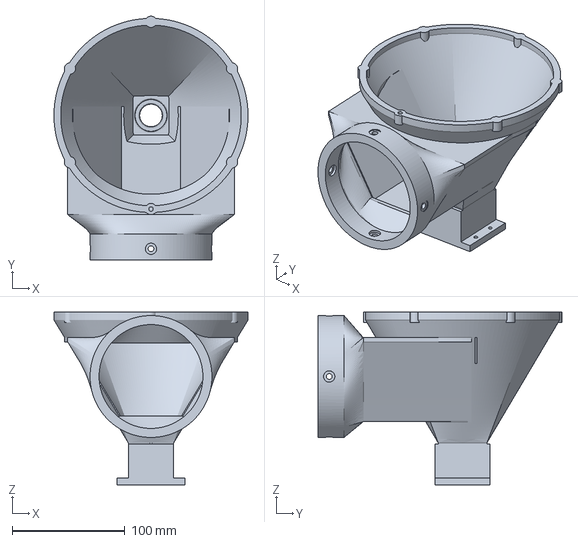
[picture p45: CAD file, 2026-10-26]
models/printable_V1_pickOranges_abaiable_outside.3mf
171.9 x 216.0 x 153.0 mm
