BohnChen/PickOrangeDummy/src/dummyarm_description/meshes/arm_J4.stl

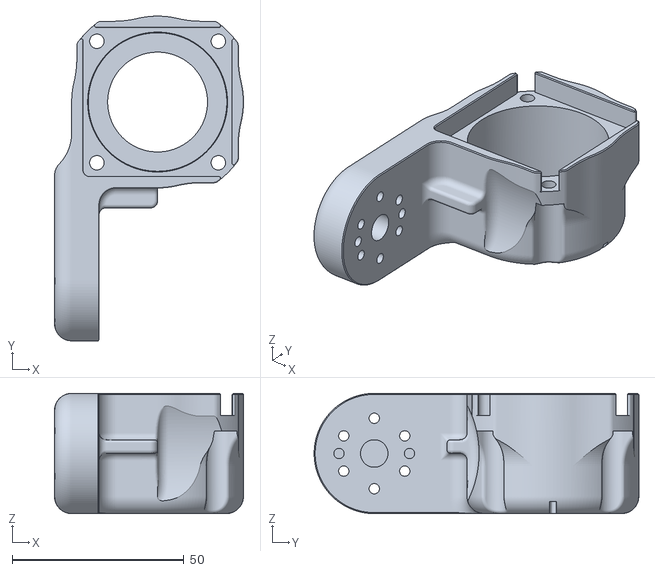
[picture p46: CAD file, 2026-09-08]
src/dummyarm_description/meshes/arm_J4.stl
55.0 x 94.5 x 35.0
