BohnChen/PickOrangeDummy/src/dummyarm_description/meshes/link5_1_1.stl

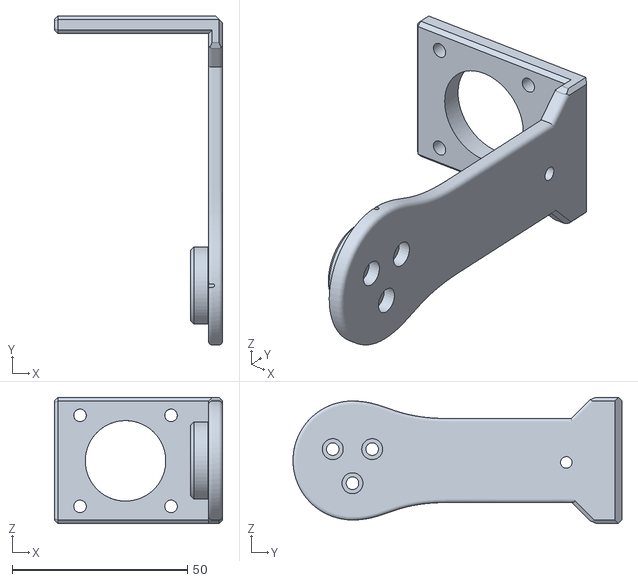
[picture p47: CAD file, 2026-09-08]
src/dummyarm_description/meshes/link5_1_1.stl
48.0 x 94.0 x 36.0
