BohnChen/PickOrangeDummy/src/dummyarm_description/meshes/link2_1_1.stl

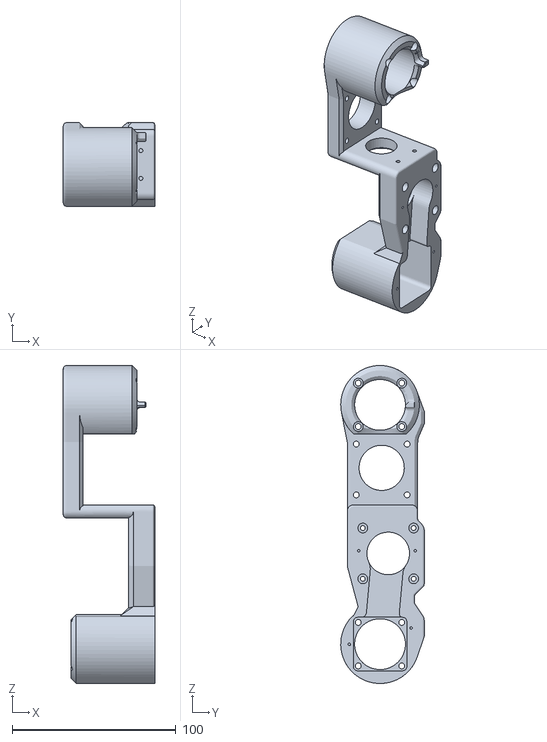
[picture p48: CAD file, 2026-09-08]
src/dummyarm_description/meshes/link2_1_1.stl
55.8 x 51.0 x 194.0
