BohnChen/PickOrangeDummy/src/dummyarm_description/meshes/link3_1_1.stl

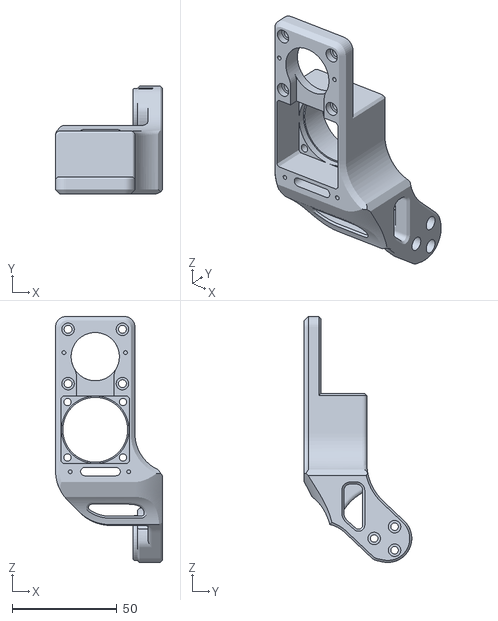
[picture p49: CAD file, 2026-09-08]
src/dummyarm_description/meshes/link3_1_1.stl
51.1 x 51.5 x 117.7
