BohnChen/PickOrangeDummy/models/pickOranges_abaiable_inside.stl

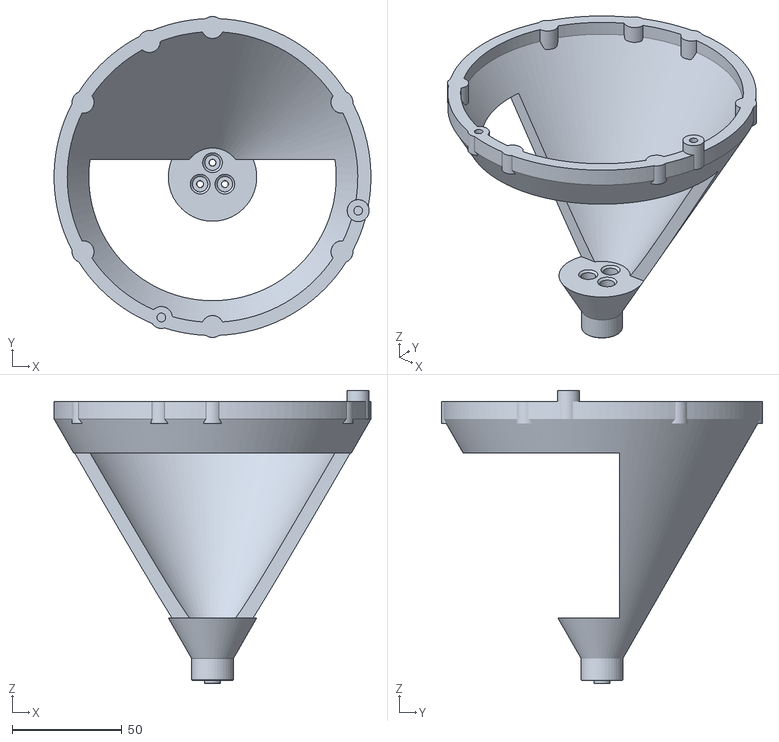
[picture p50: CAD file, 2026-10-22]
models/pickOranges_abaiable_inside.stl
144.1 x 146.0 x 133.4
