BohnChen/PickOrangeDummy/src/dummyarm_description/meshes/link1_1_1.stl

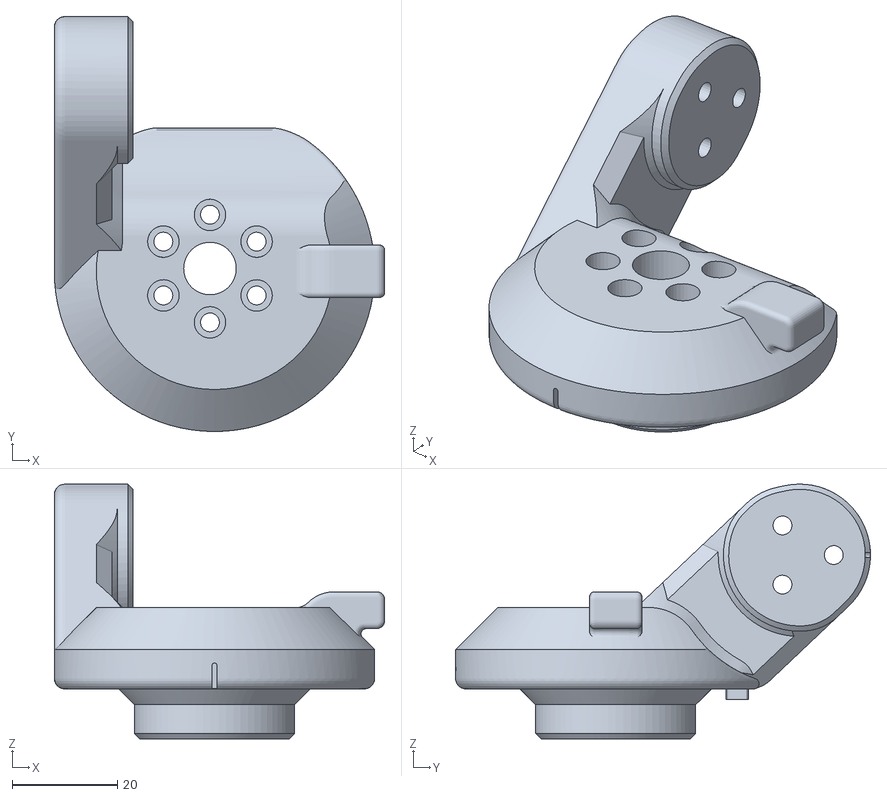
[picture p51: CAD file, 2026-09-08]
src/dummyarm_description/meshes/link1_1_1.stl
62.9 x 79.0 x 48.5
