BohnChen/PickOrangeDummy/models/pickOranges_abaiable_down_knife.stl

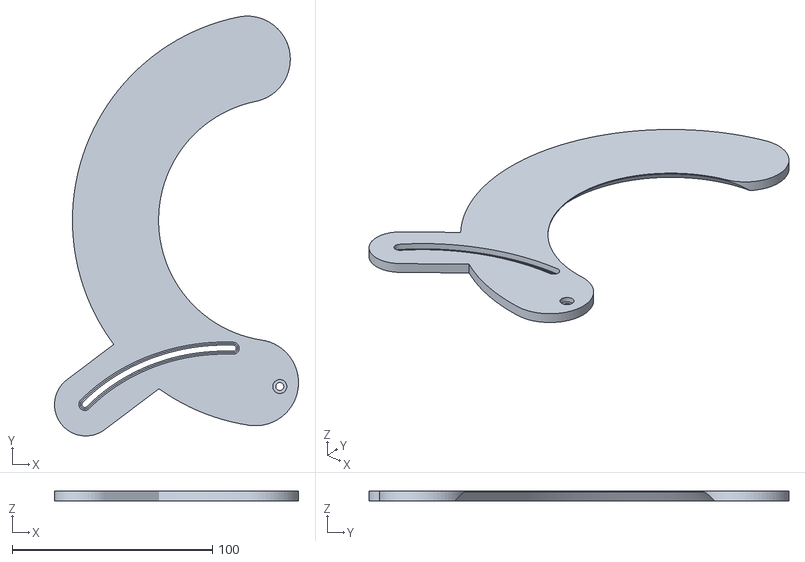
[picture p52: CAD file, 2026-10-22]
models/pickOranges_abaiable_down_knife.stl
121.8 x 209.5 x 5.00
