BohnChen/PickOrangeDummy/src/dummyarm_description/meshes/link4_1_1.stl

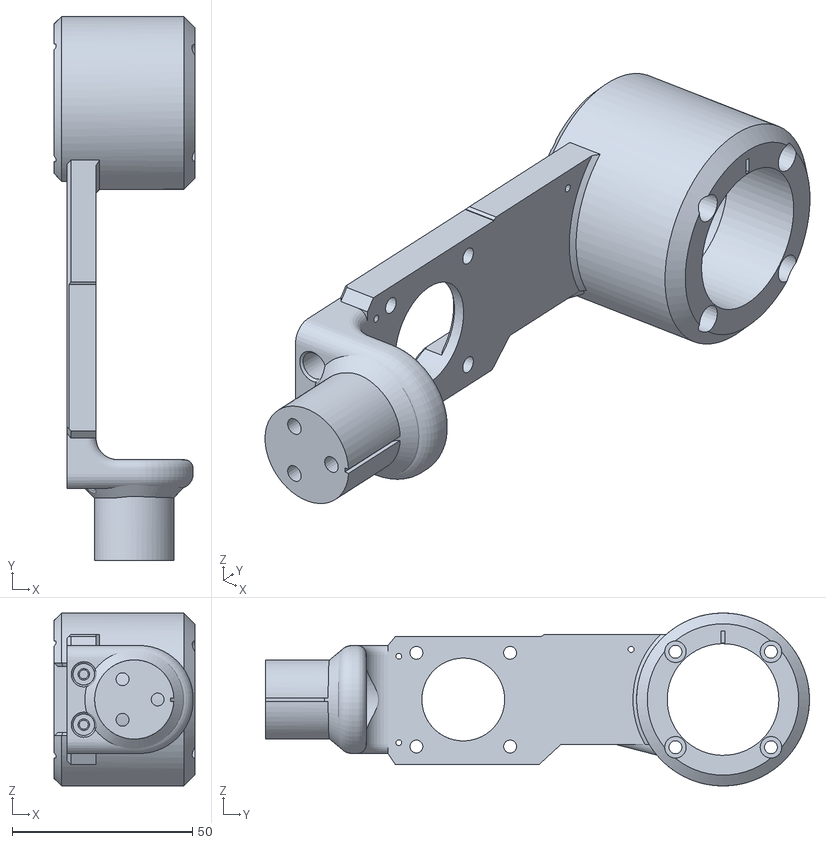
[picture p53: CAD file, 2026-09-08]
src/dummyarm_description/meshes/link4_1_1.stl
39.0 x 151.0 x 48.0
