BohnChen/PickOrangeDummy/src/dummyarm_description/meshes/link6_1_1.stl

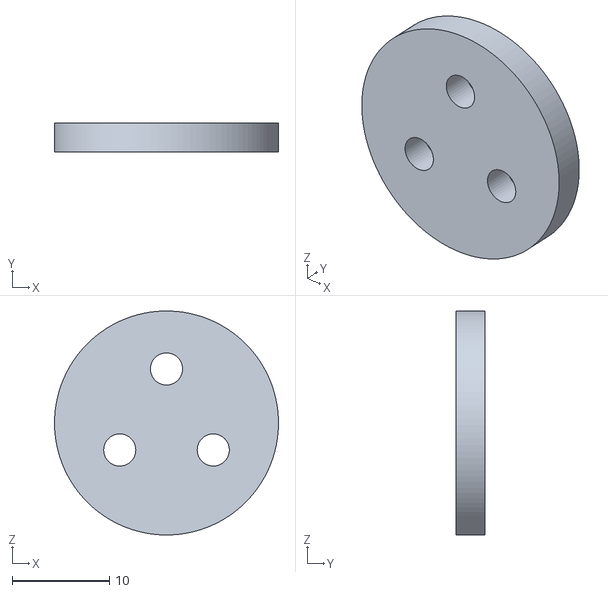
[picture p54: CAD file, 2026-09-08]
src/dummyarm_description/meshes/link6_1_1.stl
23.0 x 3.00 x 23.0
