BohnChen/PickOrangeDummy/src/dummyarm_description/meshes/base_link.stl

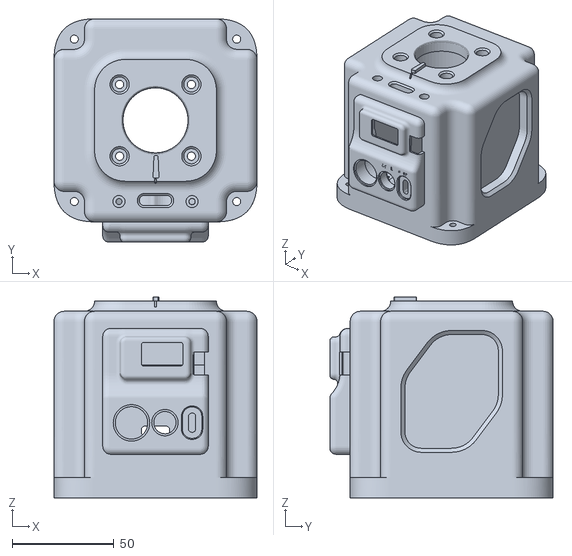
[picture p55: CAD file, 2026-09-08]
src/dummyarm_description/meshes/base_link.stl
100.0 x 110.0 x 99.0
