BohnChen/PickOrangeDummy/models/pickOranges_abaiable_up_knife.stl

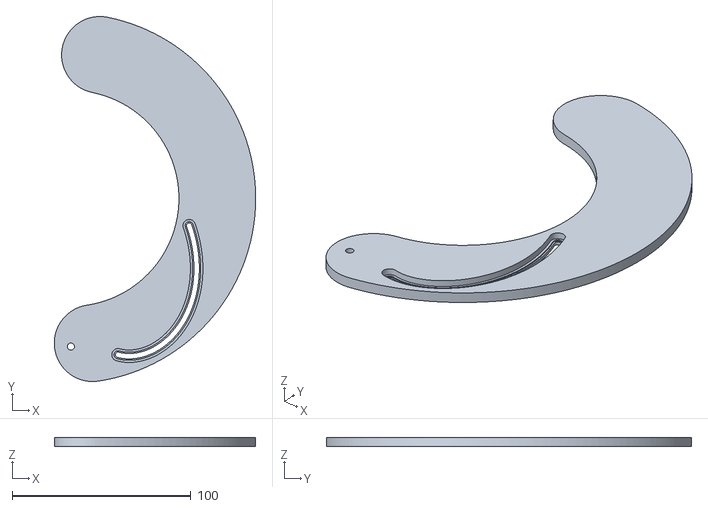
[picture p56: CAD file, 2026-10-21]
models/pickOranges_abaiable_up_knife.stl
112.8 x 204.4 x 5.00
