BohnChen/PickOrangeDummy/(list of files, cad)

Other CAD files:
src/dummyarm_description/meshes/arm_base.stl
src/dummyarm_description/meshes/export/tool0_collision.stl
src/dummyarm_description/meshes/arm_J1.stl
models/diandao_front_right.stl
models/pickOranges_abaiable_outside.gcode.3mf
src/dummyarm_description/meshes/arm_J5A.stl
models/pickOranges_abaiable_outside.stl
models/pickOranges_abaiable.3mf
models/pickOranges_abaiable_inside.gcode.3mf
models/Scheme2_3Step_Slot.dxf
models/Scheme1_3Step_Slot.dxf
models/Scheme1_Slot_Contours.dxf
models/Scheme2_Slot_Contours.dxf
