BohnChen/PickOrangeDummy/docs/power_wiring.pdf

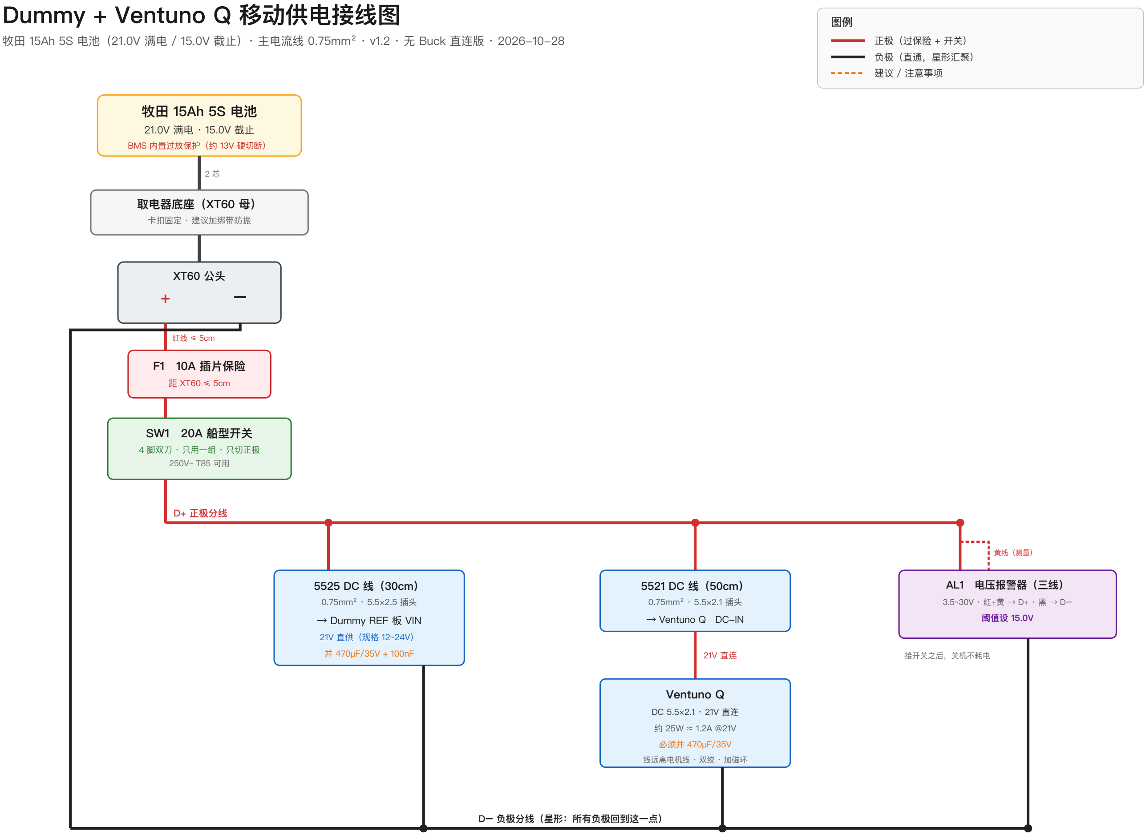
[picture p57: figure]
Dummy + Ventuno Q 移动供电接线图; 正极（过保险 + 开关）; 负极（直通，星形汇聚）; 建议 / 注意事项; BMS 内置过放保护（约 13V 硬切断）; 取电器底座（XT60 母）; 卡扣固定 · 建议加绑带防振; F1 10A 插片保险; SW1 20A 船型开关; 4 脚双刀 · 只用一组 · 只切正极 250V~ T85 可用; D+ 正极分线; D− 负极分线（星形：所有负极回到这一点）; 0.75mm² · 5.5×2.5 插头 → Dummy REF 板 VIN; 0.75mm² · 5.5×2.1 插头; → Ventuno Q DC-IN; Ventuno Q; 必须并 470µF/35V; 线远离电机线 · 双绞 · 加磁环; AL1 电压报警器（三线）; 阈值设 15.0V; 接开关之后，关机不耗电

### 牧田 15Ah 5S 电池（21.0V 满电 / 15.0V 截止）· 主电流线 0.75mm² · v1.2 · 无 Buck 直连版 · 2026-10-28

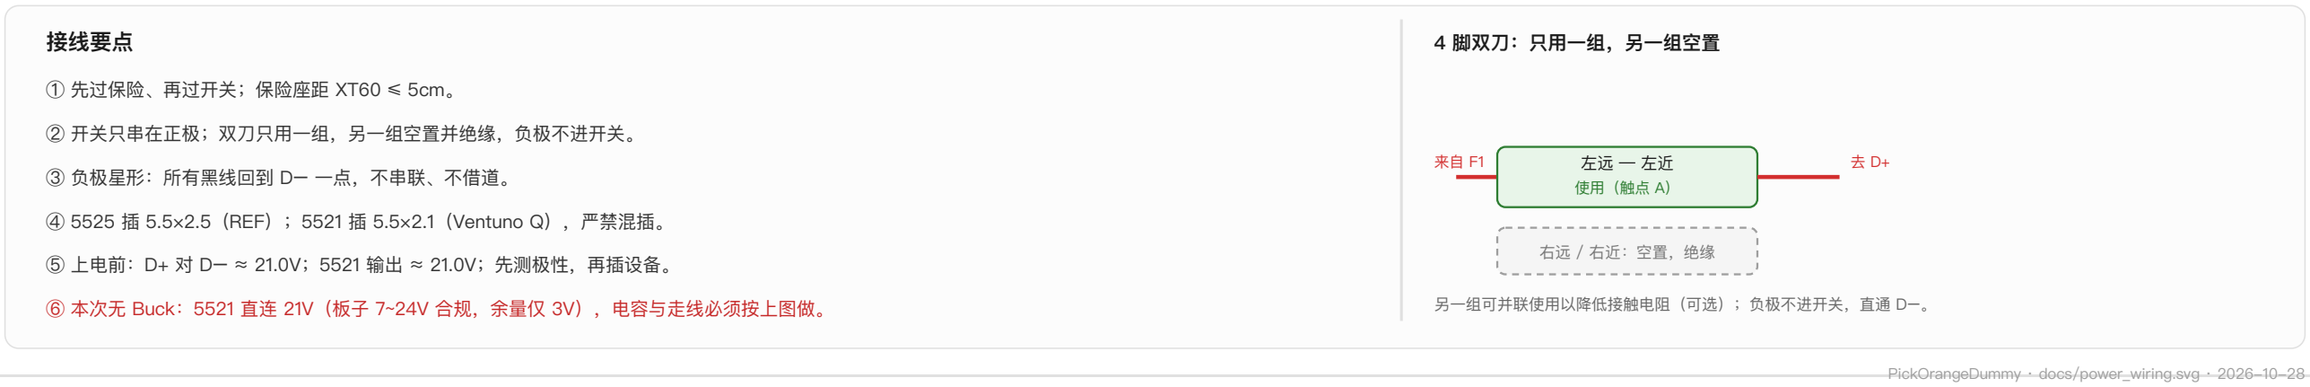
[picture p58: figure]
接线要点; ① 先过保险、再过开关；保险座距 XT60 ≤ 5cm。; ② 开关只串在正极；双刀只用一组，另一组空置并绝缘，负极不进开关。; ③ 负极星形：所有黑线回到 D− 一点，不串联、不借道。; 4 脚双刀：只用一组，另一组空置; 另一组可并联使用以降低接触电阻（可选）；负极不进开关，直通 D−。; PickOrangeDummy · docs/power_wiring.svg · 2026-10-28

④ 5525 插 5.5×2.5（REF）；5521 插 5.5×2.1（Ventuno Q），严禁混插。

⑤ 上电前：D+ 对 D− ≈ 21.0V；5521 输出 ≈ 21.0V；先测极性，再插设备。

⑥ 本次无 Buck：5521 直连 21V（板子 7~24V 合规，余量仅 3V），电容与走线必须按上图做。
