BohnChen/PickOrangeDummy/docs/calib/aruco_print_40mm.png

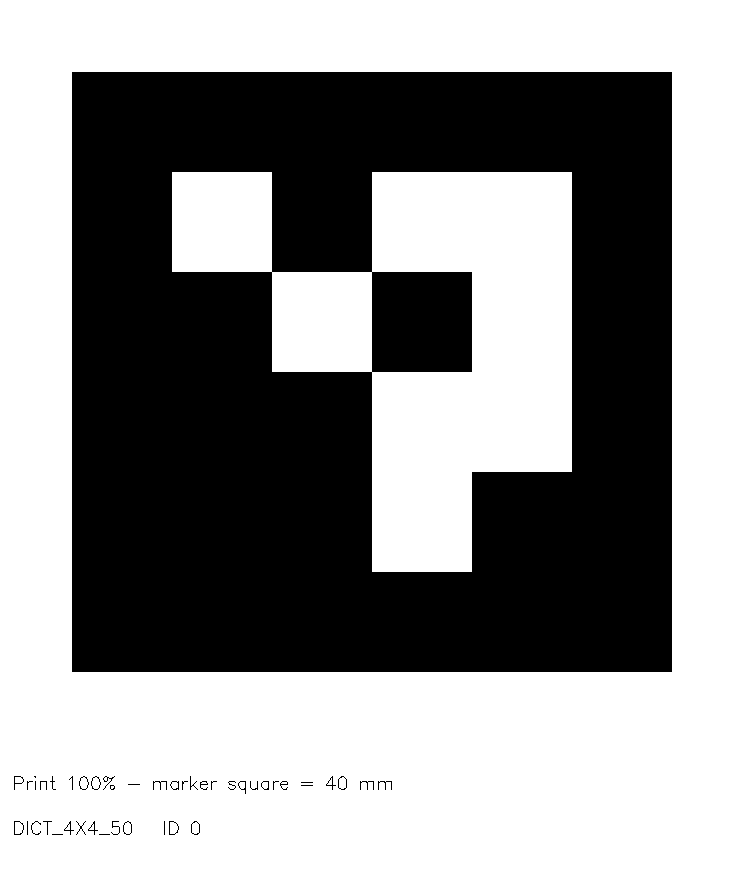
docs/calib/aruco_print_40mm.png
