BohnChen/PickOrangeDummy/docs/power_wiring.png

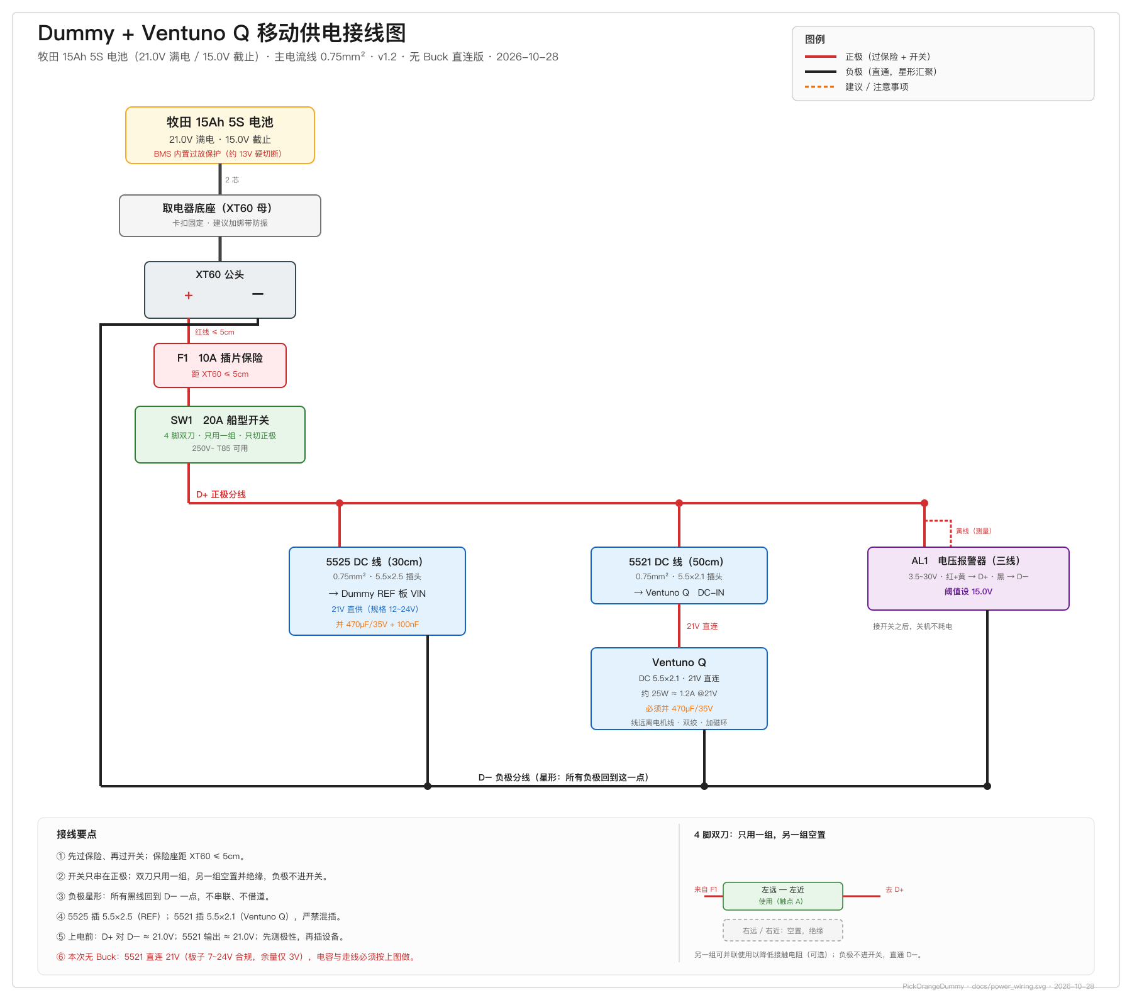
docs/power_wiring.png
