BohnChen/PickOrangeDummy/src/dummyarm_description/urdf/dummyarm.xacro

<?xml version="1.0" ?>
<!-- dummyarm 运动学链(图纸真值版, 2026-09-08 generate_true_urdf.py; 2026-09-10 按 DH 修正 J3/J4) -->
<!-- 说明: L_BASE=92.5(基座55+J1件37.5); D_BASE=35; L_ARM=146(J2-J3 轴距); D_EW=52(J3-J4 轴距); L_FA=117(肘-腕沿轴); 与 auk DH/固件 DOFKinematic 一致; 限位=模型约定(TH=[0,-90,0,0,0,0]); 固件 L_BASE 用原版值(近似)差异属预期 -->
<robot name="dummyarm" xmlns:xacro="http://www.ros.org/wiki/xacro">
<xacro:include filename="$(find dummyarm_description)/urdf/materials.xacro" />
<link name="base_link"><visual><origin xyz="0 0 0" rpy="0 0 0"/><geometry><mesh filename="package://dummyarm_description/meshes/arm_base.stl" scale="0.001 0.001 0.001"/></geometry><material name="silver"/></visual></link>
<link name="link_1">
  <visual>
    <origin xyz="0.045250 -0.035000 0.092500" rpy="3.1416 -0.0 -1.5708"/>
    <geometry><mesh filename="package://dummyarm_description/meshes/arm_J1.stl" scale="0.001 0.001 0.001"/></geometry>
    <material name="silver"/>
  </visual>
  <collision><geometry><mesh filename="package://dummyarm_description/meshes/arm_J1.stl" scale="0.001 0.001 0.001"/></geometry></collision>
</link>
<joint name="Joint1" type="revolute">
  <parent link="base_link"/>
  <child link="link_1"/>
  <origin xyz="0.000000 0.000000 0.000000" rpy="0 0 0"/>
  <axis xyz="0.000000 0.000000 1.000000"/>
  <limit lower="-2.967060" upper="2.967060" effort="150" velocity="3.15"/>
</joint>
<link name="link_2">
  <visual>
    <origin xyz="0.000000 -0.007000 0.000000" rpy="3.1416 -0.0 1.5708"/>
    <geometry><mesh filename="package://dummyarm_description/meshes/arm_J23.stl" scale="0.001 0.001 0.001"/></geometry>
    <material name="silver"/>
  </visual>
  <collision><geometry><mesh filename="package://dummyarm_description/meshes/arm_J23.stl" scale="0.001 0.001 0.001"/></geometry></collision>
</link>
<joint name="Joint2" type="revolute">
  <parent link="link_1"/>
  <child link="link_2"/>
  <origin xyz="0.035000 0.000000 0.092500" rpy="0 0 0"/>
  <axis xyz="0.000000 -1.000000 0.000000"/>
  <limit lower="0.000000" upper="2.844887" effort="150" velocity="3.15"/>
</joint>
<link name="link_3">
  <visual>
    <origin xyz="-0.017000 -0.156250 0.165000" rpy="0.0 -0.0 0.0"/>
    <geometry><mesh filename="package://dummyarm_description/meshes/arm_J4.stl" scale="0.001 0.001 0.001"/></geometry>
    <material name="silver"/>
  </visual>
  <collision><geometry><mesh filename="package://dummyarm_description/meshes/arm_J4.stl" scale="0.001 0.001 0.001"/></geometry></collision>
</link>
<joint name="Joint3" type="revolute">
  <parent link="link_2"/>
  <child link="link_3"/>
  <origin xyz="0.146000 0.000000 0.000000" rpy="0 0 0"/>
  <axis xyz="0.000000 -1.000000 0.000000"/>
  <limit lower="-3.141593" upper="-0.610865" effort="150" velocity="3.15"/>
</joint>
<link name="link_4">
  <visual>
    <origin xyz="-0.162100 -0.151321 0.215530" rpy="-0.7854 -0.0 0.0"/>
    <geometry><mesh filename="package://dummyarm_description/meshes/arm_J5A.stl" scale="0.001 0.001 0.001"/></geometry>
    <material name="silver"/>
  </visual>
  <collision><geometry><mesh filename="package://dummyarm_description/meshes/arm_J5A.stl" scale="0.001 0.001 0.001"/></geometry></collision>
</link>
<joint name="Joint4" type="revolute">
  <parent link="link_3"/>
  <child link="link_4"/>
  <origin xyz="0.117000 0.000000 0.052000" rpy="0 0 0"/>
  <axis xyz="1.000000 0.000000 0.000000"/>
  <limit lower="-3.141593" upper="3.141593" effort="150" velocity="3.15"/>
</joint>
<link name="link_5">
  <visual>
    <origin xyz="-0.149400 -0.198000 -0.018600" rpy="0.0 -0.0 0.0"/>
    <geometry><mesh filename="package://dummyarm_description/meshes/arm_J5B.stl" scale="0.001 0.001 0.001"/></geometry>
    <material name="silver"/>
  </visual>
  <collision><geometry><mesh filename="package://dummyarm_description/meshes/arm_J5B.stl" scale="0.001 0.001 0.001"/></geometry></collision>
</link>
<joint name="Joint5" type="revolute">
  <parent link="link_4"/>
  <child link="link_5"/>
  <origin xyz="0.000000 0.000000 0.000000" rpy="0 0 0"/>
  <axis xyz="0.000000 -1.000000 0.000000"/>
  <limit lower="-1.658063" upper="1.658063" effort="150" velocity="3.15"/>
</joint>
<link name="link_6">
  <visual>
    <origin xyz="-0.204500 -0.198000 0.220000" rpy="3.1416 -0.0 3.1416"/>
    <geometry><mesh filename="package://dummyarm_description/meshes/arm_J6.stl" scale="0.001 0.001 0.001"/></geometry>
    <material name="silver"/>
  </visual>
  <collision><geometry><mesh filename="package://dummyarm_description/meshes/arm_J6.stl" scale="0.001 0.001 0.001"/></geometry></collision>
</link>
<joint name="Joint6" type="revolute">
  <parent link="link_5"/>
  <child link="link_6"/>
  <origin xyz="0.000000 0.000000 0.000000" rpy="0 0 0"/>
  <axis xyz="1.000000 0.000000 0.000000"/>
  <limit lower="-12.566371" upper="12.566371" effort="150" velocity="3.15"/>
</joint>
<link name="tool0"/>
<joint name="tool0_joint" type="fixed">
  <parent link="link_6"/>
  <child link="tool0"/>
  <origin xyz="0.072000 0.000000 0.000000" rpy="0 0 0"/>
</joint>
  <xacro:include filename="$(find dummyarm_description)/urdf/dummyarm.ros2_control.xacro" />
  <xacro:dummyarm_ros2_control name="dummyarm" initial_positions_file="$(find dummyarm_description)/config/initial_positions.yaml"/>
</robot>
