BohnChen/PickOrangeDummy/src/dummyarm_moveit_config/config/joint_limits.yaml

default_velocity_scaling_factor: 1.0
default_acceleration_scaling_factor: 1.0

joint_limits:
  Joint1:
    has_velocity_limits: true
    max_velocity: 0.60
    has_acceleration_limits: true
    max_acceleration: 1.20
    has_jerk_limits: true
    max_jerk: 3.00
    has_position_limits: true
    min_position: -2.967060
    max_position: 2.967060
  Joint2:
    has_velocity_limits: true
    max_velocity: 0.60
    has_acceleration_limits: true
    max_acceleration: 1.20
    has_jerk_limits: true
    max_jerk: 3.00
    has_position_limits: true
    min_position: -0.050000
    max_position: 2.844887
  Joint3:
    has_velocity_limits: true
    max_velocity: 0.60
    has_acceleration_limits: true
    max_acceleration: 1.20
    has_jerk_limits: true
    max_jerk: 3.00
    has_position_limits: true
    min_position: -2.530727
    max_position: 0.050000
  Joint4:
    has_velocity_limits: true
    max_velocity: 0.60
    has_acceleration_limits: true
    max_acceleration: 1.20
    has_jerk_limits: true
    max_jerk: 3.00
    has_position_limits: true
    min_position: -3.141593
    max_position: 3.141593
  Joint5:
    has_velocity_limits: true
    max_velocity: 0.60
    has_acceleration_limits: true
    max_acceleration: 1.20
    has_jerk_limits: true
    max_jerk: 3.00
    has_position_limits: true
    min_position: -1.658063
    max_position: 1.658063
  Joint6:
    has_velocity_limits: true
    max_velocity: 0.80
    has_acceleration_limits: true
    max_acceleration: 1.50
    has_jerk_limits: true
    max_jerk: 4.00
    has_position_limits: true
    min_position: -12.566371
    max_position: 12.566371
