BohnChen/PickOrangeDummy/src/dummyarm_description/config/initial_positions.yaml

initial_positions:
  Joint1: 0.0
  Joint2: 2.844887 # REST: 物理 -73° -> 模型 163° (rad)
  Joint3: -3.141593 # REST: 物理 180° -> 模型 -180° (rad)
  Joint4: 0.0
  Joint5: 0.0
  Joint6: 0.0
