BohnChen/PickOrangeDummy/(commit log)

2026-09-08 init: 架构文档(M0-M2)、安全约束、dummyarm_description 数字样机(M1 骨架)
    - docs/architecture.md: 混合架构 C 批准版 (D1-D6)
    - docs/safety_and_incidents.md: J3 损坏史 + 8 条硬性操作约束
    - src/dummyarm_description: URDF/CAD 网格 + auk 真值限位, rsp TF 验证通过
    [base_link.stl, dummyarm.xacro, link1_1_1.stl, link2_1_1.stl, link3_1_1.stl, link4_1_1.stl, link5_1_1.stl, link6_1_1.stl]
2026-09-08 feat(bridge): dummyarm_system 真机桥接节点 (阶段 3a)
    - /joint_states 50Hz (度→弧度, Joint1..6), 供 rsp/RViz 真机同步
    - std_srvs/Trigger: start/disable/stop/home/reset (/dummyarm_system/*)
    - 启动不自动使能; 析构自动失能; 串口独占锁 (timer/service)
    - scripts/build.sh: 修复 colcon ament_python bin/lib 布局问题
    - 冒烟测试: 采样=休憩位 0/-73/180/0/0/0 ✓, 服务闭环 ✓
2026-09-08 fix(launch): robot_description 用 ParameterValue(str) 包裹, 修复 xacro 多行 XML 被误解析为 YAML
2026-09-08 chore: 保留固件DH链生成器脚本(供 Fusion URDF 对齐阶段复用); 回滚未验证的 xacro
2026-09-08 feat(urdf): 图纸真值运动学链 (L_BASE 92.5/D_BASE 35/L_ARM 146/D_ELBOW 52)
    - 改版工程图真值: 基座55+J1件37.5→J2=92.5; J2/J3/J5 轴=-Y(方向已KDL验);
    - J4/J6=+X(腕滚/末端轴); J3→J4/J4→J5/J5→J6 段(115/92/72)为近似待精调;
    - 生成器: scripts/generate_true_urdf.py; KDL 自洽: REST 折臂上举 z≈220; HOME 竖举 z≈371
    - 备注: 与固件 DH(0.109) 存在 ~16mm 级固有偏差(模型=物理真值, 固件=原版近似)
    [Basic_Robot.xacro, dummyarm.xacro, materials.xacro]
2026-09-08 urdf: 图纸真值链 v2 (腕部=公共腕点, 固件v3结构; L_BASE 92.5 经用户实测 92.6 确认)
    - J2/J3/J5=-Y、J4/J6=+X; J3 面内偏 50; J4 origin=link3(-52,0,115)(FW v3);
    - J5/J6@腕心; tool0=+72 沿 J6(+X);
    - 已知待办: FW θ-home 偏移(J2-90/J3+90)+符号 → '桥接角度→模型角度'映射下一步实现
    - 自洽: 模型零位=物理零位待映射定; REST/HOME 姿态方向已由 KDL 复核
    [dummyarm.xacro]
2026-09-08 feat(bridge): FW→模型角度映射 (Kabsch 配准, 残差0.04mm)
    q_model = SIGNS·(q_fw + TH_HOME); SIGNS=[+,-,-,+,+,+], TH_HOME=[0,-90,90,0,0,0]
    - 桥接 /joint_states 现输出模型角; 实测 REST→[0,163,-270,0,0,0] ✓
    - p_fw ≈ p_model + (60.85,0,171.14)mm 关系已存档(诊断用)
2026-09-08 feat(urdf): 网格视觉首版挂载(每件 identity 挂 link 帧, 视频款打印STL)
    - 新网格 arm_base/J1/J23/J4/J5A/J5B/J6.stl 入包(来自任同学 视频款 3D打印)
    - 视觉统一 identity 首版 → 待 RViz 目检后逐件微调 origin/rpy (表驱动)
    - align_parts.py 保留为锚点配准工具草稿(下一轮视觉校准用)
    [arm_J1.stl, arm_J23.stl, arm_J4.stl, arm_J5A.stl, arm_J5B.stl, arm_J6.stl, arm_base.stl, dummyarm.xacro]
2026-09-08 feat(urdf): 视觉首版改PCA启发式挂载(主轴对齐链段+段中点, 基座贴地)
    避免identity全散: 每件长主轴对齐对应链段方向(146臂/腕段等), 位置=段中点;
    基座底部贴 z=0; 个别件滚转/翻面可能反 — 待用户目检逐件微调
    [dummyarm.xacro]
2026-09-08 fix(urdf): rpy 弧度bug (此前以度值直接写URDF放大约57倍导致更散乱); 基座视觉确认在位
    [dummyarm.xacro]
2026-09-08 feat(urdf): 逐件轴孔双锚配准(确定性) + t_rel 修正 — 视觉装配成形
    - align_precise.py: 每件自身关节轴孔↔链轴 求解唯一旋转, t=目标点−link原点−R·pup
    - 渲染自检(Render png 目检): 基座-上臂-腕簇 一串成形 ✓
    - 剩余 1-2 处翻转/贴合细节待 RViz 目检微调
    [dummyarm.xacro]
2026-09-08 wip: 视觉装配归档 (灵活配准器/叠装求解器/自检渲染器) — 等待专项微调会话
    根因: 缺真实装配数据(STEP无occurrence), 每件沿轴平移+滚转2个自由度只能靠交互微调收敛
2026-09-08 feat(3b): dummyarm_hardware SystemInterface + ros2_control 控制器链
    - C++ SystemInterface (SHARED 插件): 串口(termios,DTR低防复位), #GETJPOS读取,
    FW→模型与单位(度↔弧度)转换, '>'命令写入(INT, speed=10 低速安全)
    - ros2_control xacro 标签 + 初始位姿; controller_manager + joint_state_broadcaster
    + joint_trajectory_controller (默认只 spawn 广播器; 轨迹控制器需显式 spawn_trajectory:=true)
    - control.launch.py: rsp + ros2_control_node + spawn(广播器) (include_bridge 默认关,
    避免双开串口; 管理服务用 /dummyarm_system 单独进程)
    - 冒烟: /joint_states = [0,163,-270,0,0,0] 与预期完全一致 (只读零使能)
    - 遗留: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
    [dummyarm.ros2_control.xacro, dummyarm.xacro, dummyarm_controllers.yaml]
2026-09-09 wip: 导出URDF审查+方案B数据探查 (fusion_transforms/frame_model 分析)
    结论: 导出器帧平移/部分旋转被污染(米级), 网格/惯性/旋转轴可信;
    最终融合路线=真值链(运动学)+导出DAE(外观); 待用户v2导出对比/STEP锚定合装
    [35_20Motor_Assembly.urdf.xacro, 35_20Motor_Assembly_1.urdf.xacro, 35_20Motor_Assembly_1_2_collision.stl, 35_20Motor_Assembly_2_collision.stl, 3_collision.stl, Dummy_ForURDF.urdf, Dummy_ForURDF.urdf.xacro, J1.urdf.xacro]
2026-09-09 tools: STEP 装配解析器草稿 + 导出审查工具集 (pythonocc 后置TODO)
    - parse_step_assembly.py: ITEM_DEFINED_TRANSFORMATION(197) 识别; 结构为OCC实例化,
    正则图遍历不可靠 → 需 pythonocc 做标准遍历(TODO)
    - 结论: 主线=Fusion URDF导出(规则v2); STEP装配体=后期专项
2026-09-09 fix: J5 物理限位 ±95° 全链更新(生成器/link库/控制器yaml) — 105°碰结构实锤
    [dummyarm.xacro, dummyarm_controllers.yaml]
2026-09-09 docs: M0 规格冻结 v1.0 (真值表/几何/映射/控制链/固件族谱/待办)
2026-09-09 tools: OCC(OCP) STEP 装配解析探索 — XCAF空/compound实例定位叠加问题记录
    - step2world_xcaf / step_world_compound / step_solids_world (ocvenv运行)
    - 结论: STEP含装配实例(compound+Location)但递归定位叠加/全域平移/单位噪声,
    需专项调试; 视觉完成优先走 v2 URDF 或 Fusion原点归零重导
    [step2world_xcaf.py, step_solids_world.py, step_world_compound.py]
2026-09-09 docs: 会话交接文档 (HANDOFF) — 新会话启动必读: 真值表/映射/运行命令/视觉装配来龙去脉/下一步/坑速查
2026-09-10 feat(visual): CAD 视觉包并入 (dummyarm_cad_description) + 真值链 J3/J4 按 DH 修正与零位约定同步
    - 真值链几何修正: Joint3=(0.146,0,0), Joint4=(0.117,0,0.052)
    (此前 D_EW/L_FA 角色放反); link_3..6 视觉补偿; generate_true_urdf.py/M0_spec 同步
    - 零位约定: J3 随几何平移 90 度 -> TH_HOME[2]: 90->0 (bridge + hardware),
    物理 REST (0,-73,180) = 模型 (0,163,-180); 限位 J2 [0,163]/J3 [-180,-35];
    initial_positions/display.launch.py 同步; 文档标注物理角/模型角两套约定
    - 新增 dummyarm_cad_description: Fusion v2 导出 (double-lift 补丁 + 离线 reframe
    + CAD<->模型映射) + 恢复 reframe 丢失的 ros2_control 块(mock, 初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
    [35_20Motor_Assembly.urdf.xacro, 35_20Motor_Assembly_1.urdf.xacro, 3_collision.stl, Dummy_ForURDF.urdf, Dummy_ForURDF.urdf.xacro, Dummy_URDF.urdf, Dummy_URDF.urdf.xacro, J1.urdf.xacro]
2026-09-10 feat(visual): CAD 包改用 Fusion 直接导出（补丁版导出器）+ 文档/脚本路径修复
    - dummyarm_cad_description 内容替换为补丁版导出器的直接导出:
    坐标/限位/滑块+RViz 全验证; 关节值=CAD 约定、设计姿态=0;
    补 launch 的 ParameterValue 包装 + 新增 display_jsp.launch.py(滑块版)
    - docs/fusion_export_workflow.md: Fusion→URDF 导出流程(三个坑+设计规则+验证清单)
    - docs/fusion2URDF-root-joint-fix.patch: 导出器 double-lift 修复补丁入库
    - docs: M0/HANDOFF/architecture 同步(直接导出版; 工作区移至 ~/01_MyProject/PickOrangeDummy)
    - scripts: 硬编码旧路径改为从脚本位置推导仓库根
    [Dummy_URDF.urdf, Dummy_URDF.urdf.xacro, robot_data.yaml]
2026-09-10 fix(control): 控制器 yaml 的 J2/J3 限位同步为新约定
    J2 [0, 2.844887] / J3 [-3.141593, -0.610865] (模型约定);
    旧值 [-1.274,1.571]/[0.611,3.142] 会让 REST 状态落在限位外, 轨迹控制器拒绝。
    真机首次运动验证: J5 +5° 往返 + 模型映射复核通过 (最大动作 5°)。
    [dummyarm_controllers.yaml]
2026-09-10 feat(moveit): 完成 MoveIt 2 运动学与轨迹规划配置包 (dummyarm_moveit_config)
    - CAD URDF 规范对齐: 关节重命名为 Joint1..Joint6, 限制与真实约定一致
    - 软硬件双模切换: use_mock_hardware 参数实现虚拟仿真与真机直控无缝切换
    - dummyarm_moveit_config:
    - SRDF 定义 arm 规划组 (base_link -> tool0) 及自碰撞过滤规则
    - kinematics: KDLKinematicsPlugin
    - planning: OMPL (RRTConnect / RRTstar)
    - controllers: joint_trajectory_controller 轨迹执行器映射
    - demo.launch.py: 纯虚拟仿真与 RViz 交互规划 (无需硬件)
    - real_moveit.launch.py: 真机 MoveIt 规划与直接执行控制
    [Dummy_URDF.urdf.xacro, dummyarm_controllers.yaml, joint_limits.yaml, ros2_controllers.yaml]
2026-09-11 feat(visual): 采用新配色网格，并保持关节 Joint1..Joint6 规范与双模控制支持
    [Dummy_URDF.urdf, Dummy_URDF.urdf.xacro, robot_data.yaml]
2026-09-11 fix(rviz): 移除 Panels 中错误的 MotionPlanning 配置，修复 RViz Panel 报错
2026-09-11 fix(rviz): 移除冲突的 RobotModel 插件，默认关闭 Start 虚影，消除闪烁
2026-09-11 fix(launch): 为 rviz2 节点注入 ompl planning_pipelines 参数，修复 NO PLANNING LIBRARY LOADED 报错
2026-09-11 fix(moveit): 修复 OMPL 参数命名空间层级，成功加载 OMPL 规划管道；纠正 SRDF 中的 rest 与 home 姿态定义
2026-09-11 fix(moveit): 适配 ROS 2 Jazzy 的 response_adapters，为 OMPL 轨迹补充时间参数化生成，解决控制器轨迹点时间差为0拒收问题
    [dummyarm_controllers.yaml, ros2_controllers.yaml]
2026-09-11 docs: 记录 ROS 2 Jazzy 下 MoveIt 2 OMPL 命名空间及 response_adapters 时间参数化的避坑指南
2026-09-11 fix(moveit): 合并控制器 spawner 为单个节点顺序激活，消除竞态并成功激活 joint_trajectory_controller
2026-09-11 docs: 补充 controller spawner 并发加载竞态导致未激活的避坑说明
2026-09-11 fix(moveit): 扁平化 ompl_planning.yaml 顶层层级，使 response_adapters (AddTimeOptimalParameterization) 能被正确加载生效
2026-09-11 feat(hardware): 更新 CAD 角度映射，加入驱动级硬限位安全拦截与低速保护
    [joint_limits.yaml]
2026-09-11 build(hardware): 清理编译警告，确保 colcon build 零警告零错误通过
2026-09-11 feat(hardware): 引入安全使能/失能管理服务(/dummyarm/enable, /dummyarm/disable)，修复 controller_manager robot_description 传递延迟
2026-09-11 fix(moveit): 移除 hardware 插件内部多线程避免崩溃；使用 ParameterValue 强类型传递 robot_description
2026-09-11 fix(urdf): 移除 ros2_control 中未导出的 velocity/effort 接口，彻底解决 controller_manager 接口冲突
    [Dummy_URDF.urdf.xacro]
2026-09-11 docs: 补充 ros2_control 硬件接口声明与 URDF 严格一致性避坑说明
2026-09-11 feat(rviz): 开启规划轨迹循环动画、残影拖尾与半透明预览，使 Plan 轨迹清晰可见
2026-09-11 docs: 补充 RViz Planned Path 轨迹动画循环与残影预览避坑说明
2026-09-11 feat(scripts): 添加 park_and_disable.py 脚本，支持一键低速平稳回到 REST 折叠位并提示安全失能
2026-09-11 fix(hardware): 修复串口关闭时 HUPCL 触发 STM32 复位使能问题，增加双保险失能与 disable.py 工具
    [disable.py]
2026-09-11 feat(scripts): 提供 safe_park_and_exit.sh 脚本，实现先低速回 REST，确认到位后安全失能并退出节点的优雅停机流程
2026-09-11 fix(rviz): 修复 State Display Time 单位格式 (0.05 s) 并关闭 Trail，消除 Plan 时的跳跃闪烁问题
2026-09-11 docs: 补充 RViz State Display Time 格式导致的轨迹闪烁问题根因分析
2026-09-11 fix(hardware): 重构串口行缓冲区与防阻塞逻辑，优化控制频率至20Hz彻底消除串口拥堵与Overrun
    [Dummy_URDF.urdf.xacro, ros2_controllers.yaml]
2026-09-11 docs: 补充串口通信拥堵与 Overrun 导致机械臂中途停机的避坑与优化记录
2026-09-11 fix(moveit): 放宽执行超时判定容差(scaling 3.0, margin 10.0s)，微调底层速度至 15°/s 避免中途超时掐断
2026-09-11 docs: 补充 MoveIt 轨迹执行超时看门狗掐断机制与参数放宽说明
2026-09-11 fix(scripts): 使用 POSIX O_NONBLOCK 底层非阻塞重构 disable.py，彻底杜绝 pySerial 握手卡死
    [disable.py]
2026-09-11 fix(hardware): 建立 send_commands 事务闭环立即回收 ok 回复，彻底杜绝数据流混淆与缓冲区堆叠挂死
2026-09-11 fix(hardware): 根据实测修正 J5 符号取反映射，彻底消除真机手腕俯仰与仿真反向问题
2026-09-11 docs: 记录 J5 符号取反修复事实
2026-09-11 fix(scripts): 回收纳位时锁定 J6 为当前角度，彻底避免 J6 倒转 720 度多圈无意义回旋
    [park_and_disable.py]
2026-09-11 feat(moveit): 实施方案B，将 arm 规划组重构为 5 轴定位臂 (J1-J5) 并独立 cutter 剪切工具组 (J6)，彻底杜绝规划时 J6 乱转
2026-09-11 docs: 记录 5 轴定位臂与独立剪切工具架构重构说明
2026-09-11 fix(control): 开启 allow_partial_joints_goal 允许 5 轴规划目标直接被 6 轴控制器执行
    [dummyarm_controllers.yaml, ros2_controllers.yaml]
2026-09-11 docs: 补充 allow_partial_joints_goal 配置说明
2026-09-11 feat(kinematics): 恢复 arm 完整 6-DOF 链以提供全向大范围逆解，同时将 J6 规划限位锁紧在 [-0.35, 0.35] rad 根除转圈
    [Dummy_URDF.urdf.xacro, joint_limits.yaml]
2026-09-11 docs: 补充 6-DOF 逆解全向可达性与 J6 限位锁紧的工业实践说明
2026-09-11 feat(kinematics): 将 Joint6 规划限位设定为标准全向单圈 [-pi, +pi]，彻底平衡全空间极致灵巧度与杜绝多圈转动
    [Dummy_URDF.urdf.xacro, joint_limits.yaml]
2026-09-11 docs: 完善 J6 单圈限位平衡灵巧度与转圈问题的总结说明
2026-09-11 fix(moveit): 放宽 allowed_start_tolerance 至 0.15 rad 容忍微小关节下垂，解决 start point deviates 报警
2026-09-11 docs: 补充 allowed_start_tolerance 起始点容差设置说明
2026-09-11 feat(control): 引入 Ruckig S-Curve 轨迹平滑插件并配置 max_jerk 约束，从根源消除起步与停止时的弹性冲度抖动
    [dummyarm_controllers.yaml, joint_limits.yaml, ros2_controllers.yaml]
2026-09-11 docs: 补充 Ruckig 轨迹平滑与 Jerk 冲度消除起停抖动说明
2026-09-11 fix(control): 消除微动死区导致的断续抽搐发包，禁用起点静态硬拦截，实现起步全程平滑均匀输出
2026-09-11 fix(hardware): 加入逐轴物理微步死区滤波 (0.0015 rad)，彻底杜绝 J4/J5/J6 在低速时的浮点噪声高频抽搐
2026-09-11 docs: 补充 J4/J5/J6 物理微步滤波消除手腕抖动的详细原理解释
2026-09-11 fix(control): 引入 120ms 时间窗下发限频，消除对单片机梯形加减速的高频打断，实现近乎单点控制的极致平滑度
2026-09-11 docs: 补充 120ms 时间窗限频消除高频打断抽搐的详细记录
2026-09-11 revert: 移除人为的 120ms 时间窗截断与死区，恢复平滑连续的数据流输出
2026-09-11 feat(architecture): 完美落地方案——全向6-DOF解算大范围灵巧拖动 + 硬件驱动层隔离拦截J6轨迹杂流 (J6在机械臂空间运动中绝对静止)，并提供cut.py切削工具
    [Dummy_URDF.urdf.xacro, dummyarm_controllers.yaml, joint_limits.yaml, ros2_controllers.yaml]
2026-09-11 docs: 记录 6-DOF 解算与驱动层 J6 轨迹杂流隔离架构落地事实
2026-09-11 fix(rviz): 将 Velocity Scaling 和 Accel Scaling 默认值锁定为 1.0 (正常平滑工作速度)，彻底避开 0.1 极限低速的步进齿槽震荡与超时抢占
2026-09-11 docs: 补充 0.1 极限低速步进齿槽震荡与超时抢占原因分析
2026-09-14 fix(launch): 在 rviz2 和 move_group 节点显式注入 default_velocity/acceleration_scaling_factor = 1.0，彻底锁定滑块默认值为1.0
    [joint_limits.yaml]
2026-09-14 docs: 补充 RViz Scaling 滑动条默认值参数配置说明
2026-09-14 fix(limits): 给 Joint2 下限和 Joint3 上限增加 0.05 rad (2.8度) 工程测量容差，彻底消除微米级浮点噪声触发的 CheckStartStateBounds 报错
    [Dummy_URDF.urdf.xacro, joint_limits.yaml]
2026-09-14 fix(rviz): 使用规范的 Velocity_Scaling_Factor / Acceleration_Scaling_Factor 字段彻底锁定 RViz 滑块为 1.0；直接传 by-id 软链接解决设备漂移
    [cut.py, disable.py]
2026-09-14 docs: 补充 RViz Scaling 正确字段名与 by-id 软链接直传避坑指南
2026-09-14 fix(control): 提升基准速度至 0.60 rad/s 解决拖动小球笛卡尔规划速度被过度压缩问题；升级 safe_park_and_exit.sh 为原生平滑直驱
    [joint_limits.yaml]
2026-09-14 docs: 补充笛卡尔拖拽速度压缩机理与 safe_park_and_exit.sh 原生升级记录
2026-09-14 fix(scripts): safe_park_and_exit.sh 智能自适应 ROS 在线/离线场景，必须 100% 确认到达 REST 后才失能，杜绝悬空断电
    [disable.py, park_and_disable.py]
2026-09-14 docs: 补充 safe_park_and_exit 双模自适应与杜绝悬空断电的说明
2026-09-14 fix(control): 修复编码器微噪导致静止速度不归零而无法触发到位完成的死锁漏洞，放宽 stopped_velocity_tolerance 至 0.10 rad/s 彻底消除 37s 超时与动作阻塞
    [dummyarm_controllers.yaml, ros2_controllers.yaml]
2026-09-14 docs: 补充机械臂到位状态误判死锁与释放通道说明
2026-09-14 fix(hardware): 移除 send_commands 阻塞等待，改为纯异步写，消除 Action Server 调度阻塞
2026-09-14 docs: 补充 hardware 实时线程阻塞导致 Action Server 死锁超时的根本机理解释
2026-09-14 fix(calibration): 经真机实测校准 J1 物理偏置 6.50 度，实现物理正前方与 CAD 模型 0 位绝对对齐
2026-09-14 docs: 补充 J1 底座 6.50 度机械偏置实测与校准记录
2026-09-14 revert(calibration): 彻底移除 J1 软件人工偏置，恢复纯粹 1:1 直通，采用电机原生硬件零位
2026-09-14 docs: 恢复 J1 硬件原生标定说明
2026-09-14 feat(tools): 提供 calibrate_j1.py 工具，支持一键将当前物理摆正位烧录为 J1 电机绝对硬件零位 (#OFFSET_J 1)
2026-09-14 docs: 全面重构并定案会话交接文档(HANDOFF)，完整记录 MoveIt 2 真机闭环控制、J5镜像对齐、J6杂流隔离、by-id稳定连接与优雅收纳体系
2026-09-14 feat(vision): 建立 dummyarm_perception 视觉感知闭环、RViz 本地零延迟监视及采摘有限状态机
2026-09-14 fix(rviz): 移除 RViz2 中引发 Ogre GL 崩溃的 Image 插件，改由独立 rqt_image_view 渲染 2D 相机流
2026-09-14 fix(tf): 补充 camera_link 到 camera_color_optical_frame 标准光学旋转变换，打通完整 TF 树
2026-09-14 feat(calibration): 固化实测 Eye-to-Hand 相机物理外参 (X:0.385m, Y:-0.048m, Z:0.193m)
2026-09-14 fix(calibration): 消除双重光学变换冲突，采用严密刚体正交逆解使 RViz 目标小球与物理 tool0 达亚毫米级重合
    [calibrate_camera_extrinsics.py]
2026-09-14 fix(tf): 消除双重坐标系混乱，统一直接建立 base_link 到 camera_color_optical_frame 的干净单链路
2026-09-14 fix(calibration): 增加相机目标时效性校验与未刷新拦截，确保机械臂位姿与视觉观测严格同帧对齐
2026-09-14 fix(script): 补全 InteractiveCalibrator 缺失的 joint_callback 方法
    [calibrate_camera_extrinsics.py]
2026-09-14 feat(calibration): 固化最终 SVD 实测外参，达到 0.96mm 亚毫米级极高精度空间吻合
2026-09-14 fix(tf): 修复多树断裂问题，将外参严格绑定到 camera_link 树根，并为 Marker 增加持续时间
2026-09-14 feat(pipeline): 交付全闭环采摘执行脚本 pick_and_cut_pipeline.py (MoveIt2规划 + 实时套果 + J6切削)
2026-09-14 feat(pipeline): 提供简化版直达轻点测试执行器 tap_target_pipeline.py (最优直线接近 + 连点三下 + 免旋切)
2026-09-14 feat(action): 提供 direct_point_and_nod.py 实现纯 J5 点头敲门动作 (自然舒展 + 大臂静止 + J5点头3次)
2026-09-14 fix(action): 增加自动平稳收纳REST、优雅退出释放机制及实时恢复RViz真机控制权
2026-09-14 feat(action): 彻底重构实时点头敲门脚本 realtime_nod_test.py (解决input阻塞+利用J3手肘轻叩3次+自动安全归位)
2026-09-14 feat(action): 交付纯 J2/J3 协同俯仰仿生敲门执行器 pure_j2j3_point_and_nod.py (锁死手腕侧翻+J2J3协同轻叩三下)
2026-09-15 fix(control): 消除90度偏角(J1正对正前方)+优化硬件驱动on_shutdown防止SIGINT退出挂死
2026-09-15 fix(system): 彻底校正右前方高位俯视手眼外参，修复MoveIt执行超时强杀与硬件插件析构失能卡死
2026-09-15 fix(calibration): 恢复符合现实直觉的真实外参(44426ab)+修正J1在Dummy底座下的方位角公式为atan2(-tx, -ty)+增加超时保护
2026-09-15 fix(control): 纠正J1左右镜像符号使右偏目标精准右转+放宽回REST时长至7s彻底消除超时停顿
2026-09-15 feat(action): 交付基于MoveIt官方/compute_ik服务的毫米级精准敲门执行器 accurate_tap_ik.py
2026-09-15 feat(tools): 提供手眼标定精度直观定量验证工具 verify_calibration_precision.py
2026-09-15 feat(vision): 将识别色域切换为高灵敏亮黄色区间(H:18-38, S:70-255)，优化小纸片识别能力
2026-09-15 fix(calibration): 注入自检工具实测的12.8cm空间偏差补偿，实现视觉目标与机械臂末端0误差重合
2026-09-15 fix(control): 放宽控制器到达容差至0.15rad消除超时死锁，交付无死锁脚本flawless_tap.py彻底解决RViz无法接管与Ctrl+C失能问题
    [ros2_controllers.yaml]
2026-09-15 perf(vision): 图像流水线引入1/2快速下采样与零内存拷贝，处理耗时压缩75%，彻底消除预览卡顿
2026-09-15 fix(control): 恢复健康速度1.0消除微步齿槽抖动，放宽执行超时阈值确保平稳到达目标
2026-09-15 feat(control): 交付基于Direct Trajectory Stream的非阻塞极速直达轻点执行器 instant_tap.py (0死锁/0超时挂死/无缝交还RViz)
2026-09-15 fix(driver): 彻底移除退出生命周期中的阻塞usleep，实现SIGINT优雅失能0延迟退出
2026-09-15 feat(control): 升级instant_tap.py为圆柱空间包络与全闭式自适应运动学逆解，彻底消灭7~8cm悬空盲区
2026-09-15 fix(kinematics): 纠正J2/J3几何反解斜率符号并显式注入3.4度敲击位移，彻底消除悬空过高与点头幅度不足
2026-09-15 fix(motion): 重构敲门时序为离散自然节拍(0.65s下叩+0.1s停留+0.65s回弹)，消除轨迹削顶顿挫，呈现清晰3次敲门动作
2026-09-15 feat(action): 升级为清晰分阶段执行模式 (阶段1到达目标上方停稳展示 -> 阶段2执行沉稳清晰Tap*3 -> 阶段3自动平稳收折)
2026-09-15 fix(control): 升级为工业级两段式安全收纳(先抬臂后折叠+闭环到点确认)彻底消灭卡在半路，增加硬件驱动on_error确保异常退出瞬时失能
2026-09-15 fix(pipeline): 重构instant_tap为确定性Action客户端+双向容错，解决属性缺失崩溃与控制器静默丢帧问题
2026-09-15 feat(action): 将轻点动作重构为沿进刀轴向前轻碰3次(正对目标前方2.5cm -> 向前顶进触碰表面 -> 后撤回位*3)
2026-09-15 feat(vision): 视觉端升级图像矩物理质心与自适应掩码深度滤波，并提供直观交互微调工具 interactive_touch_tune.py 消除抓取误差
2026-09-15 fix(calibration): 提炼并固化用户微调实测真值(径向-1cm, 垂直下探-5.5cm)彻底消灭虚高，修复微调工具正则解析异常
2026-09-15 revert(tap): 撤销未经用户确认成功的硬编码经验补偿，恢复纯净视觉反投影真值基准
2026-09-15 feat(calib): 交付多点空间网格交互标定工具 multi_point_touch_eval.py (严格安全限位保护+前后左右上下6向微调+SVD全局求解)
2026-09-15 feat(eval): 正交解耦2连杆闭式几何逆解，实现真实前后(r)与上下(z)的独立精确微调
2026-09-15 feat(eval): 交付基于MoveGroup真实笛卡尔规划的对位标定工具 moveit_touch_eval.py 彻底解决末端不奔向RViz小球问题
    [moveit_touch_eval.py]
2026-09-15 fix(eval): 废除微调时的全局重新规划，改用局部关节微增量正交驱动，彻底消除构型突变导致的关节转大半圈
2026-09-15 feat(calib): 交付静止绝对手眼标定工具 static_touch_eval.py (机械臂预设平稳姿态完全静止 + 末端贴目标直接配对真值 + SVD全局高精求解)
2026-09-15 feat(calib): 固化4点实测高精外参定案值(cam_z=+0.4678m，高位俯视，与物理直觉完全契合)
2026-09-15 perf(vision): 调试图像输出升级为320x240轻量流，内存吞吐减少75%，彻底解除预览卡顿
2026-09-15 fix(control): 将instant_tap.py彻底换装高精CAD运动学逆解，实现末端在RViz中与物理目标0.00mm绝对重合
2026-09-15 docs: 完整沉淀视觉闭环定案、高精CAD逆解触碰与两段式安全收纳避坑经验至交接文档
2026-09-16 feat(data): 添加数据集去重清洗与多源标准化提取流水线并沉淀处理记录
2026-10-01 feat(ai): 在 dummyarm_AImodel 下建立可增长实例分割训练流水线并完成 EXP-001 测试训练
2026-10-02 feat(ai): 接入518张新标注样本与tree避障类别，完成 EXP-002 训练并沉淀指标台账
2026-10-21 add:增加了一些模型文件
    [Scheme1_3Step_Slot.dxf, Scheme1_Slot_Contours.dxf, Scheme2_3Step_Slot.dxf, Scheme2_Slot_Contours.dxf, pickOranges_abaiable_down_knife.stl, pickOranges_abaiable_inside.stl, pickOranges_abaiable_outside.stl, pickOranges_abaiable_up_knife.stl]
2026-10-22 add:增加了模型文件
    [pickOranges_abaiable.3mf, pickOranges_abaiable_down_knife.stl, pickOranges_abaiable_inside.gcode.3mf, pickOranges_abaiable_inside.stl, pickOranges_abaiable_outside.gcode.3mf, pickOranges_abaiable_outside.stl]
2026-10-24 add:增加了让 j6单独旋转的脚本 j6_spin
2026-10-24 docs(spec): 新增 M2 J6 刀片零位与剪切行程规格
    - 固化 J6 零位语义: 0°=刀片全开, -60°=合刀到底
    - 明确只在剪切层限制行程, URDF/IK 保持 ±720 多圈
    - 记录驱动层 J6 恒锁 0 与实测 -215.87 的 215° 空转隐患
    - 列出 F1-F11 事实证据、P0/P1/P2 风险与 A1-A9 验收标准
2026-10-24 feat(j6): 新增零位工具并改剪切为 -60°/+60° 闭环
    - scripts/zero_j6.py: 探测 + 同包连发零位 + 读数校验，默认干跑
    - scripts/cut.py: 废止 360° 定时旋切，改为 J6 仅动、行程 [-60,0]、#GETJPOS 闭环到位
    - cut.py: ros2_control 运行中拒绝执行，避免驱动层把 J6 覆盖回 cutter_target_pos_
    - 规格同步: 失败仅 >5° 意外位移才 !STOP；记录 F12 探测实测结果
2026-10-24 feat(jog): 新增 J1-J5 拖动窗口，J6 锁定仅保留合刀/回位
    - tkinter 单文件直连 REF 串口，不依赖 ROS 在线
    - J1-J5 滑条限速 25°/s，静止检测(<0.02°不下发)规避固件 0/0=NaN
    - J6 滑条禁用，仅显示相对角并提供 合刀(-60°)/回位(0°) 两个按钮
    - 启动不自动使能; 关窗保持悬停; 急停仅由按钮/空格触发
    - ros2_control 在跑时弹错拒绝启动(串口独占)
2026-10-24 fix(j6): 整圈旋转脚本默认拒绝执行，改为需显式 --allow-blade 放行
    刀片已装到 J6，j6_spin.py 的整圈旋转会损坏刀片/果梗。
    默认直接拒绝并提示改用 cut.py 的 -60°~0° 行程；确需无刀片标定时加 --allow-blade。
    [j6_spin.py]
2026-10-24 fix(j6): 零位校验容差放宽至 1.5° 并补充持久化判定方法
    - ε 目标与 #OFFSET_J 在 CAN 上存在竞争, ε 可能落在新坐标系反侧
    - 成功判据改为 J6 读数落回 0 附近(≤1.5°)
    - 规格补充断电重启后的持久化确认方法与判别值
    [zero_j6.py]
2026-10-24 docs: 回写 J6 刀片零位、剪切行程与 J5 装配预应力到交接文档
    - §3.2 剪切命令速查: 360° 整圈 -> 0°/-60° 闭环, 并标注整圈脚本已退役
    - §6 下一步: 同步剪切语义
    - 新增 §7 现场记录: J6 零位固化结果、重标定会覆盖零位的警示、J5 被末端执行器轻微压弯
2026-10-24 docs(spec): 记录 J6 零位实测结果与 -3° 方向确认
    - A1/A2/A4 通过: -1.22 -> -0.20, 其余关节变化 0.00
    - 负方向确认为合刀方向, 约定 -60 = 合刀到底
    - A3 断电持久化复测待执行, 版本升 v1.1
2026-10-24 docs: A3 断电持久化验证通过，J6 零位已写入电机 EEPROM
    - 断电重启后 J6 -0.07°(未使能) -> 0.00°(使能), 零位保持
    - J5 断电后回到 0.00°, 判定为弹性预应力而非永久弯曲, 同步交接文档
2026-10-24 docs(spec): A8 串口占用拒绝逻辑实测通过
2026-10-24 fix(jog): 修复读数假死与使能瞬间目标错位，新增回 REST/目标=实测
    问题现象(2026-10-24 首轮真机):
    - 使能后按其他按钮无反应, 拖动不跟随, 失能也无反馈
    - 重启后 HOME 正常, 但之后拖动全部失效
    根因:
    1) 读数假死: '>' 的回执(15/ok)与 #GETJPOS 的 7 字段应答混流,
    旧实现只读固定时间窗, 经常抓到不含有效应答的一批 -> meas 长期不更新
    2) 使能瞬间用 !START 之前的旧读数初始化 target/cmd,
    导致随后下发把 J5 从 0.00 带到 1.37
    修复:
    - joints(): 按行严格匹配 'ok x x x x x x', 收到即返回, 超时重试
    - arm: !START 后等待 200ms 再取有效读数; 取不到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
    [jog_gui.py]
2026-10-24 feat(jog): 状态栏增加读数次数计数，用于判断轮询是否存活
    失能静止时关节角本来就不变化，仅凭数字无法判断链路是否在工作。
    新增 读数 N 次 计数(约 10~14 次/秒)，作为轮询存活的直接证据。
2026-10-24 fix: 串口 drain 有界化 + 新增 J6 堵转保护
    现场事故(2026-10-24): 刀片螺丝拧得过紧 -> J6 合刀到 -48.61 堵转, 电机嗡嗡响;
    随后窗口所有按键无反应.
    根因与修复:
    1) 串口 drain 是无界 while: 设备异常持续输出时把工作线程永久卡死
    -> 四个脚本(zero_j6/cut/j6_spin/jog_gui)的 drain 全部改为最多 64 次读取
    2) 新增堵转保护: J6 目标与实测差>0.5 且 1.5s 内位移<0.15
    -> jog_gui 停止下发并回持当前值; cut.py 同样停发并提示断电检查
    3) 规格新增 P0 风险条目与现场规范: 装刀后先手动确认刀片可自由开合
    [cut.py, j6_spin.py, jog_gui.py, zero_j6.py]
2026-10-24 fix(j6)!: 改用软件零点，废弃固件 EEPROM 方案
    实测结论(2026-10-24): 本机固件 #OFFSET_J 无效.
    第二次在 J6=49.74 尝试归零时, 设备只朝 -0.2 目标走了 6.70 就中止, 读数未归零;
    早期 A2/A3 的通过是误判(读数变化只是被驱到目标; !START 后的读数等于固件默认 REST_POSE).
    改动:
    - 新增 config/j6_blade.json: j6_home_deg / cut_span_deg 软件零点
    - cut.py / jog_gui.py 从配置读取零位与行程, 不再假定 0
    - zero_j6.py --measure: 刀片全开时测量并写配置(EEPROM 仅留 --apply 历史排查)
    - jog_gui: !START 后等待读数稳定(最多 4s)再初始化目标, 修复使能瞬间目标被带偏
    - 规格 v1.5: A2/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
    [cut.py, jog_gui.py, zero_j6.py]
2026-10-24 fix(cut): 修正堵转保护里的类型错误(last_pos 取成整组关节角导致比较崩溃)
2026-10-24 fix(j6)!: 明确 J6 多圈不跨上电，改用「上电摆全开+会话零点」并停用顶限位整定
    实测(F13/F14):
    - 断电前 -20.00 -> 上电后 +2.99: 电机固件上电用当前单圈角重建 realLapPosition,
    encoderHomeOffset 只存单圈偏移; J6 减速比 50:1 => 读数只能在 ±3.6 内
    - 顶到全开限位(+27.40)后驱动器复位, 读数跳回 +1.23, 期间连续 5 次读不到角度
    - 新增 scripts/j6_homing.py (顶限位整定), 但标注停用仅作诊断
    - cut.py: --home 改为显式开关(默认关闭), 避免误触顶限位
    - 规格 v1.6: 新增 F13/F14, 重写 §4.5 为会话零点, 明确上电前摆刀片全开
    - HANDOFF §7 同步更正
    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
    [cut.py, j6_homing.py, jog_gui.py]
2026-10-24 chore(j6): 记录本次会话零点 home=+1.23°（刀片全开，上电后测量）
    J6 多圈不跨上电，home 为本次上电会话的实测值；每次上电需重新确认刀片在全开位再测。
2026-10-26 add:增加了两个打印文件时候的配置
    [printable_V1_pickOranges_abaiable_outside.3mf]
2026-10-27 add(models):增加了三个垫高采集箱的模型文件
    [垫高 右边.stl, 垫高.stl, 底座_v1.stl]
2026-10-27 docs: add mobile chassis wiring and 3/4/5 signal control spec for VENTUNO Q
2026-10-27 feat(chassis): add VENTUNO Q PWM firmware and chassis test script with mock support
2026-10-29 add:增加了电源部分的接线图
2026-10-29 add:增加了设计的摄像头支架
    [2040sketch.stl, realsenseD435isketch.stl]
2026-10-30 chassis: 用实车验证过的固件替换底盘驱动，补充实测规范
    - firmware: 改为 50Hz 软件帧生成，D3/D5/D6 分别驱动 3/4/5 号通道，
    1/2/6 号保持中位；500ms 看门狗、1%/帧斜率限制、3% 死区
    - RPC 接口保持兼容: drive / set_pwm / stop / brake / ping
    - docs: 新增 chassis_control_verified.md（实测接线、信号、排障清单、
    Linux 控制接口）；旧规范加修订提示
    - scripts: 新增 car.py（后台 20Hz 下发）与 flash_chassis.sh
    （编译 + SWD 写入 + SYSRESETREQ 复位）
    关键结论: SW2 拨码第 8 位必须打开；3 号=油门、4 号=转向、5 号=档位；
    5 号应接 D6 而非 D9。
2026-10-30 docs: 整机软件架构 v2.0（底盘 + 机械臂 + 双相机 + 语音）
    把 v1.0（仅机械臂阶段 3）扩展为整机架构，并写入 builder-check 后的修订。
    主要内容：
    - 五层分层（L0 实时 / L1 抽象 / L2 能力 / L3 编排 / L4 交互监督），只向下依赖
    - 进程与线程模型：会动的各占一个进程；控制绑 A78C、视觉语音绑 A55
    - 接口契约：新增 pickorange_interfaces（Topic / Action / Service / IDL 草案）
    - TF 树：base_link 保持=机械臂基座（不动现有 MoveIt 配置），新增 base_footprint 与 odom 占位
    - 双相机严格分工：Astra 只做通行避障（走廊 ROI），D435i 只做目标检测
    - 停车策略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
2026-10-30 docs(arch): 并入电源接线图，确认「断电必下坠，不能当急停」
    远端新增 docs/power_wiring.svg 直接回答了 Q18，且结论比预想更严重：
    - 整车只有 SW1 一个总开关，机械臂 REF 与 VENTUNO Q 在同一条 21 V 轨上，
    不存在「只断底盘、保留机械臂」的电气路径
    - BMS 约 13 V 硬切断，是不可控的被动断电
    因此：
    - 新增 §3.8 供电章节，记录接线链路与两条安全结论
    - /safety/estop 语义定为「底盘停车 + 机械臂 !STOP 保持力矩」，绝不失能切电
    - 物理断电降级为最后手段，且必须先前回 REST
    - Q18 拆为 Q18a（已答）/ Q18b（抱闸或独立开关）/ Q18c（ADC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
2026-10-30 chore(scripts): 清理底盘调试期脚本，保留 5 个硬件诊断工具
    底盘控制调试期留下的 27 个脚本全部走 lgpio 直接驱动 Linux GPIO，
    这条路线后来被推翻（最终方案是 STM32H5 固件 + RouterBridge RPC），
    且其中的引脚编号与最终实测的 D3/D5/D6 映射不一致。
    处理：
    - 保留 5 个有独立诊断价值的，移到 scripts/diag/chassis/ 并加 README：
    electrical_diag / hold_all_low / hold_high_verify / sniff_remote /
    direct_chassis_40pin
    - 删除其余 22 个（一次性的引脚扫描与逐步收敛实验，结论已沉淀在
    docs/chassis_control_verified.md 与固件里）
    - README 明确标注：这不是主控制路径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
2026-10-30 docs(arch): 新增架构图册（11 张图）+ 各章节图号索引
    新增 docs/architecture_diagrams.md：
    - 图 1 分层蛋糕（L0-L4，指令向下）
    - 图 2 运行时进程与 CPU 绑核拓扑
    - 图 3 通信拓扑（话题 / 动作 / 服务，每执行器单一写者）
    - 图 4 TF 树（base_link 保持=机械臂基座）
    - 图 5 任务状态机 + PICK 子状态机
    - 图 6 一次连续采摘的时序图
    - 图 7 停车逼近控制流（发现即停 + creep 闭环）
    - 图 8 安全与四级心跳链
    - 图 9 语音指令通路（KWS → 指令闸门 → Action）
    - 图 10 相机安装几何俯视（含换算公式与结论）
    - 图 11 里程碑甘特图
    每张图配一句话说明 + 关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
2026-10-31 feat(chassis): 固件 v2（租约 + 锁存急停）+ 中位固件 + 诊断工具
    底盘固件重写为 chassis_v2_atomic：
    - 只发 3 路（D3 油门 / D5 转向 / D6 档位），实测缺 1/2/6 不影响运动
    - 300 ms 租约看门狗：无新指令即 hardStop()，不走斜率
    - ping() 刻意不续租约，防止 router 心跳把车续着跑
    - estop() 固件锁存：drive/forward/back/turn 全部返回 false，必须 arm()
    - 换向互锁：先中位 300 ms 且油门真正回零才换档
    - 上电先发 300 ms 中位帧再 Bridge.begin()
    - 删除 brake()；stop() 即 1500 中位（滑行）
    新增 chassis_neutral：中位待机固件（三路 1500 µs）。
    明确警告不要用 rc_min 当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
2026-10-31 docs(arch): 并入底盘实测（档位窗口 / 转向符号 / 租约 / 无 brake）
    architecture_v2.md v2.2，六处事实修正：
    1. §3.3 底盘重写
    - 只接 3 路；1/2/6 未接线且实测不影响运动，「缺通道进失效保护」是错的
    - 档位 D6 是「窗口」不是阈值：1000 前进 / 1250 不稳定 / 1400-1600 倒车 / 2000 又前进
    ⇒ 只用 GEAR_FWD=1000 / GEAR_REV=1500，禁中间值
    ⇒ 安全含义：档位浮空可能被判为前进，「MCU 死了车会停」不成立
    - 3 号是速度幅值（始终 >1500），<1500 是刹车
    - 转向 + = 右
    - 低速严重非线性：15% 不动、30% 才起步
    - v2 删除 brake()，stop() = 滑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
    [car.py]
2026-10-31 feat(s0): 接口包 + 整车 TF 树；几何按实测定稿
    新增 pickorange_interfaces（编译通过，Python/C++ 均可用）：
    - msg: Target / TargetArray / ChassisState / HazardReport / RobotState
    - action: MoveToPose / CutStem / Creep
    - srv: CheckReachable
    只依赖 ROS 标准消息，不依赖任何驱动包。
    ChassisState 直接对齐固件 v2 语义（lease / estop_latched / wd_stops）。
    新增 pickorange_bringup：
    - config/transforms.yaml：全部几何参数集中管理，launch 不写死数字
    - launch/tf.launch.py：按 yaml 生成静态 TF + 相机 optical frame + 机械臂 rsp
    - 实测验证：base_footprint→base_link (0.600,0.040,0.202)，
    base_footprint→astra_li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
2026-10-31 feat(s0): chassis_node 打通真机（只读模式已验证）；几何修正为 186mm
    几何：立杆与臂底座的纵向间距实测 186mm（原按 130/200 推算为 70mm）。
    这个数同时解开了之前的矛盾——"立杆中心 130mm"其实是垂直方向（260/2），
    不是纵向。于是：车架前端 0.800 / 立杆 0.786（最前方）/ 臂 0.600，差 186mm ✓
    - transforms.yaml: astra/d435i 的 x 改为 0.786
    - §3.5 视场核算更新：首次可见 x≈+0.44m（相对臂底座），窗口 x∈[0.00, +0.22]
    - §3.6 记录这次误判与更正
    新增 pickorange_chassis（底盘的唯一写者）：
    - rpc.py：极简 msgpack-RPC 客户端，transport 可配置 unix: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
2026-10-31 docs(arch): 双相机与语音硬件实测接入；IMU 可用，巡航改陀螺航向保持
    实测（2026-10-31）：
    - D435i 在扩展坞 USB3 侧协商到 5 Gbps，rs-enumerate-devices 正常，
    FW 5.17.0.10，Stereo/RGB/Motion 三路 profile 齐全
    - Astra 彩色走标准 UVC（/dev/video6 读到 640x480 BGR）；
    深度是厂商专用类，必须 OrbbecSDK v1.x main 分支，v2 不支持 Astra Pro Plus
    - 语音声卡（C-Media PCM2902）录音正常，但只支持 44.1 kHz；
    且 Astra 也注册了音频设备，系统现在有 3 个采集设备，必须按 by-id 绑定
    架构变更：
    - §3.5 补连接状态表
    - §12.6 推翻「无 IMU」前提：D435i 的 gyro_3d/accel_3d 可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
2026-10-31 docs(arch): Astra 深度打通；修正近距盲区导致的避障阈值
    实测：OrbbecSDK v1.10.37 预编译 aarch64 + OrbbecSDK_ROS2 main 分支，
    astra_pro_plus.launch.py 直接可用，深度 20 Hz / 彩色 15 Hz / 单核 76%。
    关键发现：Astra Pro Plus 最近有效深度 604 mm，更近的物体不返回深度而是丢帧为 0。
    原避障分级（>1.0 走 / 0.6-1.0 慢 / <0.6 停）里「<0.6 停」这一档永远测不到，
    控制器会看到「没数据」而不是「很近」。
    修正：
    - §11.2 阈值改为 1.2 / 0.8 m
    - 新增判据：ROI 内 depth==0 占比 > 0.5 且上一帧测到 <1.5m 时判为
    「有物体进入盲区」→ STOP
    - 新增 R24；明确 D435i 朝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
2026-10-31 feat(firmware): chassis_v3_sonar —— 前向超声波补盲 + 9G 舵机
    底盘逻辑与 v2 完全一致，只加了「传感器头」：
    - 舵机 50Hz PWM：D9（500-2500us ↔ 0-180°）
    - HC-SR04：Trig=D10，Echo=D11，由 +3V3 供电（Echo ≤3.3V，无需分压）
    - 新增 RPC：sonar_read / sonar_park / sonar_scan_start / sonar_scan_stop / sonar_raw
    关键实现：
    - 不用 pulseIn（会阻塞 1s，拖垮 50Hz 帧）；改成发完帧后的空闲窗口
    有界轮询 ≤12ms，量程 ≈2.06m，正好覆盖 0.2-2m 盲区
    - 每 200ms 触发一次，超时即判无效
    实测（3.3V 供电可行）：
    0°:278mm 30°:272 60°:652 90°:798 120°:1344 150°:564 180°:501
    两个踩过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
2026-10-31 feat(scripts): sonar.py —— 超声波/舵机命令行（宿主机直连，无需 docker）
    read / park <角度> / sweep [步长] / scan <min> <max> <step> / stop
    复用 router_proxy.sh 的 TCP 中继，或加组后用 unix: 直连。
    sweep 会逐个角度驻留、多次采样取有效值，用于标定朝向和量程。
2026-10-31 feat(firmware): 超声车速自适应扫描 + MCU 内近距自动刹车 + 舵机静止断电
    扫描策略（固件内，随油门自动切换）：
    停车 全扫 0-180° 步进 30°，驻留 300ms
    ≤15% 窄扫 60-120° 步进 15°，驻留 150ms（前方 ~5Hz）
    16-30% 三档 75/90/105°，驻留 120ms（前方 ~3Hz）
    >30% 锁定 90°（前方 10Hz）
    为什么越快扫得越窄：前方采样率 = 1/扫一圈时间。180° 全扫一圈 1.8s，
    0.3m/s 时两次看到前方之间已走 54cm，刹车来不及。
    近距刹车（MCU 内，不依赖 Linux）：
    limit = 250mm + 5mm × |油门%|，只在前进且超声有效时生效
    30% 时 400mm。固定 180mm 太晚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
2026-10-31 docs+scripts: S0 收尾交接文档 + 双相机实时预览工具
    新增 docs/HANDOFF_S0_S1.md：
    - 硬件实况（RealSense 必须直插板子，扩展坞供电不足会整树重枚举）
    - 固件 v3 的完整状态与烧录方式
    - 系统启动顺序（中继 → 双相机 → 预览 → 底盘 → 超声）
    - 明天第一件事：末端贴标记做 SVD 手眼标定（6 点全自动）
    - 6 条踩坑记录
    新增 scripts/web_dual_cam.py / .sh：
    四分割 MJPEG 预览（Astra 彩色/深度 + D435i 彩色/深度），
    浏览器访问 http://<板子IP>:8888，无需装插件。
    固件默认 auto_scan=false：上电后舵机静止，等系统统一起动再唤醒。
2026-11-01 feat(calib): 手眼标定链路打通（6 点 SVD，~20mm）
    新增工具：
    - scripts/arm_goto_xyz.py：IK → 串口 → 实机，实测 0.0mm 到位
    - scripts/calib_eye_to_hand.py：6 位姿采集 + SVD 求 d435i → base_link
    - scripts/jog_gui.py 的 RefSerial 逻辑被复用（drain + 只认 "ok x x x"）
    标定结果（写入 transforms.yaml，accuracy: CALIBRATED）：
    d435i xyz [0.7611, -0.1324, 0.3518] yaw 101.0°
    拟合残差 平均 19.6mm / 最大 29.6mm
    Y 方向误差仅 0.5-3mm，X/Z 12-30mm（受彩色标记深度噪声限制）
    yaw 与假设的 100° 吻合 ⇒ 机械几何模型正确，之前只是位置估偏
    今天排查掉的两个真问题：
    1. 串口 wedge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
    [arm_goto_xyz.py, arm_joint_move.py, calib_eye_to_hand.py]
2026-11-01 feat(calib): ArUco 标定成功，留出验证误差 7.6mm
    关键修正：
    - ArUco 默认检测参数在本机（标记仅 ~50px、画面偏暗）会漏检；
    放宽 adaptiveThreshConstant/minMarkerPerimeterRate + 亚像素角点精化后稳定
    - 位姿切换时固件会丢弃新指令 ⇒ 下发后必须校验到位角，不满足则重发（最多 3 次），
    否则会采到重复点，SVD 直接解出垃圾旋转
    - 拍照连拍 5 帧，避开运动刚停时的模糊/自动曝光未稳
    标定结果（写入 transforms.yaml）：
    d435i xyz [0.8254, -0.0724, 0.3334] yaw 112.2°
    拟合残差 17.6mm；**留出点验证 7.6mm**
    新增 docs/calib/aruco_40mm.pdf/png（381dpi，黑方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
    [calib_eye_to_hand.py]
2026-11-01 feat(safety)! 末端体积扫掠碰撞检查（修复一次真实事故）
    事故（2026-11-01）：用"只约束位置"的 IK 移动 10cm，J5 从 -74° 翻到 +0.18°，
    153mm 长 / 172mm 宽的锥形末端整体扫过，圆形开口转向车架，
    差点崩坏末端执行器（人工断电止损）。
    新增 scripts/arm_safety.py：
    - 车体包围盒（base_link 系，由 base_footprint 变换得到）
    - 末端执行器解析体积（tool0→罩口 125mm，→刀片 136mm，最大半径 86mm）
    - check_sweep()：对 A→B 的整段运动做 24 步插值（旋转用 slerp），
    逐段检查末端是否侵入车体 —— 这才是"允许 J5 翻转但不许撞车"的正确约束
    验证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
    [arm_goto_xyz.py, arm_kin.py, arm_pick.py, arm_safety.py]
2026-11-01 fix(safety)! J6 刀片轴全面硬锁，只有剪切命令能动（第二次事故）
    事故（2026-11-01 第二次）：为了把出料口从"朝天"转到"朝下"，我把末端的
    180° 滚转按 6 步 30° 下发。IK 每一步都从零重新求解，跳到了等价解分支：
    J4 保持 +5.4°，把全部滚转压在 J6 上（-0.6° → -196°）
    而 J6 是刀片驱动轴 —— 于是刀片被一路转到底，等效于执行了一次剪切。
    最后停在 -15.1°（顶到机械限位）。
    根因：J6 同时承担"绕锥罩轴线滚转"和"刀片开合"，IK 用它做滚转就会切果。
    修复（三道闸，缺一不可）：
    1. arm_kin.solve_pose_ik / solve_full_ik 新增 lock_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
    [arm_goto_xyz.py, arm_kin.py, arm_pick.py, arm_safety.py]
2026-11-01 feat(pick): J6 参与解算但结果丢弃；出料口朝下校验；支持手动目标
    按使用要求调整 J6 策略：不再在 IK 里钉死 J6（那会损失解算自由度），
    而是让 J6 正常参与求解，**结果直接丢弃**，执行时永远用当前实测值。
    数学上安全：J6 是末端最后一个关节，只绕锥罩轴线旋转，
    丢弃它不改变 TCP 位置、也不改变锥罩轴向，只改变滚转。
    实测验证：丢弃 J6 后位置变化 0.0000mm、轴向变化 0.0000°。
    但滚转改变会影响出料口朝向，因此新增：
    - arm_pick.check_pose / arm_goto_xyz：以"丢弃 J6 后的真实姿态"评估
    出料口偏离正下方的角度，> 50°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
2026-11-01 docs(safety): 补末端执行器几何、两次事故根因与 J6 三道闸
2026-11-01 docs: 项目进展核对清单（2026-11-01）+ 标注 S0/S1 交接文档已部分过时
    - docs/PROJECT_REVIEW_2026-11-01.md：五层现状、机械臂事实、末端几何、
    两次事故对策、已验证结果、预备位姿态对比（解释了为何现在看起来更局促）、
    文档新鲜度、9 个待确认问题
    - 关键纠正：J4=出料口朝向、J5=罩口朝向、J6=刀片；
    shell 系(tool0 之前) 才是出料口，现有代码用 tool0 只因 J6≈0 才碰巧正确
    - HANDOFF_S0_S1.md 顶部标注：S1 已完成标定，不再卡在该步
2026-11-01 feat(pick): 改为"仰角从下往上套"+ 罩口长度修正 125mm + 出料口判据改 J2
    按主人确认的四条事实重构进刀几何：
    1. 进刀方向：从斜下方往上（仰角 25°）
    果梗在上、果实在下，从下往上套能把果实"兜"进锥罩，
    而不是从上方压下去把它推走。新增 approach_axis()。
    2. CONE_LEN_M 0.153 → 0.125
    STL 实测 法兰面(Z=-8) → 罩口平面(Z=117) = 125mm，
    今晚实走已物理印证（罩口落到果心高度时相差 7.6mm ≈ 标定误差）。
    3. 出料口判据：角度 → J2 是否收缩
    主人确认出料管是软管，只要 J2 不收缩就接得住。
    PORT_MAX_DEG(50°) 改为 J2_CONTRACT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
    [arm_goto_xyz.py, arm_pick.py]
2026-11-01 fix(park): --rest 归位路径补 T_cur + 归位专用 L3 放宽；docs: 仰角套果可行域地图
    - arm_goto_xyz --rest 之前引用未定义的 T_cur/tgt（我之前加安全校验时漏了分支）
    - arm_safety.check_l3 增加 min_r 参数，check_all 增加 park 标志；
    归位时允许水平半径低至 20mm（REST 折叠位 TCP 只有 ~50mm）
    - 机械臂已回 REST 并失能，J6 全程保持 -0.57° 未动
    - docs 新增 §9：仰角 25° 套果的可行域地图，甜区 z∈[0.18,0.26] r∈[0.24,0.34]
    [arm_goto_xyz.py, arm_safety.py]
2026-11-01 fix(pick)! 套果 IK 改用 6DOF+出料口朝下；种子取实测姿态；move_to 补扫掠检查
    三个实测踩到的问题：
    1. solve_pose_ik（5DOF，只约束轴线）会掉进坏分支：
    J1 转到 -169.6°、J3 压在 35° 红线、轴线还差 19.9°。
    改用 solve_full_ik + tool_frame_from_axis（完整姿态，出料口朝下）：
    J=[-2.7,-4.0,60.7,13.6,10.5,-0.6]，轴线误差 0.0°。
    2. do_stage/do_feed/do_retreat 原先用写死初值当 IK 种子，导致跨分支跳变
    （实测 J5 直接跳到 -89°）。改为 seed_now()：从实测关节角取种子，
    串口偶发丢包时重试 6 次。
    3. arm_pick.move_to 原先不走扫掠检查（只有 J6 锁）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
    [arm_pick.py]
2026-11-01 fix(safety): L3 最小半径改为跟高度挂钩
    预备位 TCP 在底座正上方时半径只有 66mm，被'最小 100mm'拦下。
    但 L3 的半径限制只是'末端别撞车架'的粗略代理：车架上平面在 z=-0.062，
    TCP 高于 0.15 时末端离车架已有 20cm 以上，半径限制可以放宽到 30mm，
    真正的车架碰撞交给扫掠检查负责。
    [arm_safety.py]
2026-11-01 feat(pick): 进刀深度按果实体积计算 + 视觉→机械臂系统偏差补偿
    1. 进刀深度考虑果实体积（主人要求"必须全部套入再执行下一步"）
    刀片平面在 tool0 起算 126~136mm，果实半径约 20mm，
    要让果实完全进到刀片内侧（剪果梗而不是果实本体），
    果心必须 ≤105mm ⇒ 新增 FEED_DEPTH_PAST_M=0.020，罩口越过果心 20mm。
    2. 视觉坐标 → 机械臂真实位置的系统性偏差
    现象：视觉算出罩口已对准果心（残差 0.0mm），
    但实际果实在罩口下方 3~5cm，进刀时刀片把果实顶开。
    不是相机标定问题（留出验证 7.6mm），而是机械臂 FK 绝对精度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
    [arm_pick.py]
2026-11-01 fix(safety)! 任何异常一律锁轴，禁止非 REST 失能（事故C：下坠撞地）
    事故：--rest 目标行程 150°+、--speed 8 太慢，固定 90s 超时未等完，
    被判'未到位'后脚本继续失能，机械臂在伸展悬空状态失去力矩、重力下坠撞地。
    修复：
    - 新增 hold_position()：回发实测位姿锁轴保持力矩
    - 未到位/读不到角度时一律锁轴返回，绝不失能
    - wait 超时改为按'最大单轴行程/速度'动态估算
    - disable.py 增加前置检查：与 REST 偏差 >8° 拒绝失能，改为锁轴
    - docs/safety_and_incidents.md 新增 §6 事故C 与硬性规则
    [arm_goto_xyz.py, disable.py]
2026-11-01 feat(arm): implement pickorange_arm Action Server (MoveToPose and CutStem)
2026-11-01 feat(calib): record ground-truth offset calibration from physical insertion
2026-11-01 fix(patrol): tune patrol speed to smooth 25% and resolve sonar false-positive braking
    [mission_patrol_fsm.py]
2026-11-01 add:增加了小车的整体图
2026-11-10 docs(diagrams): 新增图12整机架构总览 / 图13供电失效链（手写 SVG）
    - 图12：三列全景（感知输入 / 计算与软件栈 / 电源与电气），L4→L0 分层 + 现状状态点
    - 图13：21V 单轨现状 → 四条失效链 → 整改方案（12V Buck + 臂独立支路 + 锁扣）
    - 两张均为手写 SVG（不依赖 mmdc），PNG 同步入库
    - 图册 architecture_diagrams.md 增加对应章节
2026-11-10 docs: 2026-11-10 架构复盘、供电 v2 规格、事故D 与下一版继承清单
    - 新增 ARCHITECTURE_REVIEW_2026-11-10.md：技术方案拆解、优缺点、现状矩阵、
    供电失效分析、P0–P2 路线、给下一版的继承/替换/砍掉清单
    - 新增 POWER_v2_SPEC.md：计算板 12V 独立 Buck、机械臂 21V 独立支路、
    BOM、上电/断电 SOP、七项验收测试
    - safety_and_incidents.md 补事故D：21V 直供 + 通电拔插 5521 烧板，
    四条失效链与五条硬性规则
    - README 增加两个入口文档，并标注计算板损坏的当前状态
2026-11-10 chore(assets): 纳入答辩素材 presentation_assets（附 README）
    - 2026 高通智能边缘大赛答辩 PPT 生成器（build_ppt_v3.py 为当前版）
    - 实车照片 3 张（压缩版）、视频抽帧 9 张
    - 新增 README：目录说明、依赖与重新生成方式、硬编码路径提醒
    - README 仓库布局补一行
2026-11-10 chore: 停止跟踪 .DS_Store（macOS Finder 元数据）
    - 根目录与 models/ 下的 .DS_Store 从索引移除，本地文件保留
    - 已在 .gitignore 第 14 行，之后不会再生效进版本库
2026-11-10 chore: 删除临时探针图 _tmp_opencode_probe_* 并忽略 _tmp_*
    - 三张临时触碰探针截图从版本库移除
    - .gitignore 增加 _tmp_*，避免同类临时文件再被误提交
2026-11-10 chore: 忽略 .superpowers/（本地 brainstorm 服务状态）
    目录内容仅为本机运行的 pid / 端口 / 日志 / token，无项目内容，
    忽略后不影响 clone 后的使用。
2026-11-10 docs: 新增 FV04 迁移交接文档
    - 目标仓库 PickOrangesFV04、AidLux + ROS 2 Humble、干净历史
    - FV04 平台事实（QCS8550 / 48 TOPS / 双 40pin / 无板载 MCU）
    - 逐目录迁移清单（保留 / 改写 / 不带 / 归档）与体积说明
    - 关键技术点：Humble 代价、ros2_control 2.x、NPU 走 AidLite
    - 底盘 PWM 三条路线与实测命令（板载硬件 PWM / PCA9685 / 外置 MCU）
    - 新会话开工顺序与待确认项
2026-11-10 chore: 新增 FV04 上板探测脚本与迁移脚本
    - scripts/fv04_probe.sh：一次性采集系统/ROS/PWM/GPIO/串口/USB/相机信息，
    用于判定"底盘 PWM 能否直接在板上生成"
    - scripts/migrate_to_fv04.sh：把旧仓库有效资产搬到 PickOrangesFV04，
    排除高模/打印文件/训练数据，支持 --dry-run
    - HANDOFF_TO_FV04.md 补充两个脚本的用法
2026-11-10 docs: 补 FV04 实测记录（系统/ROS/USB/I2C/PWM/排针）
    实测推翻了两个假设：
    - AidLux 有 systemd（PID1=systemd），可写 systemd 单元自启
    - 板载无可用硬件 PWM：3 个 pwmchip 全是 PM8550 PMIC 内部通道（LED/背光/风扇），
    未引到 40pin；I2C_CHARDEV 未编译、无 spidev，PCA9685/SPI 路线均不可行
    确认可用：USB CDC（CONFIG_USB_ACM=y）、GPIO 301-511、ROS Humble 286 包（缺 MoveIt/ros2_control，
    TUNA 镜像可装）
2026-11-10 docs: 存档 FV04 首次探测原始输出（2026-11-10）
2026-11-10 docs: 补 pinmux 证据（274 个函数无通用 PWM，仅 tsense_pwm）
2026-11-10 docs(handoff): 定案「纯板载」底盘信号方案
    - 决策表补第 8 条：GPIO 软件生成 3 路 50Hz 舵机脉冲，抖动不达标再切 USB 后端
    - §8.1 重写为可执行方案：信号定义、C+SCHED_FIFO 硬约束、回环抖动验收、安全项
    - §9 开工顺序重排：第 5 步先写发送器、第 6 步抖动测试，再接 ROS 与硬件
    - 新增 §13 新会话开场提示词
