BohnChen/PickOrangeDummy/carPhotos/IMG_5588.JPG

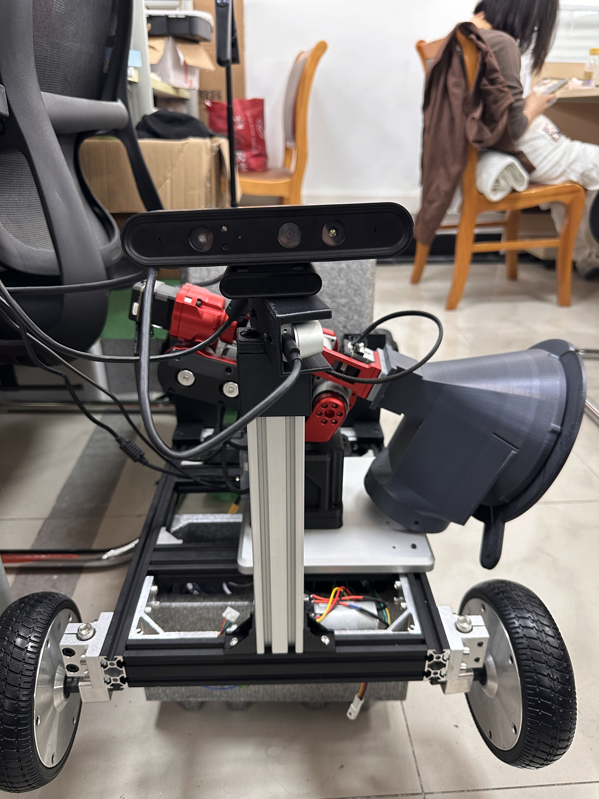
carPhotos/IMG_5588.JPG
