BohnChen/PickOrangeDummy/carPhotos/IMG_5589.JPG

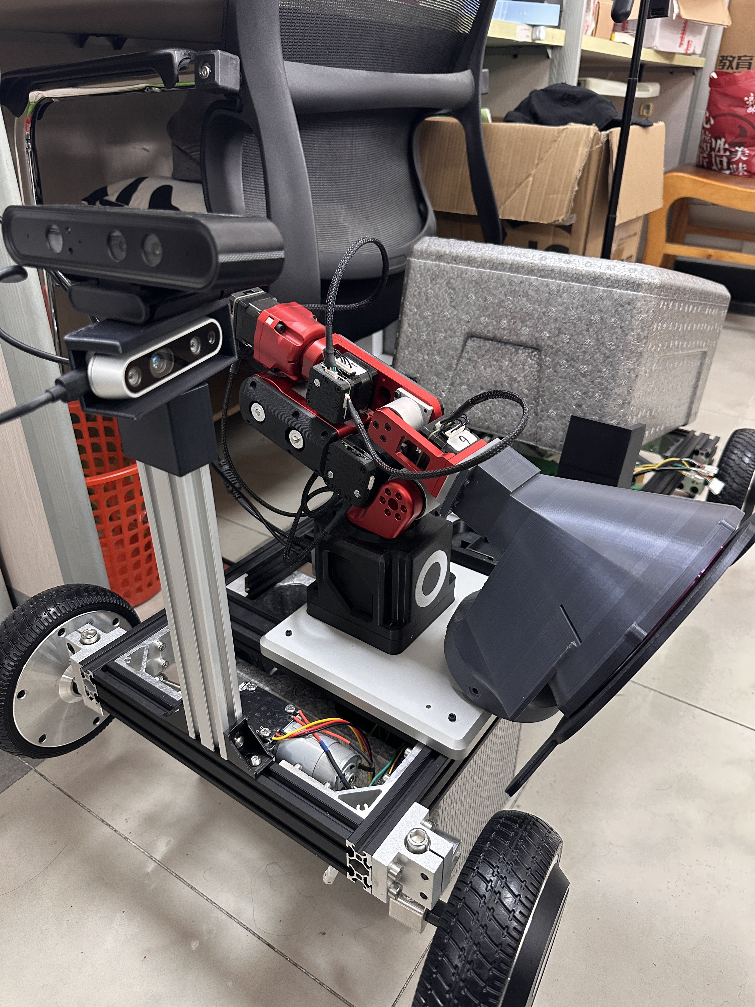
carPhotos/IMG_5589.JPG
