BohnChen/PickOrangeDummy/carPhotos/IMG_5590.JPG

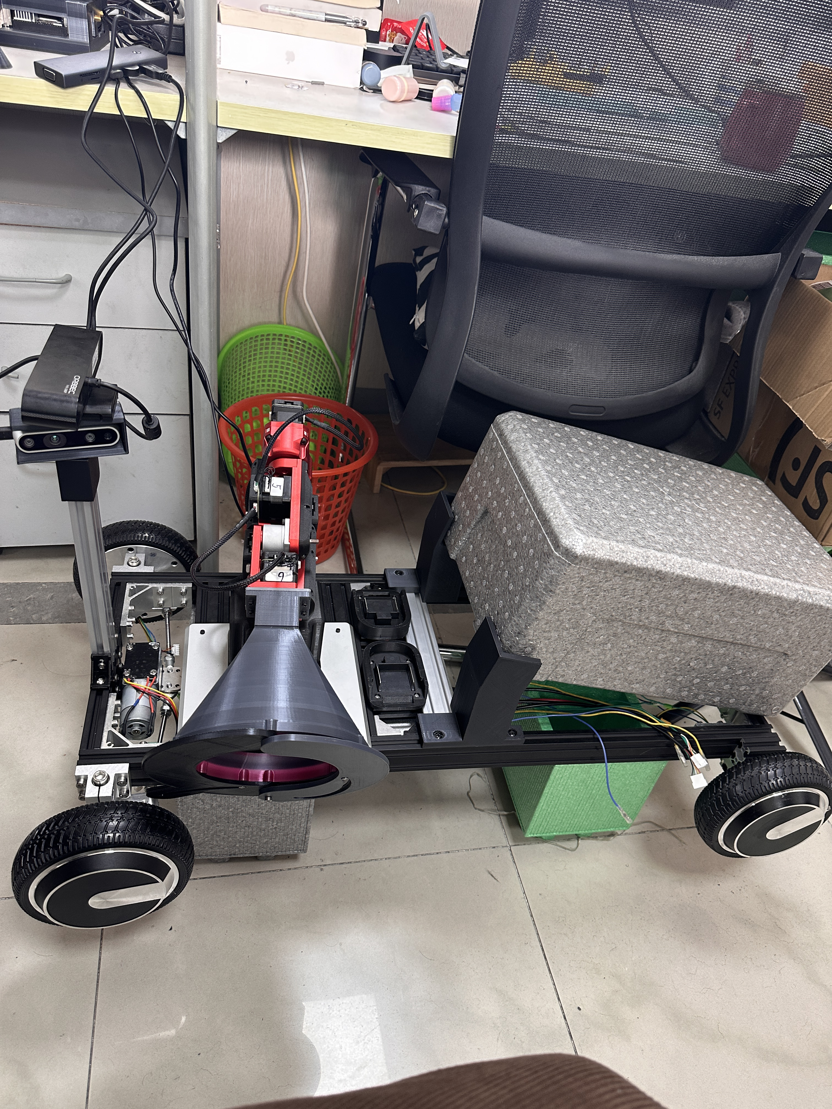
carPhotos/IMG_5590.JPG
